nhrc-net/NHRC_Repeater_Controllers/MASTR II/base station card/images/card-accessories.jpg

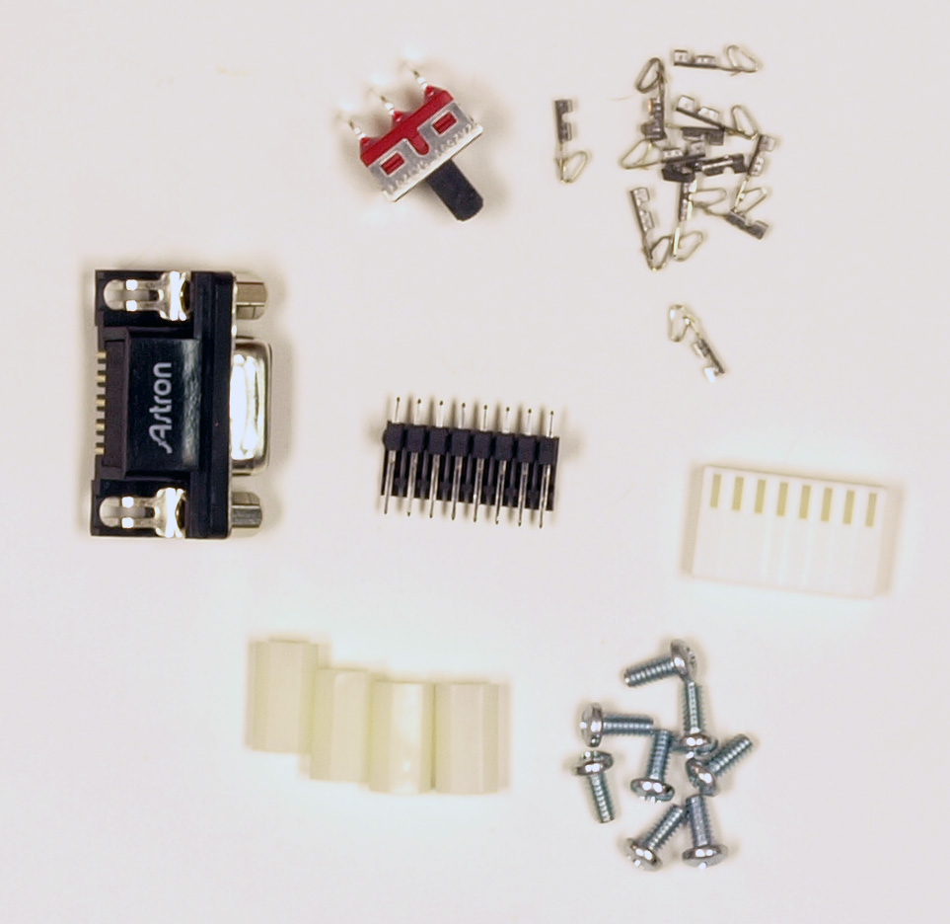
MASTR II/base station card/images/card-accessories.jpg
