nhrc-net/NHRC_Repeater_Controllers/nhrc-remote-plus/docs/pix/P7181789.JPG

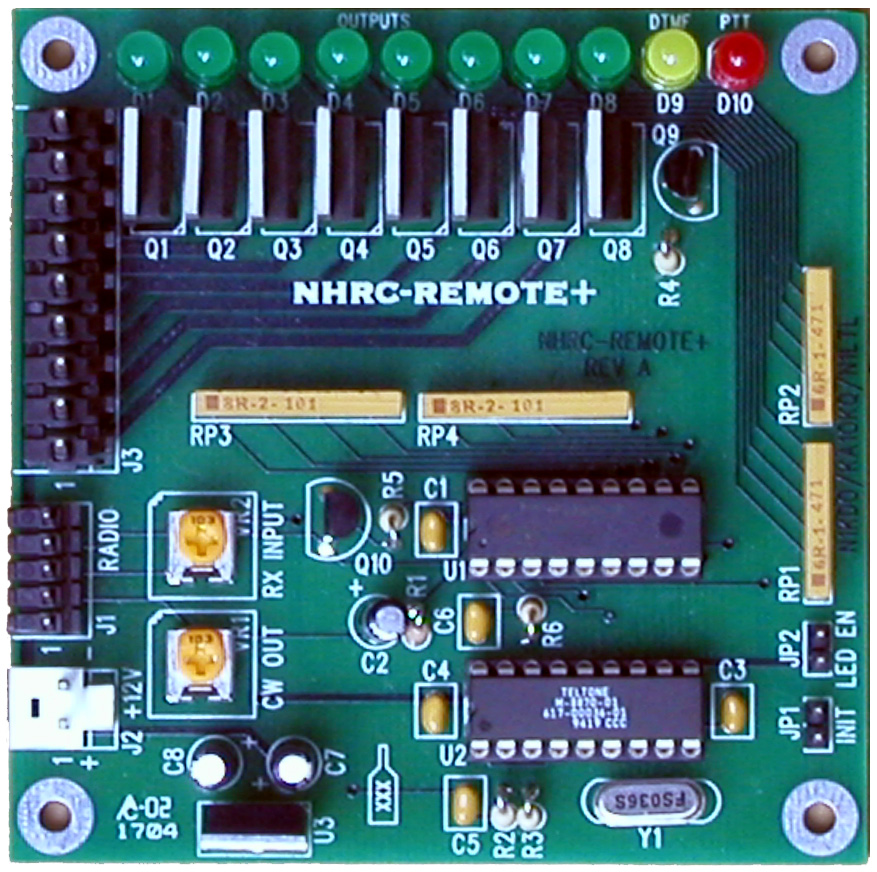
nhrc-remote-plus/docs/pix/P7181789.JPG
