nhrc-net/NHRC_Repeater_Controllers/0_copyright.md

# Copyright

Everything here is Copyright 2022 by NHRC LLC, Jeffrey Otterson, and 
Peter Gailunas.

All rights are reserved.  This material may not be used for any 
commercial purpose.
