nhrc-net/NHRC_Repeater_Controllers/MASTR II/base station card/images/card-bare.jpg

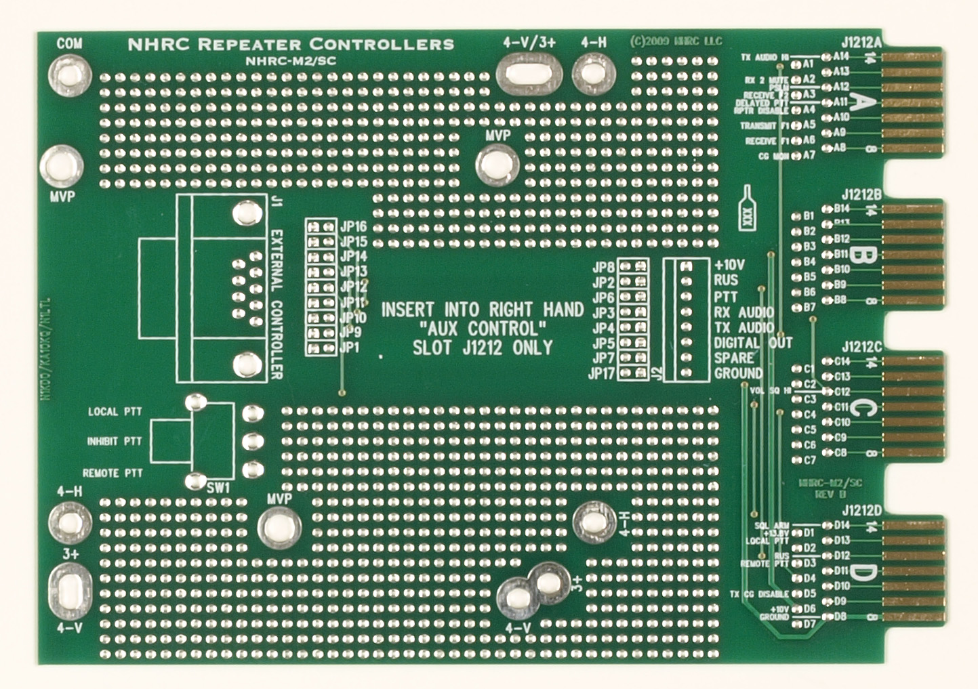
MASTR II/base station card/images/card-bare.jpg
