nhrc-net/NHRC_Repeater_Controllers/MASTR II/base station card/images/card-external-jack.jpg

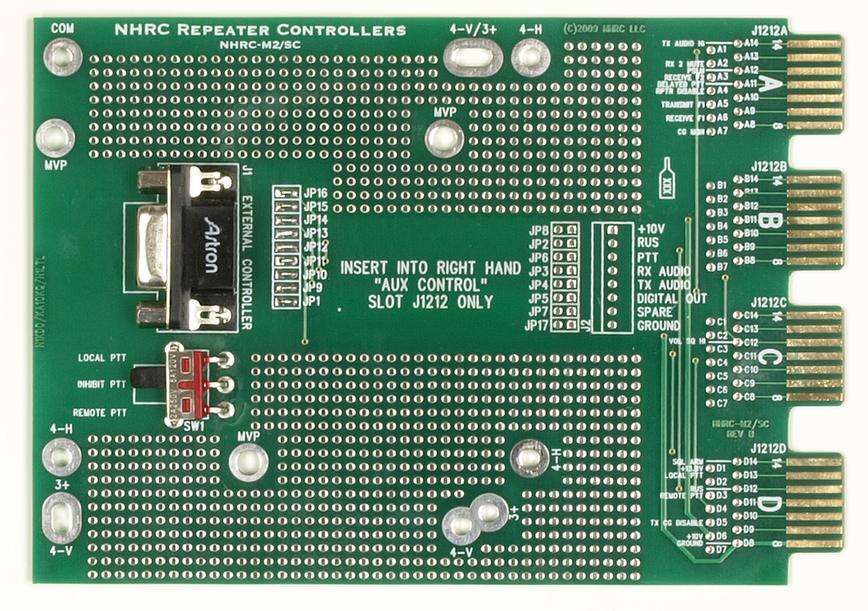
MASTR II/base station card/images/card-external-jack.jpg
