nhrc-net/NHRC_Repeater_Controllers/MASTR II/base station card/images/card-with-4mvp.jpg

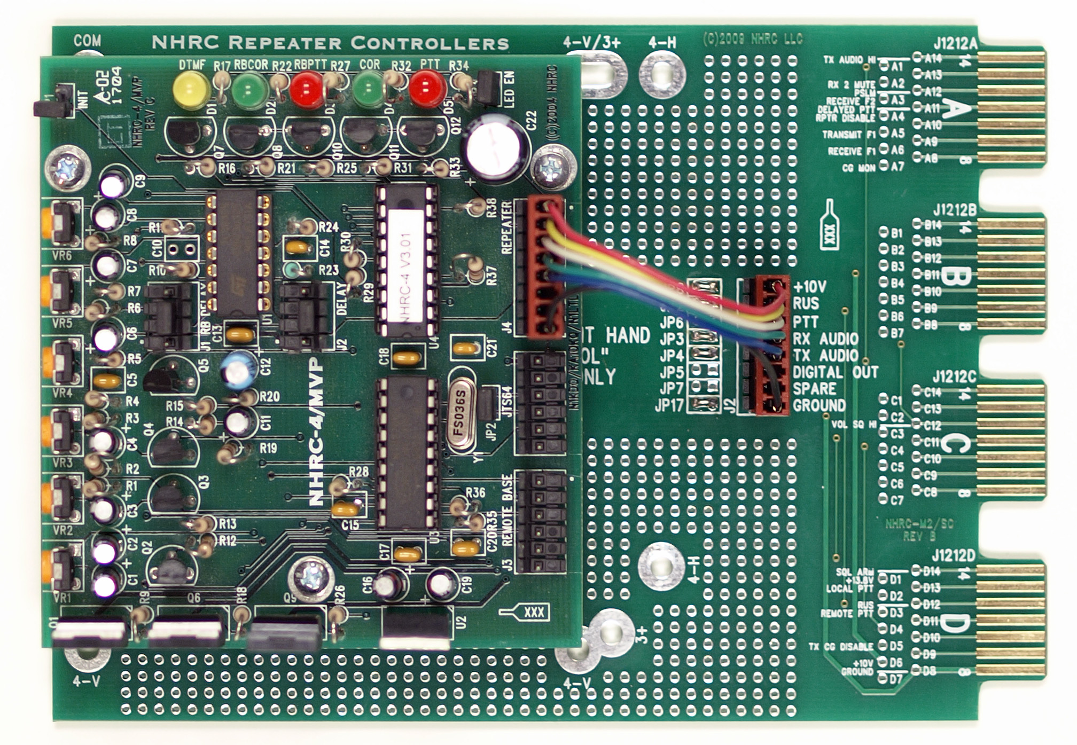
MASTR II/base station card/images/card-with-4mvp.jpg
