nhrc-net/NHRC_Repeater_Controllers/nhrc-3.1/docs/NHRC3.1.gif

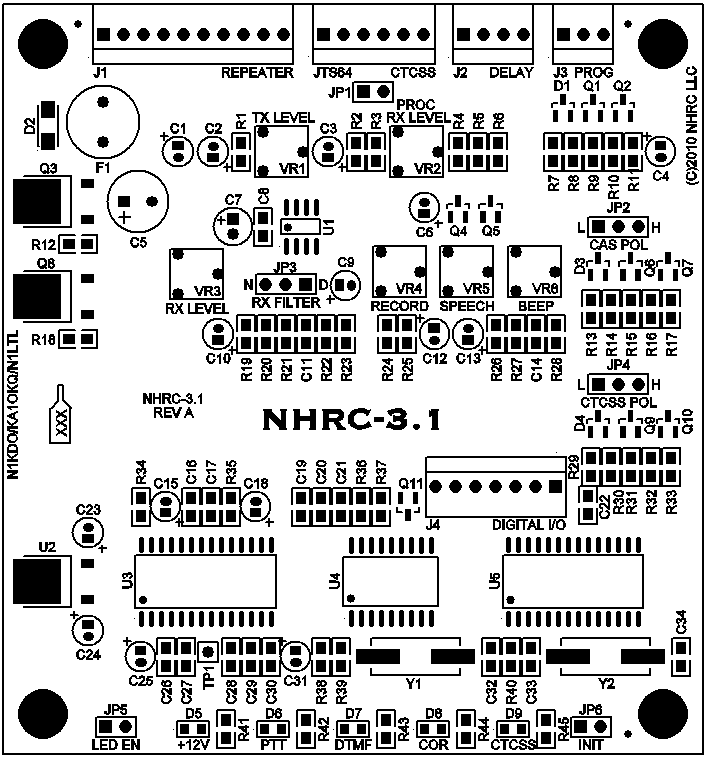
nhrc-3.1/docs/NHRC3.1.gif
