nhrc-net/NHRC_Repeater_Controllers/nhrc-3/doc/M3scrn.gif

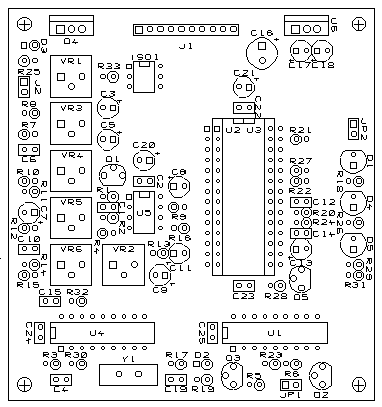
nhrc-3/doc/M3scrn.gif
