nhrc-net/NHRC_Repeater_Controllers/nhrc-4/docs/m4scrn.gif

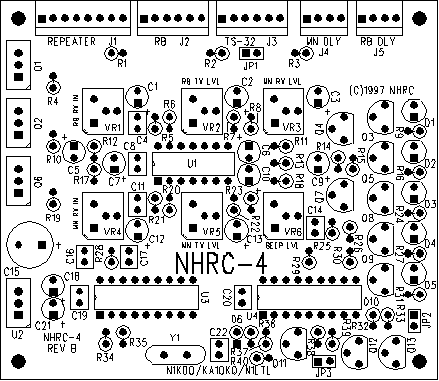
nhrc-4/docs/m4scrn.gif
