nhrc-net/NHRC_Repeater_Controllers/nhrc-4/docs/nhrc4.gif

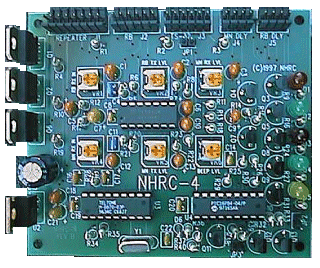
nhrc-4/docs/nhrc4.gif
