nhrc-net/NHRC_Repeater_Controllers/nhrc-remote/docs/remote-75.JPG

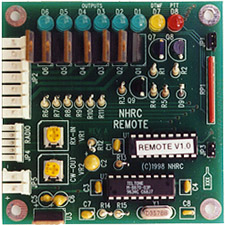
nhrc-remote/docs/remote-75.JPG
