nhrc-net/NHRC_Repeater_Controllers/web/i14y-diagram.gif

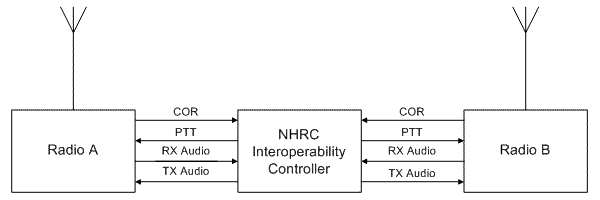
web/i14y-diagram.gif
