nhrc-net/NHRC_Repeater_Controllers/web/mastr2/m2-rx-uhf.gif

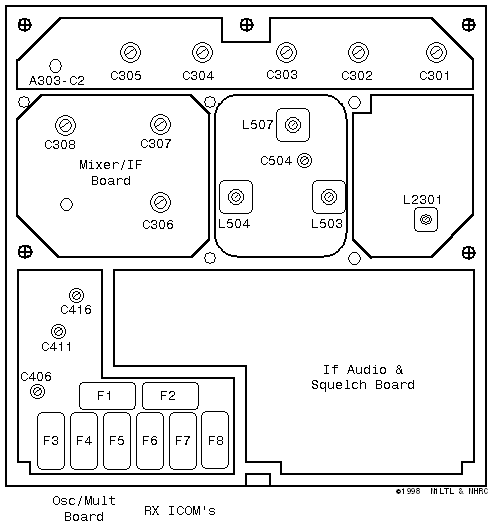
web/mastr2/m2-rx-uhf.gif
