nhrc-net/NHRC_Repeater_Controllers/web/mastr2/m2-tx-lo.gif

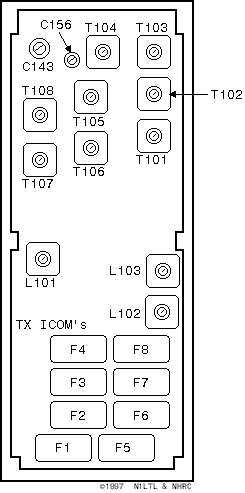
web/mastr2/m2-tx-lo.gif
