nhrc-net/NHRC_Repeater_Controllers/web/mastr2/m2-tx-vhf.gif

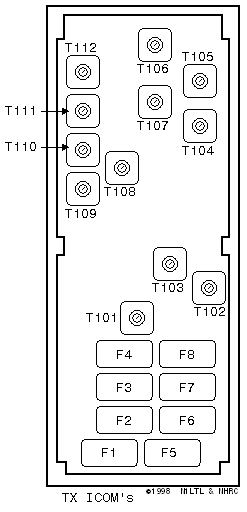
web/mastr2/m2-tx-vhf.gif
