nhrc-net/NHRC_Repeater_Controllers/web/mastr2/mastr2-painted.jpg

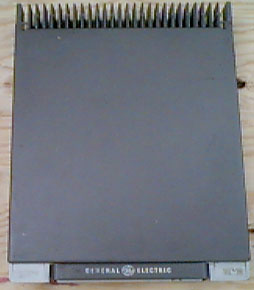
web/mastr2/mastr2-painted.jpg
