nhrc-net/NHRC_Repeater_Controllers/web/mastr2/mastr-front.gif

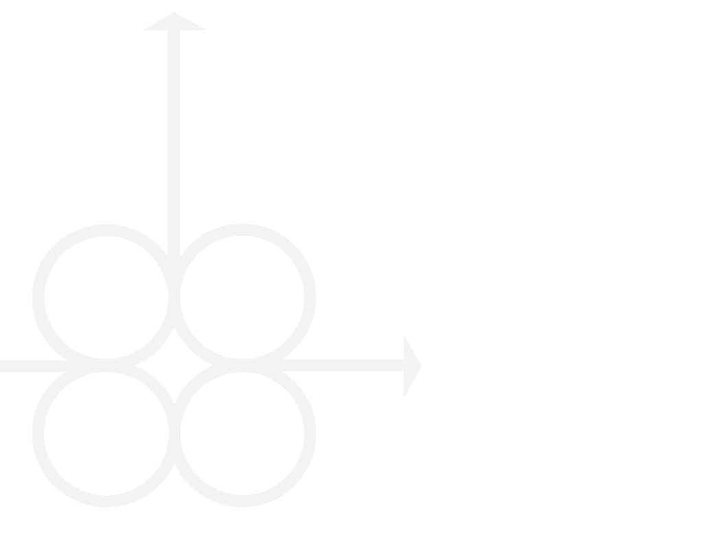
web/mastr2/mastr-front.gif
