nhrc-net/NHRC_Repeater_Controllers/web/nhrc-2.1/nhrc-2.1-small.jpg

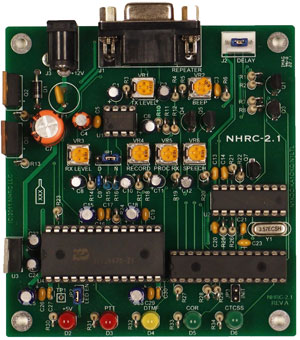
web/nhrc-2.1/nhrc-2.1-small.jpg
