nhrc-net/NHRC_Repeater_Controllers/web/nhrc-2.1/photo.jpg

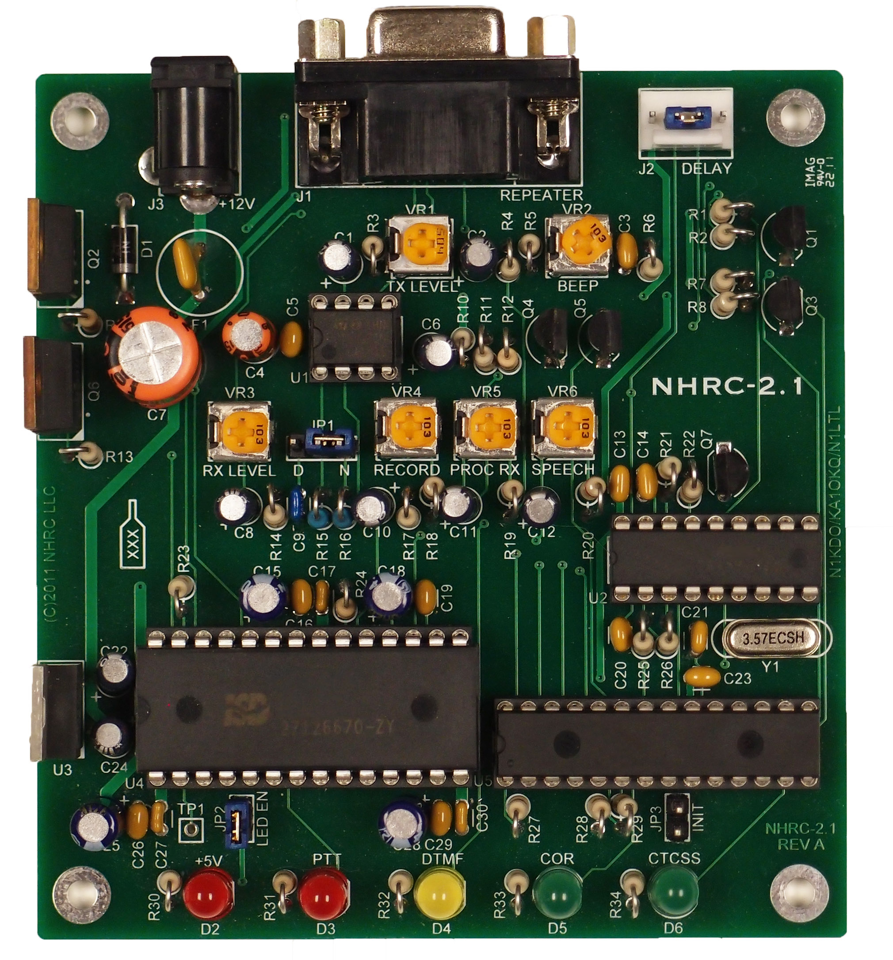
web/nhrc-2.1/photo.jpg
