nhrc-net/NHRC_Repeater_Controllers/web/nhrc-2/nhrc-2d-small.jpg

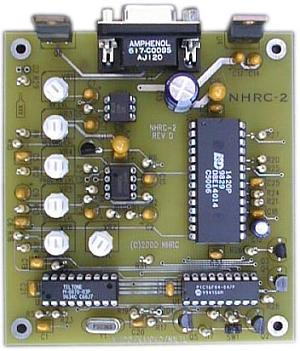
web/nhrc-2/nhrc-2d-small.jpg
