nhrc-net/NHRC_Repeater_Controllers/web/nhrc-2/nhrc-2d_320.jpg

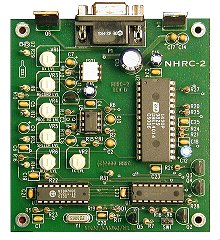
web/nhrc-2/nhrc-2d_320.jpg
