nhrc-net/NHRC_Repeater_Controllers/web/nhrc-3.1/nhrc-3.1-small.jpg

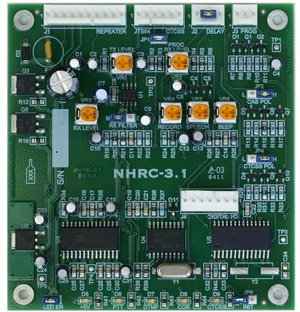
web/nhrc-3.1/nhrc-3.1-small.jpg
