nhrc-net/NHRC_Repeater_Controllers/web/nhrc-3/M3scrn.gif

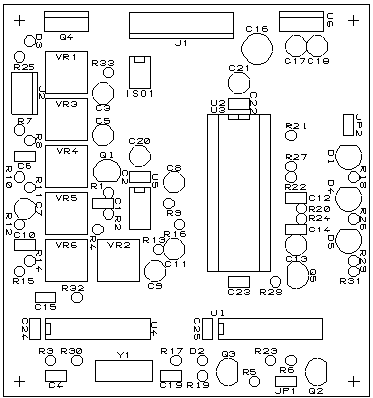
web/nhrc-3/M3scrn.gif
