nhrc-net/NHRC_Repeater_Controllers/web/nhrc-3/nhrc-3-small.jpg

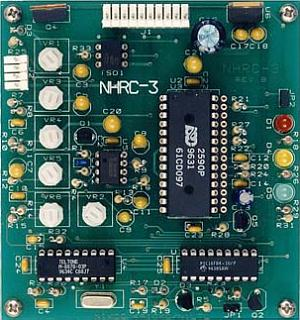
web/nhrc-3/nhrc-3-small.jpg
