nhrc-net/NHRC_Repeater_Controllers/web/nhrc-3m2/3m2-scrn.gif

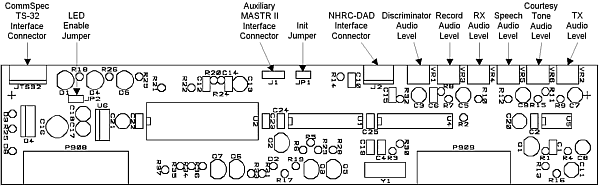
web/nhrc-3m2/3m2-scrn.gif
