nhrc-net/NHRC_Repeater_Controllers/web/nhrc-3m2/mastr-3m2.jpg

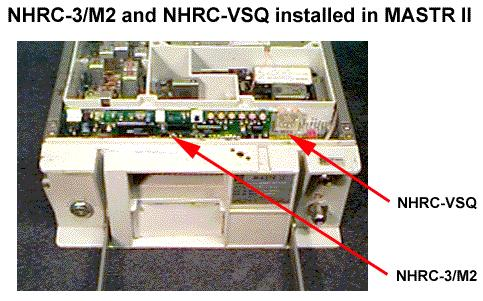
web/nhrc-3m2/mastr-3m2.jpg
