nhrc-net/NHRC_Repeater_Controllers/web/nhrc-3m2plus/nhrc-3m2-plus.jpg

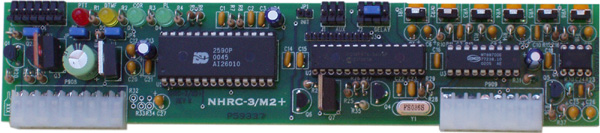
web/nhrc-3m2plus/nhrc-3m2-plus.jpg
