nhrc-net/NHRC_Repeater_Controllers/web/nhrc-3plus/nhrc-3plus-small.jpg

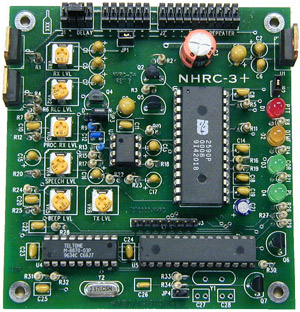
web/nhrc-3plus/nhrc-3plus-small.jpg
