nhrc-net/NHRC_Repeater_Controllers/web/nhrc-4/nhrc-4-small.jpg

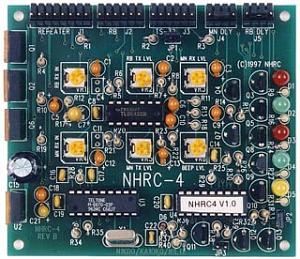
web/nhrc-4/nhrc-4-small.jpg
