nhrc-net/NHRC_Repeater_Controllers/web/nhrc-4m2/4m2-scrn_revb.gif

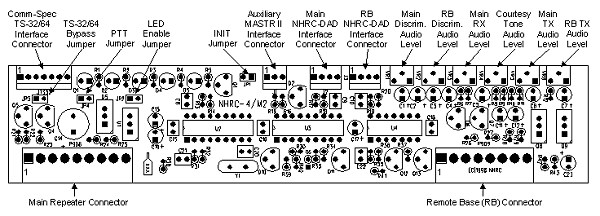
web/nhrc-4m2/4m2-scrn_revb.gif
