nhrc-net/NHRC_Repeater_Controllers/web/nhrc-4m2/nhrc-4m2.jpg

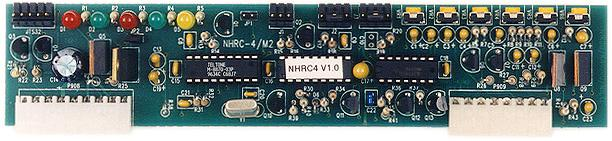
web/nhrc-4m2/nhrc-4m2.jpg
