nhrc-net/NHRC_Repeater_Controllers/web/nhrc-4mvp/nhrc-4mvp-in-radio.jpg

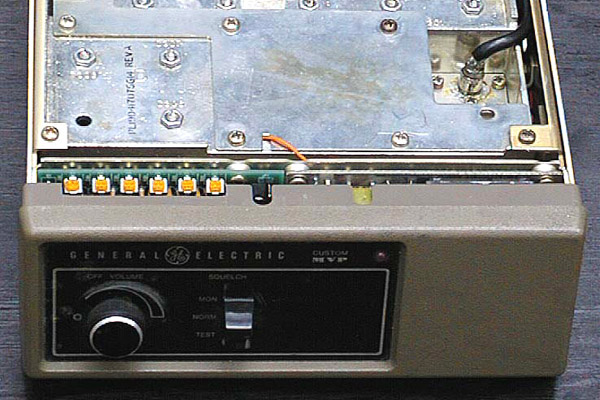
web/nhrc-4mvp/nhrc-4mvp-in-radio.jpg
