nhrc-net/NHRC_Repeater_Controllers/web/nhrc-4mvp/nhrc-4mvp-small.jpg

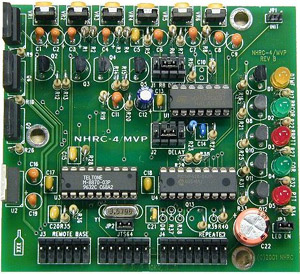
web/nhrc-4mvp/nhrc-4mvp-small.jpg
