nhrc-net/NHRC_Repeater_Controllers/web/nhrc-5/nhrc-5-small.jpg

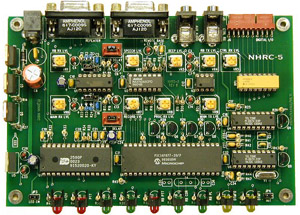
web/nhrc-5/nhrc-5-small.jpg
