nhrc-net/NHRC_Repeater_Controllers/web/nhrc-6/nhrc-6-small.jpg

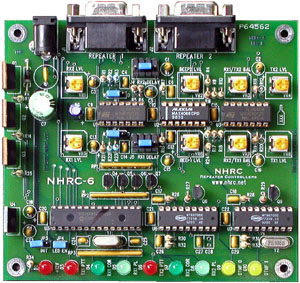
web/nhrc-6/nhrc-6-small.jpg
