nhrc-net/NHRC_Repeater_Controllers/web/nhrc-7/nhrc-7-small.jpg

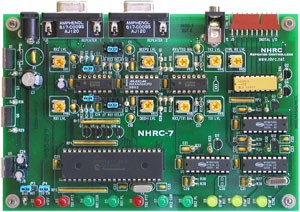
web/nhrc-7/nhrc-7-small.jpg
