nhrc-net/NHRC_Repeater_Controllers/web/nhrc-10/nhrc-10-cab-r.jpg

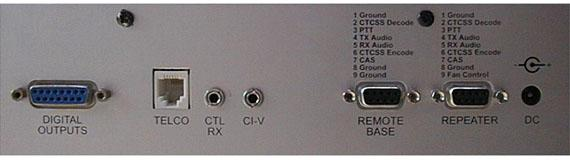
web/nhrc-10/nhrc-10-cab-r.jpg
