nhrc-net/NHRC_Repeater_Controllers/web/nhrc-10/nhrc-10-revc-small.jpg

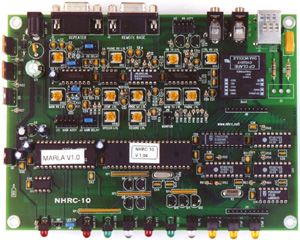
web/nhrc-10/nhrc-10-revc-small.jpg
