nhrc-net/NHRC_Repeater_Controllers/web/nhrc-10/programmer/controlop.jpg

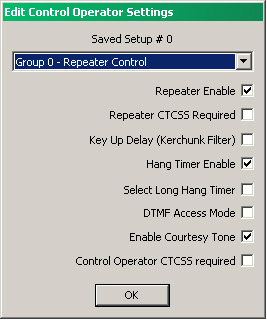
web/nhrc-10/programmer/controlop.jpg
