nhrc-net/NHRC_Repeater_Controllers/web/nhrc-10/programmer/patch-exchanges.jpg

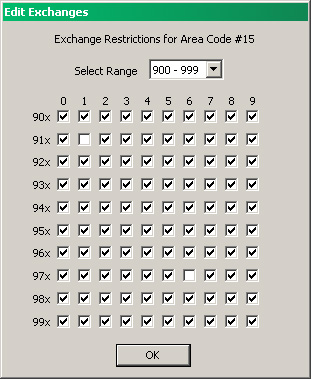
web/nhrc-10/programmer/patch-exchanges.jpg
