nhrc-net/NHRC_Repeater_Controllers/web/nhrc-dad-2/nhrc-dad-2_320.jpg

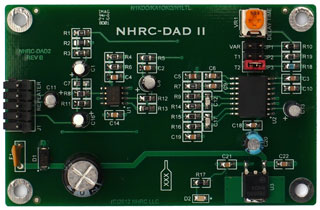
web/nhrc-dad-2/nhrc-dad-2_320.jpg
