nhrc-net/NHRC_Repeater_Controllers/web/nhrc-dad/nhrc-dad.jpg

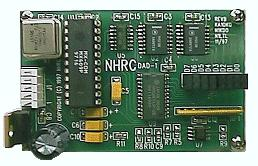
web/nhrc-dad/nhrc-dad.jpg
