nhrc-net/NHRC_Repeater_Controllers/web/nhrc-dad/nhrc-dad_320.jpg

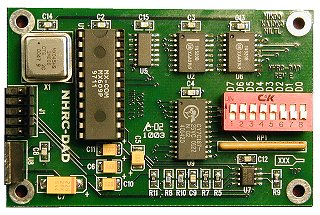
web/nhrc-dad/nhrc-dad_320.jpg
