nhrc-net/NHRC_Repeater_Controllers/web/nhrc-m2sc/card-accessories-small.jpg

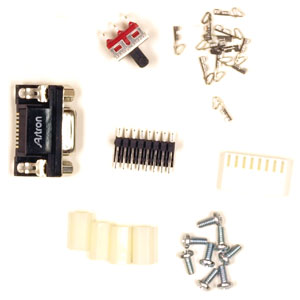
web/nhrc-m2sc/card-accessories-small.jpg
