nhrc-net/NHRC_Repeater_Controllers/web/nhrc-m2sc/card-bare-small.jpg

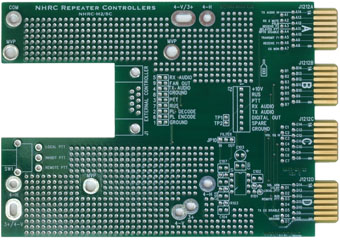
web/nhrc-m2sc/card-bare-small.jpg
