nhrc-net/NHRC_Repeater_Controllers/web/nhrc-m2sc/card-bare.jpg

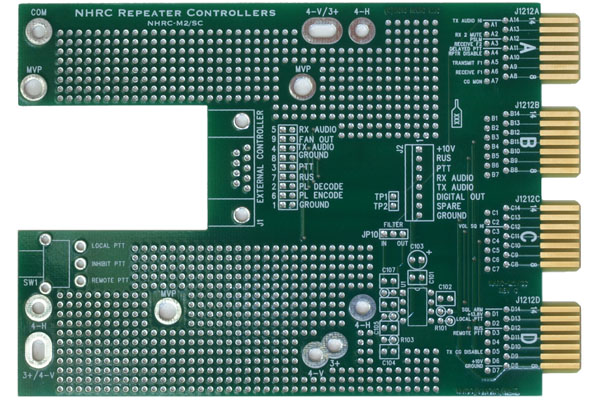
web/nhrc-m2sc/card-bare.jpg
