nhrc-net/NHRC_Repeater_Controllers/web/nhrc-m2sc/card-external-jack-small.jpg

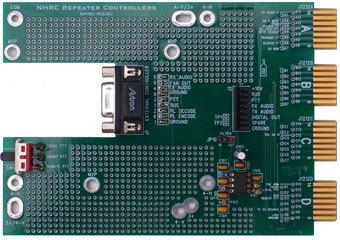
web/nhrc-m2sc/card-external-jack-small.jpg
