nhrc-net/NHRC_Repeater_Controllers/web/nhrc-m2sc/card-with-4mvp-small.jpg

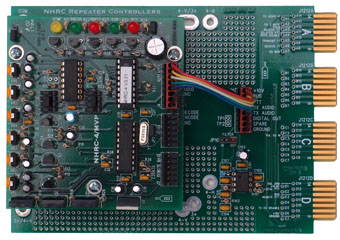
web/nhrc-m2sc/card-with-4mvp-small.jpg
