nhrc-net/NHRC_Repeater_Controllers/web/nhrc-micro/edit-control-operator.gif

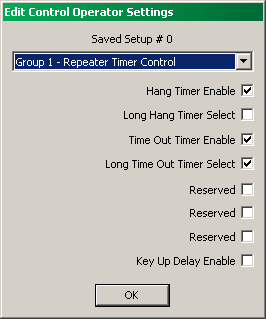
web/nhrc-micro/edit-control-operator.gif
