nhrc-net/NHRC_Repeater_Controllers/web/nhrc-micro/edit-prefixes.gif

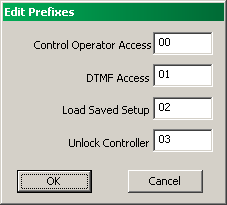
web/nhrc-micro/edit-prefixes.gif
