nhrc-net/NHRC_Repeater_Controllers/web/nhrc-micro/edit-timers.gif

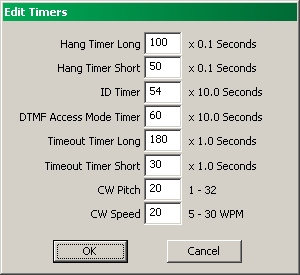
web/nhrc-micro/edit-timers.gif
