nhrc-net/NHRC_Repeater_Controllers/web/nhrc-micro/nhrc-micro-small.jpg

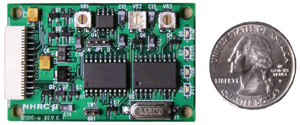
web/nhrc-micro/nhrc-micro-small.jpg
