nhrc-net/NHRC_Repeater_Controllers/web/nhrc-pxp/nhrc-pxp-small.jpg

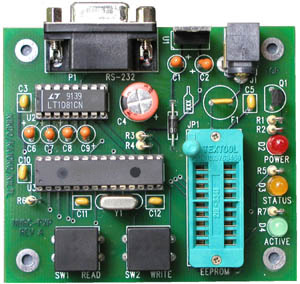
web/nhrc-pxp/nhrc-pxp-small.jpg
