nhrc-net/NHRC_Repeater_Controllers/web/nhrc-pxp/PhoenixScan.gif

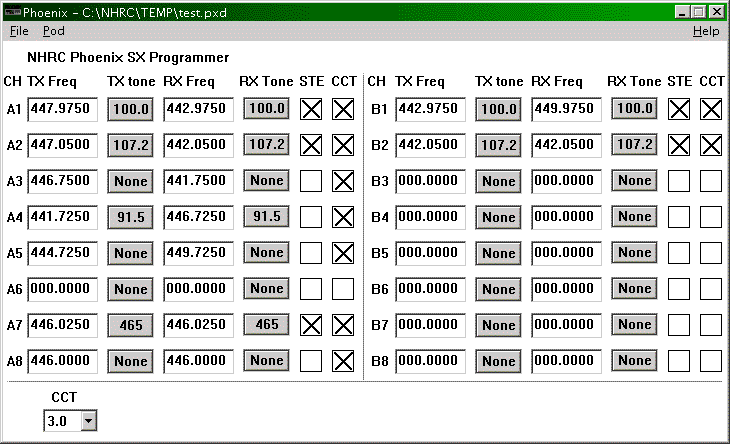
web/nhrc-pxp/PhoenixScan.gif
