nhrc-net/NHRC_Repeater_Controllers/web/nhrc-squelch/nhrc-squelch.jpg

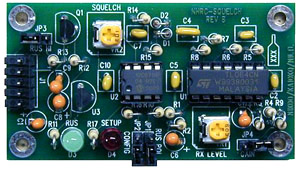
web/nhrc-squelch/nhrc-squelch.jpg
