nhrc-net/NHRC_Repeater_Controllers/web/nhrc-vox/nhrc-vox-small.jpg

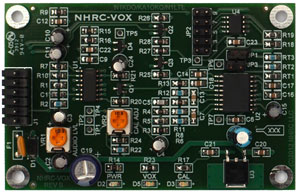
web/nhrc-vox/nhrc-vox-small.jpg
