nhrc-net/NHRC_Repeater_Controllers/web/resources/flag.gif

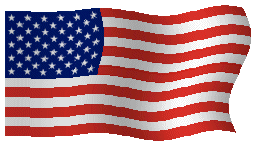
web/resources/flag.gif
