nhrc-net/NHRC_Repeater_Controllers/web/resources/hosstraders-may98-2.jpg

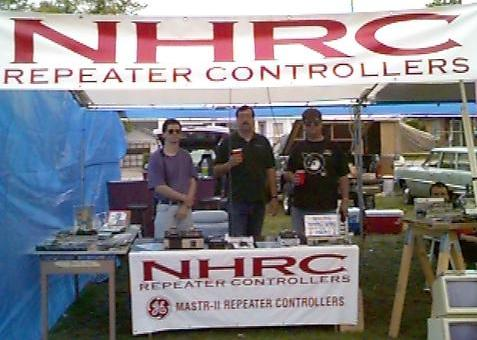
web/resources/hosstraders-may98-2.jpg
