nhrc-net/NHRC_Repeater_Controllers/web/resources/movingflags.gif

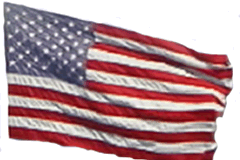
web/resources/movingflags.gif
