nhrc-net/NHRC_Repeater_Controllers/nhrc-7/docs/nhrc7-bom-reva 20030312.xls

NHRC-7 Repeater Controller |  |  |  |  |  |  |  | NHRC Repeater Controllers
Bill Of Materials |  |  |  |  |  |  |  | 415 Fourth Range Road
Revised: Wednesday, March 12, 2003 |  |  |  |  |  |  |  | Pembroke, NH 03275
Revision: A |  |  |  |  |  |  |  | 603-485-2248
Item | Qty | Ref | Schematic Value | Description | Mfg. | Mfg. P/N | Digi-Key P/N | Notes
1 | 9 | C1,C2,C3,C5,C13,C16,C17, | 1uF | 1uF 16V Tantalum Cap | Panasonic | ECS-F1CE105K | P2105-ND
 |  | C24,C28
2 | 2 | C14,C4 | 0.0068uF | 0.0068uF 50V X7R Ceramic Radial Cap | Panasonic | ECU-S1H682KBA | P4951-ND
3 | 15 | C6,C9,C10,C11,C12,C15, | 0.1uF | 0.1uF 50V Z5U Ceramic Radial Cap | Panasonic | ECU-S1H104MEA | P4924-ND
 |  | C18,C19,C21,C22,C25,C26,
 |  | C27,C29,C31
4 | 1 | C7 | 220uF | 220uF 25V Aluminum Radial Electrolytic Cap | Panasonic | ECA-1EM221 | P5153-ND
5 | 1 | C8 | 22uF | 22uF 25V Aluminum Radial Electrolytic Cap | Panasonic | ECA-1EM220 | P5149-ND
6 | 3 | C23,C20,C30 | 33pF | 33pF 100V C0G Ceramic Radial Cap | Panasonic | ECU-S2A330JCA | P4843-ND | C30 DNP
7 | 2 | C32,C33 | 22pF | 22pF 100V C0G Ceramic Radial Cap | Panasonic | ECU-S2A220JCA | P4841-ND
8 | 1 | D1 | 1N4002 | 1A 100V Silicon Rectifier | Diodes Inc | 1N4002 | 1N4002DICT-ND
9 | 3 | D2,D3,D6 | LED RED | Red T1¾ LED | Lite-On | LTL-4203 | 160-1124-ND
10 | 4 | D4,D5,D7,D8 | LED GRN | Green T1¾ LED | Lite-On | LTL-4233 | 160-1130-ND
11 | 3 | D9,D10,D11 | LED YEL | Yellow T1¾ LED | Lite-On | LTL-4253 | 160-1133-ND
12 | 1 | F1 | 1/2 A | 1.1A Polyswitch | Raychem | RUE110 | RUE110-ND
13 | 2 | JP1,JP2 | 2 WAY JUMPER | 3 Circuit Header, .100" Straight | Molex | 22-03-2031 | WM4001-ND
14 | 2 | JP4,JP3 | JUMPER | 2 Circuit Header, .100" Straight | Molex | 22-03-2021 | WM4000-ND
15 | 2 | J2,J1 | CONNECTOR DB9F | DB9F Right Angle Connector 0.318" PCB mount | NorComp | 182-009-212-531 | 182-09F-ND
16 | 1 | J3 | POWER JACK | Coaxial Power Jack, Right Angle PCB mount | Switchcraft | RAPC712 | SC1152-ND
17 | 1 | J4 | 3.5mm JACK | 3.5mm 2 Circuit Right Angle Jack, PCB mt. | Cui-Stack | MJ-3536 | CP-3536-ND
18 | 1 | J5 | HEADER 10 | 10 Circuit Header, .100" Right Angle w/ lock | Molex | 22-05-3101 | WM4308-ND
19 | 2 | J6,J7 | HEADER 4 | 4 Circuit Header, .100" Straight w/ lock | Molex | 22-23-2041 | WM4202-ND
20 | 3 | Q1,Q3,Q6 | IRF510 | N Channel HEXFET | IRF | IRF510 | IRF510-ND
21 | 6 | Q2,Q4,Q7,Q8,Q9,Q10 | 2N3904 | NPN Transistor | Fairchild | 2N3904 | 2N3904-ND
22 | 3 | Q5,Q11,Q12 | 2N7000 | N Channel MOSFET | Fairchild | 2N7000 | 2N7000FS-ND
23 | 1 | RP1 | 4.7K | 4.7K x 8 Isolated Resistor Pack | Bourns | 4116R-001-472 | 4116R-1-472-ND
24 | 1 | RP2 | 47K | 47K x 4 Bussed Resistor Pack | Bourns | 4605X-101-473 | N/A
25 | 1 | RP3 | 10K | 10K x 4 Isolated Resistor Pack | Bourns | 4608X-102-103 | 4608X-2-103-ND
26 | 1 | RP4 | 10K | 10K x 8 Bussed Resistor Pack | Bourns | 4609X-101-103 | N/A
27 | 1 | RP5 | 470 | 470 x 9 Bussed Resistor Pack | Bourns | 4610X-101-471 | 4610X-1-471-ND
28 | 6 | R1,R9,R10,R18,R20,R28 | 22K | 22K ¼W 5% Carbon Film Resistor | Yageo | CFR-25JB 22K | 22KQBK-ND
29 | 11 | R2,R5,R6,R8,R14,R15,R19, | 10K | 10K ¼W 5% Carbon Film Resistor | Yageo | CFR-25JB 10K | 10KQBK-ND
 |  | R23,R27,R33,R35
30 | 2 | R24,R3 | 11.3K | 11.3K ¼W 1% Metal Film Resistor | Yageo | MFR-25FBF 11K3 | 11.3KXBK-ND
31 | 2 | R4,R25 | 93.1K | 93.1K ¼W 1% Metal Film Resistor | Yageo | MFR-25FBF 93K1 | 93.1KXBK-ND
32 | 7 | R7,R17,R30,R36,R37,R38, | 100K | 100K ¼W 5% Carbon Film Resistor | Yageo | CFR-25JB 100K | 100KQBK-ND
 |  | R39
33 | 3 | R11,R21,R31 | 33K | 33K ¼W 5% Carbon Film Resistor | Yageo | CFR-25JB 33K | 33KQBK-ND
34 | 2 | R12,R22 | 0 | Zero Ohm ¼W Jumper | Yageo | ZOR-25-B | 10KQBK-ND
35 | 3 | R13,R16,R29 | 100 | 100 ¼W 5% Carbon Film Resistor | Yageo | CFR-25JB 100R | 100QBK-ND
36 | 3 | R26,R32,R34 | 470K | 470K ¼W 5% Carbon Film Resistor | Yageo | CFR-25JB 470K | 470KQBK-ND
37 | 1 | R40 | 1.2K | 1.2K ¼W 5% Carbon Film Resistor | Yageo | CFR-25JB 1K2 | 1.2KQBK-ND
38 | 2 | U1,U3 | TL064 | Quad JFET Input Op-Amp | TI | TL064CN | 296-1773-5-ND
39 | 1 | U2 | MAX4066 | Quad SPST Analog Switch | Maxim | MAX4066CPD | MAX4066CPD-ND
40 | 3 | U4,U6,U7 | M-8870-01 | DTMF Decoder | Zarlink | MT8870DE | N/A
41 | 1 | U5 | LM7805CT | 5V 1.0A Voltage Regulator | Nat'l Semi | LM340T-5.0 | LM340T-5.0-ND
42 | 1 | U8 | PIC16F877-20/P | Microcontroller w/ 8K Flash Memory | Microchip | PIC16F877-20/P | PIC16F877-20/P-ND
43 | 5 | VR1,VR2,VR5,VR6,VR7 | 10K POT | 10K 6mm Carbon Trimpot | Panasonic | EVN-D8AA03B14 | D4AA14-ND
44 | 2 | VR8,VR3 | 20K POT | 20K 6mm Carbon Trimpot | Panasonic | EVN-D8AA03B24 | D4AA24-ND
45 | 2 | VR9,VR4 | 200K POT | 200K 6mm Carbon Trimpot | Panasonic | EVN-D8AA03B25 | D4AA25-ND
46 | 1 | Y1 | 3.579MHz | 3.579545MHz Crystal | ECS | ECS-35-17-4 | X079-ND
47 | 1 | Y2 | 16MHz | 16MHz Crystal | ECS | ECS-160-20-4 | X176-ND
Additional Items
48 | 1 |  |  | NHRC-7 PCB | NHRC | NHRC-7 PCB rev A | N/A
49 | 1 |  |  | 40 Pin DIP Socket | Mill-Max | 110-99-640-41-001 | ED3740-ND
50 | 3 |  |  | 18 Pin DIP Socket | Mill-Max | 110-99-318-41-001 | ED3118-ND
51 | 3 |  |  | 14 Pin DIP Socket | Mill-Max | 110-99-314-41-001 | ED3114-ND
52 | 2 |  |  | 4 Circuit Housing, .100" w/ lock and polarizer | Molex | 22-01-3047 | WM2002-ND
53 | 1 |  |  | 10 Circuit Housing, .100" w/ lock and polarizer | Molex | 22-01-3107 | WM2008-ND
54 | 18 |  |  | Crimp Terminal for Molex Housing | Molex | 08-50-0114 | WM2200-ND
55 | 6 |  |  | Shorting Jumpers | 3M | 929950-00-I | 929950-00-ND
