nhrc-net/NHRC_Repeater_Controllers/MASTR II/base station card/docs/nhrc-MASTR-II BASE CARD BOM.xlsx

qty | description | cost ea | digikey | mouser | mfg | extended
1 | printed circuit board | 5.00 |  |  | nhrc | 5.00
4 | .375 hex 440 standoff | 0.64 | 8440BK-ND |  | keystone | 3.20
8 | 4-40 pan head screws | 0.03 | H142-ND |  |  | 0.24
1 | Slide Switches ON-OFF-ON SPDT | 3.04 |  | 103-5011-EV (https://www.mouser.com/Search/ProductDetail.aspx) | mountain switch | 3.04
1 | 318 setback female d sub | 1.00 |  |  | nhrc-stock | 1.00
1 | 10 pin header | 0.25 |  | 22-28-0310 | molex | 0.25
1 | 10 pin shell molex kk | 0.39 |  | 22-01-2107 | molex | 0.39
12 | molex kk pin insert | 0.05 |  | 08-50-0114 | molex | 0.60
1 | printed documents | 0.25 |  |  | nhrc | 0.25
 |  |  |  |  |  | 13.97
