nhrc-net/NHRC_Repeater_Controllers/nhrc-7/docs/manual/NHRC7-BOM-REVC 20060406.xls

Item | Qty | Reference | Part | Description | Populate | Manufacturer | Manufacturer P/N | Digi-Key P/N
1 | 9 | C1,C2,C3,C5,C13,C16,C17, | 1uF | 1uF 50V Aluminum Electrolytic Capacitor | YES | Panasonic | ECE-A1HKG010 | P931-ND
 |  | C24,C28
2 | 2 | C14,C4 | 6800pF | 6800pF 100V X7R Ceramic Radial Cap | YES | Kemet | C320C682K1R5CA | 399-2041-ND
3 | 15 | C6,C9,C10,C11,C12,C15, | 0.1uF | 0.1uF 50V Z5U Ceramic Radial Cap | YES | Kemet | C320C104M5U5CA | 399-2155-ND
 |  | C18,C19,C21,C22,C25,C26,
 |  | C27,C29,C31
4 | 1 | C7 | 220uF | 220uF 25V Aluminum Electrolytic Capacitor | YES | Panasonic | ECA-1EM221 | P5153-ND
5 | 1 | C8 | 22uF | 22uF 25V Aluminum Electrolytic Capacitor | YES | Panasonic | ECA-1EM220 | P5149-ND
6 | 3 | C20,C23,C30 | 33pF | 33pF 200V C0G Ceramic Radial Capacitor | YES | Kemet | C315C330J2G5CA | 399-1892-ND
7 | 2 | C32,C33 | 22pF | 22pF 200V C0G Ceramic Radial Capacitor | YES | Kemet | C315C220J2G5CA | 399-1890-ND
8 | 1 | D1 | 1N4002 | 100V 1A GP Diode | YES | Diodes Inc. | 1N4002 | 1N4002DICT-ND
9 | 3 | D2,D3,D6 | LED RED | Red T1¾ LED | YES | Lite-On | LTL-4223 | 160-1127-ND
10 | 4 | D4,D5,D7,D8 | LED GRN | Green T1¾ LED | YES | Lite-On | LTL-4233 | 160-1130-ND
11 | 3 | D9,D10,D11 | LED YEL | Yellow T1¾ LED | YES | Lite-On | LTL-4253 | 160-1133-ND
12 | 2 | D12,D13 | 1N4148 | 75V 150mA Switching Diode | YES | Diodes Inc. | 1N4148 | 1N4148DICT-ND
13 | 1 | F1 | 1A | 0.90A PolySwitch | YES | Raychem | RUE090 | RUE090-ND
14 | 4 | JP1,JP2,JP5,JP6 | 2 WAY JUMPER | 0.1" 3 Position Vertical Pin Header | YES | Molex | 22-28-4030 | WM6403-ND
15 | 2 | JP4,JP3 | JUMPER | 0.1" 2 Position Vertical Pin Header | YES | Molex | 22-28-4020 | WM6402-ND
16 | 2 | J2,J1 | CONNECTOR DB9F | DB9 Female Right Angle PCB Mount Connector | YES | NorComp | 182-009-212-531 | 182-09F-ND
17 | 1 | J3 | POWER JACK | 2.5mm ID Coaxial Power Jack | YES | CUI | PJ-002B | CP-002B-ND
18 | 1 | J4 | 3.5mm JACK | 3.5mm Mono Audio Jack | YES | CUI | MJ-3536 | CP-3536-ND
19 | 1 | J5 | HEADER 10 | 0.1" 10 Position Right Angle Header | YES | Molex | 22-05-3101 | WM4308-ND
20 | 2 | J6,J7 | HEADER 4 | 0.1" 4 Position Vertical Header | YES | Molex | 22-23-2041 | WM4202-ND
21 | 3 | Q1,Q3,Q6 | IRF510 | 100V 5.6A N-channel MOSFET | YES | International Rectifier | IRF510 | IRF510-ND
22 | 6 | Q2,Q4,Q7,Q8,Q9,Q10 | 2N3904 | 60V 200mA GP NPN Transistor | YES | Fairchild Semiconductor | 2N3904BU | 2N3904FS-ND
23 | 3 | Q5,Q11,Q12 | 2N7000 | 60V 200mA N-Channel MOSFET | YES | Fairchild Semiconductor | 2N7000 | 2N7000FS-ND
24 | 2 | Q13,Q14 | 2N3906 | -40V -200mA GP PNP Transistor | YES | Fairchild Semiconductor | 2N3906BU | 2N3906FS-ND
25 | 1 | RP1 | 4.7K | 4.7K ohm X 8 Isolated DIP Resistor Pack | YES | Bourns | 4116R-1-472 | 4116R-1-472-ND
26 | 1 | RP2 | 47K | 47K ohm X 5 Bussed SIP Resistor Pack | YES | Bourns | 4606X-101-473 | 4606X-1-473-ND
27 | 1 | RP3 | 10K | 10K ohm X 4 Isolated SIP Resistor Pack | YES | Bourns | 4608X-102-103 | 4608X-2-103-ND
28 | 1 | RP4 | 10K | 10K ohm X 7 Bussed SIP Resistor Pack | YES | Bourns | 4608X-101-103 | 4608X-1-103-ND
29 | 1 | RP5 | 470 | 470 ohm X 9 Bussed SIP Resistor Pack | YES | Bourns | 4610X-101-471 | 4610X-1-471-ND
30 | 6 | R1,R9,R10,R18,R20,R28 | 22K | 22K ohm 1/4W 5% Carbon Film Resistor | YES | Yageo | CFR-25JB-22K | 22KQBK-ND
31 | 13 | R2,R5,R6,R8,R14,R15,R19, | 10K | 10K ohm 1/4W 5% Carbon Film Resistor | YES | Yageo | CFR-25JB-10K | 10KQBK-ND
 |  | R23,R27,R33,R35,R45,R46
32 | 2 | R3,R24 | 11.3K | 11.3K ohm 1/4W 1% Metal Film Resistor | YES | Yageo | MFR-25FBF-11K3 | 11.3KXBK-ND
33 | 2 | R4,R25 | 93.1K | 93.1K ohm 1/4W 1% Metal Film Resistor | YES | Yageo | MFR-25FBF-93K1 | 93.1KXBK-ND
34 | 7 | R7,R17,R30,R36,R37,R38, | 100K | 100K ohm 1/4W 5% Carbon Film Resistor | YES | Yageo | CFR-25JB-100K | 100KQBK-ND
 |  | R39
35 | 3 | R11,R21,R31 | 33K | 33K ohm 1/4W 5% Carbon Film Resistor | YES | Yageo | CFR-25JB-33K | 33KQBK-ND
36 | 2 | R12,R22 | 0 | Zero ohm 1/4W Jumper | YES | Yageo | ZOR-25-B-52 | 0.0QBK-ND
37 | 3 | R13,R16,R29 | 100 | 100 ohm 1/4W 5% Carbon Film Resistor | YES | Yageo | CFR-25JB-100R | 100QBK-ND
38 | 3 | R26,R32,R34 | 470K | 470K ohm 1/4W 5% Carbon Film Resistor | YES | Yageo | CFR-25JB-470K | 470KQBK-ND
39 | 1 | R40 | 1.2K | 1.2K ohm 1/4W 5% Carbon Film Resistor | YES | Yageo | CFR-25JB-1K2 | 1.2KQBK-ND
40 | 2 | R41,R43 | 1K | 1K ohm 1/4W 5% Carbon Film Resistor | YES | Yageo | CFR-25JB-1K0 | 1.0KQBK-ND
41 | 2 | R42,R44 | 3.3K | 3.3K ohm 1/4W 5% Carbon Film Resistor | YES | Yageo | CFR-25JB-3K3 | 3.3KQBK-ND
42 | 2 | U1,U3 | TL064 | Quad JFET Op-Amp | YES | Texas Instruments | TL064CN | 296-1773-5-ND
43 | 1 | U2 | MAX4066 | Quad SPST CMOS Analog Switch | YES | Maxim | MAX4066CPD | MAX4066CPD-ND
44 | 3 | U4,U6,U7 | MT8870DE | DTMF Decoder | YES | Zarlink | MT8870DE
45 | 1 | U5 | LM7805CT | 5V 1A Linear Voltage Regulator | YES | Fairchild Semiconductor | LM7805CT | LM7805CT-ND
46 | 1 | U8 | PIC16F877-20/P | 8K X 14 FLASH Microcontroller | YES | Microchip Technology | PIC16F877-20/P | PIC16F877-20/P-ND
47 | 5 | VR1,VR2,VR5,VR6,VR7 | 10K | 10K 6mm Carbon Trimmer Potentiometer | YES | Panasonic | EVN-D8AA03B14 | D4AA14-ND
48 | 2 | VR8,VR3 | 20K | 20K 6mm Carbon Trimmer Potentiometer | YES | Panasonic | EVN-D8AA03B24 | D4AA24-ND
49 | 2 | VR9,VR4 | 200K | 200K 6mm Carbon Trimmer Potentiometer | YES | Panasonic | EVN-D8AA03B25 | D4AA25-ND
50 | 1 | Y1 | 3.579MHz | 3.579545MHz 17pF HC49/U Crystal | YES | ECS | ECS-35-17-4 | X079-ND
51 | 1 | Y2 | 16MHz | 16.000MHz 20pF HC-49/U Crystal | YES | ECS | ECS-160-20-4 | X176-ND
