nhrc-net/NHRC_Repeater_Controllers/web/nhrc-3.1/nhrc-3.1-manual.pdf

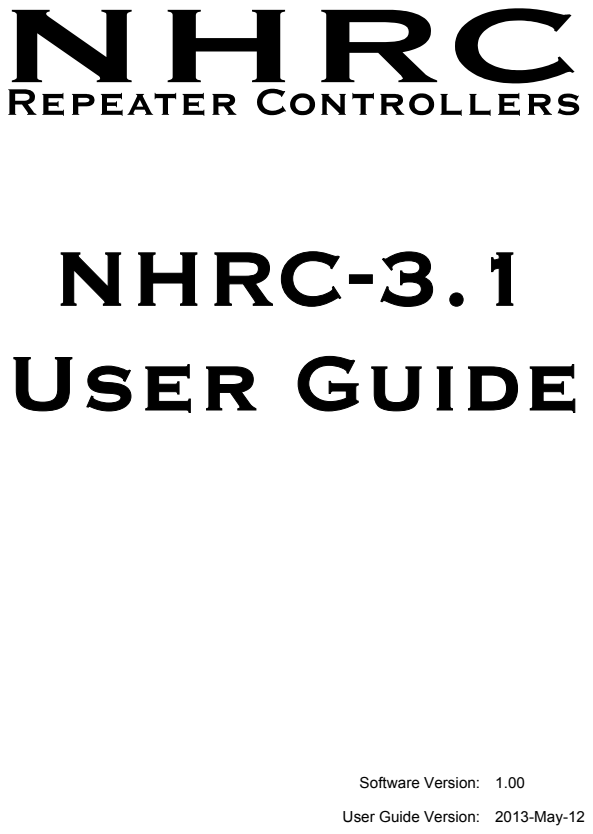
[picture p113: page 1]
NHRC-3.1 User Guide; Software Version: 1.00

User Guide Version: 2013-May-12

# Copyright Notice

Copyright 2011, 2012, 2013 by NHRC LLC

This document contains proprietary information that is the confidential property of NHRC LLC.

No part of this document may be used or reproduced, by any means, for any purpose, without the expressed written consent of NHRC LLC.

No part of this document should be considered to be specifications for the proper or correct operation of the NHRC-3.1 Repeater Controller. In no way will NHRC LLC be liable for direct or indirect damages to the controller or attached equipment.

Printed in the U.S.A.

# Thank You!

Thank you for purchasing the NHRC-3.1 Repeater Controller. This controller has been designed using the very latest state-of-the-art technology. Please review this manual carefully before putting your controller into operation.

This manual represents a very large documentation effort. Your comments are important to us. If you find an error or find any passages that are not clearly understandable, we would like to hear about it. Please send your comments to software@nhrc.net.

Support for the controller is available by email or telephone. Please direct software-related questions via email to software-support@nhrc.net. Please direct hardware-related questions via email to hardware-support@nhrc.net . Your question(s) will be answered promptly.

Questions of a more urgent nature can be answered by telephone support. Telephone support is available Monday through Thursday, from 6 PM until 9:30 PM, Eastern time.

### Table of Contents

Copyright 2011-2013, NHRC LLC. All Rights Reserved. | Page i

Page ii | Copyright 2011-2013, NHRC LLC. All Rights Reserved.

## NHRC-3.1 User Guide

### 1. Introduction

The NHRC-3.1 Repeater Controller represents the current state-of-the-art in repeater controller designs. It utilizes the latest available technology to provide maximum functionality with the lowest number of parts. This results in very reliable operation.
The key features of the NHRC-3.1 are:
- Recording of three real speech ID messages, one real speech time-out message, two real speech tail messages, and an “alarm” message.
- Audio Test mode allows repeater users to hear how they sound through the repeater.
- Local language support using a custom recording capability.
- Simplex repeater mode.
- Unique courtesy tones to indicate status of digital input ports.
- Alarm input can advise of site conditions with dedicated voice message
- 2 digital outputs.
- Transmitter fan control output automatically runs fan while transmitting and for a programmable delay after.
- DTMF, "Carrier,” “Carrier and CTCSS,” and “Carrier or CTCSS” access modes.
- Granular security features that allow tailored control operator access.
Copyright 2011-2013, NHRC LLC. All Rights Reserved. | Page 1

### 1.1 Sending commands

All of the controller’s commands are sent by DTMF (Touch-Tone) sequences that are received on the main repeater. DTMF tones received will be evaluated, and if correct, executed, when either the DTMF inter-digit timer expires (2.0 seconds) or the CAS (receiver unsquelched) signal drops; whichever comes first. This allows the controller to be commanded even when a weak on-channel signal is holding the receiver’s squelch open.
To send a command over the main repeater:
1. Key your transmitter.
2. Enter the DTMF command digits.
3. Unkey the transmitter.
This will cause the command to be evaluated immediately.
If you pause for more than 2.0 seconds while sending a command, the command you entered prior to the pause will be evaluated, the command buffer will be emptied, and you can immediately enter another command.
When a command is successfully evaluated, the controller will send a response. Each command’s possible responses are detailed with the command description.
In general, if you do not receive a command response, then the controller did not accept your command.

### 1.2 ID Messages

The controller supports three voice ID messages and one Morse code ID.
The voice messages are comprised of:
- an “initial” ID message, that plays when the controller has been idle for a period longer than the ID timer, and
- two “normal” ID messages, that plays during repeater use.
Each of the ID messages can be individually enabled or disabled. The Morse code ID will play when a voice ID message is required but disabled. The Morse Code ID will also play if the ID timer expires during a user’s transmission. The controller tries to be “polite”
when identifying; if it is almost time to ID when a user unkeys, the ID is sent immediately. Be sure to either record the voice ID messages or disable them. If the ID messages are not recorded, but left enabled, an empty message will play instead of an ID.
Page 2 | Copyright 2011-2013, NHRC LLC. All Rights Reserved.

1.3 “Unlocked Mode”

All of the controller’s important programming information is protected by a special password, the “unlock code.”
Programming the unlock code requires physical access to the controller to place a jumper on the circuit board.
The unlock code cannot be programmed without physical access to the controller.
When the unlock code is successfully entered into the controller, the controller will transmit “OK” in Morse code, and a special courtesy tone will be used to indicate the controller is unlocked.
The controller can be locked by:
- Sending the “#” command, or
- The controller will lock itself after two minutes of inactivity.
When the controller leaves the unlocked mode:
- The courtesy tone will revert to the normal tone for the controller’s current state.

### 1.4 Simplex Repeater Controller Mode

The NHRC-3.1 supports a “Simplex Repeater Controller” mode for simplex repeaters. In this mode, the controller will record up to 90 seconds of audio from the receiver, and then repeat that audio to the transmitter. The controller normally waits in “listen” mode, and when the receiver becomes active, it records up to 90 seconds of the received audio into the ISD voice storage chip. When the receiver becomes inactive, the controller will then key the transmitter and play the recorded message. (See section 4.2 for information on setting Simplex Repeater Mode.)
The NHRC-3.1 supports a “voice ID” mode when operating as a simplex repeater. When this mode is selected, the controller will play message 0 “ initial ID” (See section 4.2 for information on setting Simplex Repeater Mode.) If the voice ID mode is not selected, the NHRC-3.1 will ID the simplex repeater in Morse code.
⇒ Note: The Tail, Alarm and Test message tracks will be erased upon entering simplex repeat mode. All of the messages will be un affected.
For US Amateur Radio operation, you should read and understand the FCC Part 97 regulations prior to operating a simplex repeater.
Copyright 2011-2013, NHRC LLC. All Rights Reserved. | Page 3

### 2. Electrical Connections

This section of the User Guide describes the electrical interfaces used to connect the controller to:
- Power
- Repeater
- Communications Specialists TS-64 CTCSS Encoder/Decoder
- NHRC-DAD digital audio delay board.
It is intended for the repeater operator to use in the planning and installation of the NHRC-3.1 Repeater Controller into a repeater system.
2.1 Input and Output Signal Levels.

Control signals into the controller are active-high OR active-low signals, depending on the state of jumpers JP2 and JP4. The repeater activity inputs (CAS and CTCSS Decode) are buffered to allow the connection of popular radios to the controller. For active high signals, the levels should be 0.0 to 0.5 volts for off, and 2.0 to 16.0 volts for on. For active low signals, the signal must be 5-16 volts for off, and pulled low 0.0 to 0.5 volts for on. The active low inputs are compatible with open-collector outputs.
Jumper JP2 sets the CAS input to be active high or active low. Install the jumper between the center pin and the pin labeled “H” for active high signaling, or between the center pin and the pin labeled “L” for active low signaling.
Jumper JP4 sets the CTCSS input to be active high or active low. Install the jumper between the center pin and the pin labeled “H” for active high signaling, or between the center pin and the pin labeled “L” for active low signaling.
Expansion port signal levels are TTL compatible and should be buffered by the user’s circuitry. See section 2.5 for more information about using the expansion port signals. The controller’s PTT and FAN CONTROL outputs are “open-drain” connections to power MOSFETs. These outputs are active-low, and when activated, will pull the control signals to within a few ohms of ground. These outputs can sink 100 mA or so. NHRC recommends that diodes be used to protect the MOSFETs from back-EMF if these signals are used to drive relays.
Audio signals into the controller should be in the range of 0.2 to 2.0 volts peak-to-peak. The controller’s transmit audio outputs are adjustable from about 0.1 volt to about 5 volts peak-to-peak. For best results an input level of 1V p-p or greater will yield the best overall audio performance.
Page 4 | Copyright 2011-2013, NHRC LLC. All Rights Reserved.

### 2.2 J2: Controller/Repeater Interface

The controller uses a 10 pin .100 header for all signals. It requires receiver audio and a signal present indication (CAS) from the receiver, supplies transmit audio and PTT to the transmitter, and requires 13.8 volts DC for power. Be very careful when wiring DC power to the controller, reverse polarity will destroy the ICs. The connector pinouts are shown in the table below.
J1 REPEATER Electrical Connections
Pin | Use
1 | +13.8 Volts
2 | +13.8 Volts
3 | CAS+
4 | Fan Control/Digital Output
5 | PTT (active low)
6 | Ground
7 | TX Audio (to transmitter)
8 | Ground/TX Audio Return
9 | RX Audio (from receiver)
10 | Ground/RX Audio Return

### 2.3 J2: NHRC-DAD Interface

J2 is provided for the connection of an optional NHRC-DAD digital audio delay. The NHRC-DAD, in conjunction with the NHRC-3.1, can completely mute DTMF and eliminate squelch crashes from the repeater audio.
J2 DELAY Electrical Connections
Pin | Use
1 | +13.8 Volts to delay board
2 | Audio to delay board
3 | Audio from delay board
4 | Ground/Audio Return

⇒ Note: If a NHRC-DAD is not connected, then a jumper should be installed between pin 2 and pin 3. If there is not a NHRC-DAD or a jumper installed, then the controller will not pass audio.

Copyright 2011-2013, NHRC LLC. All Rights Reserved. | Page 5

### 2.4 JTS64: TS-64 Interface

Connector JTS64-pin header that allows the easy installation of an optional Communications Specialists TS-64 for CTCSS decode and encode. Consult Table JTS64 for hookup information.
JTS64 TS-64 Connector
Pin | Use | to TS-64 Signal
1 | +13.8 Volts | +13.8V In
2 | Receiver Audio | Decoder In
3 | Receiver Audio | N/C
4 | Filtered Audio | High Pass Filter Out
5 | CTCSS Detect | Decoder Out
6 | Ground / Audio Return | PTT Input, Hangup

If the TS-64 is installed, then jumper JP1 should be removed to utilize the TS-64’s high-pass filter, which will remove the CTCSS tone from the repeater audio. If you do not want to use the high-pass filter, do not connect the TS-64 High-Pass Filter Out wire to pin 4 and leave JP1 installed.

Page 6 | Copyright 2011-2013, NHRC LLC. All Rights Reserved.

### 2.5 J3 Serial Programming Connector

Connector J3 allows the NHRC-3.1 to be programmed by NHRC’s NHRC-3.1 programming software. This connector allows the connection of a serial cable to the controller.
J3 Serial Programming Connector
Pin | Use | PC Cable DE-9S
1 | Data to controller | 3, transmit data
2 | Data from controller | 2, receive data
3 | Ground | 5, ground

Note that the NHRC-3.1 programming software currently should work with any attached RS-232 interface, including most USB to serial adapters. It is only supported with “real” RS-232 (+/- 12 volt) signaling levels.
⇒ Note: An optional serial port programming cable is available for purchase. See www.nhrc.net for details.

### 2.6 J4: Expansion Connector

Warning: Failure to read and follow the instructions below could result in severe damage to your controller. Damage to the controller caused by improper use of the expansion port is not covered under warranty by NHRC.

The NHRC-3.1 has an expansion connector to allow users to interface custom hardware to the controller. The expansion connector has unbuffered microcontroller port signals which must be conditioned to safely interface the controller to external devices. Signals at improper levels will cause the destruction of the port pins, microcontroller, or destroy the repeater controller itself. Your use of this interface is completely at your own risk, and is not supported by NHRC. Seek assistance from a qualified electronic technician if you have any doubt about making connections to J3.
J3 Expansion Connector
Pin | Signal | Description
1 | +5 Volts | Regulated +5 Volts
2 | Reserved | Reserved for NHRC – Do not use!
3 | CTSEL1 | Courtesy Tone Select Input 1
4 | CTSEL2 | Courtesy Tone Select Input 2/Alarm Input
5 | OUT1 | Digital Control Output 1
6 | OUT2 | Digital Control Output 2
7 | Ground | Ground
Copyright 2011-2013, NHRC LLC. All Rights Reserved. | Page 7

### 2.6.1 Courtesy Tone Selection

Pins 3 and 4 of the expansion connector can be used to select alternate courtesy tones to indicate alarm status, voted receiver status, etc. These pins are configured as inputs to the microcontroller, and have an internal weak pullup resistor to set the state of the pins high when they are not connected. NHRC recommends that an external pullup resistor of 10K ohms be used to pull these inputs to +5 volts. When the inputs are pulled to ground, different courtesy tones are selected as shown below.
Courtesy Tone Selection
CTSEL1 | CTSEL2 | Courtesy Tone Selected
Low | Low | Courtesy Tone 0
High | Low | Courtesy Tone 1
Low | High | Courtesy Tone 2
High | High | Courtesy Tone 3

Note that with nothing connected to the CTSEL pins, Courtesy Tone 3 will be selected due to the internal weak pullups.

2.6.2 Alarm Input.
Pin 4 (CTSEL2) can be used as an alarm input. This input should have a external 10K ohm pull up resistor on it. When pulled low, the alarm functionality of the controller will be activated, if enabled. The stored voice alarm message will be played at the “alarm announce timer” interval, until the alarm condition is cleared. The alarm can be set to “latch” on, in which case the “reset alarm” control code must be sent to the controller to clear the alarm, after the signal is allowed to float high again.

### 2.6.3 Digital Output Ports

Pin 5 and 6 (OUT1 and OUT2) are active high outputs, that are used as digital outputs 1 through 4. These pins can sink or source an absolute maximum current of 20 mA, however NHRC recommends a maximum of 5 mA in or out of these pins. The state of these digital outputs can be stored in a saved setup.

### 2.6.4 Power and Ground connectors

Pin 1 provides regulated 5 volts for your interface circuitry, i.e. to provide +5 VDC to the pullup resistors used for the courtesy tone selection inputs. This power source should not be used to power external loads under any circumstances.
Pin 7 provides a ground return for your external expansion logic circuits. This ground source should not be used as the return for any external loads controlled by the controller.
Page 8 | Copyright 2011-2013, NHRC LLC. All Rights Reserved.

### 2.7 Audio Level Adjustment

Description of Audio Processing:

The NHRC-3.1 uses analog switching and audio mixing to route audio from audio sources to the transmitter port and voice recorder.

The controller’s audio path is described in detail below.

The main receiver’s audio is passed into the controller through potentiometer VR3 “RX LEVEL”, and then buffered through audio amplifier U1A for impedance isolation and equalization. This amplifier can be set up to provide flat audio response or 6 dB/octave de-emphasis with a roll-off of approximately 250 Hz, allowing the use of discriminator audio. The buffered audio is then passed to touch-tone decoder U4, and through connector J2 “DELAY” to the optional digital audio delay board for squelch tail elimination. If the digital audio delay is not present, J2 pins 2 and 3 must be jumpered to allow audio to continue to pass through the controller. After the digital audio delay connector, the main receiver audio is gated through analog switch Q4. The gated audio is supplied to the transmitter mix bus via, potentiometer VR2 “PROC RX LEVEL”, and into the digital voice recorder (DVR) chip via potentiometer VR4 “RECORD”.

Flat or de-emphasized audio on the repeater port is simply selected by moving the shorting jumper JP3 “RX FILTER” from (N) normal position to (D) de-emphasized position. Note: if the jumper is completely removed, the audio processing circuit will provide approximately a 10X audio gain with flat response.

Courtesy tones are generated directly by the microprocessor U5, filtered, and provided to the transmitter mix bus through potentiometer VR6 “BEEP”.

DVR output is provided to the tranmitter mix bus through potentiometer VR5 “SPEECH”.

The transmitter mix bus is provided to the main transmitter through buffer amplifier U1B, with it’s level adjusted with potentiometer VR1 “TX LEVEL”.

Description of Controls:

VR1 “TX LEVEL” sets the transmit audio master level.

VR2 “PROC RX LEVEL” sets the receiver audio level into the transmitter mix bus.

VR3 “RX LEVEL” sets the receiver audio input level into the controller, and, more critically, into the DTMF decoder.

VR4 “RECORD”sets the receiver audio level into the ISD voice recorder IC.

VR5 “SPEECH” sets the recorded speech level into the transmitter mix bus.

VR6 “BEEP” sets the beep level into the transmitter mix bus.

Audio Level Setup:

Copyright 2011-2013, NHRC LLC. All Rights Reserved. | Page 9

Recommended equipment:

- Signal generator or another method of generating a RF signal for the main receiver, modulated with a 1 KHz tone at 3 KHz deviation.
- Deviation meter.
- A Service Monitor is recommended for overall ease of alignment.

### Procedure:

The reference level will be a 1 KHz tone at 3 KHz deviation.

1. Prepare the controller for audio alignment by setting all potentiometers to the midrange position, and properly configuring the input equalization (normal or deemphasized) by setting jumper JP3 “RX FILTER” to the appropriate pins for the equalization you want.
2. Transmit the reference tone through the repeater, and adjust VR3 “RX LEVEL” for reasonable transmitted deviation, about 3 KHz. The final adjustment of VR3 will occur later. Turn off the reference signal.
3. Transmit some DTMF tones into the repeater, and adjust VR3 for reliable DTMF decoding, as indicated by LED D2. Test every DTMF key, including *, #, A, B,C, and D. If the level of VR3 is set too high, voice clipping, squelch noise bleed-through, and/or false DTMF decoding may occur.
4. Use VR2 “PROC RX LEVEL” to set the received audio repeat level.
5. Use VR6 “BEEP” to set the courtesy tone to a reasonable level.
6. Unlock the controller and force it to transmit the recorded voice ID with the *800 command. Set the DVR playback level with VR5 “SPEECH”. Lock the controller.
7. Set the DVR input level with VR4 “RECORD”. This is best set by setting the controller into simplex mode, recording a test message and allowing it to play back. Adjust the input level so that the test message is played back at the same level as it originally passed thorough the repeater. Overdriving the DVR will result in compression of recorded audio, complete with “noise pumping” effects, so it is important that the level is not set too high. Conversely, setting the DVR record level too low will result in noisy playback performance.

Hint: With the controller in duplex mode (not simplex), set up your signal generator with the test tone. Note the deviation of the repeater’s transmitted signal. Shut off the generator. Now set the controller into simplex mode and send the test tone for 15 or 20 seconds, then turn off the test tone. The DVR will now play back the recorded test tone. Note the deviation. Repeat this test and adjust the DVR input until the record and playback deviation is the same. Be careful to remember to subtract out your CTCSS deviation to get a true DVR deviation measurement.

Page 10 | Copyright 2011-2013, NHRC LLC. All Rights Reserved.

8. If necessary, the output level of the controller can be adjusted with VR1 “TX LEVEL”.

### 2.8 The LED Indicators

The NHRC-3.1 has five LED indicators. These LEDs indicate the state of various inputs and outputs of the controller. The LEDs are particularly useful during setup. The LEDs display the following information:

NHRC-3.1 LED Indicator Functions
LABEL | COLOR | USE
+12 | Red | Power Indicator
PTT | Red | Transmit Indicator
DTMF | Yellow | DTMF Detect Indicator
COR | Green | Unsquelched Indicator
CTCSS | Green | CTCSS Detect Indicator

All LEDs, except the power LED, can be disabled to reduce power consumption by removing jumper JP5 “LED EN”.

Copyright 2011-2013, NHRC LLC. All Rights Reserved. | Page 11

### 3. Programming the Controller

This section of the User Guide describes how the repeater operator programs the repeater. It is intended for repeater operators and users who have an interest in how the controller is customized for specific configurations.
⇒ Note: *n commands are only available when the controller has been unlocked by sending the unlock command.

### 3.1 Quick Setup

This section of the User Guide is intended to get a first-time user “up and running” quickly using a minimum of the customizable features.
NHRC-3.1 controllers are shipped from the factory enabled, with test audio tracks recorded for all messages, and all command prefixes programmed to the default values. Once your controller is installed and functioning, you should follow the procedure described in this section to begin to customize its operation to suit your needs.

## WARNING

The initialization process described below will completely reset the controller to the factory defaults. All the test voice messages will be deleted, and the repeater will be set as disabled. This allows users with a simplex repeater to program their controller. Once initialized, the controller will appear to be dead except when valid commands are entered, until the “repeater enable” control operator command is sent.

### The controller ships from the factory in a workable “full duplex” configuration. Until you gain familiarity with the controller, it is

strongly suggested that you do not initialize the controller.

You are not required to use this procedure. It is completely possible to program the NHRC-3.1 as shipped from the factory without initialization, unless you plan to use it on a simplex repeater. In the case of simplex repeater use, initialization will help since it will cause the controller to power up with the repeater disabled.

### Procedure:

- Make all the necessary electrical connections. See Section 2.
- Install the initialize jumper (JP6 “INIT”, located in the lower right hand corner of the board.)
- Apply power to the NHRC-3.1. After a short pause, the controller will transmit “NHRC 3.1 V x.xx” in Morse code. (The “x.xx” will be replaces with the firmware version number.) At this time, NHRC recommends that you immediately program the unlock code.
Page 12 | Copyright 2011-2013, NHRC LLC. All Rights Reserved.

- Leave the initialize jumper installed for this operation.
- Send the default unlock code (07) to the controller. The controller should respond with “OK” in Morse code.
- Use the *2 command to program command prefix 07: the unlock prefix. To program the unlock code to 314159, send the following command: *207314159. Note that this example uses the value of Pi (π) times 100,000 as the example unlock code. You probably don’t want to use this as your unlock code, since it is printed in this manual!
- Send the “#” command to lock the controller. The controller should respond with “OK” in Morse code.
- Remove the initialize jumper (JP6 “INIT”, located in the lower right hand corner of the board.)
You should record the voice ID messages (#0, 1, and 2), the time-out message (#3), the tail messages (#4 and 6) and program the Morse code ID at this time. (See Sections 3.10.1 and 3.11.2 for information on programming the Morse code ID and recording voice messages.)

This is a good time to program all the command prefixes. (See Section 3.5 for information on programming command prefixes.)

⇒ Note: After initialization, the controller will respond to commands, but will not function as a repeater until repeater operation is enabled. This allows the controller to be configured in simplex repeaters. See section 4.1 for information on enabling the repeater.
⇒ Note: NHRC strongly recommends that you do not leave the initial default command prefixes in the controller.
Copyright 2011-2013, NHRC LLC. All Rights Reserved. | Page 13

### 3.2 Initializing the Controller

Initializing the controller will re-program the controller’s non-volatile EEPROM memory with the factory defaults. All customized settings are lost, including command prefixes, timer presets, the Morse code ID, and the voice messages.
⇒ Note: The controller should never require initialization except for new installations.

⇒ Note: After initialization, the controller will respond to commands, but will not function as a repeater until repeater operation is enabled. This allows the controller to be configured in simplex repeaters. See section 4.1 for information on enabling the repeater.

### Procedure:

- Install the initialize jumper (JP6 “INIT”, located in the lower right hand corner of the board.)
- Apply power to the controller. After a short delay of about 10 seconds, the controller will send the Morse code message “NHRC 3.1 V x.xx” (where “x.xx” will be replaced with the firmware version number.
- Remove the initialize jumper (otherwise the controller will initialize again the next time it is powered up).
⇒ Note: DO NOT LEAVE THE INITIALIZE JUMPER INSTALLED.

See the Appendix for the factory defaults for the controller.

Page 14 | Copyright 2011-2013, NHRC LLC. All Rights Reserved.

3.3 *0: Unlocked Mode Control Operator Access

### 3.3.1 Set Control Operator Switches

The *0 command allows access to all control operator switch groups, including groups 6 and 7 which are not accessible using the control operator prefix. Groups 6 and 7 help to implement controller security by controlling write access to controller data and control operator access to the other eight groups.

The format of this command is
*0<g><i><s> where:

<g> specifies the group number. Valid range is 0 to 9.

<i> specifies the switch number. Valid range is 0 to 7.

<s> is optional. If present, it is the new state of the switch. Valid values are 0 and 1.

Upon receipt of a valid *0 command without the state, the controller will transmit the current state of the selected control operator switch.

Example: Sending the command *000 will inquire of the state of control operator group 0 item 0, and the controller will read back the current state: either “ON” or “OFF” in Morse code.

See Section 4 for more information about control operator switches.

Copyright 2011-2013, NHRC LLC. All Rights Reserved. | Page 15

3.4 *1: Save Setup

The NHRC-3.1 Repeater Controller has five “saved configuration setups” that allow the repeater operator to save two presets of all 64 of the control operator switches.
The default setup is #0, which is loaded when the controller is powered up.

### 3.4.1 Save configuration setup

*1<n> where:

<n> specifies the setup number to save. Valid range is 0 through 4.

After a valid command is received, the controller will respond with “OK” in Morse code. A saved setup can be loaded by using the load saved setup command:
(See Section 5.3 for information about the Load Saved Setup command.)

Example: To save the current controller state (all 8 control operator switch groups) as state #1, send the following command with the controller unlocked: “*11”. The controller will transmit "OK" in Morse code if the command is accepted.

⇒ Note: Saved setup 0 is automatically loaded into the controller at power up. Be sure to save the state you wish to have the controller in after a power interruption into saved setup 0.

Page 16 | Copyright 2011-2013, NHRC LLC. All Rights Reserved.

3.5 *2: Program Command Prefixes

Every command accepted by the NHRC-3.1 controller when it is locked consists of a command prefix and optional command arguments.
Each prefix can be programmed to restrict access to certain functions to only those users who know the prefix. This gives the repeater operator the ability to only allow specific users to access certain features.
Command Prefix Rules:
- A command prefix is one to seven digits long.
- A command prefix cannot be left blank.
- No two command prefixes should be programmed the same, or be programmed the same as the beginning of a different prefix. For example, do not program the control operator prefix to 1234 and the digital output control prefix to 12345, because the controller would not understand whether 123456 was intended to set control operator switches or change the state of the digital outputs.
Section 6.1.1 describes the Factory Default Command Prefixes.
Copyright 2011-2013, NHRC LLC. All Rights Reserved. | Page 17

### 3.5.1 Set command prefix

*2<pp><prefix> where:

<pp> specifies the prefix number to set. Valid values are in the range 00 to
07. Two digits must be used. See the Command “Prefixes by Number Table” to determine the prefix number you want to set.

<prefix> specifies the new prefix to assign. Must be 1 to 7 digits in length. The valid digits are 0-9, A-D, * and #.

After a valid command is received, the controller will respond “OK.”

Command Prefixes by Number

Prefix
Number Description
00 | Control Operator
01 | DTMF Access
02 | Digital Output Control
03 | Load Saved Setup
04 | Audio Test
05 | Reset Alarm
06 | (reserved for NHRC)
07 | Unlock Controller

⇒ Note: For security reasons, command prefixes will never be sent over the air by the controller.

Example: To set the DTMF access prefix to 4321, send the following command with the controller unlocked: "*2014321”. The controller will respond with "OK" in Morse code if the command is accepted.

⇒ Note: For security reasons, command prefix 07 (the unlock code) cannot be changed unless the initialize jumper (JP6 “INIT”) is installed. This means that the unlock code cannot be changed without physical access to the controller. To change the code, install the jumper, enter the command, and remove the jumper. Do not leave the initialize jumper installed, and do not power up the controller with the initialize jumper installed, unless you want to reset the controller to factory defaults.
⇒ Caution: Do not set any prefix to use the same initial digits as any other prefix, because the controller will not be able to tell the difference between them. For example, if the DTMF access code is set to “123”, and the load saved setup code is set to “1234”, then when a user sends “1234123456” the controller will try to load saved setup 56 rather than enabling the controller in DTMF access mode.
Page 18 | Copyright 2011-2013, NHRC LLC. All Rights Reserved.

3.6 *3: Set timers, Morse code speed and Pitch.

The NHRC-3.1 has ten programmable “timer,” settings, some of which are not really timers, but are event counters.
Each timer has its own resolution that is the amount of time each timer count represents. For example, the hang timer’s resolution is .1 second. To program a hang time of 5.0 seconds, the hang timer would actually be programmed to 50 because there are (50) .1 second intervals in 5.0 seconds.
The tail message counter is used to play the tail messages every nth time the tail timer expires.

### 3.6.1 Description of Timers

Timer 00 (hang timer long) and 01 (hang timer short) are “hang” timers. One of these timers can be selected. The hang timer specifies the amount of time the transmitter stays on after the receiver input signal goes away. This is sometimes called the “tail” timer. You can select either the long hang timer or the short hang timer. The resolution of the hang timers is .1 seconds.

Timer 02 is the ID timer. This timer controls how long the period is before a Morse code ID message is sent. This timer is set in tens of seconds. For example, to set a 9 minute ID timer interval: 9 minutes is 540 seconds, so the timer would be set for 54.

Timer 03 is the DTMF access mode timer. In DTMF access mode, sending a DTMF command activates the repeater. The repeater can be de-activated with another DTMF command, or if a period of inactivity occurs. The DTMF access mode timer sets the amount of inactivity before the repeater automatically deactivates. This timer has a 10 second resolution.

Timers 04 (timeout timer long) and 05 (timeout timer short) control the timeout period. Timeout is the maximum amount of time the receiver can be active before the repeater assumes a stuck mike and stops repeating. These timers are set with a 1 second resolution.

Timer 06 (fan timer) controls how long the fan control output will remain active after the controller’s PTT signal is released. This timer uses 10-second resolution.

Timer 07 is the “tail message counter.” This timer is actually a counter. It sets the number of times the repeater “tail” (hang time) must end before the tail message plays.

Timer 08 (alarm announce timer) sets how often the alarm message is played when the controller’s alarm state has been set. (See sections 4.5 and 5.5for information about the alarm settings) This timer uses 10-second resolution.

Timer 09 (Morse code pitch) and Timer 10 (Morse code speed) allow the repeater owner to tailor the tone of the transmitted Morse code characters. They are technically not timers, but parameter settings. The Morse code pitch can be set to

Copyright 2011-2013, NHRC LLC. All Rights Reserved. | Page 19

any of the 32 tones shown in section 6.1.3, and the Morse code speed set from 5 to 30 WPM.

Page 20 | Copyright 2011-2013, NHRC LLC. All Rights Reserved.

3.6.2 Program a timer or Morse code speed and Pitch. The NHRC-3.1 timers are programmed as follows: *3<nn><time> where:

<nn> specifies the timer to set. Valid range is 00 to 12. Both digits must be present. Consult the NHRC-3.1 Timers by Number Table for the timer number.

<time> The value to program the timer to. The valid range for <time> is 0 to 255.

After a valid set timer command is received, the controller will respond with the word “OK” in Morse code.
NHRC-3.1 Timers, by Number

Timer

No. | Description | Timer
| | Resolution
00 | Hang timer long | 0.1
01 | Hang timer short | 0.1
02 | ID timer | 10
03 | DTMF access timer | 10
04 | Time-out timer long | 1
05 | Time-out timer short | 1
06 | Fan timer | 10
07 | Tail Message Counter | 1
08 | Alarm Announce Timer | 10
09 | Morse code Pitch | N/A
10 | Morse code Speed | N/A

### Examples:

To program the ID timer to six minutes (360 seconds), send the following command with the controller unlocked: "*30236”. If the command is accepted, the controller will respond with “OK” in Morse code.

To set the long hang timer for 20 seconds, send the following command with the controller unlocked: "*300200”. If the command is accepted, the controller will respond with “OK” in Morse code.

Copyright 2011-2013, NHRC LLC. All Rights Reserved. | Page 21

3.7 *4: (Reserved for NHRC)

This command is reserved by NHRC for future expansion. 3.8 *5: (Reserved for NHRC)

This command is reserved by NHRC for future expansion. 3.9 *6: (Reserved for NHRC)

This command is reserved by NHRC for future expansion.

Page 22 | Copyright 2011-2013, NHRC LLC. All Rights Reserved.

3.10 *7: Program Morse code and Beep Messages

The *7 command is used to program or play the Morse code ID and courtesy tones.

### 3.10.1 Program a Morse code ID

The Morse code ID can be programmed or played with the *70 command, as follows: *70<dd..dd..dd..> where:

<dd…dd…dd…> is the Morse code ID message. If left blank, the current Morse code ID message will play. When present, the part of the command represented by <dd..dd..dd..> consists of 1 to 12 digit pairs. Each pair of digits represents one Morse code character.

(See Section 6.1.4, the Morse code Character Table, to look up the code for each Morse code character.)

Example: To program “DE N1KDO/R” as the Morse code ID, with the controller unlocked the following command would be entered: *70 31 32 11 62 01 52 63 12 72. Please do not use this example and program N1KDO’s ID on your repeater. He has no sense of humor about this.

Copyright 2011-2013, NHRC LLC. All Rights Reserved. | Page 23

### 3.10.2 Program or play courtesy tones

The NHRC-3.1 supports eight different courtesy tones. Courtesy tones are composed of up to four segments of tones. Each segment has a tone frequency and duration.
The courtesy tone is selected based on the logic levels present at expansion connectors CTSEL1 and CTSEL2. If no signals are connected to these pins, then courtesy tone 3 is used. (Consult section 0 for information on the electrical interfacing to the expansion connectors.)

The courtesy tones are played and programmed with command *71 as follows: *71<n><ddtt ddtt ddtt ddtt> where:

<n> is the courtesy tone number to play or program. The valid range of values is 0 to 7.

<ddtt ddtt ddtt ddtt> is up to four sets of duration and tone.
Duration is in 10 ms increments; valid range is 01-99. Both digits must be specified. Tone is the number of the tone from Section 6.1.3, the Courtesy Tone Components Table.

Example: The default courtesy tone #0, (four 50MS bursts of notes F5, G5, B5, D6) would be programmed like: *7100513051505190522. (with controller unlocked)

Courtesy Tone Uses

Tone | Use
0 | Normal courtesy tone, CTSEL1=0, CTSEL2=0 (to program this to factory default: *71 0 0513 0515 0519 0522)
1 | Normal courtesy tone, CTSEL1=1, CTSEL2=0 (to program this to factory default: *71 0 1013 1015)
2 | Normal courtesy tone, CTSEL1=0, CTSEL2=1 (to program this t0 factory default: *71 0 1013 1015 1021)
3 | Normal courtesy tone, CTSEL1=1, CTSEL2=1 (to program this to factory default: *71 0 0522 051190515 0513)
4 | Reserved, not used
5 | Reserved, not used
6 | Reserved, not used
7 | Controller unlocked courtesy tone (to program this to factory default: *71 0 1031 1019 1031 1019)
Page 24 | Copyright 2011-2013, NHRC LLC. All Rights Reserved.

3.11 *8: Play/Record Voice Tracks

The NHRC-3.1 supports stored voice messages. The repeater operator will want to record all of these messages. The *8 command allows the repeater operator to record their preferred voice messages.
The repeater operator should record all of the controller’s speech IDs, tail messages, time-out message, etc.

### 3.11.1 Play a message

Command *80 is used to play messages:
*80<n> where:

<n> is the message to be played. Valid range for <n> is 0 – 3.

Example: To play back the initial ID message (message #0), send the following command with the controller unlocked: "*800”. The controller will play back the initial ID message.

NHRC-3.1 Stored Speech Messages
Message Number | Usage
0 | Initial ID message
1 | Normal ID message 1
2 | Normal ID message 2
3 | Time-out message
4 | Tail Message 1
5 | Tail Message 2
6 | Alarm Message
7 | Test Message Track
Copyright 2011-2013, NHRC LLC. All Rights Reserved. | Page 25

### 3.11.2 Record a message

Command *81 is used to record messages. *81<n> where:

<n> is the message to be recorded. Valid range for <n> is 0 – 7. To record a message, enter *81, followed by the message number you want to record. The controller will prompt you sending “OK” in Morse code. After the prompt, key your radio and speak clearly to record the message. The recording is terminated when either you stop transmitting or the message slot is full (that is, the slot’s message time is all used). The controller will transmit “OK” again after the message is recorded.
Example: To record the timeout message (message # 3), send the following command with the controller unlocked: "*813”. The controller will respond with a Morse code “OK”. Key your radio, and transmit your voice message you want to record. Recording ends either when you unkey, or the maximum message length for the message is reached, whichever comes first. The controller will acknowledge recording your message with a Morse code “OK.”

3.12 *9: (Reserved for NHRC)

This command is reserved by NHRC for future expansion.
3.13 **: Reset Controller

Command ** is used to reset the controller to the power-up state for any reason. The controller will send “NHRC 3.1 V x.xx” (where the “x.xx” is replaced with the firmware version number) in Morse code, and then play the initial ID.

Page 26 | Copyright 2011-2013, NHRC LLC. All Rights Reserved.

### 4. Control Operator Commands

The control operator settings control the controller’s features, functions, and settings. They can be accessed two different ways: through the “unlocked mode control operator access” commands (see section 3.3) or with the “normal” control operator commands.
The control operator commands are provided to allow the repeater owner to delegate control authority to a trusted group. The repeater owner should program the control operator prefix (see section 3.5) and share the prefix with the trusted group of control operators.
The NHRC-3.1 supports 64 different control operator settings arranged into eight different groups of eight “software switches.” Each software switch represents a setting in the controller that can be set to either on or off. Every switch is addressed by naming the group, then the item number and the desired state. There are eight groups of eight items each.

The format for all control operator commands is:
<ctl-op-prefix><group><item><state>

<ctl-op-prefix> The control operator prefix assigned by the repeater operator. (See Section 3.5 for information on Programming Command Prefixes.)

<group> The group code for the switch to set or inquire. The valid range for <group> is 0 to 7. Groups 8 and 9 can only be accessed with the programming *0 command. (See Section 3.3 for information about *0: Unlocked Mode Control Operator Access.)

<item> The item number to set or inquire. The valid range for <item> is 0 to 7.

<state> is optional. If present, it is the state (1=on, 0=off) to which the control operator switch is to be set.

When <state> is not present, or after a successful control operator command that sets the switch state, the controller will respond by transmitting either the word “ON” or the word “OFF”, depending on the state of the particular switch.
For example, to set group 0 item 0 to enabled, the following command would be sent: <ctl-op-prefix>001.
The controller will respond by transmitting the word “ON” in Morse code.
⇒ Note: All 64 of the control operator switches are saved when the controller’s state is saved. Saved state 0 is automatically loaded on power up, so if you want to make your changes to the control operator switches be restored after a power failure, it is important to save the controller’s state. See section 3.4 for information on the Save State Command.
Copyright 2011-2013, NHRC LLC. All Rights Reserved. | Page 27

### 4.1 Group 0 Switches: Repeater Control

Group 0 contains switches that control the main repeater and access to the main repeater.

Group 0 Switches:

Switch | Name | Description
0 | Repeater Enable | This is the repeater’s master enable/disable control. Set this to 0 to disable the repeater.

### 1 Repeater CTCSS

| Required | Allows the repeater to be set into a CTCSS required mode when enabled. When disabled, the repeater is carrier access. Note: If CTCSS Required and “dual squelch” mode are both selected, then the controller will require valid CTCSS for access, unless the hang timer is running. This mode allows the repeater to be activated by a user with the valid CTCSS tone, but then accessed by users without CTCSS, or to be activated with a 1750 Hz. tone for countries that require tone-burst access.

### 2 Key Up Delay

| (“Kerchunker Filter”) | Allows the “kerchunker filter” to be enabled. The “kerchunker filter” requires a signal for more than ½ second before the repeater will begin to repeat, but only when the transmitter is not on.
3 | Hang Timer Enabled | Normally enabled, but can be disabled when the repeater runs on battery power, or to discourage “kerchunkers.”
4 | Hang Timer Select | Allows the control operator to select which hang timer value is used. Allows the long (1) or short
(0) timer to be selected.

### 5 DTMF Access Mode

| Select | Allows the control operator to place the repeater into DTMF access mode. In DTMF access mode, the repeater, when idle, can only be activated by sending the DTMF access prefix, followed by a 1 to enable the repeater. The repeater will remain active until either disabled with the DTMF access prefix followed by a 0, or the repeater remains idle for longer than the time specified in the DTMF access timer.
6 | Courtesy Tone Enabled | Allows the courtesy tone to be enabled or disabled.
Page 28 | Copyright 2011-2013, NHRC LLC. All Rights Reserved.

Group 0 Switches:

Switch | Name | Description

### 7 Control Operator

| CTCSS required | When this switch is enabled, control operator commands will only be accepted when the command is received with a valid CTCSS tone.
Copyright 2011-2013, NHRC LLC. All Rights Reserved. | Page 29

### 4.2 Group 1 Switches: More Repeater Control

Group 1 contains switches that control the main repeater and access to the main repeater.

Group 1 Switches:

Switch | Name | Description

### 0 Repeater Time-out

| Timer Enable | Allows the time-out timer on the main repeater to be enabled or disabled. Normally the time- out timer will be enabled. However, certain applications may require that the time-out timer be disabled (nets, shuttle rebroadcast, etc.). Set this switch to 1 to enable the repeater time-out timer.

### 1 Time-out Timer Long

| Select | Allows the long (1) or short (0) timer to be selected.
2 | “Dual Squelch” Enable | Setting this switch to 1 enables dual squelch mode. In “Dual-Squelch” mode, either the CAS or the CTCSS signal will cause the repeater to be accessed. This is sometimes called “OR- Squelch” mode.
| | Note that when this switch is set (1) and the “Repeater CTCSS Required” switch is set (1), (see Group 0 Switches, section 4.1), then the controller will require valid CTCSS for access, unless the hang timer is running. This mode allows the repeater to be activated by a user with the valid CTCSS tone, but then accessed by users without CTCSS, or to be activated with a 1750 Hz. tone for countries that require tone- burst access
3 | DTMF Muting Enable | When enabled (1), the controller will mute the receiver audio to prevent received DTMF command tones from being broadcast over the repeater.
4 | Tail Message 1 Enable | Enables Tail Message 1 (message #4) for playback when the tail message counter counts down to zero. If both tail message 1 and tail message 2 are enabled, they are alternated.
5 | Tail Message 2 Enable | Enables Tail Message 2 (message #5) for playback when the tail message counter counts down to zero. If both tail message 1 and tail message 2 are enabled, they are alternated.
Page 30 | Copyright 2011-2013, NHRC LLC. All Rights Reserved.

Group 1 Switches:

Switch | Name | Description

### 6 Simplex Repeater

| Mode | When enabled (1), the controller will function as a “simplex repeater”, recording up to 90 seconds of audio from the input, and playing it out the output when the input CAS drops.

### 7 Simplex Repeater

| Voice ID Mode | When enabled (1), the controller will reserve message #0 (the initial ID track) from the space used for simplex mode, and it will play this track for the ID, rather than the Morse code ID.
Copyright 2011-2013, NHRC LLC. All Rights Reserved. | Page 31

### 4.3 Group 2 Switches: Voice ID and Misc. Control

Group 2 controls the voice ID and tail messages.

Group 2 Switches:

Switch | Name | Description
0 | Enable Voice Initial ID | When enabled (1), the initial voice ID message is present. If disabled (0), the Morse code ID will play instead of the voice initial ID.

### 1 Enable Voice Normal ID

| #1 | When enabled (1), the controller will play the normal ID message voice track (#1) for the “normal” ID. If both Voice Normal ID 1 and Voice Normal ID 2 are enabled, they will be alternated. If neither normal voice ID is enabled, the controller will play the Morse code ID for the normal ID.

### 2 Enable Voice Normal ID

| #2 | When enabled (1), the controller will play the normal ID message voice track (#2) for the “normal” ID. If both Voice Normal ID 1 and Voice Normal ID 2 are enabled, they will be alternated. If neither normal voice ID is enabled, the controller will play the Morse code ID for the normal ID.

### 3 Allow ID Stomp by

| Keyup | When enabled (1), will allow the controller to cancel a voice ID and play the Morse code ID if a user begins to transmit while the voice ID is playing.

### 4 Enable Voice Time-out

| Message | When set (1), enables the voice time-out message, instead of the Morse code time-out message “TO.”

### 5 Digital Output Fan

| Control | When enabled (1), configures the digital output on the main repeater connector to be a fan control output. A fan connected to this output will run while the transmitter is keyed, and a programmable amount of time after the transmitter is unkeyed. When disabled, this input is controlled by the state of the Group 2 Item 6 (the next) switch.
6 | Digital Output Control | When the digital output fan control mode is disabled, this switch allows the control operator to set the state of the digital output on the main repeater connector.
Page 32 | Copyright 2011-2013, NHRC LLC. All Rights Reserved.

Group 2 Switches:

Switch | Name | Description

### 7 Digital Audio Delay

| Present | When enabled (1), changes the timing of the CAS logic in the controller to support the use of a NHRC-DAD on the repeater port.
Copyright 2011-2013, NHRC LLC. All Rights Reserved. | Page 33

### 4.4 Group 3 Switches: European ID Mode Control

Group 3 contains switches that are used for European-style ID control.

Group 3 Switches:

Switch | Name | Description
0 | European ID Mode | When enabled (1), the repeater will ID in a mode that is compatible with European rules.
1. When the repeater is idle, activating the repeater
| | will cause the recorded Initial ID to play, and the ID timer reset to the programmed value. The Morse code ID can be played instead of the Initial ID by setting group 2 switch 0 to 0.
2. When the repeater becomes idle, either the
| | recorded Normal ID or the Morse code ID message will be played, and the ID timer reset to the programmed value. The recorded voice Normal ID can be selected instead of the Morse code ID by setting group 3 switch 1 to 1.
3. When the ID timer times out (counts down to
| | zero), the recorded Normal ID message will be played, and the ID timer reset to the programmed value. The Morse code ID can be selected instead of the Normal ID be setting group 2 switch 1 to 0.
4. The ID will continue to play every time the ID
| | timer times out.
5. The ID timer is set to 10 seconds at power up.

### 1 European ID Mode

End ID Selector

This switch selects which ID plays when the hang timer times out, and the repeater becomes idle.
Set this switch to 0 to play the Morse code ID, or set this switch to 1 to play the recorded voice Normal ID.
2 | Reserved | Reserved for NHRC.
3 | Reserved | Reserved for NHRC.
4 | Reserved | Reserved for NHRC.
Page 34 | Copyright 2011-2013, NHRC LLC. All Rights Reserved.

Group 3 Switches:

Switch | Name | Description
5 | ID Beacon Mode | When enabled (1) this switch causes the controller to continuously ID every ID timer interval, regardless of input activity.

### 6 NO Morse code ID

| mode | When set (1), the Morse code ID will NEVER play, only voice IDs will play
7 | NO ID mode | When set (1), NO ID messages will play, ever.
Copyright 2011-2013, NHRC LLC. All Rights Reserved. | Page 35

### 4.5 Group 4 Switches: Expansion Outputs Mode Control

Group 4 contains switches that configure the expansion outputs.

Group 4 Switches:

Switch | Name | Description
0 | OUT1 Pulsed Mode. | When enabled (1), setting OUT1 to on will cause it to remain on for ½ second.
1 | OUT2 Pulsed Mode. | When enabled (1), setting OUT2 to on will cause it to remain on for ½ second.
2 | Reserved | Reserved for NHRC.
3 | Reserved | Reserved for NHRC.
4 | Reserved | Reserved for NHRC.
5 | Reserved | Reserved for NHRC.
6 | Alarm Input Enable | When set (1), the CTSEL2/ALARM input pin on the expansion connector becomes the alarm input. When this pin is pulled low, the alarm condition is set, and the Alarm Message (message #6) will play as set by the alarm announce timer. The if the Alarm Latch Mode (Group 3, Switch 7, next) is set (1), then the alarm must be cleared by the pin being allowed high again, and the Reset Alarm control code must be sent. If the latch mode is not selected, the pin going high is sufficient to clear the alarmed state.

### 7 Alarm Input Latch

| Mode | When set (1) the alarm condition set by a low signal on the CTSEL2/ALARM input pin will not be cleared by the pin returning to the high state. The Reset Alarm control operator code must be sent to clear the alarm latched condition.
Page 36 | Copyright 2011-2013, NHRC LLC. All Rights Reserved.

### 4.6 Group 5 Switches: Expansion Outputs Control

Group 5 contains switches which control the four expansion output ports. These ports can also be controlled with the Expansion Output Control prefix, and their state is saved with the state of the controller.

Group 5 Switches:

Switch | Action | Description
0 | OUT1 Output Control | When set (1), OUT1 will be in a logic 1 state. When clear (0), OUT1 will be in a logic 0 state.
1 | OUT2 Output Control | When set (1), OUT2 will be in a logic 1 state. When clear (0), OUT2 will be in a logic 0 state.
2 | Reserved | Reserved for NHRC.
3 | Reserved | Reserved for NHRC.
4 | Reserved | Reserved for NHRC.
4 | Reserved | Reserved for NHRC.
5 | Reserved | Reserved for NHRC.
6 | Reserved | Reserved for NHRC.
7 | Reserved | Reserved for NHRC.
Copyright 2011-2013, NHRC LLC. All Rights Reserved. | Page 37

### 4.7 Group 6 Switches: Programming Write Protect

Group 6 contains switches that enable or disable modification to controller data. These switches serve as a “write protect” to help prevent accidental reprogramming of repeater features. Each switch, when enabled (1), write protects its associated setup information. This entire group cannot be accessed by the control operator, it can only be accessed when the repeater is unlocked, by using the *0 command. (See Section 3.3 for information on the unlocked mode control operator access.)

Group 6 Switches:

Switch | Name | Description

### 0 Write Protect Control

| Group Setups | When enabled (1), causes the *1 command (Save Setup) to fail, effectively disallowing control groups to be saved.

### 1 Write Protect

| Command Prefixes | When enabled (1), causes the *2 Program Command Prefix command to fail, effectively disallowing modification of the command prefixes.
2 | Write Protect Timers | When enabled (1), causes the *3 Set Timers command to fail, effectively disallowing modification of the timer values.
3 | Reserved | Reserved for NHRC.
4 | Reserved | Reserved for NHRC.
5 | Reserved | Reserved for NHRC.

### 6 Write Protect Morse

| code Messages and Courtesy Tones | When enabled (1), causes the *70 and *71 commands to fail when new messages are specified, effectively disallowing modification of the Morse code ID and courtesy tones.

### 7 Write Protect Voice

| Messages | When enabled (1), causes the *81 “record voice message” command to fail, effectively disallowing modification of the voice message tracks.
Page 38 | Copyright 2011-2013, NHRC LLC. All Rights Reserved.

### 4.8 Group 7 Switches: Control Operator Group Access

Group 7 contains switches which enable or disable control operator access to the control operator groups. This entire group cannot be accessed by the control operator, it can only be accessed when the repeater is unlocked, by using the *0 command. These switches allow the repeater operator to selectively disable control operator functions on a group-by-group basis, allowing more granularity of controller security. (See Section 3.3 for information on the unlocked mode control operator access.)

Group 7 Switches:

Switch | Name | Description

### 0 Enable Control

| Operator Access to Group 0 | When enabled (1), allow the control operator to change the settings in Group 0.

### 1 Enable Control

| Operator Access to Group 1 | When enabled (1), allow the control operator to change the settings in Group 1.

### 2 Enable Control

| Operator Access to Group 2 | When enabled (1), allow the control operator to change the settings in Group 2.

### 3 Enable Control

| Operator Access to Group 3 | When enabled (1), allow the control operator to change the settings in Group 3.

### 4 Enable Control

| Operator Access to Group 4 | When enabled (1), allow the control operator to change the settings in Group 4.

### 5 Enable Control

| Operator Access to Group 5 | When enabled (1), allow the control operator to change the settings in Group 5.
6 | Reserved | Reserved for NHRC.
7 | Reserved | Reserved for NHRC.
Copyright 2011-2013, NHRC LLC. All Rights Reserved. | Page 39

### 5. User Commands

This section of the manual describes commands that are available to the repeater users. Every command has a command prefix that is set by the repeater operator. The prefixes can be kept secret, so only certain users have access to certain functions. (See Section 3.5 for more information on programming command prefixes.)
Throughout this section of the manual, the command prefix will be shown as <prefix>, which must be replaced with the actual command prefix as programmed by the repeater operator.

### 5.1 DTMF Access

The NHRC-3.1 Repeater Controller supports a DTMF access mode which allows the repeater to be left in a secured disabled state, but users who know the DTMF access code can enable the repeater. The repeater reverts to the secured disabled state when either the repeater is idle for longer than the DTMF Access Mode Timer, or a user sends the DTMF access code followed by a zero.
The repeater is put into DTMF Access Mode by setting control operator group 0, item 5 to enabled (1). (See Section 4.1 for information about this control operator switch, and section 3.5 for information on programming the DTMF Access Prefix and section 3.6 for information on setting the DTMF access timer.)

When the repeater is in the DTMF access mode, the DTMF access command is used as follows:
<prefix><state> where:

<prefix> is the DTMF access mode prefix.

<state> is 1 to enable the repeater. <state> is 0 to return the repeater to the secure disabled mode.

Example: If the repeater is in DTMF Access Mode, and the DTMF Access Prefix is “567”, the repeater can be activated by sending “5671”. At that time the repeater will remain on until either no activity occurs on the repeater for a period longer than the DTMF Access Mode timer or the repeater is manually deactivated by sending “5670”.

Page 40 | Copyright 2011-2013, NHRC LLC. All Rights Reserved.

### 5.2 Digital Output Control

The NHRC-3.1 expansion digital outputs can be directly set by a user command. Each output can be turned on, turned off, or have its state reported. If the output is configured for pulsed operation, turning it on will result on a 0.5 second on pulse. When an output is turned on, the controller will respond with the word “on” sent in Morse code. When an output is turned off, the controller will respond with the word “off” sent in Morse code. When an outputs state is checked, the controller will respond with either “on” or “off” sent in Morse code, depending on the output’s state.

To use the Digital Output Control feature, enter the following command: <prefix><port #><state> where:

<prefix> is the Digital Output Control prefix as programmed by the repeater operator

<port> is the expansion output number, 0 for port 1, 1 for port 2.

<state> is 1 to turn the port on, 0 to turn the port off. The port’s current state will be reported if the state digit is not sent.

Example: Assuming the Digital Output Control prefix is 99, if you want to set output 2 off, you can send “9910” to the controller. The controller will respond with “off” sent in Morse code. To test the state of output 0, you can send “991” to the controller; the controller will respond with either “on” or “off”, depending on the state of output 0.

Copyright 2011-2013, NHRC LLC. All Rights Reserved. | Page 41

### 5.3 Load Saved Setup

The NHRC-3.1 supports five saved setups of all 64 control operator switches. (See Section 3.4 for information about saving the controller state.)
This command allows users or control operators to select one of the preset repeater states.

The format for the load saved state command is:
<prefix><state-number> where:

<prefix> is the load saved state prefix as programmed by the repeater operator.

<state-number> is the state to load. Valid state numbers are 0 thru 4.

Example: Assuming the Load Saved Setup prefix is set to 314159, and you want to select your “net mode”, saved as setup #1, send “3141591”. The controller will respond with “OK” in Morse code.

Page 42 | Copyright 2011-2013, NHRC LLC. All Rights Reserved.

### 5.4 Audio Test

The NHRC-3.1 Repeater Controller has a built-in “audio test” feature that allows repeater users to get a true “first-hand” account of exactly how their radio sounds through the repeater system.

To use the audio test feature, use the following command:
<prefix> where:

<prefix> is the audio test prefix as programmed by the repeater operator.

The controller will respond with “OK” in Morse code when the command is accepted. The user should then key up and transmit a test message, of up to 30 seconds, to the controller. After the user un-keys, the controller will play back the stored audio test message.

### 5.5 Reset Alarm

If the NHRC-3.1’s alarm has been tripped, it can be reset with this command.

To reset the alarm, enter the following command:
<prefix> where:

<prefix> is the Reset Alarm prefix as programmed by the repeater operator

Example: Assuming the Reset Alarm prefix is 1234, send “1234” to the controller. The controller will respond with “OK’ in Morse code to indicate the command was accepted. The alarm message will stop being transmitted periodically.

Copyright 2011-2013, NHRC LLC. All Rights Reserved. | Page 43

### 6. Appendices

### 6.1 Factory Defaults

### 6.1.1 Default Command Prefixes Table

Index | Description | Default Prefix
00 | Control Operator | 00
01 | DTMF Access | 01
02 | Digital Output Control | 02
03 | Load Saved Setup | 03
04 | Audio Test | 04
05 | Reset Alarm | 05
07 | Unlock Controller | 07
Page 44 | Copyright 2011-2013, NHRC LLC. All Rights Reserved.

### 6.1.2 Timer Defaults Table

Timer Number | Description | Multiplier | Timer Value | Effective Value
00 | Hang Timer Long | .1 | 100 | 10.0
01 | Hang Timer Short | .1 | 50 | 5.0
02 | ID Timer | 10 | 54 | 540
03 | DTMF Access Timer | 10 | 60 | 600
04 | Time-Out Timer Long | 1 | 180 | 180
05 | Time-Out Timer Short | 1 | 30 | 30
06 | Fan Timer | 10 | 12 | 120
07 | Tail Message Counter | 1 | 0 | 0
08 | Alarm Interval Timer | 10 | 12 | 120
09 | Morse code Pitch | N/A | 20 | C5
10 | Morse code Speed | N/A | 20 | 20 WPM
Copyright 2011-2013, NHRC LLC. All Rights Reserved. | Page 45

### 6.1.3 Courtesy Tone Component Tones Table

Tone Code | Tone | Approximate Frequency *
00 | No tone | none
01 | F4 | 349.25
02 | F#4 | 370
03 | G4 | 392
04 | G#4 | 415.3
05 | A4 | 440
06 | A#4 | 466.15
07 | B4 | 493.9
08 | C5 | 523.25
09 | C#5 | 554.35
10 | D5 | 587.35
11 | D#5 | 622.2
12 | E5 | 659.3
13 | F5 | 698.5
14 | F#5 | 740
15 | G5 | 784
16 | G#5 | 830.6
17 | A5 | 880
18 | A#5 | 932.3
19 | B5 | 987.8
20 | C6 | 1046.5
21 | C#6 | 1108.7
22 | D6 | 1174.7
23 | D#6 | 1244.5
24 | E6 | 1318.5
25 | F6 | 1397
26 | F#6 | 1480
27 | G6 | 1568
28 | G#6 | 1661.2
29 | A6 | 1760
30 | A#6 | 1864.7
31 | B6 | 1975.5

* Note that the actual tone frequency may be +/- up to 0.5% different than the value shown here.

Page 46 | Copyright 2011-2013, NHRC LLC. All Rights Reserved.

### 6.1.4 Morse Code Character Table

Letter | Code
0 | 00
1 | 01
2 | 02
3 | 03
4 | 04
5 | 05
6 | 06
7 | 07
8 | 08
9 | 09
A | 21
B | 22
C | 23
D | 31
E | 32
F | 33
G | 41
H | 42
I | 43
J | 51
K | 52
L | 53
M | 61
N | 62
O | 63
P | 71
Q | 70
R | 72
S | 73
T | 81
U | 82
V | 83
W | 91
X | 92
Y | 93
Z | 90
Space | 11
/ | 12
Copyright 2011-2013, NHRC LLC. All Rights Reserved. | Page 47

### 6.2 Control Operator Controls

### 6.2.1 Control Operator Group 0 (Repeater Control) Operations Table

Group # | Item # | Function | Default | Comments
0 | 0 | Repeater Enable | 0 | Initialization will leave repeater disabled!
0 | 1 | Repeater CTCSS Required | 0
0 | 2 | Key Up Delay (Kerchunk Filter) | 0
0 | 3 | Hang Timer Enabled | 1
0 | 4 | Hang Timer Short/Long Select | 0 | 0=short, 1=long, see related timer values.
0 | 5 | DTMF Access Mode | 0 | see related DTMF access code and timer information
0 | 6 | Courtesy Tone Enabled | 1
0 | 7 | Control Op CTCSS Required | 0

### 6.2.2 Control Operator Group 1 (Repeater Control II) Operations Table

Group # | Item # | Function | Default | Comments
1 | 0 | Repeater Time-Out Timer Enable | 1 see related timer value
1 | 1 | Time-Out Long / Short | 1 | 0=short, 1=long, see related timer values short time-out
1 | 2 | Enable “Dual Squelch” | 0 | allows CTCSS or CAS to provide valid CAS
1 | 3 | Enable DTMF Muting | 1 | Repeater mutes touch tones
1 | 4 | Tail Message 1 Enable | 0
1 | 5 | Tail Message 2 Enable | 0
1 | 6 | Simplex Repeater Mode | 0 | Set to 1 for Simplex Repeater Mode
1 | 7 | Simplex Repeater Voice Id | 0
Page 48 | Copyright 2011-2013, NHRC LLC. All Rights Reserved.

### 6.2.3 Control Operator Group 2 (Voice and Tail ID Messages) Operations Table

Group # | Item # | Function | Default | Comments
2 | 0 | Enable Voice Initial Id | 1 | Plays Morse code ID if disabled. See Morse code ID programming
2 | 1 | Enable Voice Normal Id 1 | 1 | Alternates if 1 and 2 are both on. Plays Morse code ID if disabled.
2 | 2 | Enable Voice Normal Id 2 | 1 | Alternates if 1 and 2 are both on. Plays Morse code ID if disabled.
2 | 3 | Allow ID Stomp By Key Up | 1 | ID reverts to Morse code when keyed over.
2 | 4 | Enable Voice Time-Out Message | 1 | Plays Morse code “TO” when disabled
2 | 5 | Digital Output/Fan Control | 0 | 0=digital output, 1=fan control
2 | 6 | Digital Output Control | 0 | 1=on, 0=off
2 | 7 | Delay Present On Repeater Port | 0 | NHRC-DAD installed on repeater.

### 6.2.4 Control Operator Group 3 (Reserved for NHRC)

Group # | Item # | Function | Default | Comments
3 | 0 | European ID mode | 0 | Uses European rules to decide when to ID
3 | 1 | European ID end ID Voice Select | 0 Set to 1 to play Voice ID 1 on | repeater tail drop.
3 | 2 | Reserved | 0 | Reserved for NHRC
3 | 3 | Reserved | 0 | Reserved for NHRC
3 | 4 | Reserved | 0 | Reserved for NHRC
3 | 5 | ID Beacon Mode | 0 | Set to1 to ID regardless of activity
3 | 6 | NO Morse code ID Mode | 0 | Set to 1 to always play voice IDs, never Morse code IDs
3 | 7 | No ID mode | 0 | Set to 1 to never ID
Copyright 2011-2013, NHRC LLC. All Rights Reserved. | Page 49

### 6.2.5 Control Operator Group 4 (Digital Output Mode Control) Operations Table

Group # | Item # | Function | Default | Comments
4 | 0 | OUT1 Pulsed Mode. | 0
4 | 1 | OUT2 Pulsed Mode. | 0
4 | 2 | Reserved | 0 | Reserved for NHRC
4 | 3 | Reserved | 0 | Reserved for NHRC
4 | 4 | Reserved | 0 | Reserved for NHRC
4 | 5 | Reserved | 0 | Reserved for NHRC
4 | 6 | Alarm Input Enable | 0 | Set to 1 to use CTSEL2/ALARM input as alarm
4 | 7 | Alarm Latch Enable | 0 | Set to 1 to latch alarm condition until reset with Alarm Reset command.

### 6.2.6 Control Operator Group 5 (Digital Output Control) Operations Table

Group # | Item # | Function | Default | Comments
5 | 0 | OUT1 Output Control. | 0
5 | 1 | OUT2 Output Control. | 0
5 | 2 | Reserved | 0 | Reserved for NHRC
5 | 3 | Reserved | 0 | Reserved for NHRC
5 | 4 | Reserved | 0 | Reserved for NHRC
5 | 5 | Reserved | 0 | Reserved for NHRC
5 | 6 | Reserved | 0 | Reserved for NHRC
5 | 7 | Reserved | 0 | Reserved for NHRC
Page 50 | Copyright 2011-2013, NHRC LLC. All Rights Reserved.

### 6.2.7 Control Operator Group 6 (Programming Write Protect) Operations Table

Group # | Item # | Function | Default | Comments
6* | 0 | Write Protect Control Group Setups | 0
6* | 1 | Write Protect Prefixes | 0
6* | 2 | Write Protect Timers | 0
6* | 3 | Reserved | 0 | Reserved for NHRC
6* | 4 | Reserved | 0 | Reserved for NHRC
6* | 5 | Reserved | 0 | Reserved for NHRC
6* | 6 | Write Protect Morse code Messages & Courtesy Tones | 0
6* | 7 | Write Protects Pre-Recorded Vocabulary Tracks | 1 Protects tracks 0-6 against | accidental modification

### 6.2.8 Control Operator Group 7 (Control Operator Group Access) Operations Table

Group # | Item # | Function | Default | Comments
7* | 0 | Enable Access To Group 0 | 1
7* | 1 | Enable Access To Group 1 | 1
7* | 2 | Enable Access To Group 2 | 1
7* | 3 | Enable Access To Group 3 | 1
7* | 4 | Enable Access To Group 4 | 1
7* | 5 | Enable Access To Group 5 | 1
7* | 6 | Reserved | 0 | Reserved for NHRC
7* | 7 | Reserved | 0 | Reserved for NHRC

* controller must be unlocked to access groups 6 and 7

Copyright 2011-2013, NHRC LLC. All Rights Reserved. | Page 51

### 6.3 Terminology and Abbreviations

Term Description

CAS Carrier Activated Squelch, where receipt of a signal, with or without CTCSS tones will activate the controller.

CTCSS Continuous Tone Coded Squelch System. Also known as “Private Line” (Motorola TM) or “Channel Guard” (General Electric TM).

Digital Audio Delay (DAD) Digital Audio Delay (DAD) removes squelch crashes and allows DTMF tones to be fully muted.

DTMF Dual Tone Multi-Frequency, also known as “Touch Tone” codes.

Dual Squelch “Dual Squelch,” also known as CAS or CTCSS mode, allows the repeater to be configured with a tight squelch for users without CTCSS, but allows a valid CTCSS to access the repeater even when the signal is not quiet enough to open the carrier squelch.

ID Identification

PTT Push-to-Talk

Unlock Code A special password used to enable programming of the controller.

Page 52 | Copyright 2011-2013, NHRC LLC. All Rights Reserved.

### 7. Circuit Board

### 7.1 Interconnections

Connector | Name | Purpose
J1 | “Repeater” | Connects the repeater transmit and receive audio, PTT, CAS, fan control, and power signals to the controller.
J2 | “Delay” | Connects power and audio signals for operation of the Digital Audio Delay (NHRC-DAD) board.
JTS64 | “JTS64” | Interfaces a Communications Specialists TS-64 to the controller for CTCSS detection.

### 7.2 Jumpers

Jumper | Purpose
JP1 | TS-64 High-Pass Filter Jumper. Install jumper if no TS-64 is installed, or audio is not passing through attached TS-64.
JP2 | CAS input polarity. Set jumper from L to center pin for active low signaling, or between H and center pin for active high signaling.
JP3 | Audio Equalization jumper. Set between center pin and “D” for discriminator audio, center pin and “n” for normal (already deemphasized) audio.
JP4 | CTCSS input polarity. Set jumper from L to center pin for active low signaling, or between H and center pin for active high signaling.
JP5 | LED Enable jumper. Status LEDs are enabled if jumper is present. Remove for lower-current operation. (Each LED uses about 10 mA when lit.)
JP6 | Initialize/Change Unlock Code jumper. If this jumper is present at controller power-up, then the controller’s non-volatile settings are reset to the factory defaults. This jumper can be installed after the power is up to change the controller’s unlock code. Do not leave this jumper installed after initialization or changing the unlock code, or the controller will initialize on the next power-up.
Copyright 2011-2013, NHRC LLC. All Rights Reserved. | Page 53

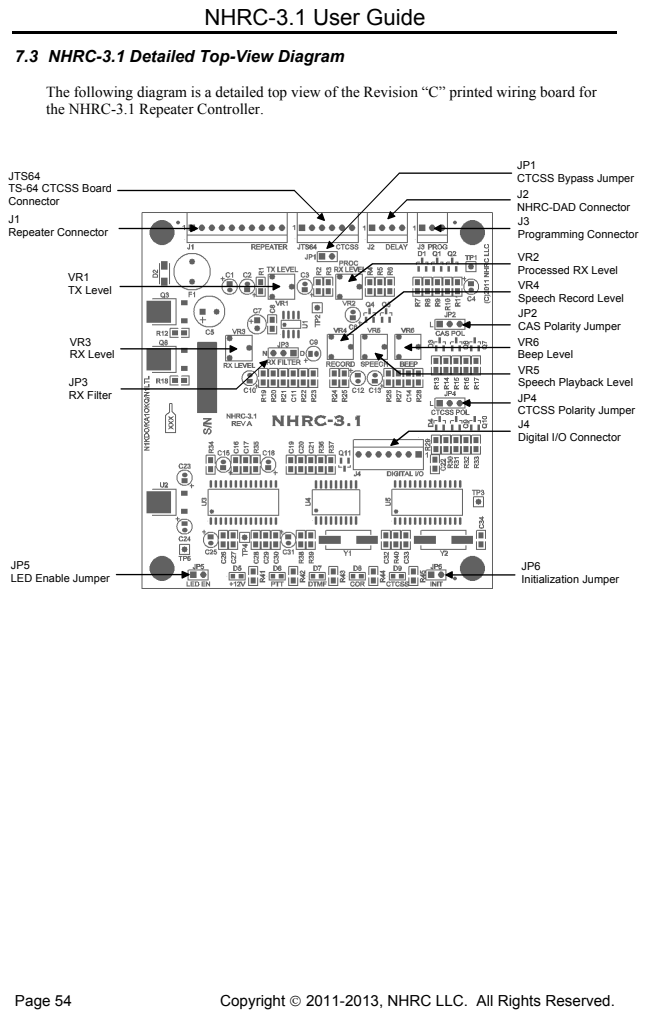
[picture p114: page 60]

7.3 NHRC-3.1 Detailed Top-View Diagram

The following diagram is a detailed top view of the Revision “C” printed wiring board for
the NHRC-3.1 Repeater Controller.

### 8. Schematics

The following two pages are the schematic diagrams for the NHRC-3.1 Repeater Controller.

Copyright 2011-2013, NHRC LLC. All Rights Reserved. | Page 55

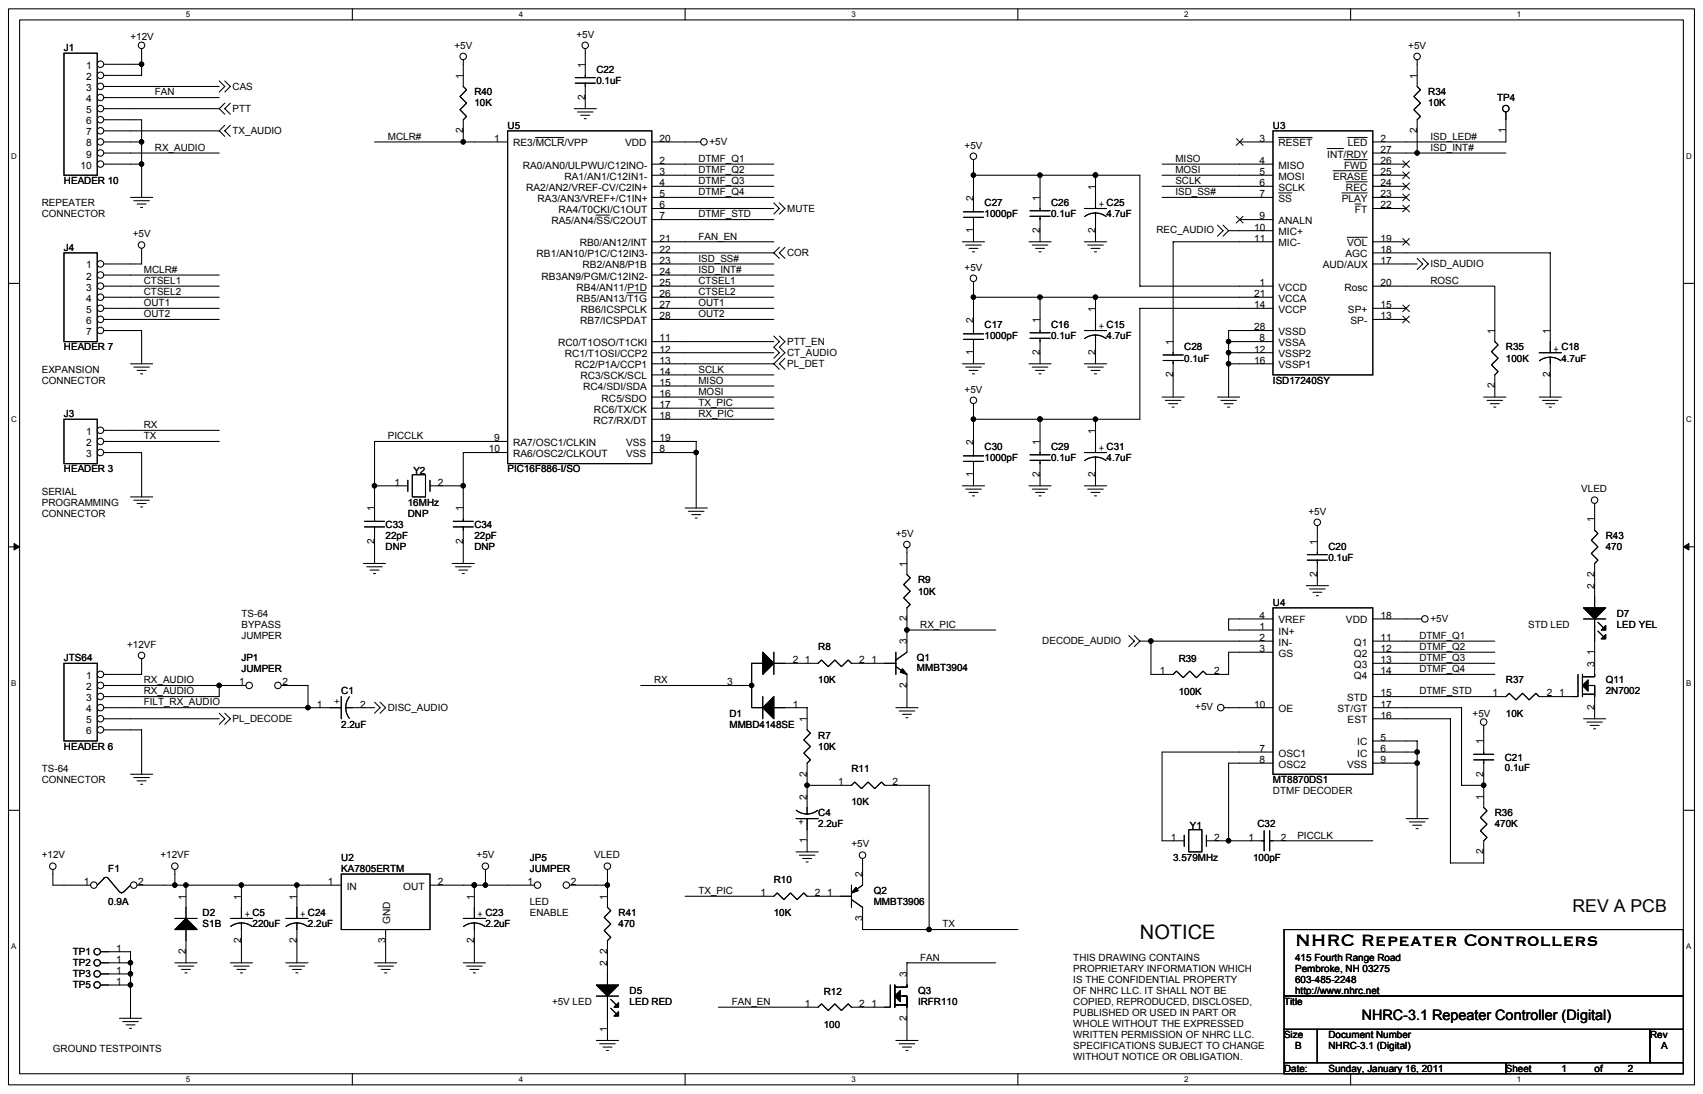
[picture p115: page 62]

+12V J1 3 CAS FAN 4 5 PTT REPEATER CONNECTOR +5V J4 MCLR# 2 CTSEL1 | +5V | +5V RA0/AN0/ULPWU/C12INO- 2 RA1/AN1/C12IN1- 3 RA2/AN2/VREF-CV/C2IN+ 4 RA3/AN3/VREF+/C1IN+ 5 RA4/T0CKI/C1OUT 6 RA5/AN4/SS/C2OUT 7 RB0/AN12/INT 21 RB1/AN10/P1C/C12IN3- 22 RB2/AN8/P1B 23 RB3AN9/PGM/C12IN2- 24 | +5V +5V DTMF_Q1 DTMF_STD COR ISD_SS# ISD_INT# CTSEL1 | U3 MISO MISO 4 | +5V LED 2 RESET 3 FT 22 PLAY 23 REC 24 ERASE 25 FWD 26 INT/RDY 27 | R34 TP4 10K

AUD/AUX 17 AGC 18 VOL 19

R7 10K 1 2 | 0.1uF U4 | VDD 18 D7 +5V STD LED LED YEL DTMF_Q1 REV A PCB

ST/GT 17 OE 10 | VSS 9 OSC2 8 OSC1 7

THIS DRAWING CONTAINS
PROPRIETARY INFORMATION WHICH
IS THE CONFIDENTIAL PROPERTY
OF NHRC LLC. IT SHALL NOT BE
COPIED, REPRODUCED, DISCLOSED,
PUBLISHED OR USED IN PART OR
WHOLE WITHOUT THE EXPRESSED
WRITTEN PERMISSION OF NHRC LLC.
SPECIFICATIONS SUBJECT TO CHANGE
WITHOUT NOTICE OR OBLIGATION.

415 Fourth Range Road
Pembroke, NH 03275
http://www.nhrc.net

Title Title Title | NHRC-3.1 Repeater Controller (Digital) NHRC-3.1 Repeater Controller (Digital) NHRC-3.1 Repeater Controller (Digital)

Size Size Size B B B | Document Number Document Number Document Number NHRC-3.1 (Digital) NHRC-3.1 (Digital) NHRC-3.1 (Digital) | | Rev Rev Rev A A A

Date: Date: Date: Sunday, January 16, 2011 Sunday, January 16, 2011 Sunday, January 16, 2011 | | Sheet Sheet Sheet 1 1 1 of of of 2 2 2

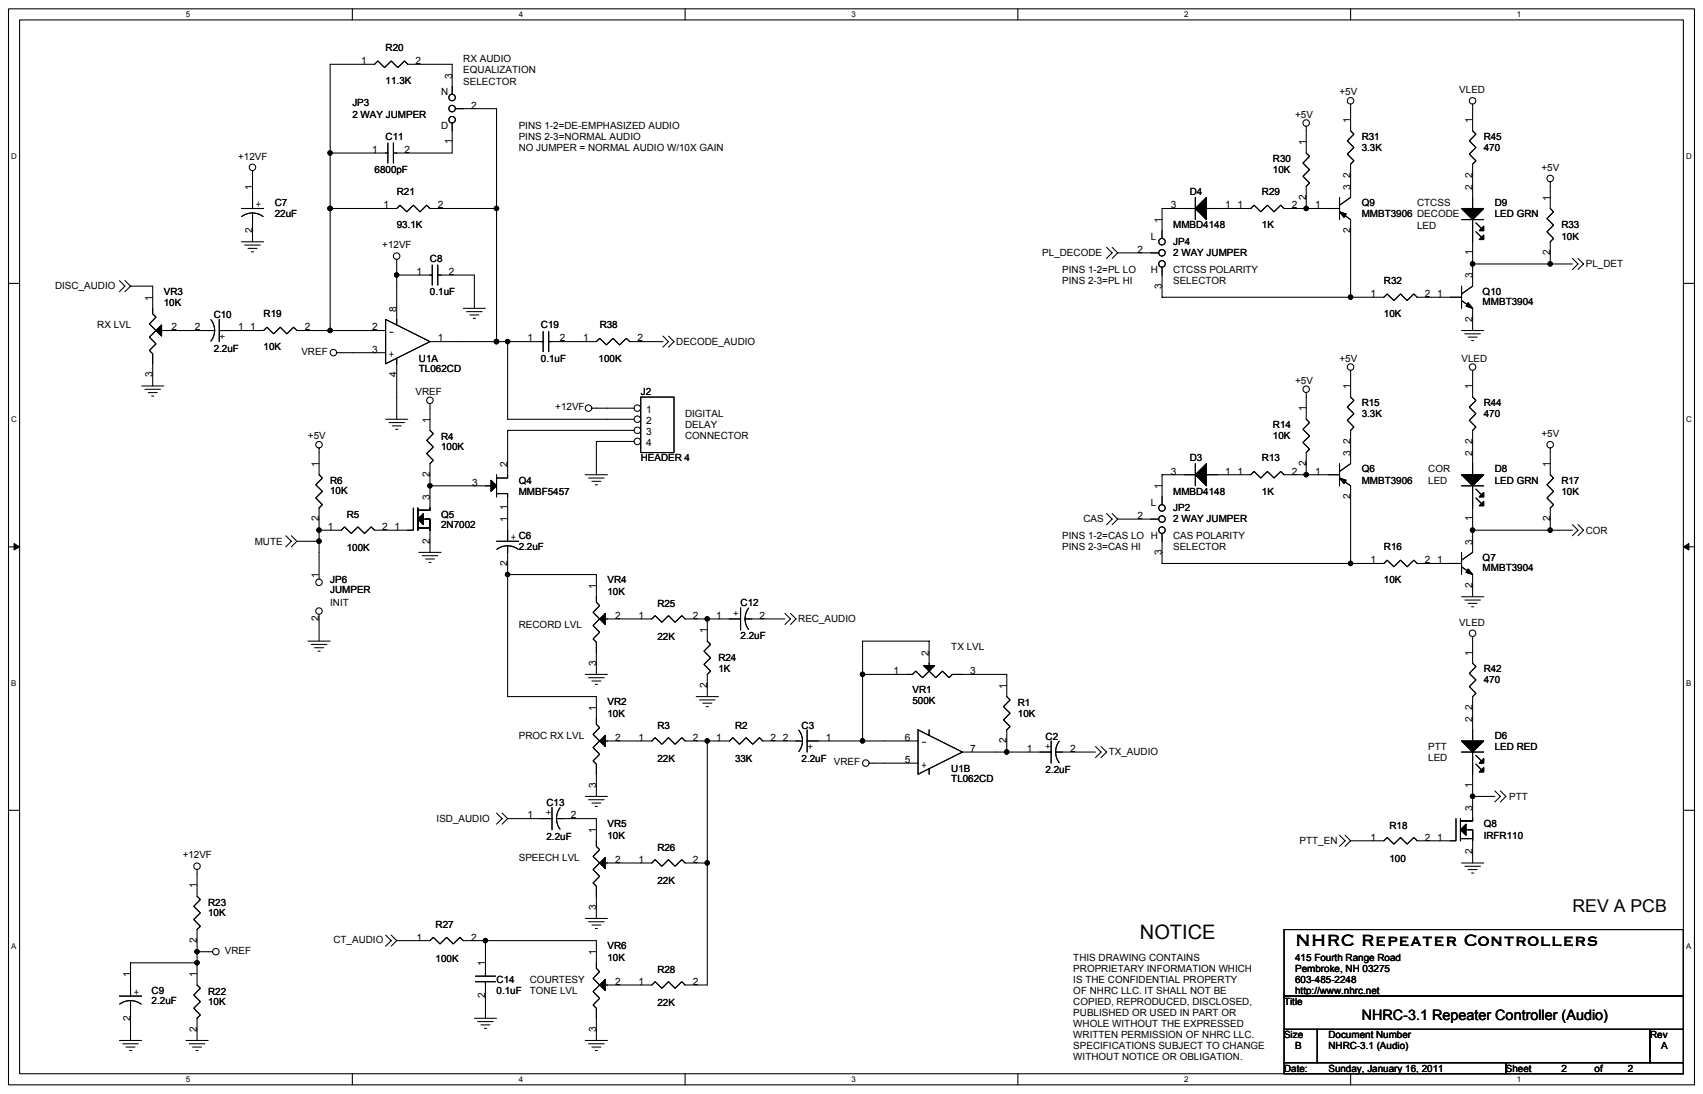
[picture p116: page 63]

R20 1 2 RX AUDIO JP3 2 | +5V +5V R30 10K L PL_DECODE 2 2 WAY JUMPER PINS 1-2=PL LO H CTCSS POLARITY | VLED R31 R45 3.3K 470 MMBT3906 DECODE LED GRN LED R33 10K

PINS 1-2=DE-EMPHASIZED AUDIO
PINS 2-3=NORMAL AUDIO
NO JUMPER = NORMAL AUDIO W/10X GAIN

NHRC Repeater Controllers NHRC Repeater Controllers NHRC Repeater Controllers 415 Fourth Range Road 415 Fourth Range Road 415 Fourth Range Road Pembroke, NH 03275 Pembroke, NH 03275 Pembroke, NH 03275 603-485-2248 603-485-2248 603-485-2248 http://www.nhrc.nethttp://www.nhrc.nethttp://www.nhrc.net

THIS DRAWING CONTAINS
PROPRIETARY INFORMATION WHICH
IS THE CONFIDENTIAL PROPERTY
OF NHRC LLC. IT SHALL NOT BE
COPIED, REPRODUCED, DISCLOSED,
PUBLISHED OR USED IN PART OR
WHOLE WITHOUT THE EXPRESSED
WRITTEN PERMISSION OF NHRC LLC.
SPECIFICATIONS SUBJECT TO CHANGE
WITHOUT NOTICE OR OBLIGATION.

Title Title Title | NHRC-3.1 Repeater Controller (Audio) NHRC-3.1 Repeater Controller (Audio) NHRC-3.1 Repeater Controller (Audio)

Size Size Size B B B | Document Number Document Number Document Number NHRC-3.1 (Audio) NHRC-3.1 (Audio) NHRC-3.1 (Audio) | | Rev Rev Rev A A A

Date: Date: Date: Sunday, January 16, 2011 Sunday, January 16, 2011 Sunday, January 16, 2011 | | Sheet Sheet Sheet 2 2 2 of of of 2 2 2

### 9. Parts List

NHRC-3.1 Repeater Controller Parts List
Revised: January 21, 2010-Revision: A
Reference | Part | Description | Manufacturer | Manufacturer P/N
C1,C2,C3,C4, | 2.2uF | 2.2uF 50V Aluminum | Panasonic | ECE-A1HKG2R2
C6,C9,C10, | | Electrolytic Capacitor
C12,C13,C23,
C24
C5 | 220uF | 220uF 25V Aluminum Electrolytic Capacitor
Panasonic | ECA-1EM221
C7 | 22uF | 22uF 25V Aluminum | Panasonic | ECA-1EM220
| | Electrolytic Capacitor
C8,C14,C19,
C21,C26,C29
0.1uF | 0.1uF 50V Z5U Ceramic Chip
Capacitor
Kemet | C0805C104M5UACTU
C11 | 6800pF | 6800pF 50V X7R Ceramic | Kemet | C0805C682K5RACTU
| | Radial Cap
C15,C18,C25,
C31
4.7uF | 4.7uF 50V Aluminum
Electrolytic Capacitor
Panasonic | ECE-A1HKG4R7
C16,C20,C22, | 0.1uF | 0.1uF 50V Z5U Ceramic Chip | Kemet | C0805C104M5UACTU
C28 | | Cap
C17,C27,C30 | 1000pF | 1000pF 100V X7R Ceramic Chip Capacitor
Kemet | C0805C102K5RACTU
C32 | 100pF | 100pF 50V C0G Ceramic | Kemet | C0805C101J5GACTU
| | Radial Capacitor
C33,C34 | 22pF | 22pF 200V C0G Ceramic Radial Capacitor
Kemet | C315C220J2G5TA
D1 | MMBD4148SE | Dual 100V 200mA SOT-23 GP | Fairchild | MMBD4148SE
| | Diode
D2 | S1B | 100V 1A GP SMT Diode | Fairchild | S1B
D3,D4 | MMBD4148 | 100V 200mA GP Diode | Fairchild | MMBD4148
D5,D6 | LED RED | Red Clear SMD LED | Lite-On | LTST-C170EKT
D7 | LED YEL | Yellow Clear SMD LED | Lite-On | LTST-C170YKT
D8,D9 | LED GRN | Green Clear SMD LED | Lite-On | LTST-C170GKT
F1 | 0.9A | 0.90A PolySwitch | Tyco/Raychem | RUEF090
JP1,JP5,JP6 | JUMPER | 0.1" 2 Position Vertical Pin Header | Molex | 22-28-4020
JP2,JP3,JP4 | 2 WAY JUMPER | 0.1" 3 Position Vertical | Molex | 22-28-4030
| | Pin Header
JTS64 | HEADER 6 | 0.1" 6 Position Vertical Header
Molex | 22-23-2061
J1 | HEADER 10 | 0.1" 10 Position Vertical | Molex | 22-23-2101
| | Header
J2 | HEADER 4 | 0.1" 4 Position Vertical Header
Molex | 22-23-2041
J3 | HEADER 3 | 0.1" 3 Position Vertical | Molex | 22-23-2031
| | Header
J4 | HEADER 7 | 0.1" 7 Position Vertical Header | Molex | 22-23-2071
Q1,Q7,Q10 | MMBT3904 | 60V 200mA GP NPN Transistor | Fairchild | MMBT3904
Q2,Q6,Q9 | MMBT3906 | 40V 200mA SOT-23 PNP Transistor | Fairchild | MMBT3906
Q3,Q8 | IRLR110 | 100V 4.3A N-Channel MOSFET | Vishay/IR | IRLR110TRPBF
Q4 | MMBF5457 | 25V 10mA SOT-23 N-channel JFET | Fairchild | MMBF5457
Q5,Q11 | 2N7002 | 60V 115mA N-Channel MOSFET | Fairchild | 2N7002

Copyright 2011-2013, NHRC LLC. All Rights Reserved.

R1,R6,R7,R8,
R9,R10,R11,
R14,R16,R17,
R19,R22,R23,
R30,R32,R33,
R34,R37,R40
10K | 10K ohm 1/8W 5% Thick Film
Chip Resistor
Panasonic | ERJ-6GEYJ103V
R2 | 33K | 33K ohm 1/8W 5% Thick Film | Panasonic | ERJ-6GEYJ333V
| | Chip Resistor
R3,R25,R26,R
28
22K | 22K ohm 1/8W 5% Thick Film
Chip Resistor
Panasonic | ERJ-6GEYJ223V
R4,R5,R27,R3 | 100K | 100K ohm 1/8W 5% Thick Film | Panasonic | ERJ-6GEYJ104V
5, | | Chip Resistor
R38,R39
R12,R18 | 100 | 100 ohm 1/8W 5% Thick Film Chip Resistor
Panasonic | ERJ-6GEYJ101V
R13,R29 | 1K | 1K ohm 1/8W 5% Thick Film | Panasonic | ERJ-6GEYJ102V
| | Chip Resistor
R15,R31 | 3.3K | 3.3K ohm 1/8W 5% Thick Film Chip Resistor
Panasonic | ERJ-6GEYJ332V
R20 | 11.3K | 11.3K ohm 1/8W 1% Thick | Panasonic | ERJ-6ENF1132V
| | Film Chip Resistor
R21 | 93.1K | 93.1K ohm 1/8W 1% Thick Film Chip Resistor
Panasonic | ERJ-6ENF9312V
R24 | 1K | 1K ohm 1/8W 5% Thick Film | Panasonic | ERJ-6GEYJ102V
| | Chip Resistor
R36 | 470K | 470K ohm 1/8W 5% Thick Film Chip Resistor
Panasonic | ERJ-6GEYJ474V
R41 | 1.2K | 1.2K ohm 1/8W 5% Thick Film | Panasonic | ERJ-6GEYJ122V
| | Chip Resistor
R42,R43,R44,
R45
| 470 | 470 ohm 1/8W 5% Thick Film Chip Resistor | Panasonic | ERJ-6GEYJ471V
TP1 | TESTPOINT | Testpoint
U1 | TL062CD | Dual Low Power JFET OpAmp | ST Microelectronics | TL062CD
U2 | KA7805ERTM | 5V 1A Linear Voltage | Fairchild | KA7805ERTM
| | Regulator
U3 | ISD17240SY | 240 Second Voice Record/Playback IC | Nuvoton | ISD17240SY
U4 | MT8870DS1 | DTMF Decoder | Zarlink | MT8870DS1
U5 | PIC16F886-I/SO | 8K X 14 FLASH PIC Microcontroller | Microchip Technology | PIC16F886-I/SO
VR1 | 500K | 500K 6mm Carbon Trimmer | Panasonic | EVN-D8AA03B55
| | Potentiometer
VR2,VR3,VR4,
VR5,VR6
10K | 10K 6mm Carbon Trimmer
Potentiometer
Panasonic | EVN-D8AA03B14
Y1 | 3.579MHz | 3.579545MHz 17pF HC-49USX | ECS | ECS-35-17-5PX-TR
| | Crystal
Y2 | 16MHz | 16.000MHz 20pF HC-49US Crystal
ECS | ECS-160-20-5PX-TR

Copyright 2011-2013, NHRC LLC. All Rights Reserved.

### 10. Electrical Specifications

Input voltage – minimum | 10 VDC
Input voltage – nomimal | 13.8 VDC
Input voltage – maximum | 16 VDC
Current draw – idle, LEDs disabled | < 20 mA
Current draw – recording, LEDs enabled (worst case) | < 60 mA
Audio Input impedance | aproximately 10 K ohms
Audio Input requirements | 1Vp-p nominal.
Audio Output Impedance | aproximately 70 ohms
Audio output | variable, up 3V p-p (for 1v input)
PTT / Fan control output: | Active low closure to ground, 1amp maximum
CAS / CTCSS input, jumpered active high | off: less than 0.2 volts on: greater than 3 volts, less than 16 volts
CAS / CTCSS input, jumpered active low | off: greater than 3 volts, less than 16 volts on: less than 0.2 volts
Receiver audio equalization, jumper “N” selected | flat
Receive audio equalization, jumper “D” selected | -6dB/octave

Copyright 2011-2013, NHRC LLC. All Rights Reserved.

### 11. NHRC LLC Limited Warranty

NHRC LLC warrants that its assembled and tested products will be free from defects in materials and workmanship for a period of NINETY (90) DAYS from the date of shipment. During this period, NHRC LLC will repair or replace, at our option, any of our products that fail as a result of defects in materials or workmanship. NHRC LLC’s liability will be limited to parts, labor, and return shipping for this period.

NHRC LLC warrants that its kit products will contain components that are free from defects in materials and workmanship for a period of THIRTY (30) DAYS from the date of shipment. During this period, NHRC will replace any of the components in a kit ONCE. Subsequent replacement of any component any subsequent times is completely at the discretion of NHRC LLC, and may require the complete return of the kit.

In no case will NHRC LLC be liable for products damaged by improper wiring (including, but not limited to, over-voltage or application of reverse polarity), physical damage resulting from misuse and/or abuse of the product, neglect, or acts of God (lightning, floods, etc.).

Unauthorized modification of a NHRC product will void the warranty on the modified product.

In no case will NHRC LLC be liable for any direct, consequential, or incidental loss or damage resulting from the use or inability to use any of its products.

Some states or countries do not allow the limitation of incidental or consequential damages, so the paragraph above may not apply to you.

This warranty applies only to the original purchaser of the product; proof of purchase must be presented to receive warranty service.

Page 62 | Copyright 2001-2013, NHRC LLC. All Rights Reserved.

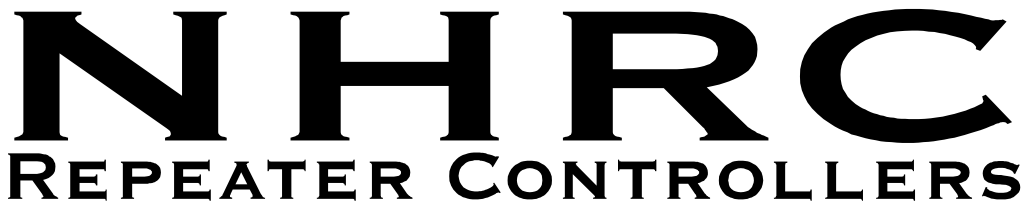
[picture p117: page 70]
