nhrc-net/NHRC_Repeater_Controllers/web/nhrc-m2sc/NHRC-M2SC_Manual_Rev_C.pdf

# CARD EDGE FINGERS

# INSTALL JUMPERS TO ENABLE DESIRED SIGNALS

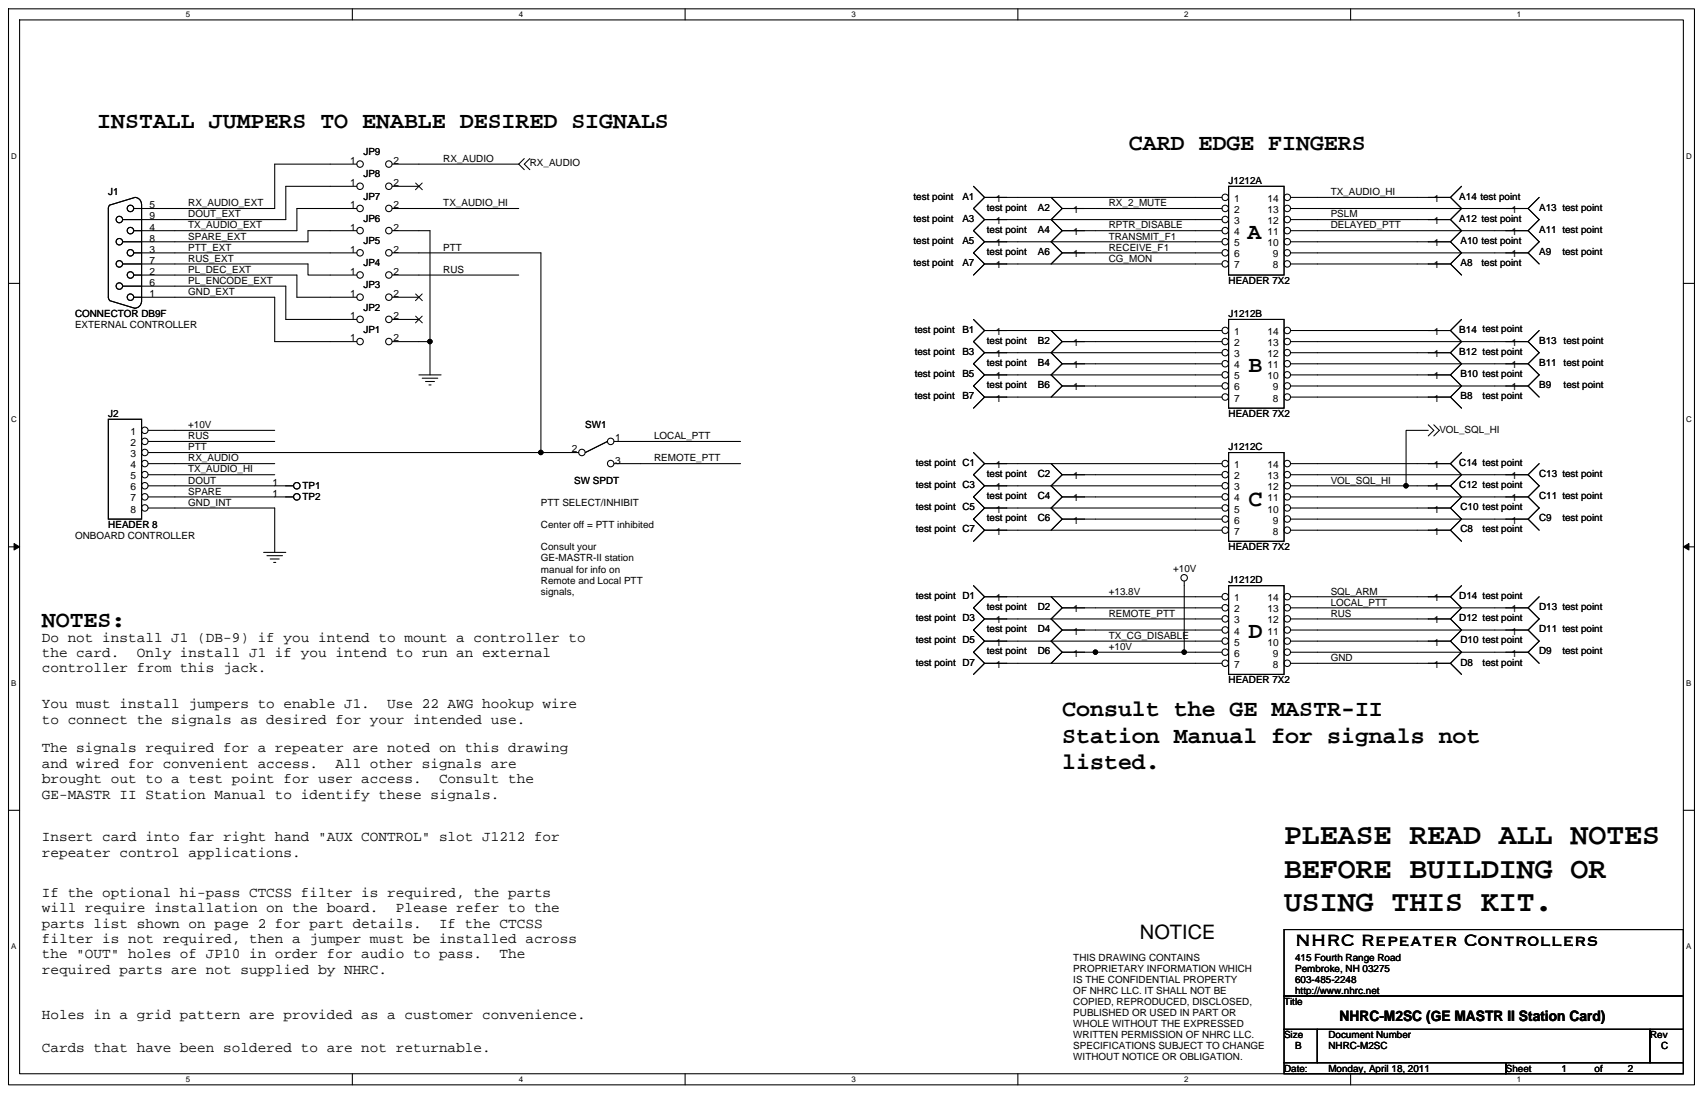
[picture p120: page 1]

Center off = PTT inhibited

Consult your
GE-MASTR-II station
manual for info on
Remote and Local PTT
signals,

NOTES:
Do not install J1 (DB-9) if you intend to mount a controller to
the card. Only install J1 if you intend to run an external
controller from this jack.

You must install jumpers to enable J1. Use 22 AWG hookup wire
to connect the signals as desired for your intended use.
The signals required for a repeater are noted on this drawing
and wired for convenient access. All other signals are
brought out to a test point for user access. Consult the
GE-MASTR II Station Manual to identify these signals.

Consult the GE MASTR-II
Station Manual for signals not
listed.

PLEASE READ ALL NOTES
BEFORE BUILDING OR

Insert card into far right hand "AUX CONTROL" slot J1212 for
repeater control applications.

USING THIS KIT. If the optional hi-pass CTCSS filter is required, the parts will require installation on the board. Please refer to the
parts list shown on page 2 for part details. If the CTCSS
filter is not required, then a jumper must be installed across
the "OUT" holes of JP10 in order for audio to pass. The
required parts are not supplied by NHRC.

THIS DRAWING CONTAINS
PROPRIETARY INFORMATION WHICH
IS THE CONFIDENTIAL PROPERTY
OF NHRC LLC. IT SHALL NOT BE
COPIED, REPRODUCED, DISCLOSED,
PUBLISHED OR USED IN PART OR
WHOLE WITHOUT THE EXPRESSED
WRITTEN PERMISSION OF NHRC LLC.
SPECIFICATIONS SUBJECT TO CHANGE
WITHOUT NOTICE OR OBLIGATION.

415 Fourth Range Road
Pembroke, NH 03275
http://www.nhrc.net
Title

NHRC-M2SC (GE MASTR II Station Card)

Holes in a grid pattern are provided as a customer convenience.

Size Size Size B B B | Document Number Document Number Document Number NHRC-M2SC NHRC-M2SC NHRC-M2SC | Rev Rev Rev C C C

Cards that have been soldered to are not returnable.

Date: Date: Date: Monday, April 18, 2011 Monday, April 18, 2011 Monday, April 18, 2011 | Sheet Sheet Sheet 1 1 1 of of of 2 2 2

# OPTIONAL HI-PASS CTCSS FILTER

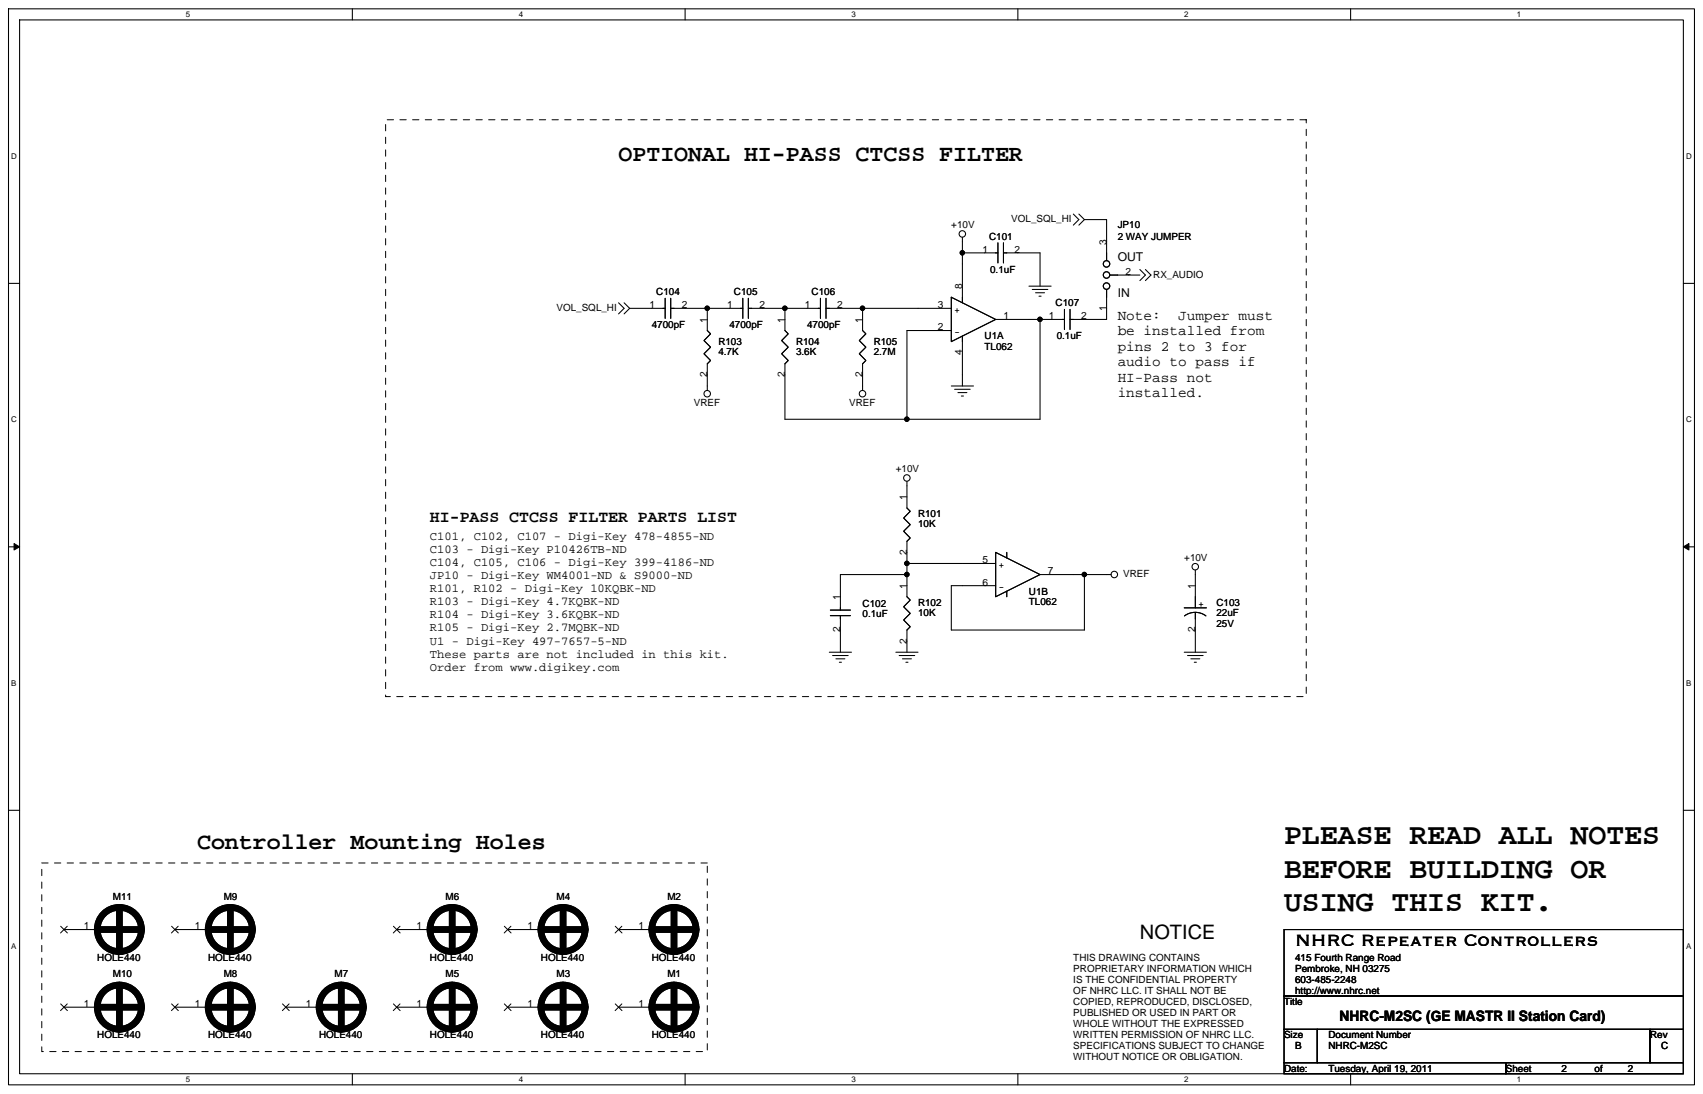
[picture p121: page 2]

HI-PASS CTCSS FILTER PARTS LIST
C101, C102, C107 - Digi-Key 478-4855-ND
C103 - Digi-Key P10426TB-ND
C104, C105, C106 - Digi-Key 399-4186-ND
JP10 - Digi-Key WM4001-ND & S9000-ND
R101, R102 - Digi-Key 10KQBK-ND
R103 - Digi-Key 4.7KQBK-ND
R104 - Digi-Key 3.6KQBK-ND
R105 - Digi-Key 2.7MQBK-ND
U1 - Digi-Key 497-7657-5-ND
These parts are not included in this kit.
Order from www.digikey.com

PLEASE READ ALL NOTES
BEFORE BUILDING OR
USING THIS KIT.

THIS DRAWING CONTAINS
PROPRIETARY INFORMATION WHICH
IS THE CONFIDENTIAL PROPERTY
OF NHRC LLC. IT SHALL NOT BE
COPIED, REPRODUCED, DISCLOSED,
PUBLISHED OR USED IN PART OR
WHOLE WITHOUT THE EXPRESSED
WRITTEN PERMISSION OF NHRC LLC.
SPECIFICATIONS SUBJECT TO CHANGE
WITHOUT NOTICE OR OBLIGATION.

415 Fourth Range Road
Pembroke, NH 03275
http://www.nhrc.net
Title

NHRC-M2SC (GE MASTR II Station Card)

Size Size Size B B B | Document Number Document Number Document Number NHRC-M2SC NHRC-M2SC NHRC-M2SC | Rev Rev Rev C C C

Date: Date: Date: Tuesday, April 19, 2011 Tuesday, April 19, 2011 Tuesday, April 19, 2011 | Sheet Sheet Sheet 2 2 2 of of of 2 2 2
