nhrc-net/NHRC_Repeater_Controllers/noisegen-for-tester/docs/pink-noise.PDF

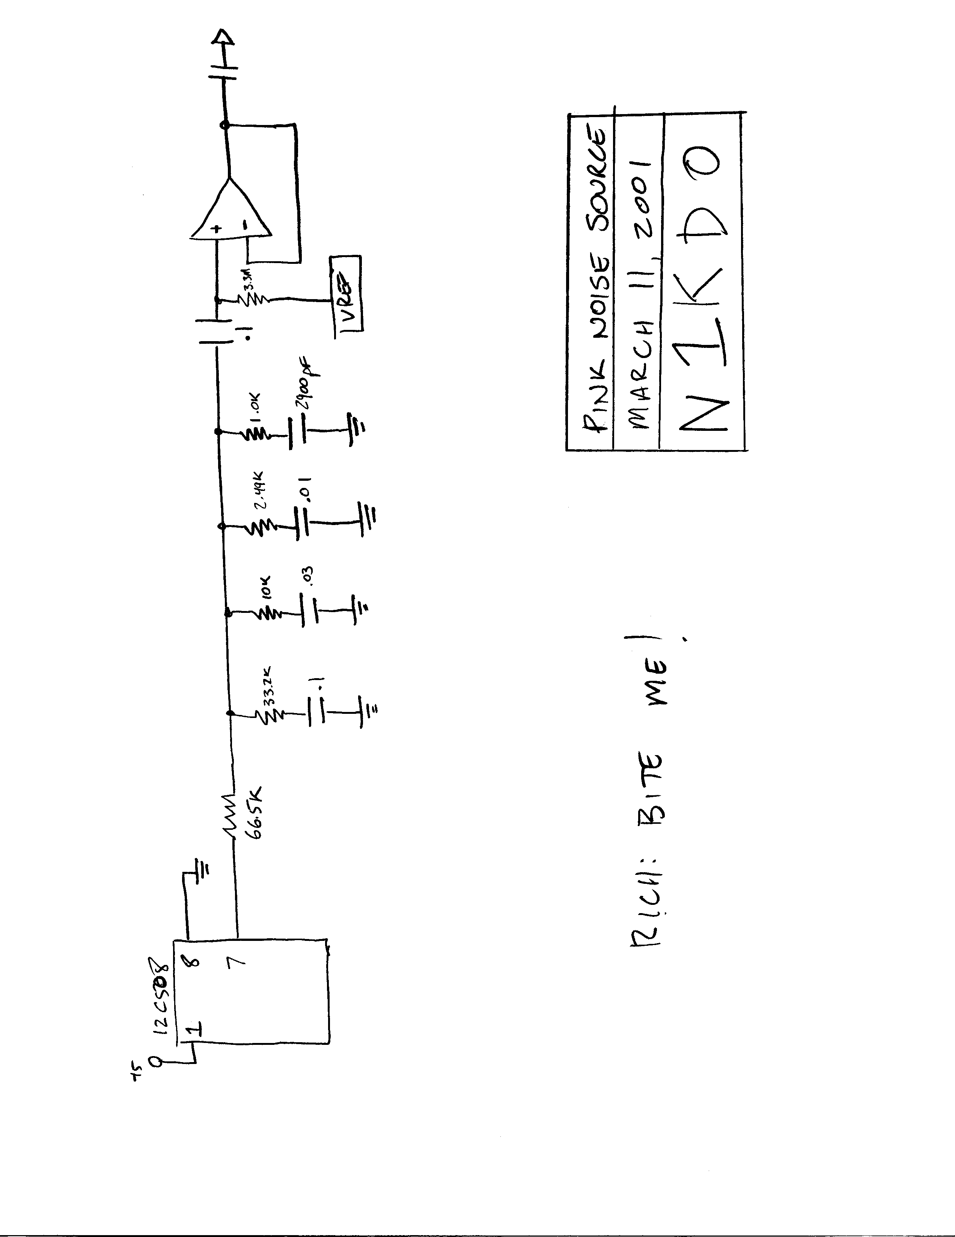
[picture p125: page 1]
