nhrc-net/NHRC_Repeater_Controllers/nhrc-10 programmer/Programmer/Release/BuildLog.htm

Build Log

| | ------- Build started: Project: Programmer, Configuration: Release|Win32 -------

Command Lines

Creating command line "rc.exe /d "NDEBUG" /l 0x409 /fo".\Release/Programmer.res" ".\Programmer.rc""
Creating temporary file "c:\Nhrc\nhrc-10 programmer\Programmer\Release\RSP000001.rsp" with contents
[
/OUT:".\Release/Programmer.exe" /INCREMENTAL:NO /NOLOGO /PDB:".\Release/Programmer.pdb" /SUBSYSTEM:WINDOWS /MACHINE:X86 kernel32.lib user32.lib gdi32.lib winspool.lib comdlg32.lib advapi32.lib shell32.lib ole32.lib oleaut32.lib uuid.lib odbc32.lib odbccp32.lib
".\Release\Programmer.obj"
".\Release\Programmer.res"
".\Release\StdAfx.obj"
]
Creating command line "link.exe @"c:\Nhrc\nhrc-10 programmer\Programmer\Release\RSP000001.rsp""

Output Window

| | Compiling resources... Linking...

Results

| | Build log was saved at "file://c:\Nhrc\nhrc-10 programmer\Programmer\Release\BuildLog.htm" Programmer - 0 error(s), 0 warning(s)
