nhrc-net/NHRC_Repeater_Controllers/dsub-7000/schematic/dsub-7000.pdf

# BROWN

# GREEN

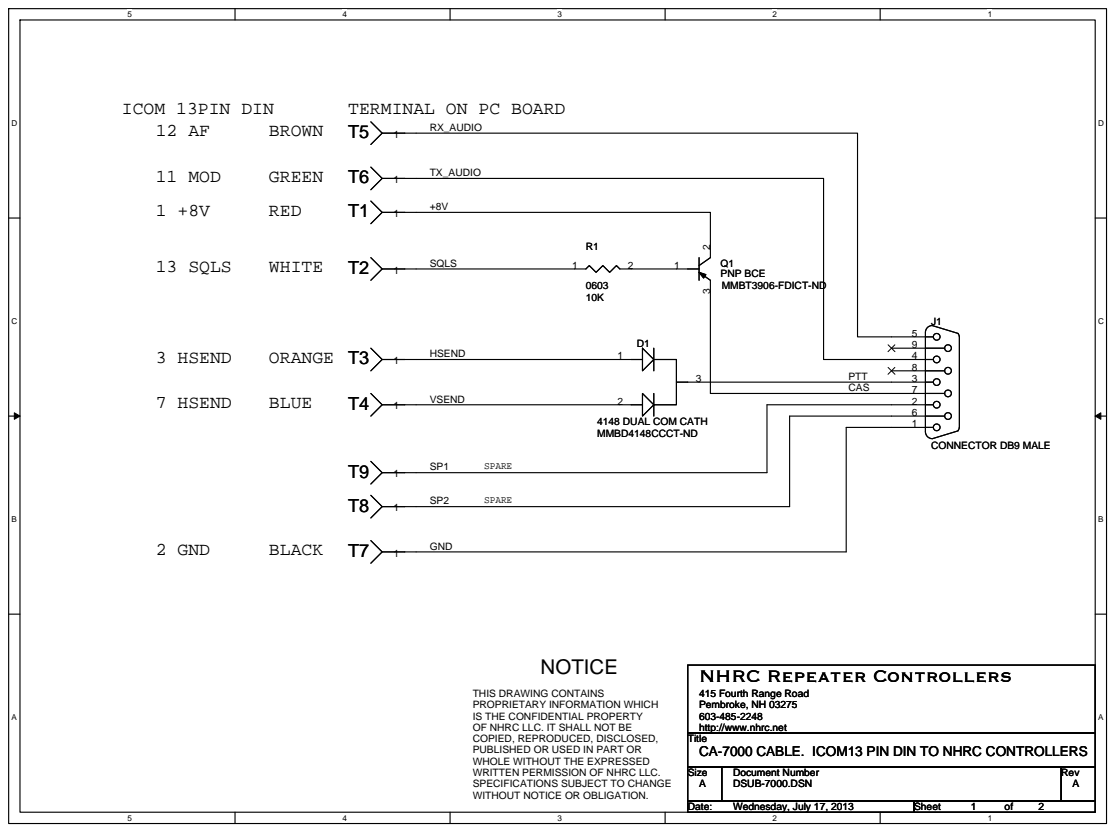
[picture p126: page 1]
SQLS; HSEND; VSEND; CAS; PTT; RX_AUDIO; TX_AUDIO; GND; SPARE; RED; WHITE; ORANGE; BLUE; BLACK; NOTICE; ICOM 13PIN DIN; TERMINAL ON PC BOARD; 11 MOD; 13 SQLS; 3 HSEND; 7 HSEND; 2 GND; Q1 PNP BCE MMBT3906-FDICT-ND; 4148 DUAL COM CATH MMBD4148CCCT-ND; CONNECTOR DB9 MALE

NHRC Repeater Controllers

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

415 Fourth Range Road
Pembroke, NH 03275
http://www.nhrc.net
Title
CA-7000 CABLE. ICOM13 PIN DIN TO NHRC CONTROLLERS

Size Size Size A A A | Document Number Document Number Document Number DSUB-7000.DSN DSUB-7000.DSN DSUB-7000.DSN | Rev Rev Rev A A A

Date: Date: Date: Wednesday, July 17, 2013 Wednesday, July 17, 2013 Wednesday, July 17, 2013 | Sheet Sheet Sheet 1 1 1 of of of 2 2 2
