nhrc-net/NHRC_Repeater_Controllers/nhrc-4/hw/schematic.pdf

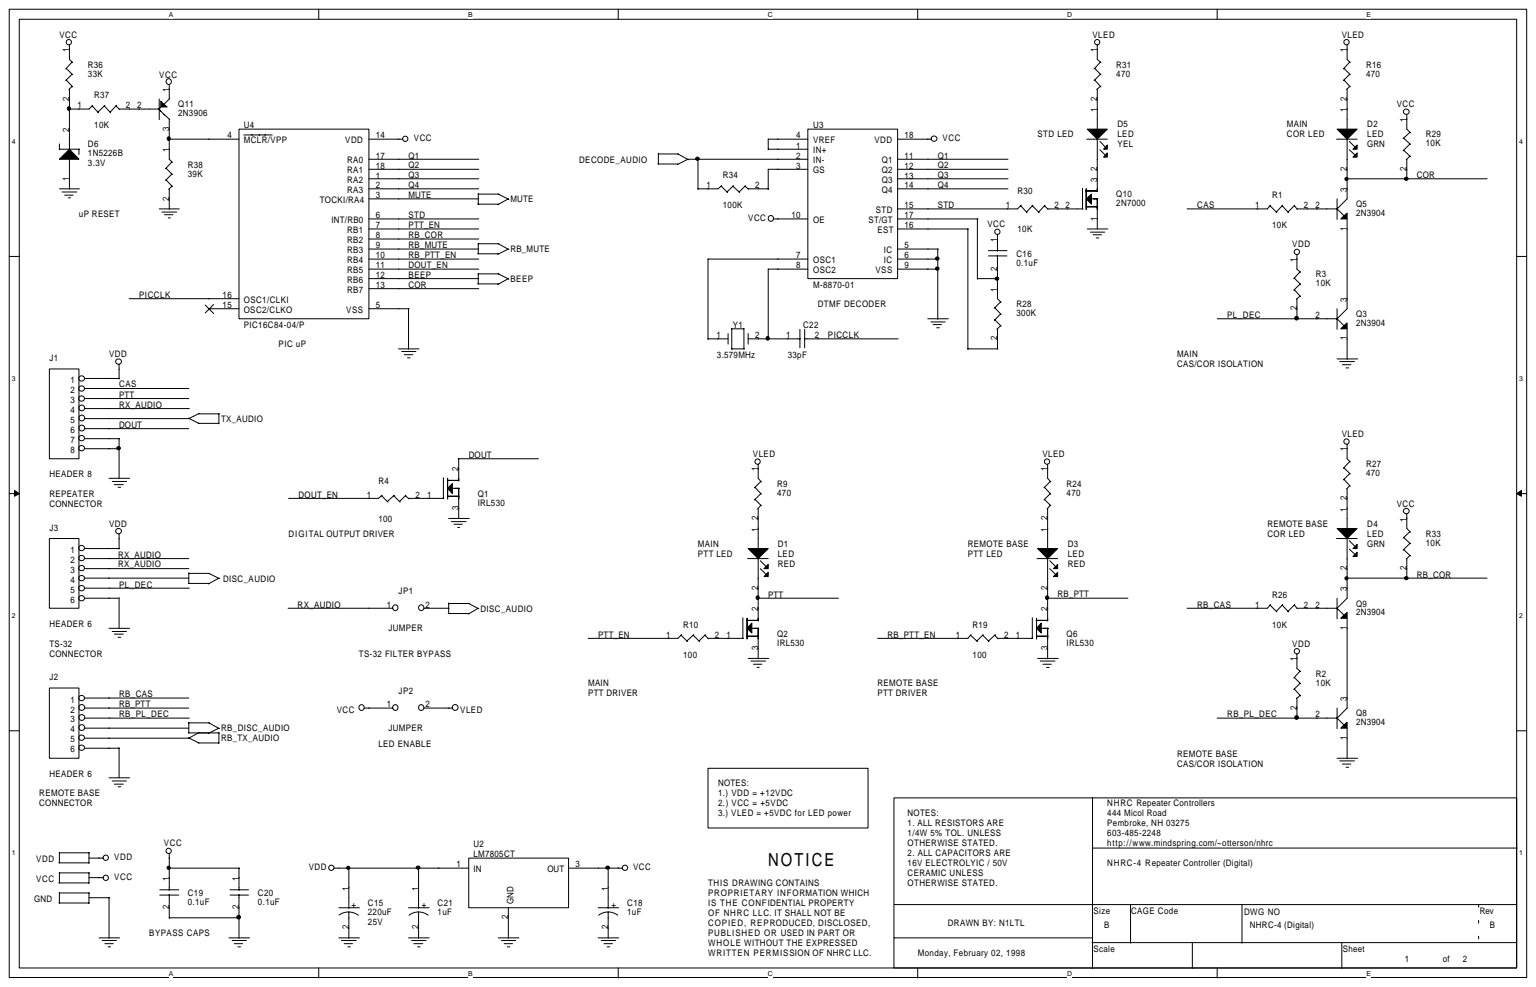
[picture p127: page 1]

VCC VCC uP RESET | VDD 14 VCC RA0 17 Q1 RA1 18 Q2 RA2 1 Q3 RA3 2 Q4 TOCKI/RA4 3 MUTE MUTE INT/RB0 6 STD RB1 7 PTT_EN RB2 8 RB_COR RB3 9 RB_MUTE RB_MUTE | U3 100K STD 15 ST/GT 17 OE 10 | VLED R31 470 D5 STD LED LED VCC YEL Q1 | VLED R16 470 COR LED LED GRN 1 2 2 Q5 2N3904

NOTES: 1. ALL RESISTORS ARE 1/4W 5% TOL. UNLESS OTHERWISE STATED. 2. ALL CAPACITORS ARE 16V ELECTROLYIC / 50V CERAMIC UNLESS OTHERWISE STATED. | | NHRC Repeater Controllers 444 Micol Road Pembroke, NH 03275 603-485-2248 http://www.mindspring.com/~otterson/nhrc

NHRC-4 Repeater Controller (Digital)

THIS DRAWING CONTAINS
PROPRIETARY INFORMATION WHICH
IS THE CONFIDENTIAL PROPERTY
OF NHRC LLC. IT SHALL NOT BE
COPIED, REPRODUCED, DISCLOSED,
PUBLISHED OR USED IN PART OR
WHOLE WITHOUT THE EXPRESSED
WRITTEN PERMISSION OF NHRC LLC.

DRAWN BY: N1LTL | Size B | CAGE Code | | DWG NO NHRC-4 (Digital) | Rev B

Monday, February 02, 1998 | Scale | | Sheet 1 2 of

## NOTE:

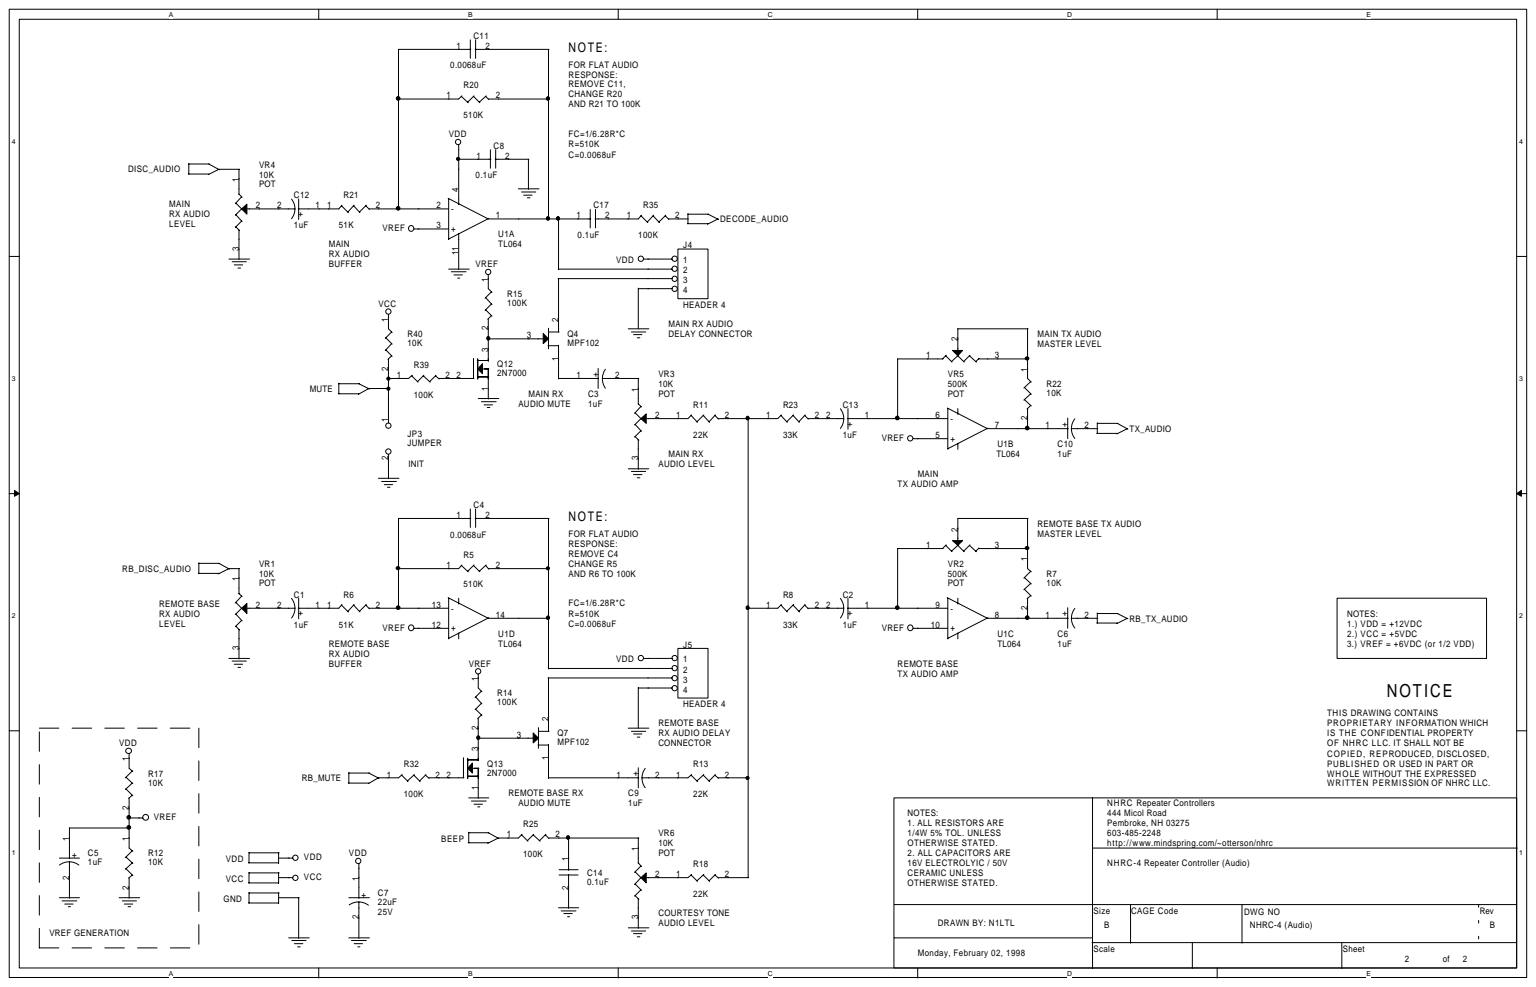
[picture p128: page 2]

VR4 C12 MAIN 2 RX AUDIO LEVEL 1uF | C11 | R35 1 2 DECODE_AUDIO 100K J4

REMOTE BASE TX AUDIO
MASTER LEVEL

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

NHRC Repeater Controllers
444 Micol Road
Pembroke, NH 03275
http://www.mindspring.com/~otterson/nhrc
NHRC-4 Repeater Controller (Audio)
