nhrc-net/NHRC_Repeater_Controllers/nhrc-micro/docs/cable schematic.pdf

WARNING: Reverse power application will destroy your controller and void your warranty.

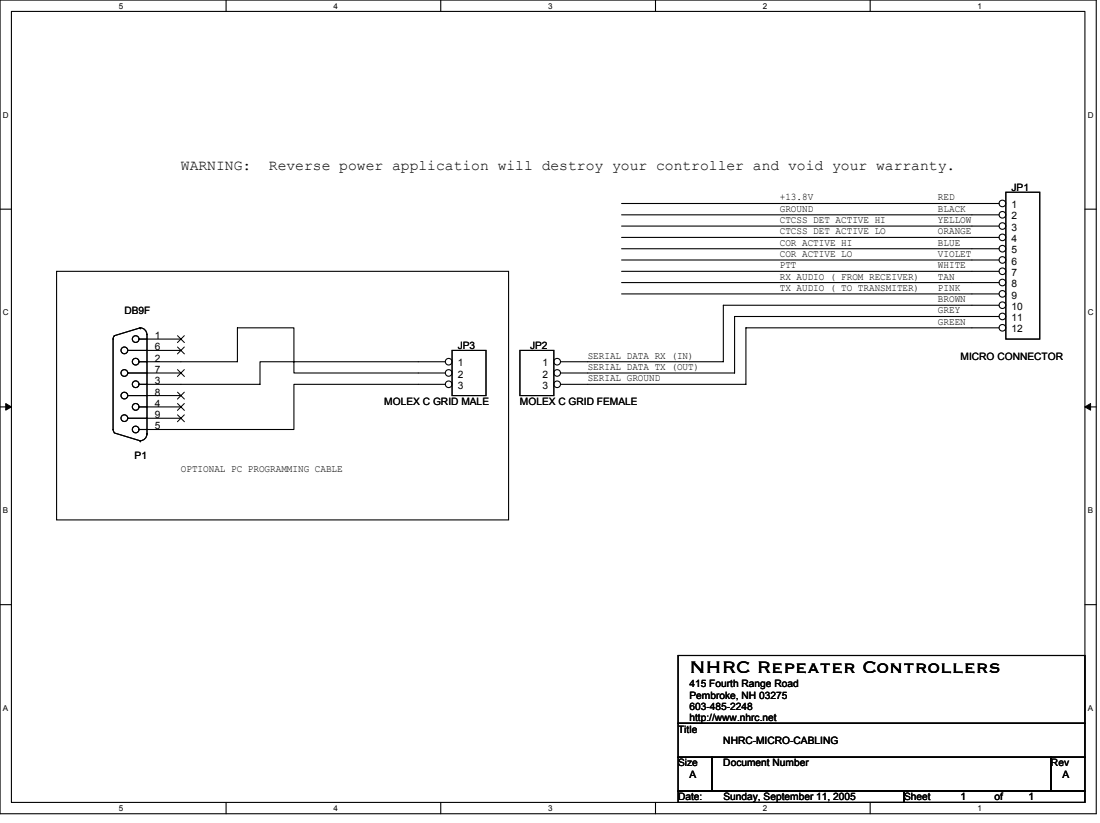
[picture p130: page 1]
RED BLACK YELLOW ORANGE BLUE VIOLET WHITE TAN PINK BROWN GREY GREEN; MICRO CONNECTOR 1; MOLEX C GRID FEMALE

GROUND
CTCSS DET ACTIVE HI
CTCSS DET ACTIVE LO
COR ACTIVE HI
COR ACTIVE LO
PTT
RX AUDIO ( FROM RECEIVER)
TX AUDIO ( TO TRANSMITER)

SERIAL DATA RX (IN)
SERIAL DATA TX (OUT)
SERIAL GROUND

MOLEX C GRID MALE

OPTIONAL PC PROGRAMMING CABLE

NHRC Repeater Controllers

415 Fourth Range Road
Pembroke, NH 03275
http://www.nhrc.net
Title

NHRC-MICRO-CABLING

Size Size Size A A A | Document Number Document Number Document Number | Rev Rev Rev A A A

Date: Date: Date: Sunday, September 11, 2005 Sunday, September 11, 2005 Sunday, September 11, 2005 | Sheet Sheet Sheet 1 1 1 of of of 1 1 1
