nhrc-net/NHRC_Repeater_Controllers/nhrc-tester/hw/tester-schem-101901.pdf

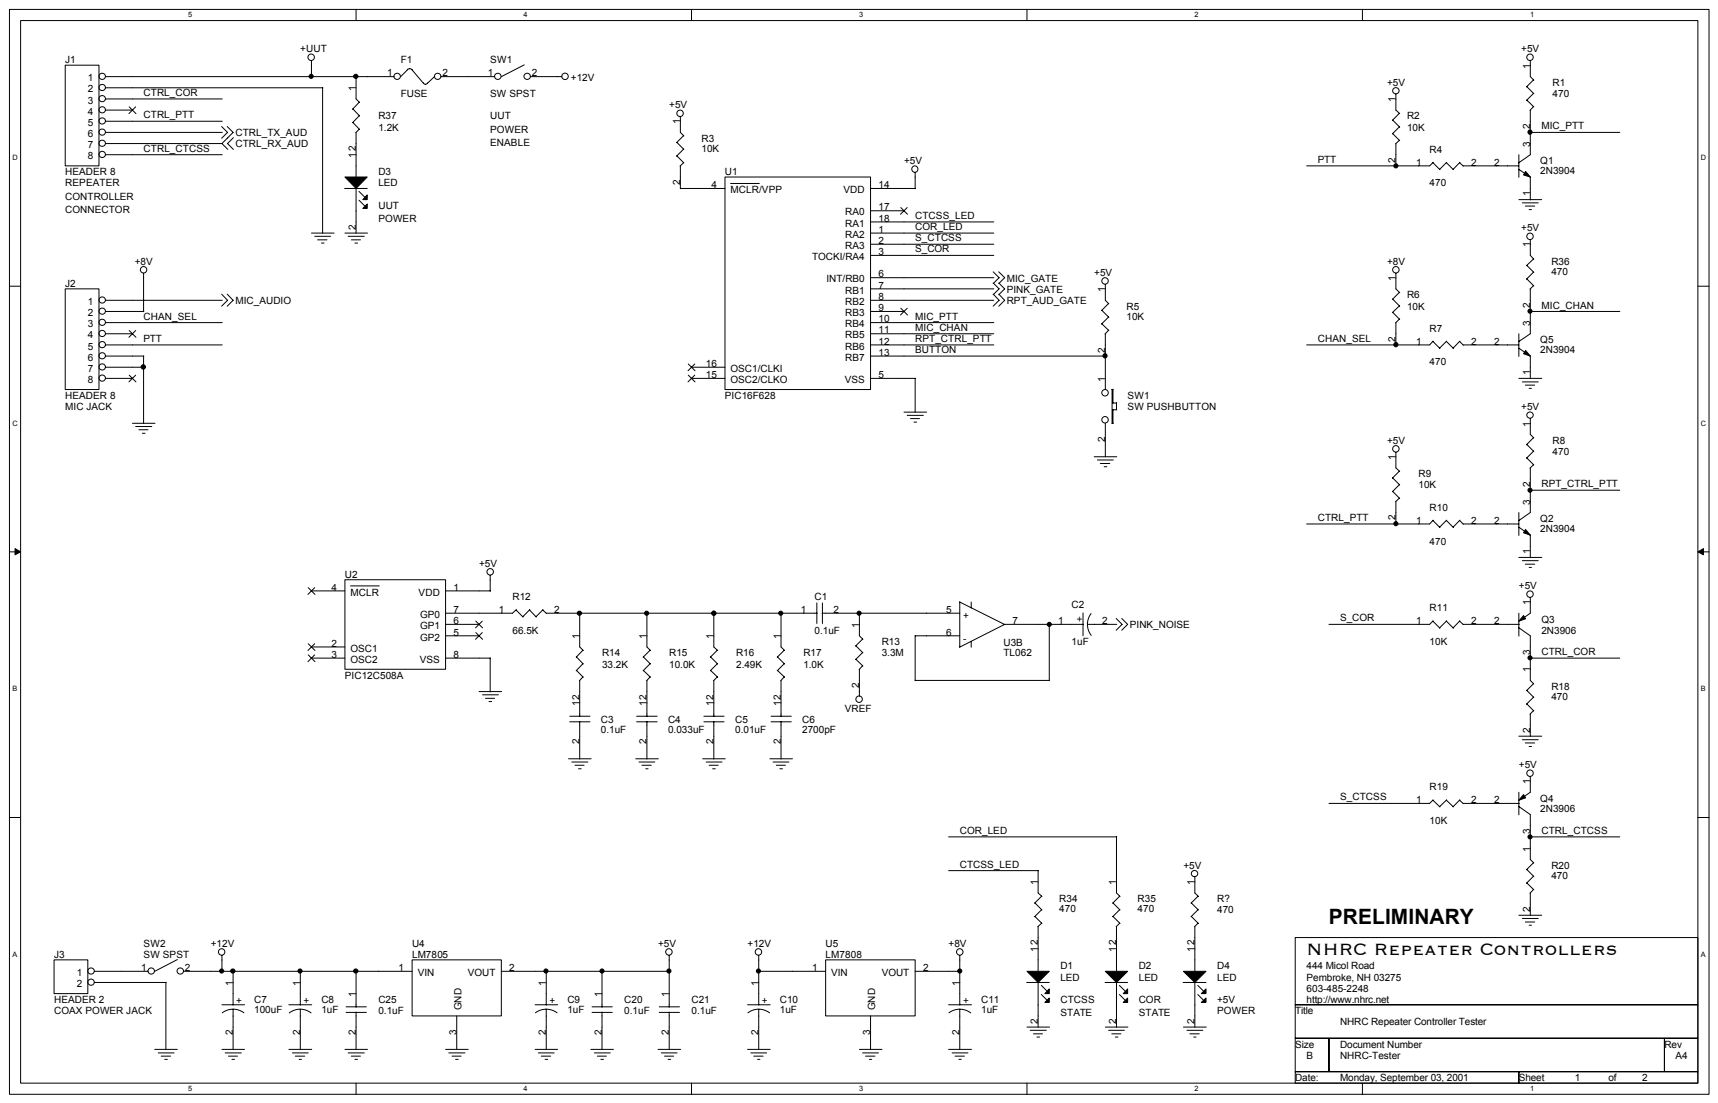
[picture p131: page 1]

+UUT J1 +8V | | F1 SW1 1 2 1 2 +12V FUSE SW SPST +5V R37 UUT ENABLE UUT POWER | R3 10K +5V U1 RA0 CTCSS_LED RA1 COR_LED RA2 S_CTCSS RA3 S_COR TOCKI/RA4 INT/RB0 MIC_GATE | PTT +5V | +5V +8V | +5V R1 470 2N3904 +5V R36 470

SW2 +12V J3 SW SPST | +5V LM7805 0.1uF 1uF 0.1uF | COR_LED CTCSS_LED +12V U5 +8V LM7808 C21 + C11 0.1uF 1uF | R34 470 | R35 R? 470 470 | R20 470

NHRC Repeater Controllers 444 Micol Road Pembroke, NH 03275 603-485-2248 http://www.nhrc.net

Title NHRC Repeater Controller Tester

Size B | Document Number NHRC-Tester | | Rev A4

Date: Monday, September 03, 2001 | | Sheet 1 of 2

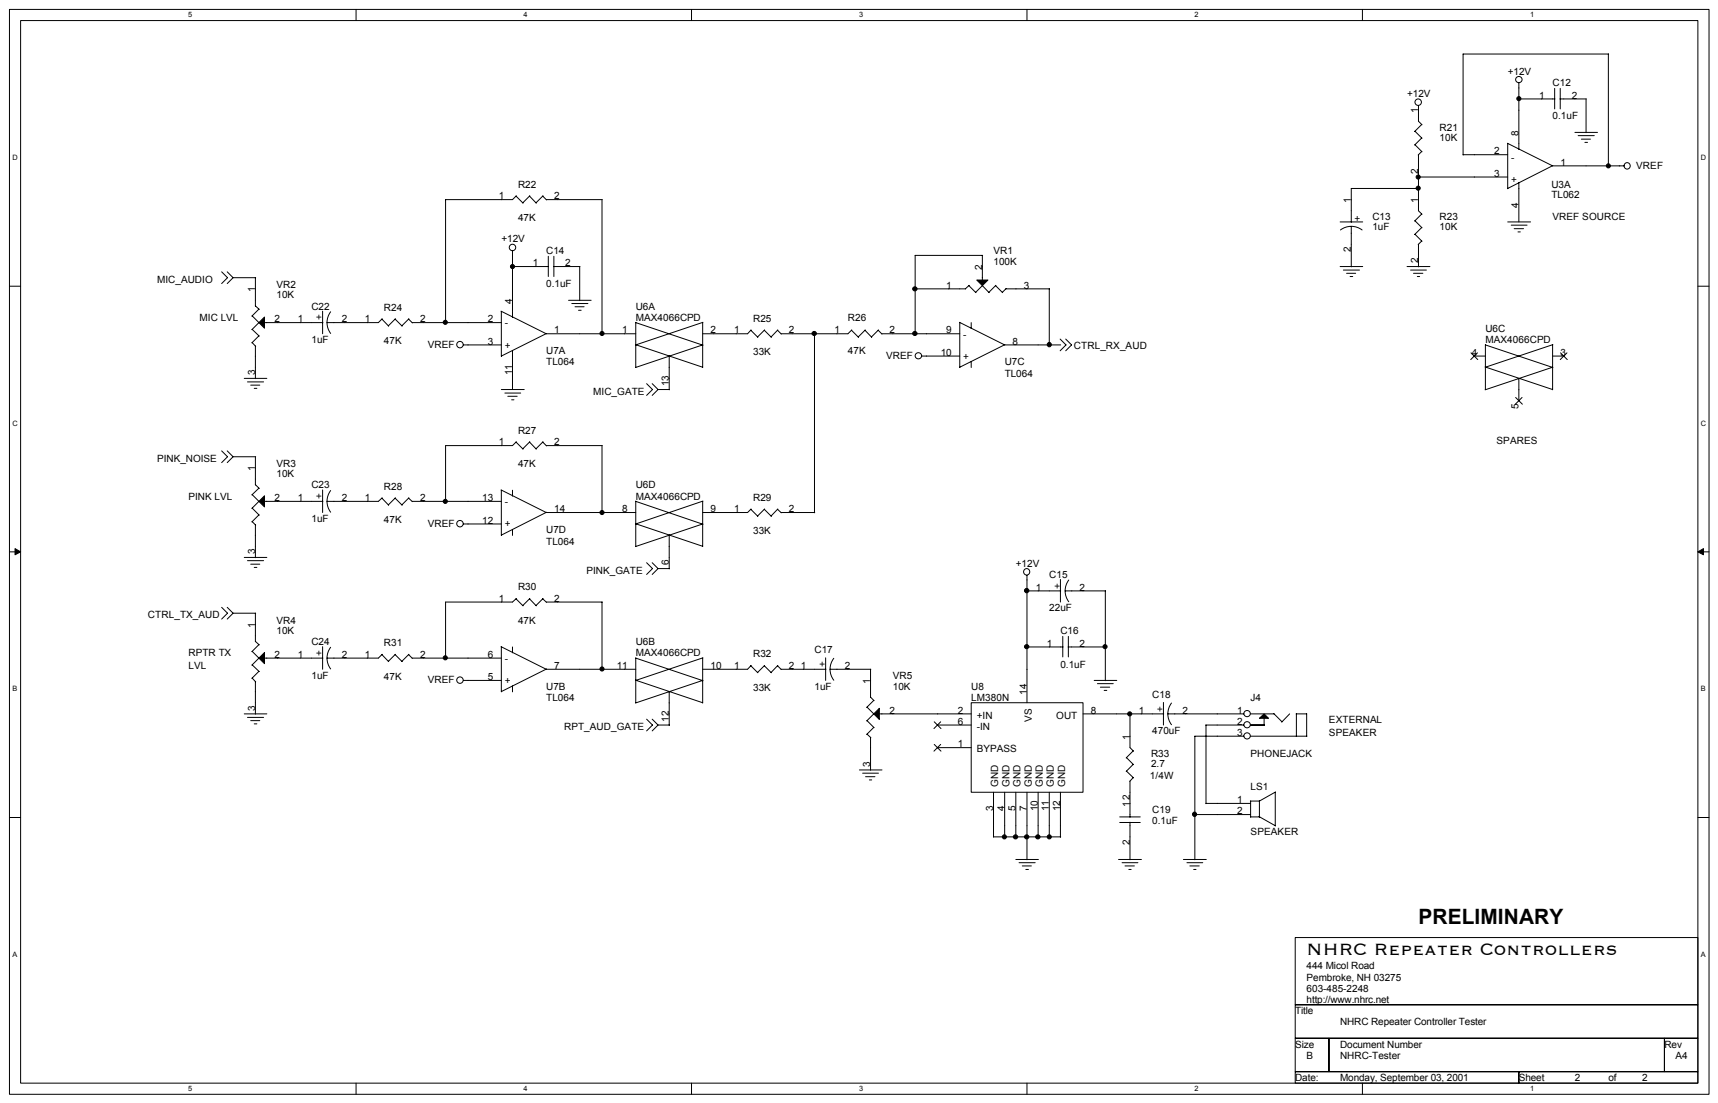
[picture p132: page 2]

PRELIMINARY

NHRC Repeater Controllers 444 Micol Road Pembroke, NH 03275 603-485-2248 http://www.nhrc.net

Title NHRC Repeater Controller Tester

Size B | Document Number NHRC-Tester | | Rev A4

Date: Monday, September 03, 2001 | | Sheet 2 of 2
