nhrc-net/NHRC_Repeater_Controllers/MASTR II/base station card/schematic/ge-card.pdf

# CARD EDGE FINGERS

# INSTALL JUMPERS TO ENABLE DESIRED SIGNALS

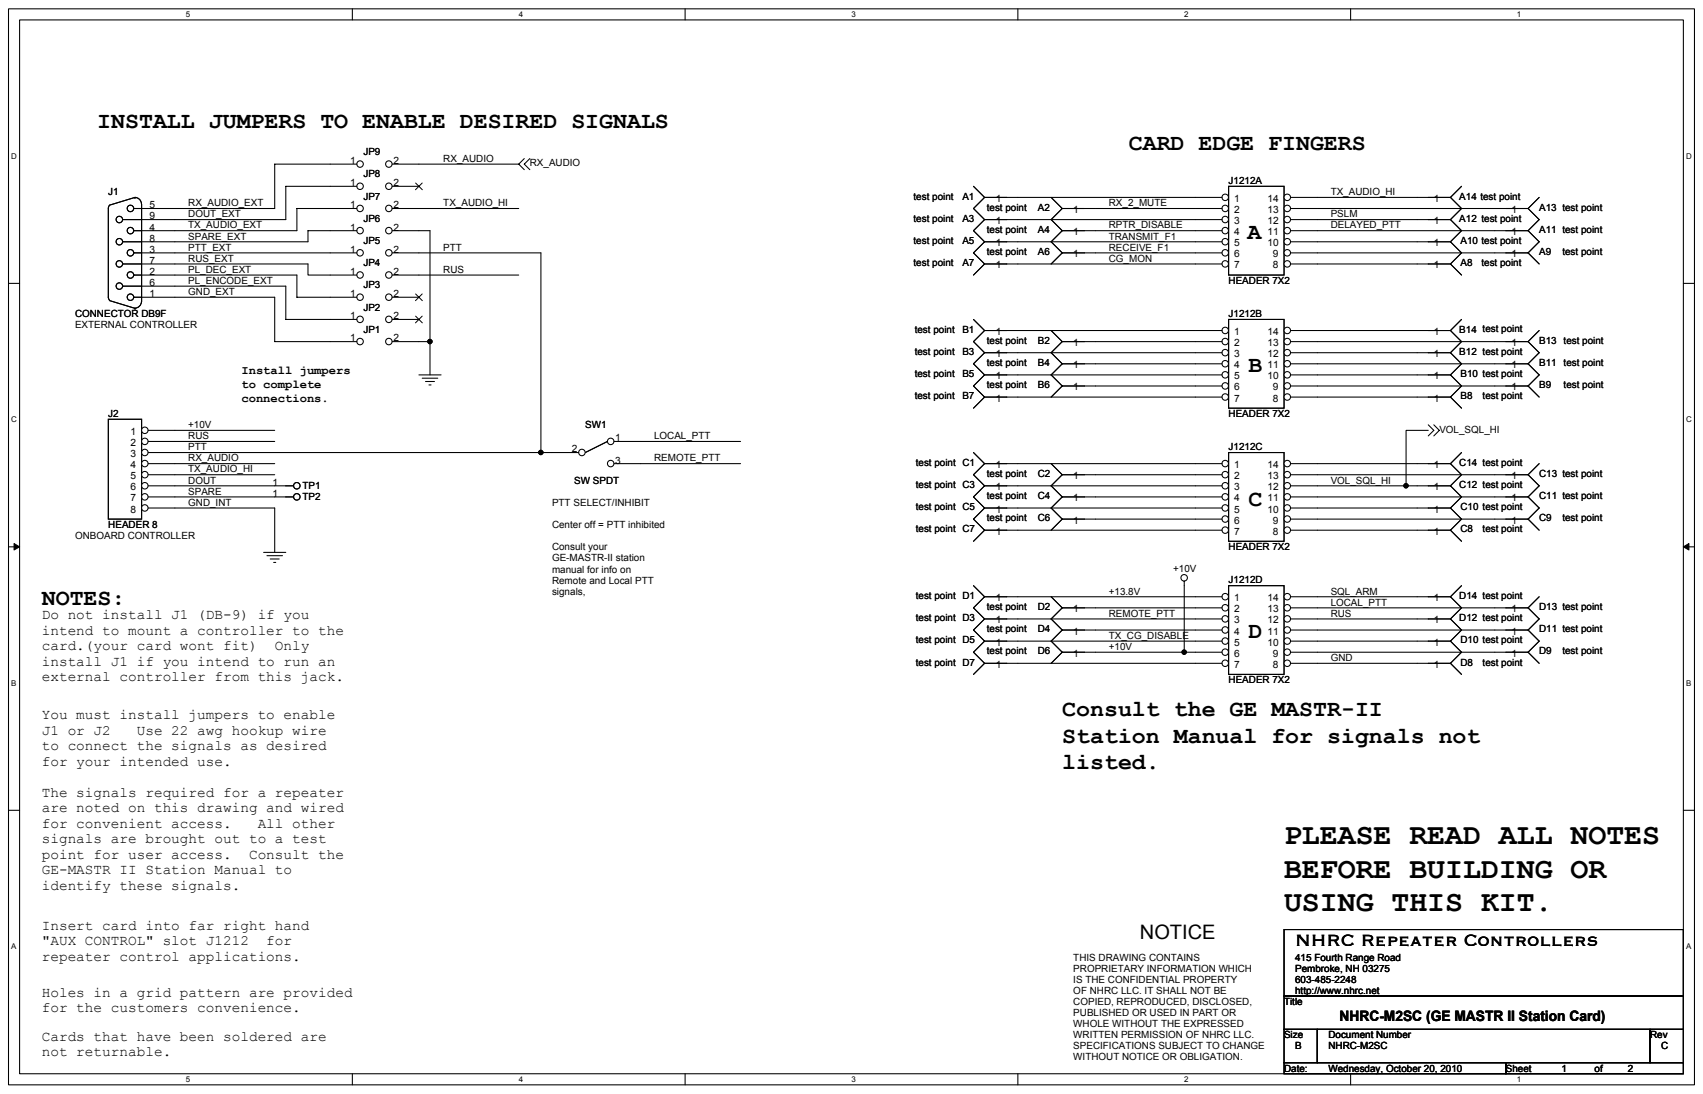
[picture p133: page 1]

C | J2 +10V 1 RUS 2 PTT 3 RX_AUDIO 4 TX_AUDIO_HI 5 DOUT 6 SPARE 7 GND_INT | | 3 REMOTE_PTT SW SPDT PTT SELECT/INHIBIT Center off = PTT inhibited | test point B2 test point B3 1 test point B4 test point B5 1 test point B6 test point B7 1 test point C1 1 test point C2 test point C3 1 test point C4 test point C5 1 test point C6 test point C7 1 | J1212B 1 14 1 2 13 3 B 12 1 4 11 5 10 1 6 9 7 8 HEADER 7X2 J1212C 1 14 1 2 13 VOL_SQL_HI 3 12 1 C 4 11 5 10 1 6 9 7 8 | B14 test point 1 1 B13 test point 1 B12 test point 1 B11 test point 1 B10 test point 1 B9 test point 1 B8 test point VOL_SQL_HI 1 C14 test point 1 C13 test point 1 C12 test point 1 C11 test point 1 C10 test point 1 C9 test point 1 C8 test point | C

Consult your
GE-MASTR-II station
manual for info on
Remote and Local PTT
signals,

NOTES:
Do not install J1 (DB-9) if you
intend to mount a controller to the
card.(your card wont fit) Only
install J1 if you intend to run an
external controller from this jack.

GND PLEASE READ ALL NOTES BEFORE BUILDING OR USING THIS KIT. | 1 D14 test point 1 D13 test point 1 D12 test point 1 D11 test point 1 D10 test point 1 D9 test point 1 D8 test point

You must install jumpers to enable
to connect the signals as desired
for your intended use.
The signals required for a repeater
are noted on this drawing and wired
signals are brought out to a test
point for user access. Consult the
GE-MASTR II Station Manual to
identify these signals.

Consult the GE MASTR-II
Station Manual for signals not
listed.

Insert card into far right hand
"AUX CONTROL" slot J1212 for
repeater control applications.

NHRC Repeater Controllers NHRC Repeater Controllers NHRC Repeater Controllers 415 Fourth Range Road 415 Fourth Range Road 415 Fourth Range Road Pembroke, NH 03275 Pembroke, NH 03275 Pembroke, NH 03275 603-485-2248 603-485-2248 603-485-2248 http://www.nhrc.nethttp://www.nhrc.nethttp://www.nhrc.net

THIS DRAWING CONTAINS
PROPRIETARY INFORMATION WHICH
IS THE CONFIDENTIAL PROPERTY
OF NHRC LLC. IT SHALL NOT BE
COPIED, REPRODUCED, DISCLOSED,
PUBLISHED OR USED IN PART OR
WHOLE WITHOUT THE EXPRESSED
WRITTEN PERMISSION OF NHRC LLC.
SPECIFICATIONS SUBJECT TO CHANGE
WITHOUT NOTICE OR OBLIGATION.

Holes in a grid pattern are provided
for the customers convenience.
Cards that have been soldered are
not returnable.

Title Title Title NHRC-M2SC (GE MASTR II Station Card) NHRC-M2SC (GE MASTR II Station Card) NHRC-M2SC (GE MASTR II Station Card)

Size Size Size B B B | Document Number Document Number Document Number NHRC-M2SC NHRC-M2SC NHRC-M2SC | | Rev Rev Rev C C C

Date: Date: Date: Wednesday, October 20, 2010 Wednesday, October 20, 2010 Wednesday, October 20, 2010 | | Sheet Sheet Sheet 1 1 1 of of of 2 2 2

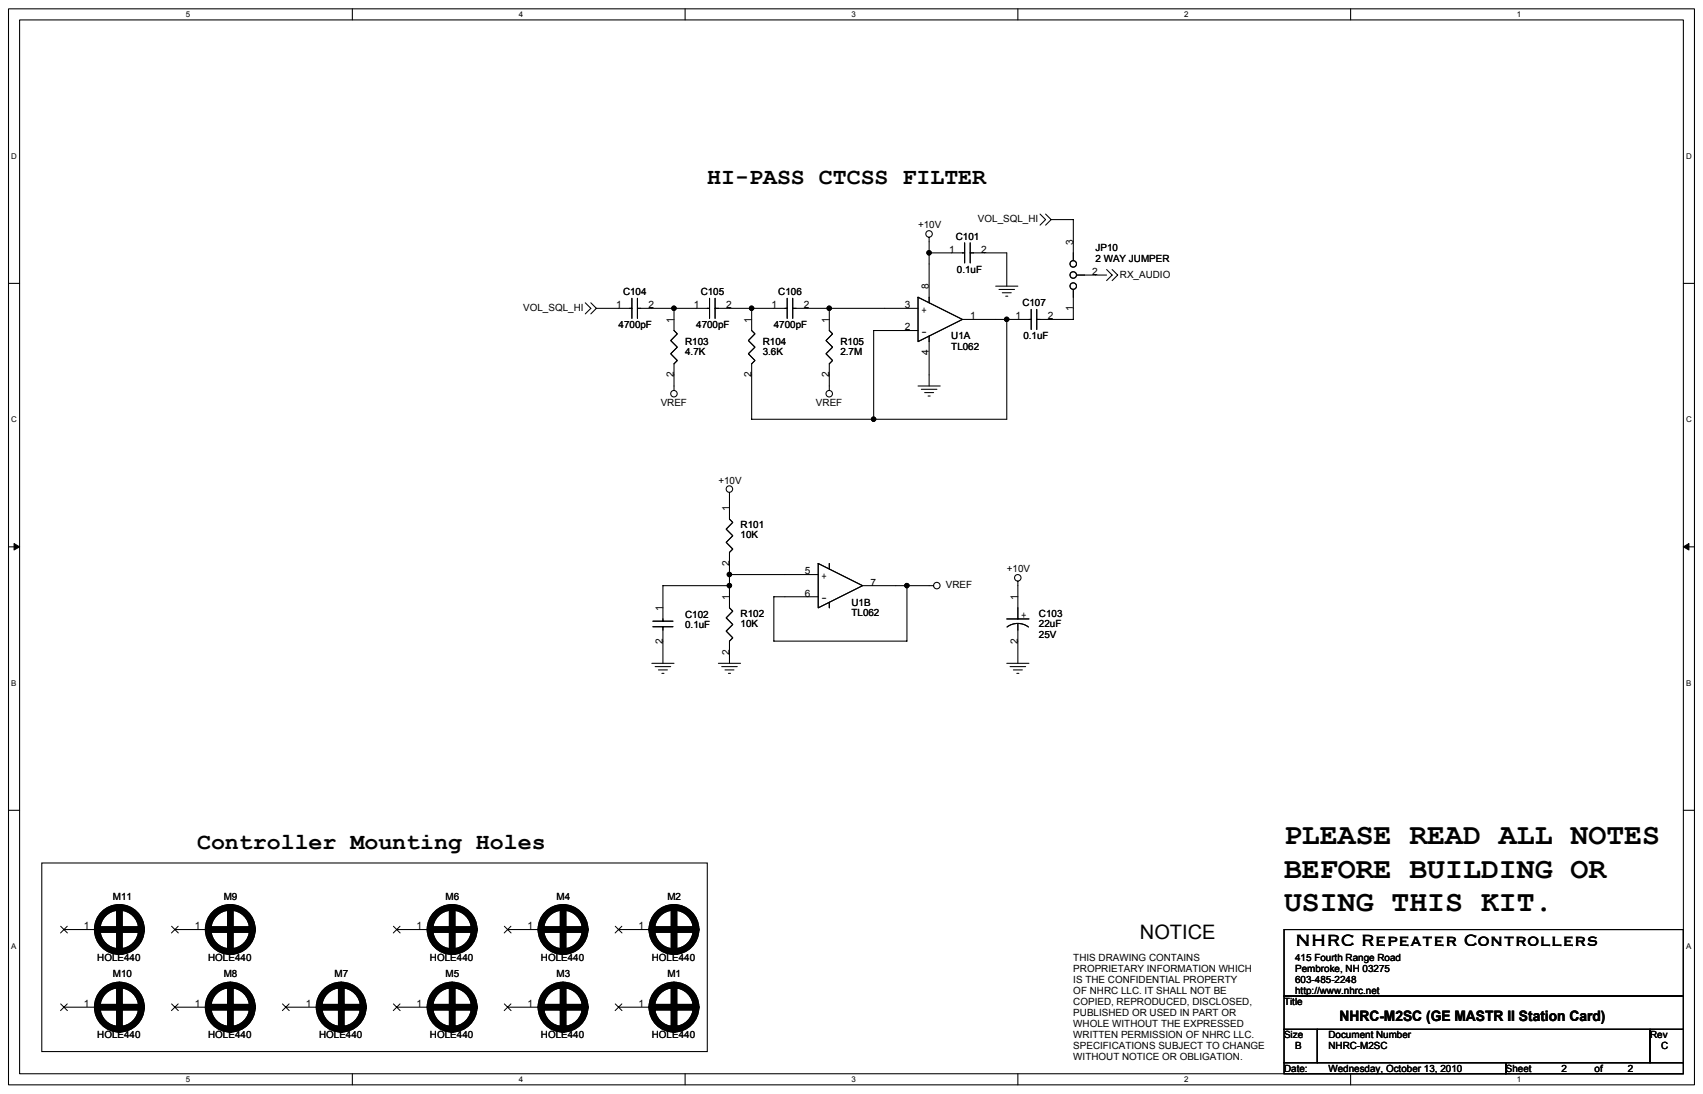
[picture p134: page 2]

HI-PASS CTCSS FILTER VOL_SQL_HI +10V C101 | 2 WAY JUMPER 2 RX_AUDIO

5 + 7 | PLEASE READ ALL NOTES BEFORE BUILDING OR USING THIS KIT.

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

Date: Date: Date: Wednesday, October 13, 2010 Wednesday, October 13, 2010 Wednesday, October 13, 2010 | | Sheet Sheet Sheet 2 2 2 of of of 2 2 2
