nhrc-net/NHRC_Repeater_Controllers/cables/GM-300 to NHRC-Micro Repeater Cable.pdf

# USE 2 MOTOROLA GM300'S WITH AN NHRC-µ CONTROLLER TO MAKE A REPEATER

## GM-300 TRANSMITTER

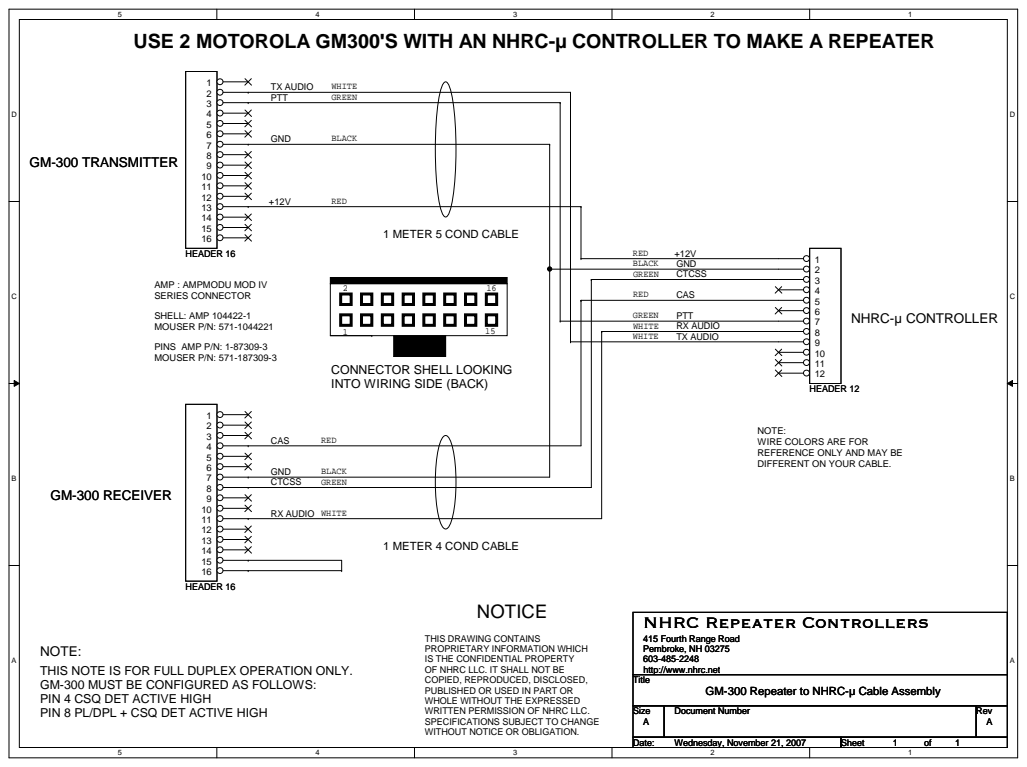
[picture p135: page 1]
TX AUDIO PTT; GND; TX AUDIO; PTT; CAS; CTCSS; RX AUDIO; GND CTCSS; Size; Document Number; Rev; Date:; Sheet; Wednesday, November 21, 2007; NOTICE; WHITE; GREEN; BLACK; RED; BLACK GREEN; NHRC-µ CONTROLLER; HEADER 12; HEADER 16; GM-300 RECEIVER

1 METER 5 COND CABLE

AMP : AMPMODU MOD IV
SERIES CONNECTOR
SHELL: AMP 104422-1
MOUSER P/N: 571-1044221
PINS AMP P/N: 1-87309-3
MOUSER P/N: 571-187309-3

CONNECTOR SHELL LOOKING
INTO WIRING SIDE (BACK)

NOTE:
WIRE COLORS ARE FOR
REFERENCE ONLY AND MAY BE
DIFFERENT ON YOUR CABLE.

1 METER 4 COND CABLE

NHRC Repeater Controllers
415 Fourth Range Road
Pembroke, NH 03275
http://www.nhrc.net
Title

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

THIS NOTE IS FOR FULL DUPLEX OPERATION ONLY.
GM-300 MUST BE CONFIGURED AS FOLLOWS:
PIN 4 CSQ DET ACTIVE HIGH
PIN 8 PL/DPL + CSQ DET ACTIVE HIGH

GM-300 Repeater to NHRC-µ Cable Assembly
