nhrc-net/NHRC_Repeater_Controllers/cables/GM-300-CABLE.pdf

# USE A MOTOROLA GM300 WITH AN NHRC CONTROLLER FOR HALF DUPLEX OPERATION

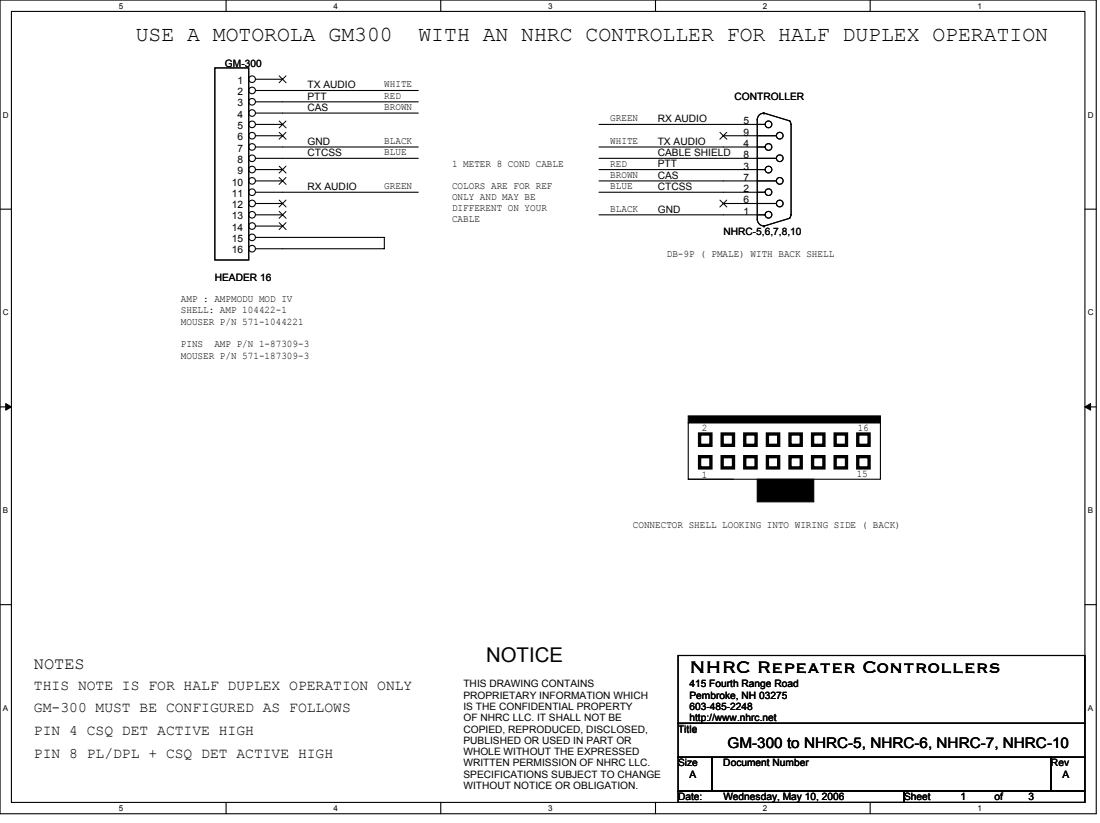
[picture p136: page 1]
TX AUDIO PTT CAS; GND CTCSS; RX AUDIO; TX AUDIO; PTT CAS; GND; CTCSS; CABLE SHIELD; NOTICE; PINS AMP P/N 1-87309-3 MOUSER P/N 571-187309-3; WHITE RED BROWN; BLACK BLUE; GREEN; WHITE; RED BROWN BLUE; BLACK; CONTROLLER; NHRC-5,6,7,8,10

1 METER 8 COND CABLE

COLORS ARE FOR REF
ONLY AND MAY BE
DIFFERENT ON YOUR
CABLE

DB-9P ( PMALE) WITH BACK SHELL

HEADER 16
AMP : AMPMODU MOD IV
SHELL: AMP 104422-1
MOUSER P/N 571-1044221

CONNECTOR SHELL LOOKING INTO WIRING SIDE ( BACK)

NOTES
THIS NOTE IS FOR HALF DUPLEX OPERATION ONLY
GM-300 MUST BE CONFIGURED AS FOLLOWS
PIN 4 CSQ DET ACTIVE HIGH
PIN 8 PL/DPL + CSQ DET ACTIVE HIGH

NHRC Repeater Controllers

THIS DRAWING CONTAINS
PROPRIETARY INFORMATION WHICH
IS THE CONFIDENTIAL PROPERTY
OF NHRC LLC. IT SHALL NOT BE
COPIED, REPRODUCED, DISCLOSED,
PUBLISHED OR USED IN PART OR
WHOLE WITHOUT THE EXPRESSED
WRITTEN PERMISSION OF NHRC LLC.
SPECIFICATIONS SUBJECT TO CHANGE
WITHOUT NOTICE OR OBLIGATION.

415 Fourth Range Road
Pembroke, NH 03275
http://www.nhrc.net
Title
GM-300 to NHRC-5, NHRC-6, NHRC-7, NHRC-10

Size Size Size A A A | Document Number Document Number Document Number | Rev Rev Rev A A A

Date: Date: Date: Wednesday, May 10, 2006 Wednesday, May 10, 2006 Wednesday, May 10, 2006 | Sheet Sheet Sheet 1 1 1 of of of 3 3 3

# USE 2 MOTOROLA GM300'S WITH AN NHRC CONTROLLER TO MAKE A REPEATER

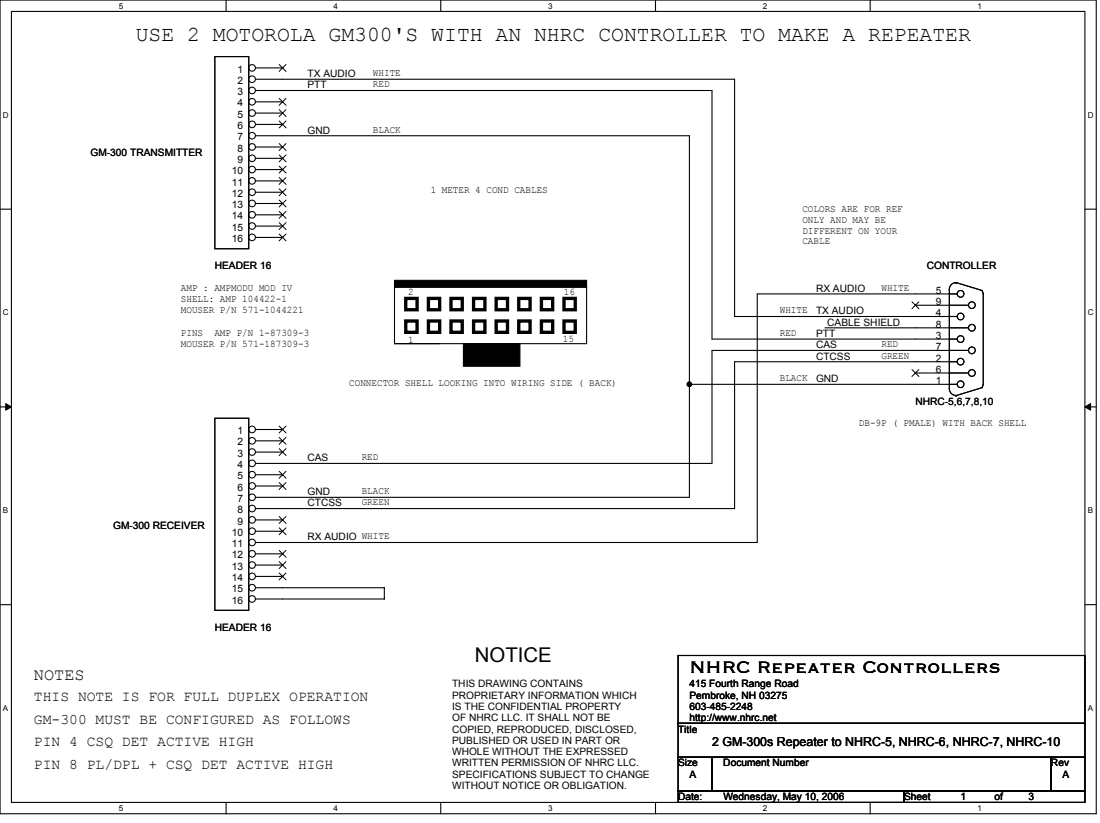
[picture p137: page 2]
TX AUDIO PTT; GND; TX AUDIO; PTT CAS CTCSS; RX AUDIO; CAS; GND CTCSS; CABLE SHIELD; PINS AMP P/N 1-87309-3 MOUSER P/N 571-187309-3; NOTICE; PIN 8 PL/DPL + CSQ DET ACTIVE HIGH; WRITTEN PERMISSION OF NHRC LLC.; WHITE; RED; BLACK; BLACK GREEN; GREEN; GM-300 TRANSMITTER; GM-300 RECEIVER; HEADER 16; CONTROLLER; NHRC-5,6,7,8,10

1 METER 4 COND CABLES

COLORS ARE FOR REF
ONLY AND MAY BE
DIFFERENT ON YOUR
CABLE

HEADER 16
AMP : AMPMODU MOD IV
SHELL: AMP 104422-1
MOUSER P/N 571-1044221

CONNECTOR SHELL LOOKING INTO WIRING SIDE ( BACK)

DB-9P ( PMALE) WITH BACK SHELL

NHRC Repeater Controllers

NOTES
THIS NOTE IS FOR FULL DUPLEX OPERATION
GM-300 MUST BE CONFIGURED AS FOLLOWS
PIN 4 CSQ DET ACTIVE HIGH

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

415 Fourth Range Road
Pembroke, NH 03275
http://www.nhrc.net
Title
2 GM-300s Repeater to NHRC-5, NHRC-6, NHRC-7, NHRC-10

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

SPECIFICATIONS SUBJECT TO CHANGE
WITHOUT NOTICE OR OBLIGATION.

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
