nhrc-net/NHRC_Repeater_Controllers/nhrc-10/hw/x-digout board-revb.pdf

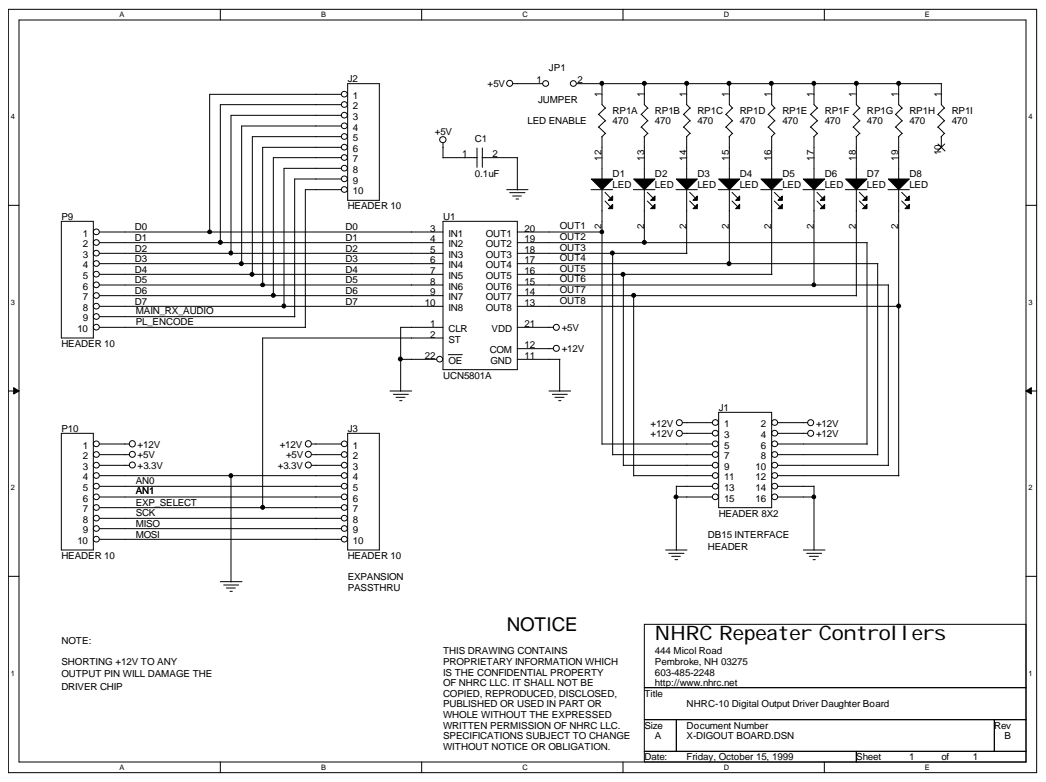
[picture p139: page 1]

18 OUT3
OUT4 17
OUT5 16
15 OUT6
OUT7 14
13 OUT8

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

SHORTING +12V TO ANY
OUTPUT PIN WILL DAMAGE THE
DRIVER CHIP

NHRC-10 Digital Output Driver Daughter Board

Size A | Document Number X-DIGOUT BOARD.DSN | Rev B

Date: Friday, October 15, 1999 | Sheet 1 of 1
