nhrc-net/NHRC_Repeater_Controllers/nhrc-17/hw/NHRC-17-SCHEM-REVB.pdf

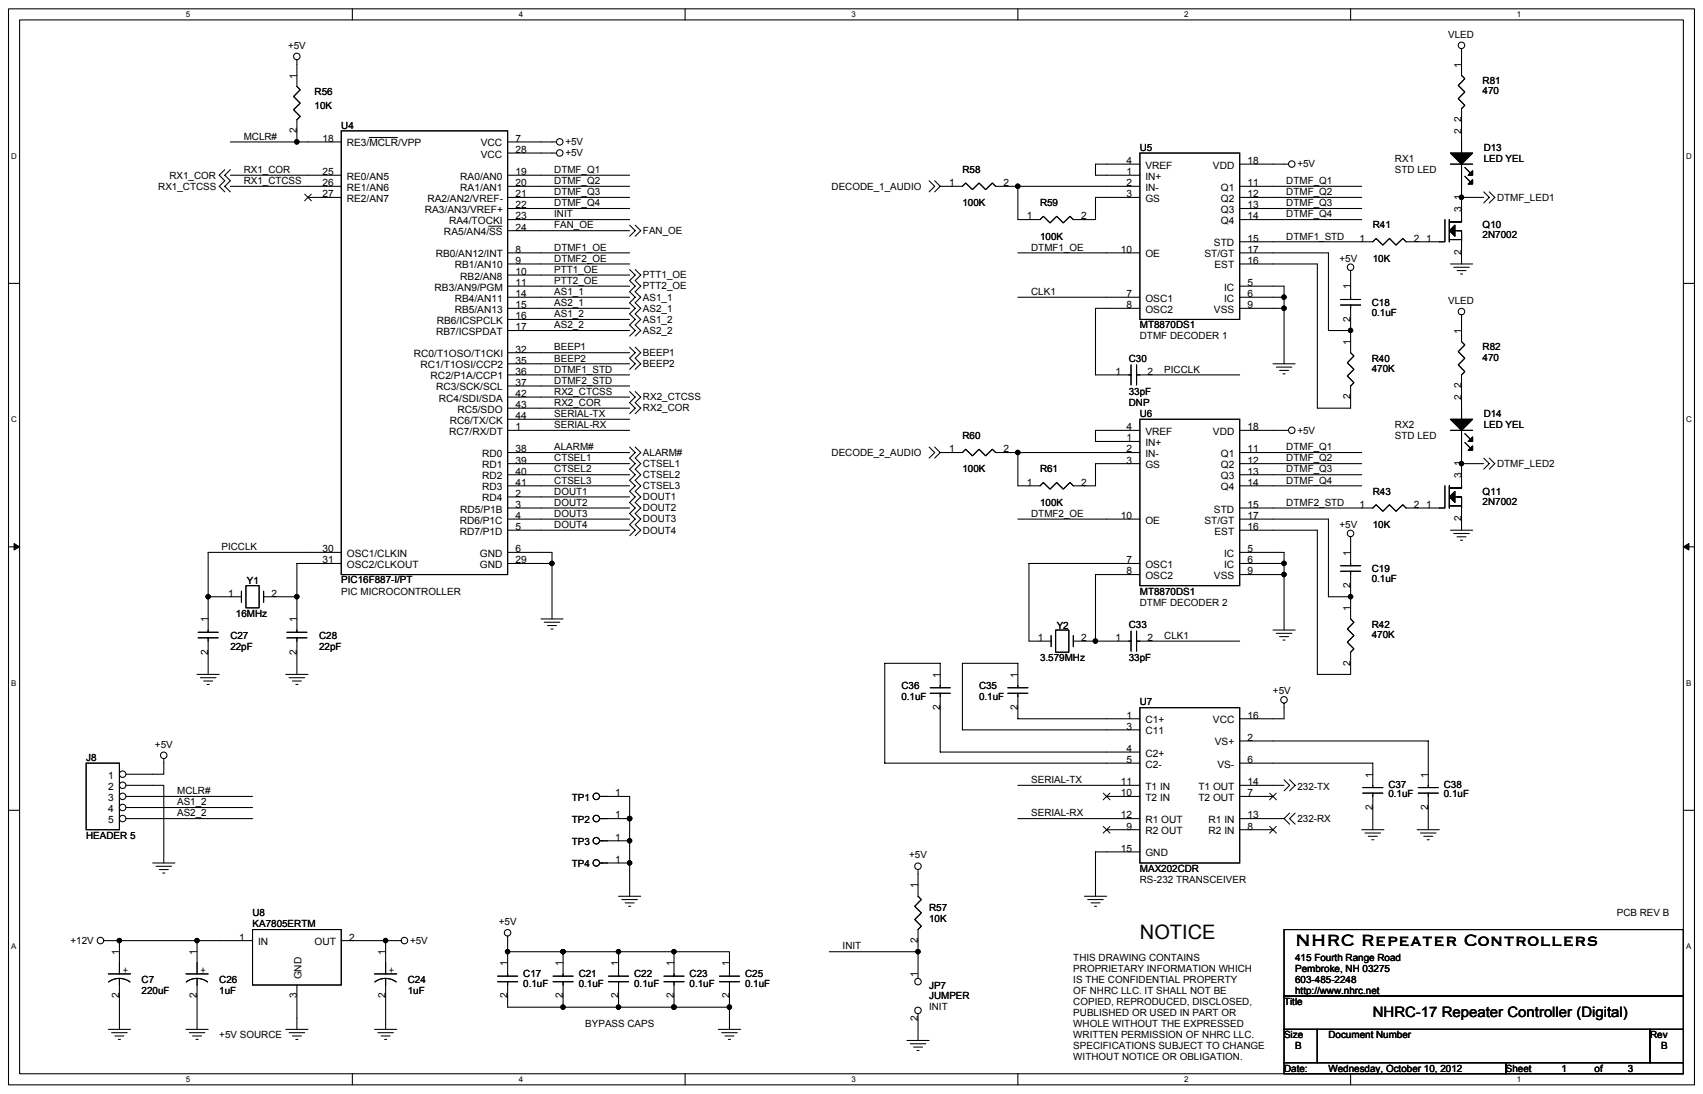
[picture p140: page 1]

NHRC Repeater Controllers NHRC Repeater Controllers NHRC Repeater Controllers 415 Fourth Range Road 415 Fourth Range Road 415 Fourth Range Road Pembroke, NH 03275 Pembroke, NH 03275 Pembroke, NH 03275 603-485-2248 603-485-2248 603-485-2248 http://www.nhrc.nethttp://www.nhrc.nethttp://www.nhrc.net

THIS DRAWING CONTAINS
PROPRIETARY INFORMATION WHICH
IS THE CONFIDENTIAL PROPERTY
OF NHRC LLC. IT SHALL NOT BE
COPIED, REPRODUCED, DISCLOSED,
PUBLISHED OR USED IN PART OR
WHOLE WITHOUT THE EXPRESSED
WRITTEN PERMISSION OF NHRC LLC.
SPECIFICATIONS SUBJECT TO CHANGE
WITHOUT NOTICE OR OBLIGATION.

Title Title Title | NHRC-17 Repeater Controller (Digital) NHRC-17 Repeater Controller (Digital) NHRC-17 Repeater Controller (Digital)

Size Size Size B B B | Document Number Document Number Document Number | | Rev Rev Rev B B B

Date: Date: Date: Wednesday, October 10, 2012 Wednesday, October 10, 2012 Wednesday, October 10, 2012 | | Sheet Sheet Sheet 1 1 1 of of of 3 3 3

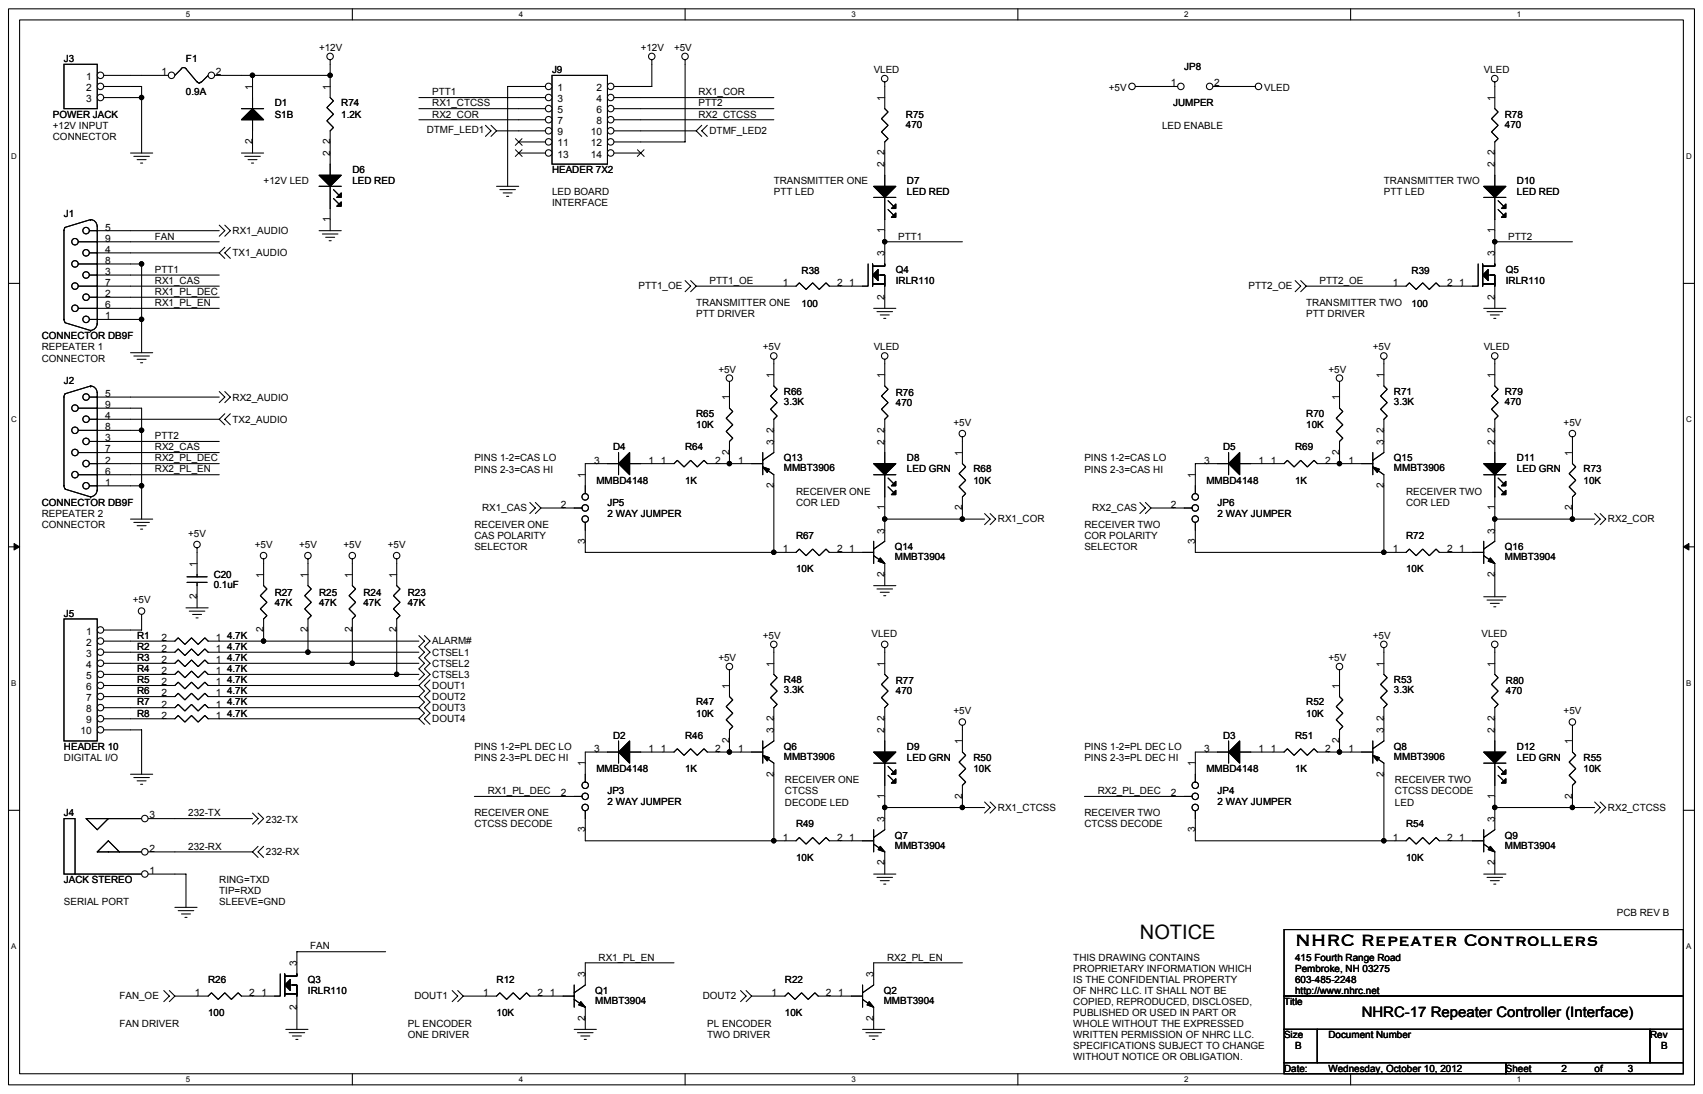
[picture p141: page 2]

+12V J3 F1 1 2 9 FAN 4 8 | +12V +5V LED BOARD INTERFACE | VLED R75 470 TRANSMITTER ONE D7 PTT LED LED RED | JP8 +5V 1 2 VLED JUMPER LED ENABLE | VLED R78 470 TRANSMITTER TWO D10 PTT LED LED RED

PINS 1-2=PL DEC LO
PINS 2-3=PL DEC HI

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

Title Title Title | NHRC-17 Repeater Controller (Interface) NHRC-17 Repeater Controller (Interface) NHRC-17 Repeater Controller (Interface)

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

Date: Date: Date: Wednesday, October 10, 2012 Wednesday, October 10, 2012 Wednesday, October 10, 2012 | | Sheet Sheet Sheet 2 2 2 of of of 3 3 3

## NOTE:

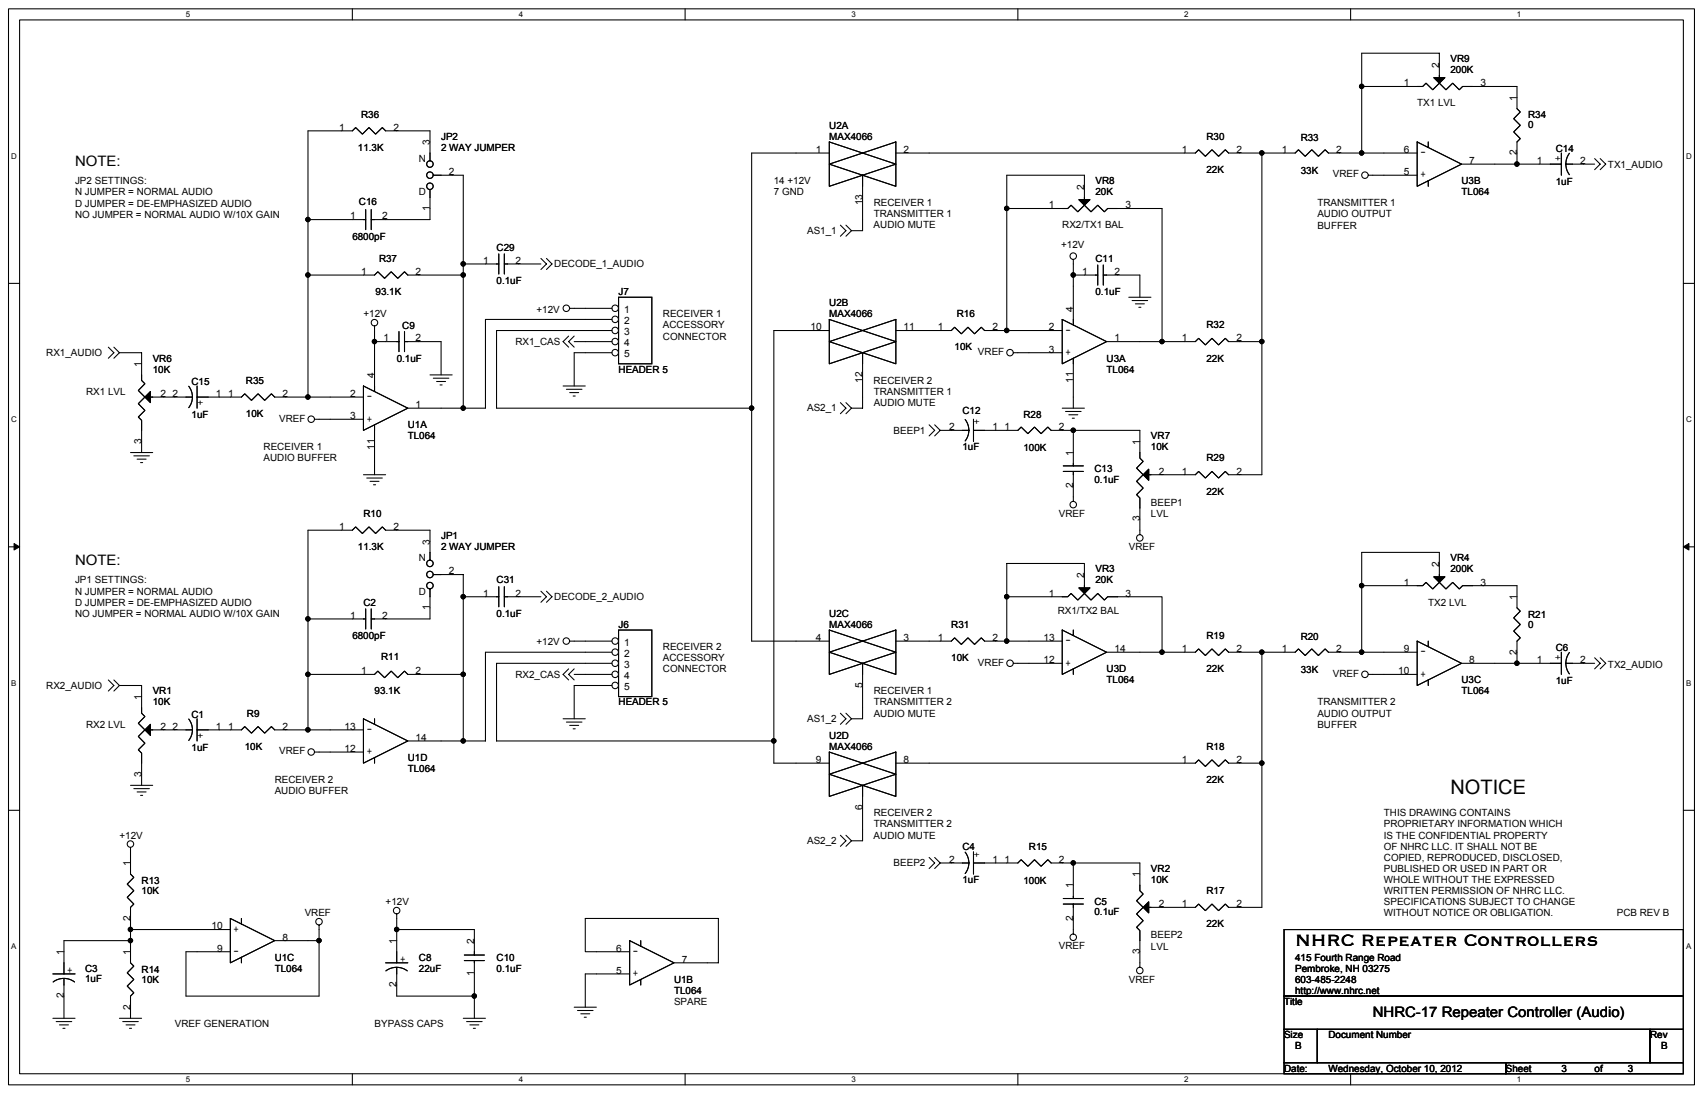
[picture p142: page 3]

JP2 SETTINGS:
N JUMPER = NORMAL AUDIO
D JUMPER = DE-EMPHASIZED AUDIO
NO JUMPER = NORMAL AUDIO W/10X GAIN

JP1 SETTINGS:

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

415 Fourth Range Road
Pembroke, NH 03275
http://www.nhrc.net
Title

NHRC-17 Repeater Controller (Audio)

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

Date: Date: Date: Wednesday, October 10, 2012 Wednesday, October 10, 2012 Wednesday, October 10, 2012 | | Sheet Sheet Sheet 3 3 3 of of of 3 3 3
