nhrc-net/NHRC_Repeater_Controllers/nhrc-2.1/hw/NHRC2_1-SCHEM-REVB.pdf

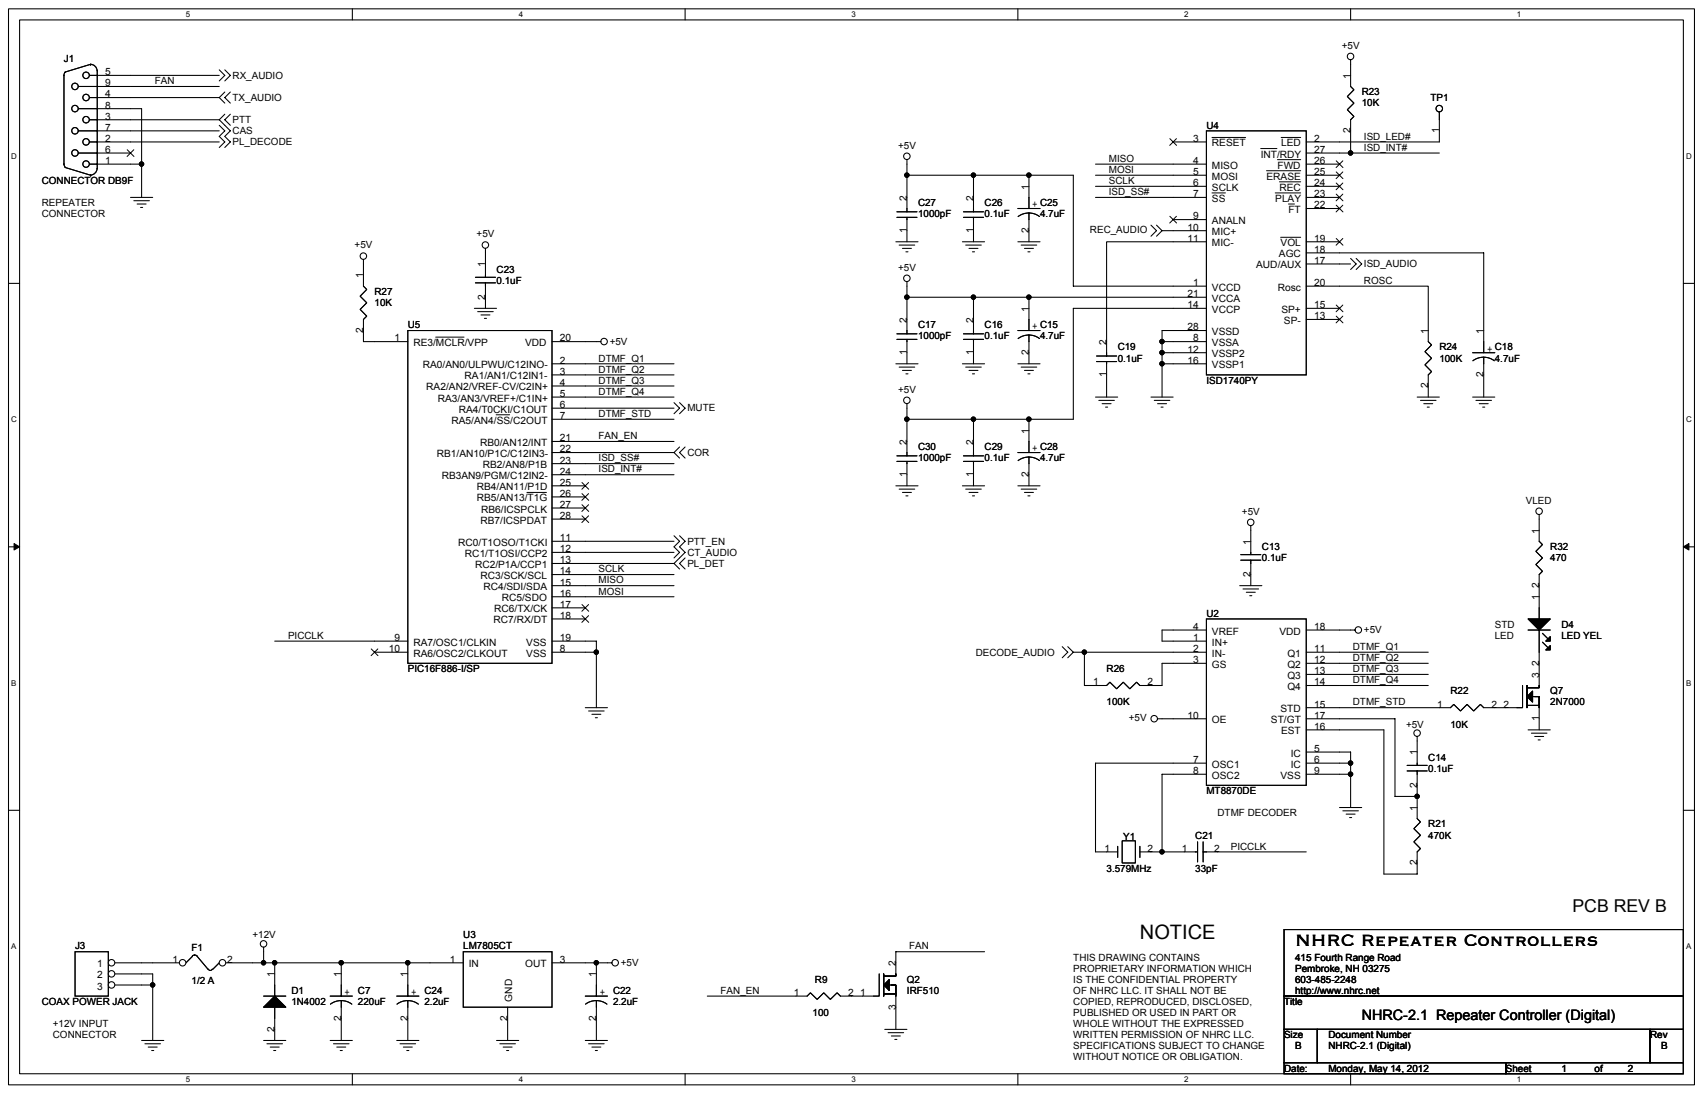
[picture p143: page 1]

J1 5 FAN RX_AUDIO 9 4 TX_AUDIO 8 REPEATER CONNECTOR | +5V | +5V | +5V U4 LED 2 RESET 3 MISO MISO 4 | R23 TP1 10K ISD_INT#

FT 22 PLAY 23 REC 24 ERASE 25 FWD 26 INT/RDY 27

AUD/AUX 17 AGC 18 VOL 19

PICCLK | | 100K STD 15 EST 16 IC 5 | STD +5V LED DTMF_Q1 R21 470K | 470 D4 LED YEL PCB REV B

NHRC Repeater Controllers NHRC Repeater Controllers NHRC Repeater Controllers 415 Fourth Range Road 415 Fourth Range Road 415 Fourth Range Road Pembroke, NH 03275 Pembroke, NH 03275 Pembroke, NH 03275 603-485-2248 603-485-2248 603-485-2248 http://www.nhrc.nethttp://www.nhrc.nethttp://www.nhrc.net

THIS DRAWING CONTAINS
PROPRIETARY INFORMATION WHICH
IS THE CONFIDENTIAL PROPERTY
OF NHRC LLC. IT SHALL NOT BE
COPIED, REPRODUCED, DISCLOSED,
PUBLISHED OR USED IN PART OR
WHOLE WITHOUT THE EXPRESSED
WRITTEN PERMISSION OF NHRC LLC.
SPECIFICATIONS SUBJECT TO CHANGE
WITHOUT NOTICE OR OBLIGATION.

Title Title Title | NHRC-2.1 Repeater Controller (Digital) NHRC-2.1 Repeater Controller (Digital) NHRC-2.1 Repeater Controller (Digital)

Size Size Size B B B | Document Number Document Number Document Number NHRC-2.1 (Digital) NHRC-2.1 (Digital) NHRC-2.1 (Digital) | | Rev Rev Rev B B B

Date: Date: Date: Monday, May 14, 2012 Monday, May 14, 2012 Monday, May 14, 2012 | | Sheet Sheet Sheet 1 1 1 of of of 2 2 2

D | NOTE:

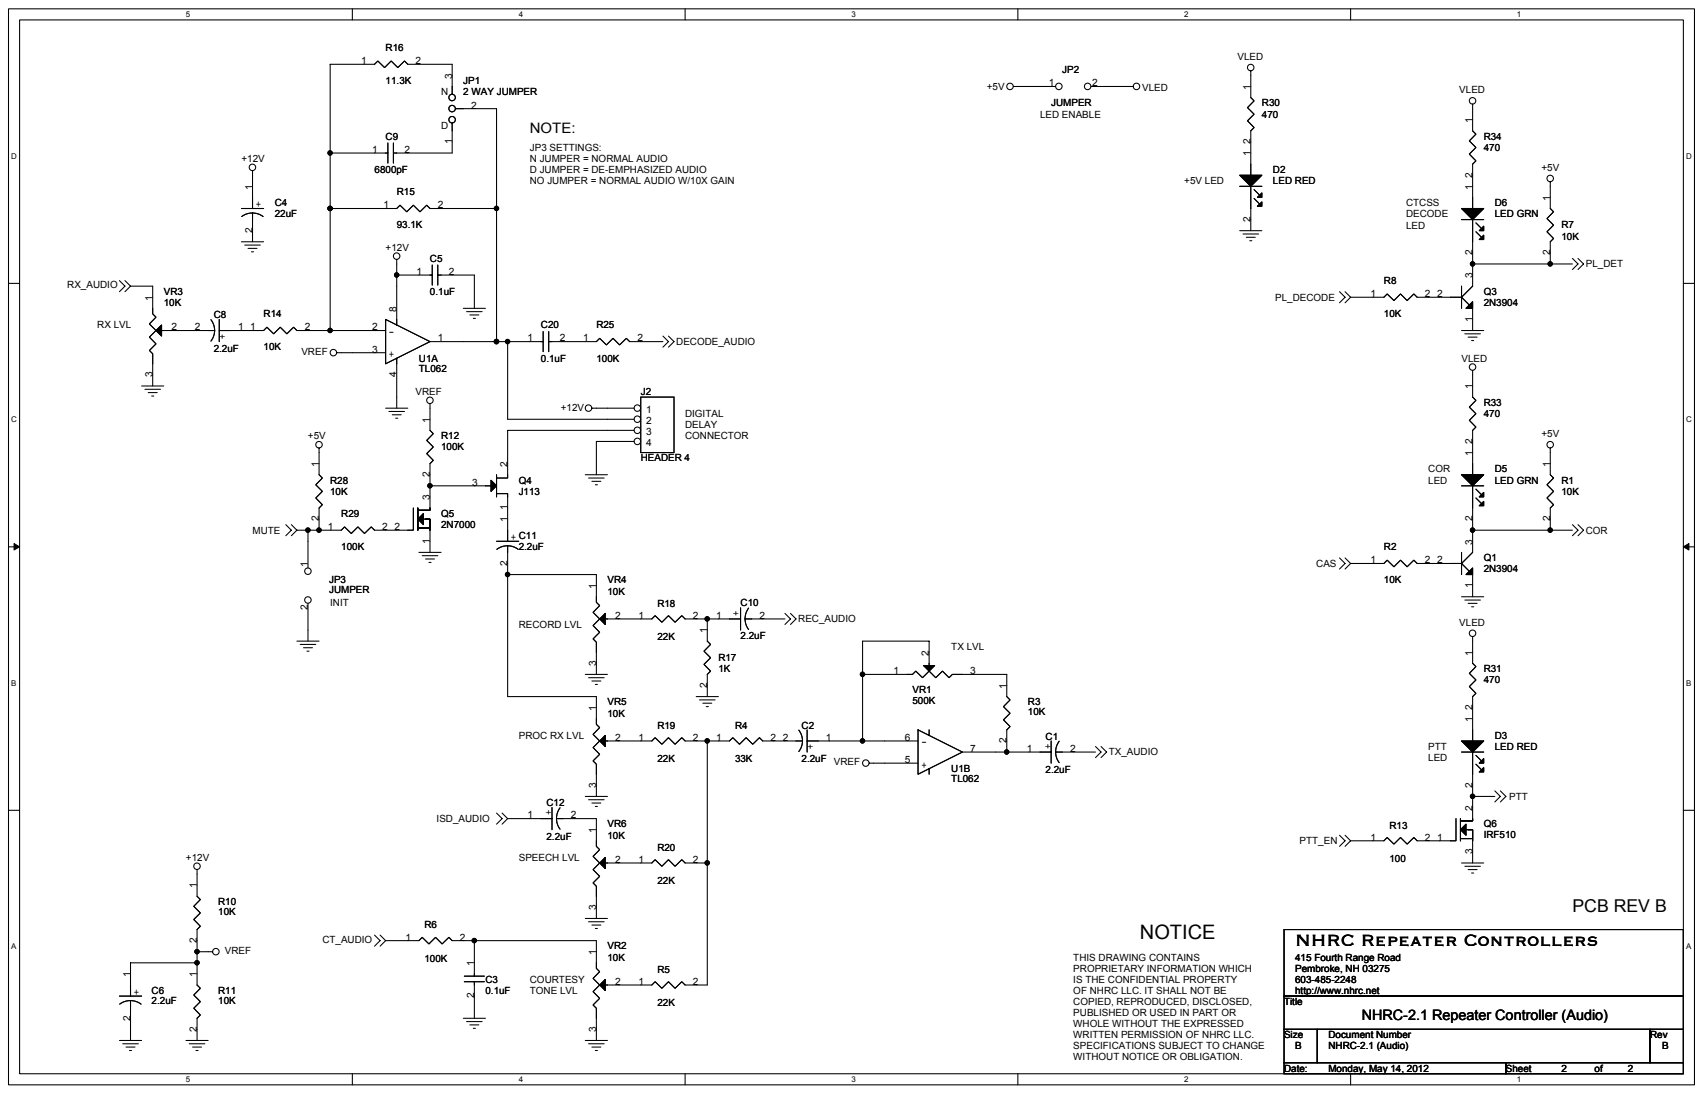
[picture p144: page 2]

R16 1 2 2 WAY JUMPER 2 | VLED JP2 1 2 JUMPER R30 LED ENABLE 470 D2 +5V LED LED RED | VLED R34 470 DECODE LED GRN LED R7 10K

JP3 SETTINGS:
N JUMPER = NORMAL AUDIO
D JUMPER = DE-EMPHASIZED AUDIO
NO JUMPER = NORMAL AUDIO W/10X GAIN

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

Title Title Title | NHRC-2.1 Repeater Controller (Audio) NHRC-2.1 Repeater Controller (Audio) NHRC-2.1 Repeater Controller (Audio)

Size Size Size B B B | Document Number Document Number Document Number NHRC-2.1 (Audio) NHRC-2.1 (Audio) NHRC-2.1 (Audio) | | Rev Rev Rev B B B

Date: Date: Date: Monday, May 14, 2012 Monday, May 14, 2012 Monday, May 14, 2012 | | Sheet Sheet Sheet 2 2 2 of of of 2 2 2
