nhrc-net/NHRC_Repeater_Controllers/nhrc-3-plus/hw/NHRC3PLUS-REVB2.PDF

## NOTE:

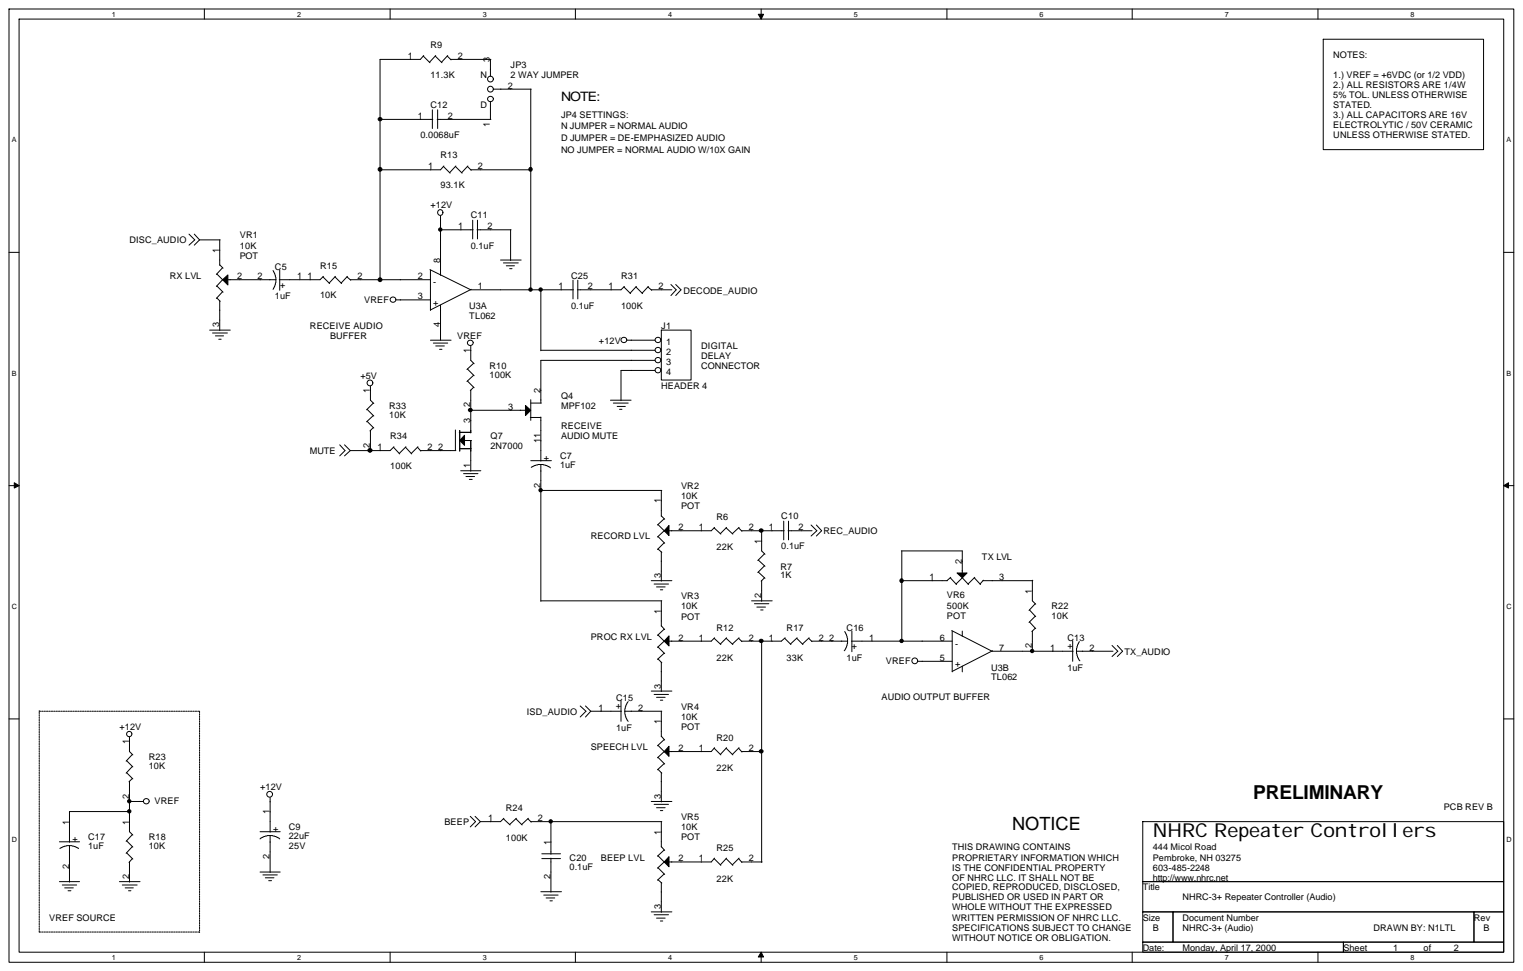
[picture p145: page 1]

JP4 SETTINGS:
N JUMPER = NORMAL AUDIO
D JUMPER = DE-EMPHASIZED AUDIO
NO JUMPER = NORMAL AUDIO W/10X GAIN

NHRC Repeater Controllers
444 Micol Road
Pembroke, NH 03275
http://www.nhrc.net
Title

THIS DRAWING CONTAINS
PROPRIETARY INFORMATION WHICH
IS THE CONFIDENTIAL PROPERTY
OF NHRC LLC. IT SHALL NOT BE
COPIED, REPRODUCED, DISCLOSED,
PUBLISHED OR USED IN PART OR
WHOLE WITHOUT THE EXPRESSED
WRITTEN PERMISSION OF NHRC LLC.
SPECIFICATIONS SUBJECT TO CHANGE
WITHOUT NOTICE OR OBLIGATION.

NHRC-3+ Repeater Controller (Audio)

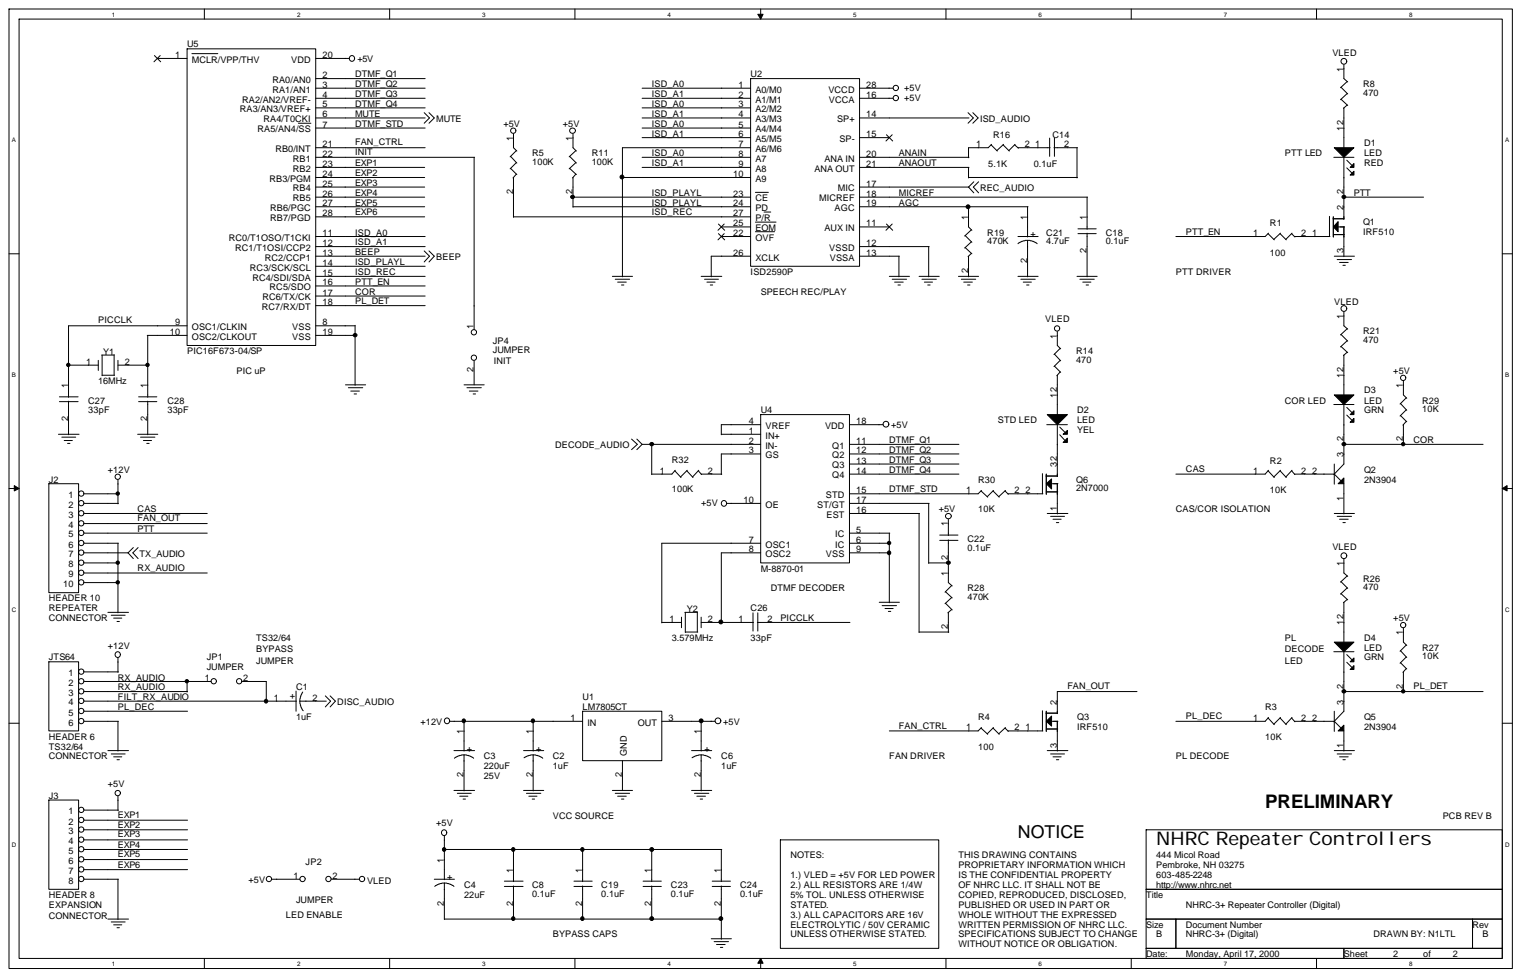
[picture p146: page 2]

NHRC Repeater Controllers
444 Micol Road
Pembroke, NH 03275
http://www.nhrc.net
Title

NOTES:
1.) VLED = +5V FOR LED POWER
2.) ALL RESISTORS ARE 1/4W
5% TOL. UNLESS OTHERWISE
STATED.
3.) ALL CAPACITORS ARE 16V
ELECTROLYTIC / 50V CERAMIC
UNLESS OTHERWISE STATED.

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

NHRC-3+ Repeater Controller (Digital)
