nhrc-net/NHRC_Repeater_Controllers/nhrc-tester/hw/tester-schem-20020403.pdf

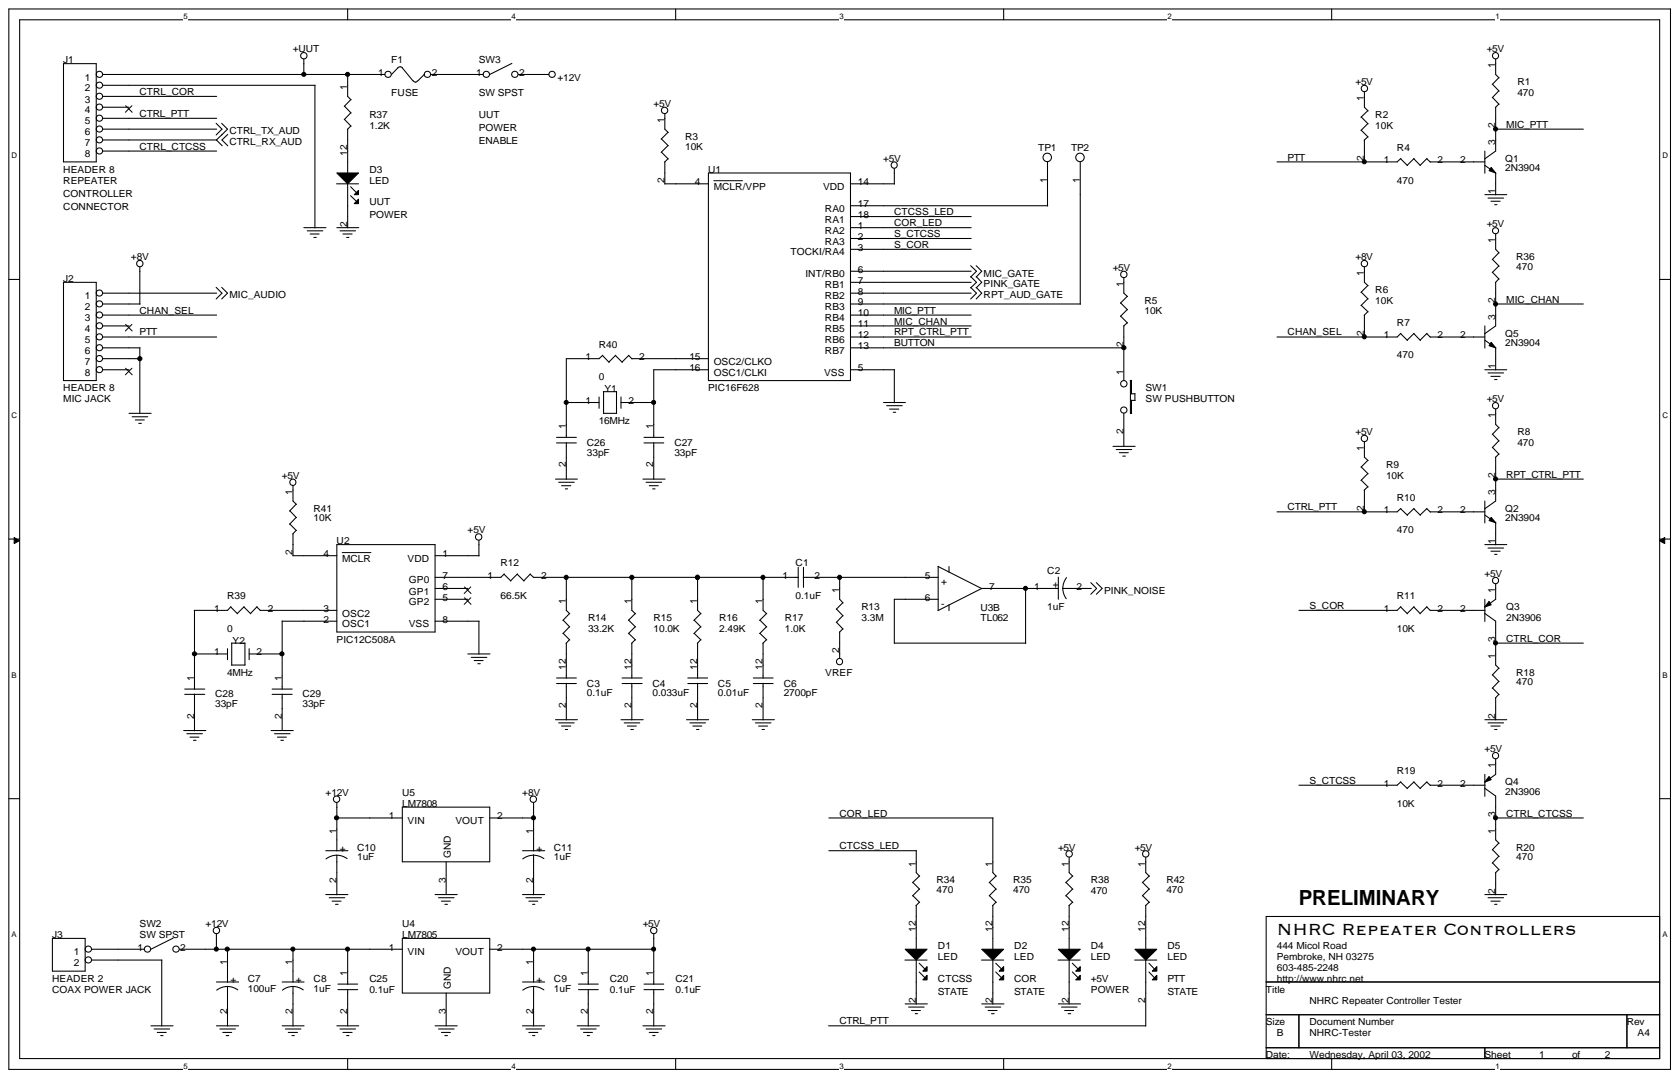
[picture p147: page 1]

NHRC Repeater Controller Tester

Size B | Document Number NHRC-Tester | Rev A4

Date: Wednesday, April 03, 2002 | Sheet 1 of 2

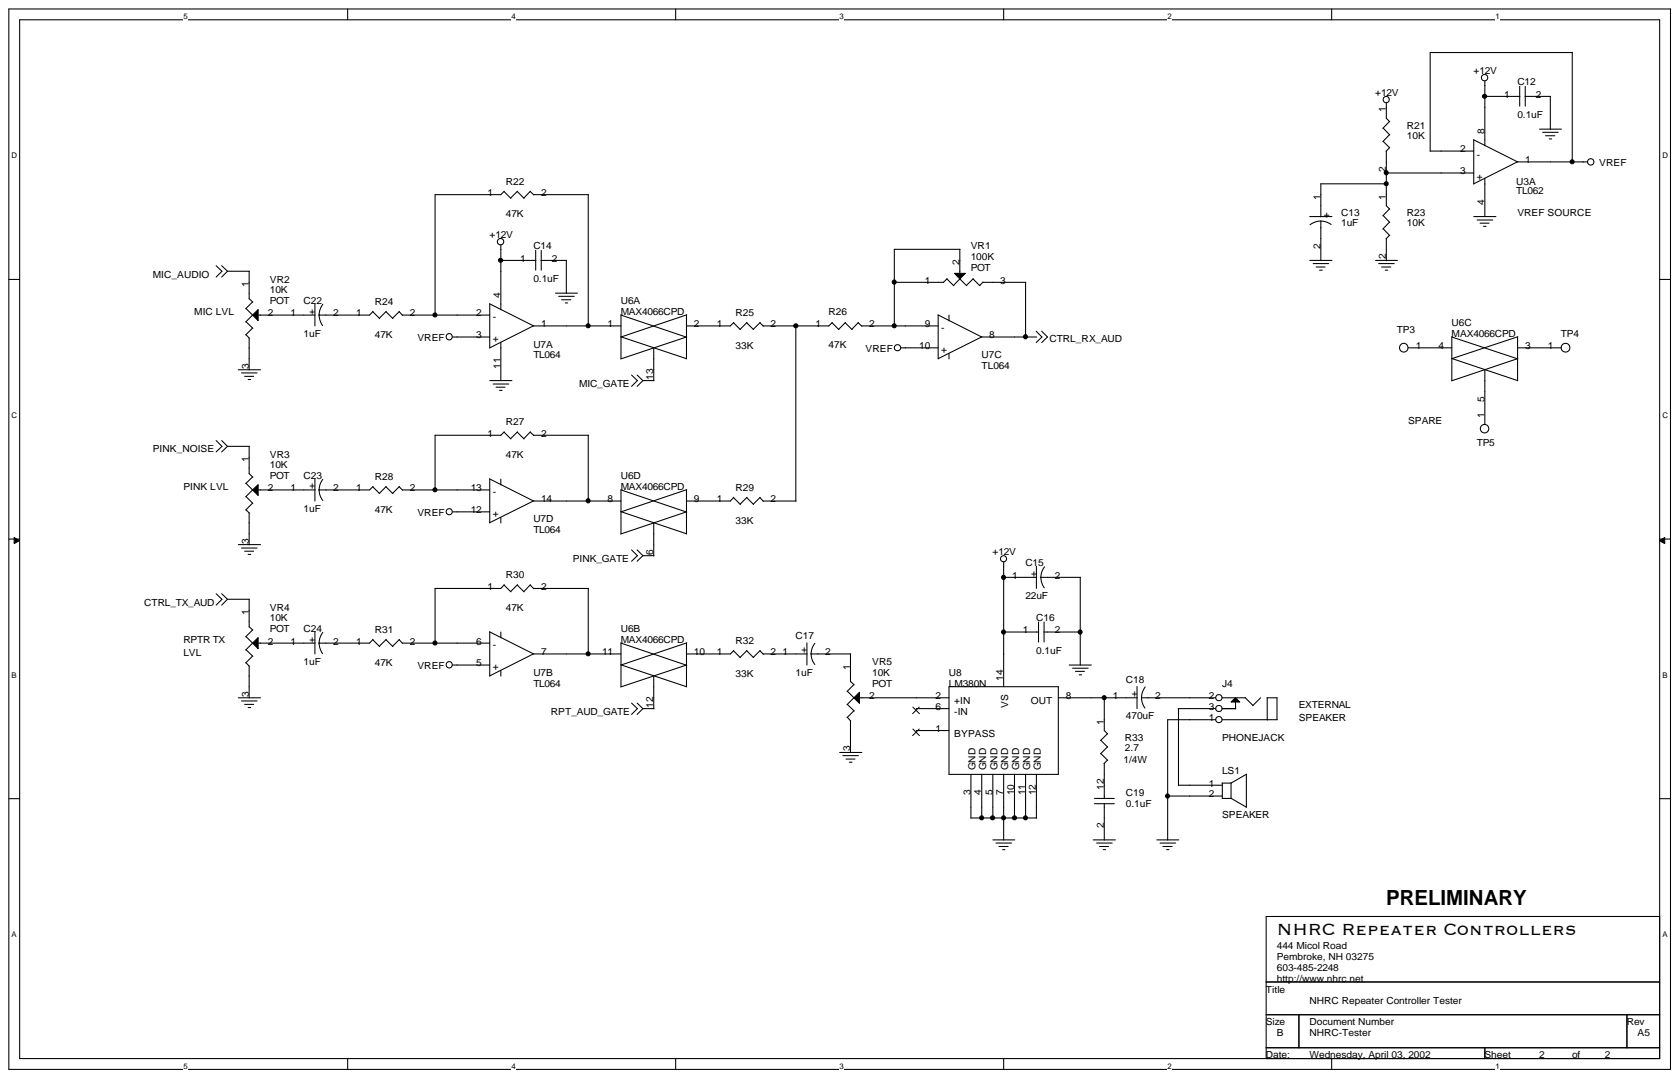
[picture p148: page 2]

NHRC Repeater Controller Tester

Size B | Document Number NHRC-Tester | Rev A5

Date: Wednesday, April 03, 2002 | Sheet 2 of 2
