nhrc-net/NHRC_Repeater_Controllers/nhrc-tester/hw/tester-schem-rev-c-20020830.pdf

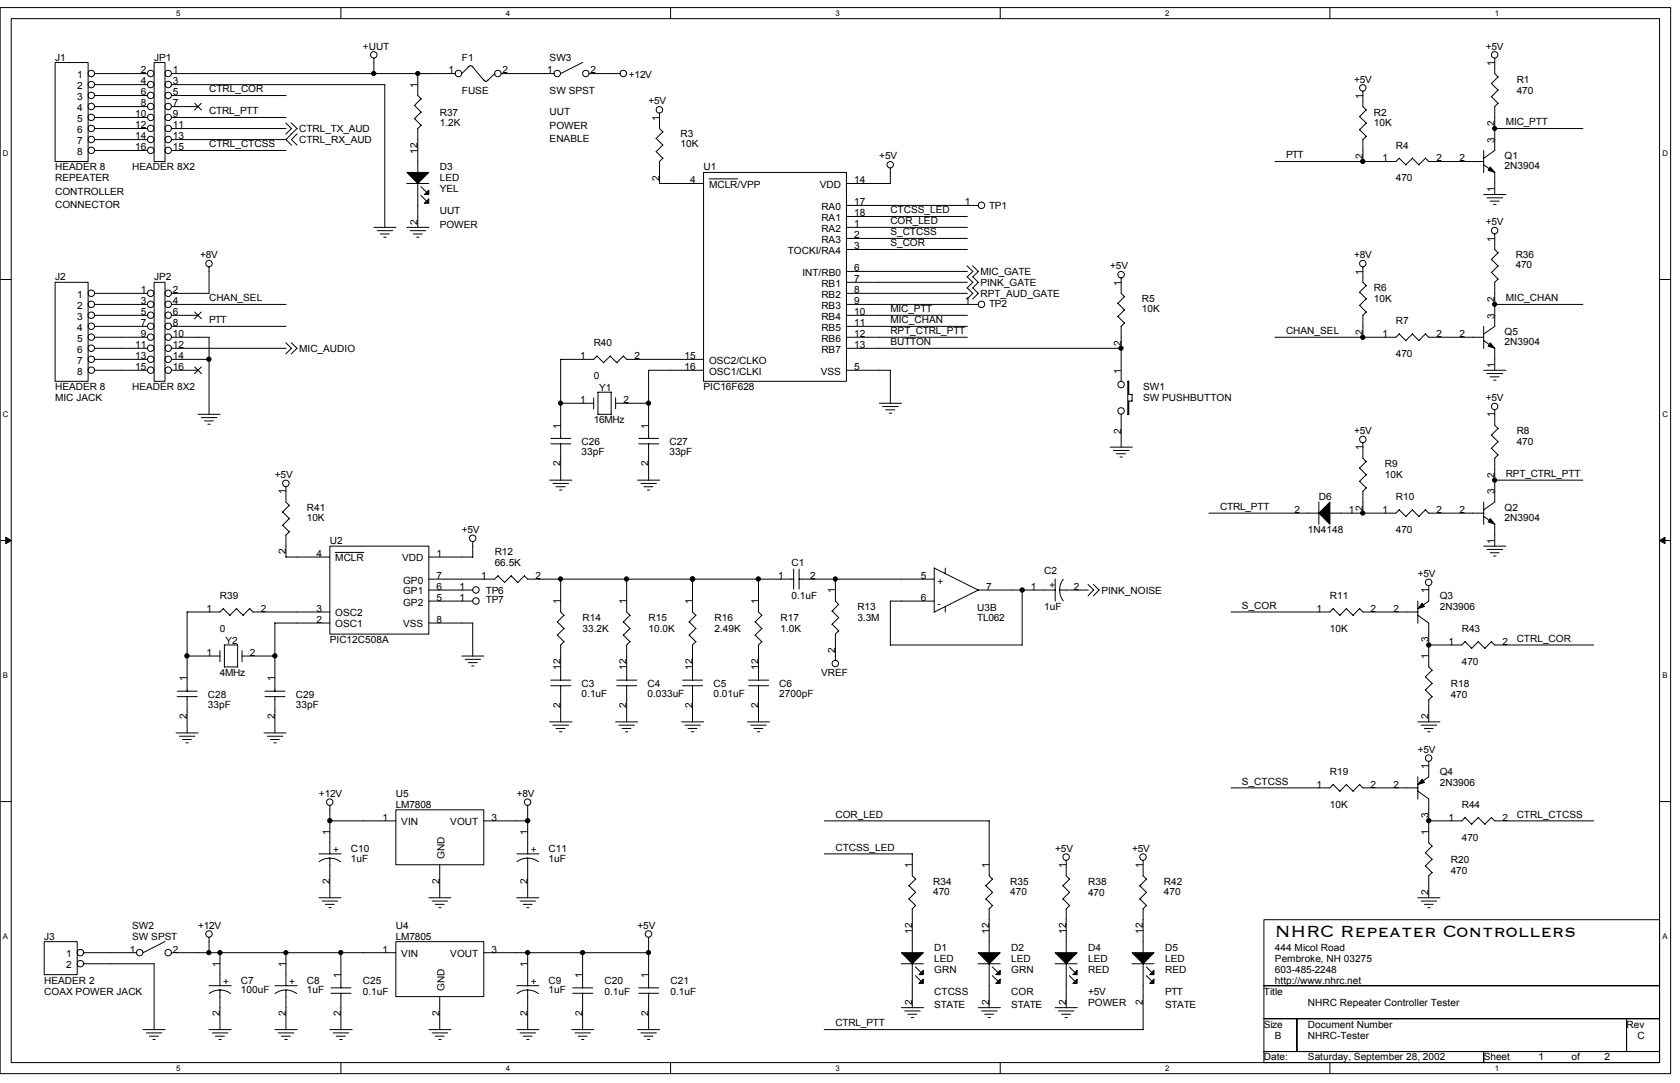
[picture p149: page 1]

NHRC Repeater Controllers 444 Micol Road Pembroke, NH 03275 603-485-2248 http://www.nhrc.net

Title NHRC Repeater Controller Tester

Size B | Document Number NHRC-Tester | | Rev C

Date: Saturday, September 28, 2002 | | Sheet 1 of 2

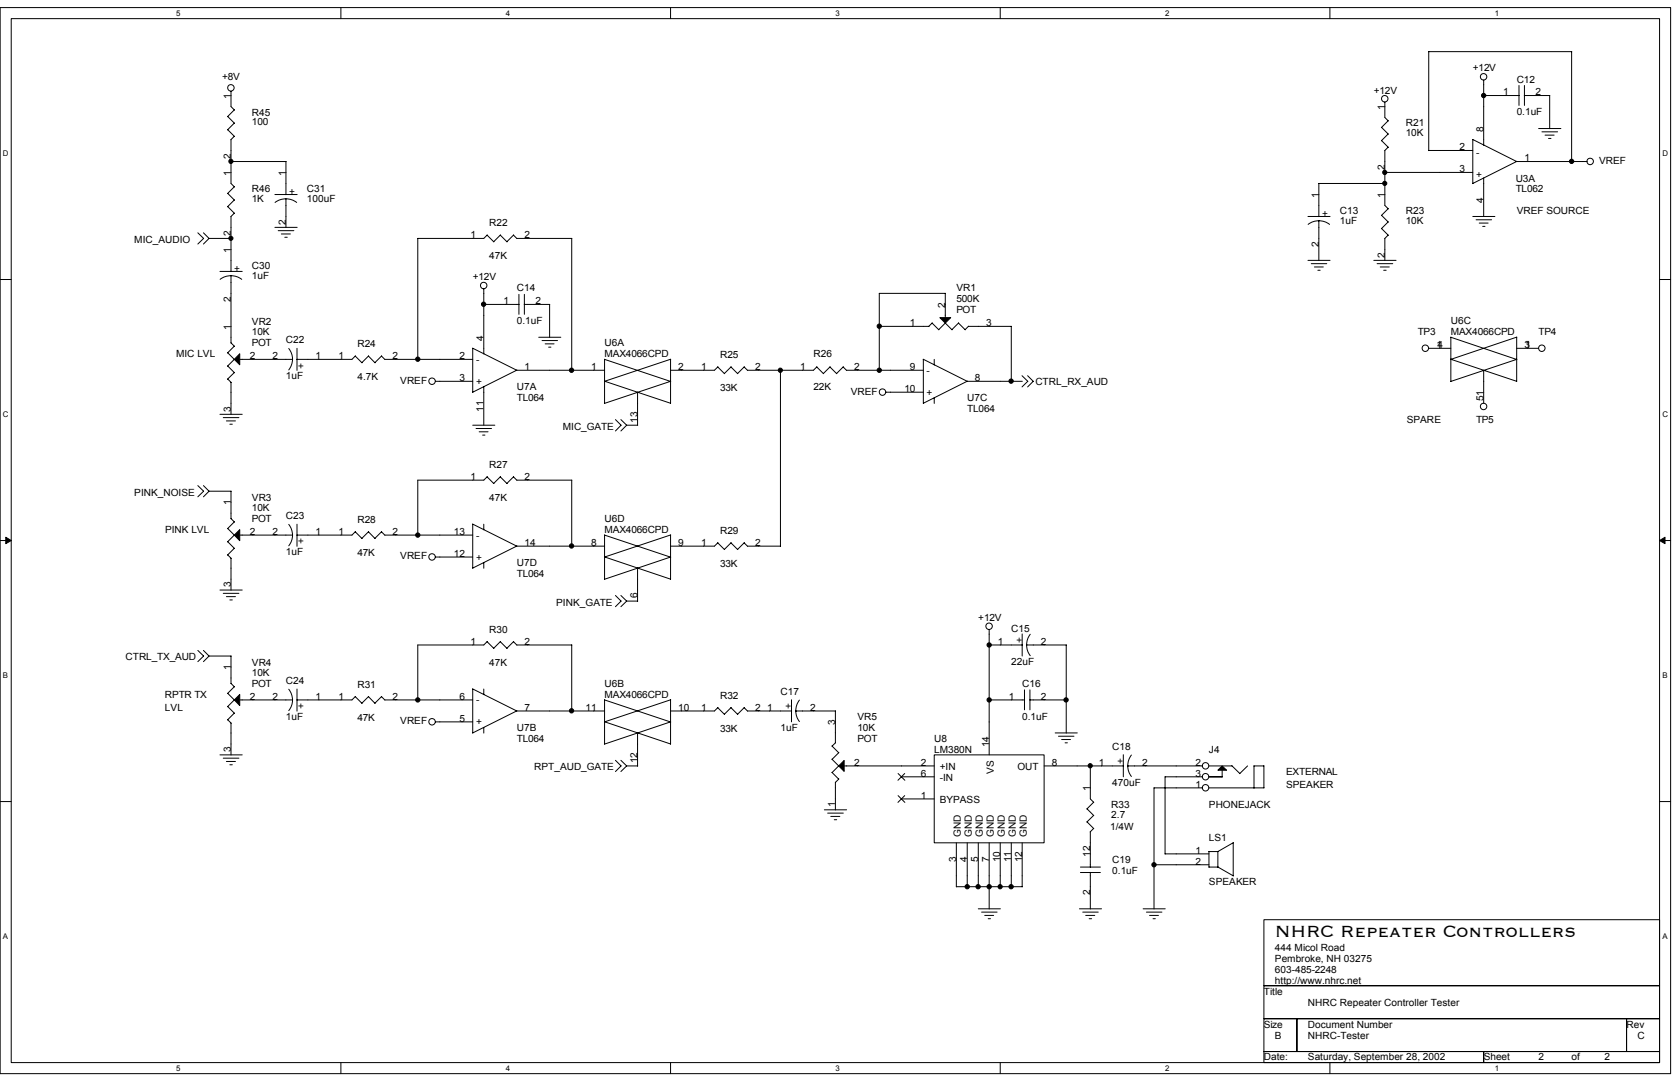
[picture p150: page 2]

NHRC Repeater Controllers 444 Micol Road Pembroke, NH 03275 603-485-2248 http://www.nhrc.net

Title NHRC Repeater Controller Tester

Size B | Document Number NHRC-Tester | | Rev C

Date: Saturday, September 28, 2002 | | Sheet 2 of 2
