nhrc-net/NHRC_Repeater_Controllers/nhrc-vox/doc/VOX CONCEPT DRAWING.pdf

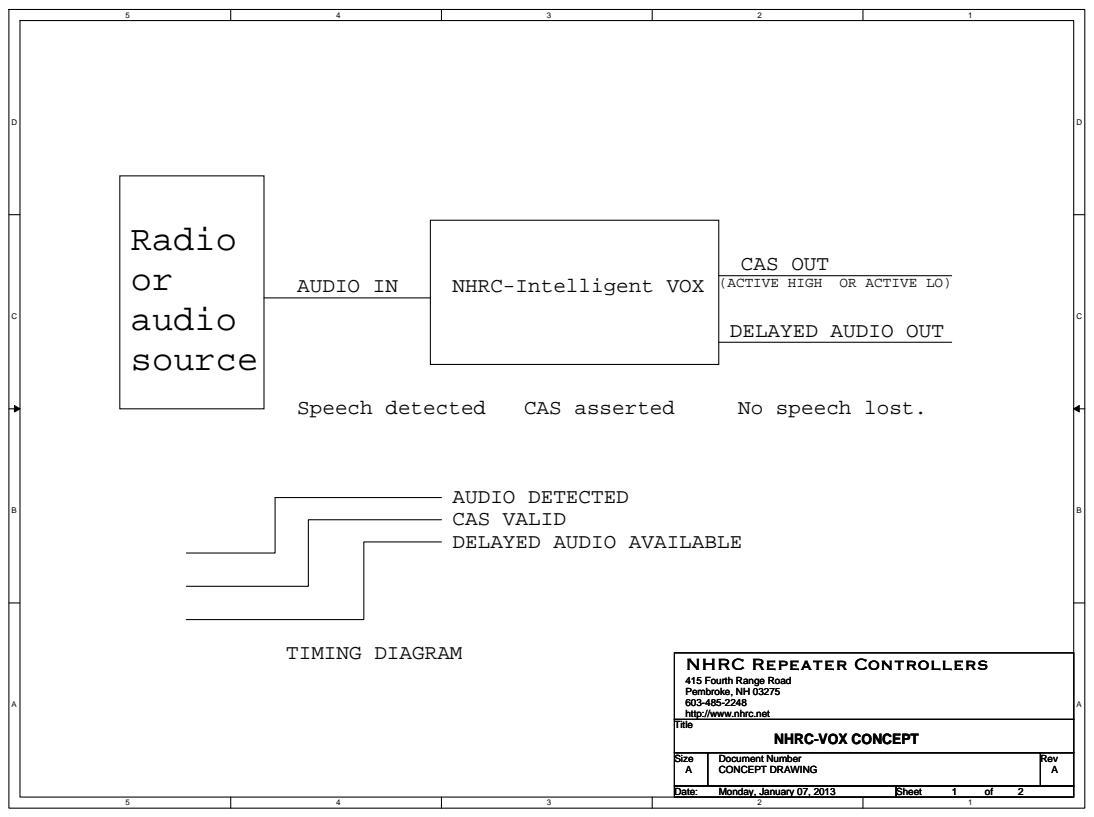
[picture p151: page 1]
Radio or audio source; AUDIO IN; NHRC-Intelligent VOX; Speech detected; CAS asserted; No speech lost.; TIMING DIAGRAM

CAS OUT
(ACTIVE HIGH OR ACTIVE LO)
DELAYED AUDIO OUT

AUDIO DETECTED
CAS VALID
DELAYED AUDIO AVAILABLE

NHRC Repeater Controllers

415 Fourth Range Road
Pembroke, NH 03275
http://www.nhrc.net
Title

NHRC-VOX CONCEPT

Size Size Size A A A | Document Number Document Number Document Number CONCEPT DRAWING CONCEPT DRAWING CONCEPT DRAWING | Rev Rev Rev A A A

Date: Date: Date: Monday, January 07, 2013 Monday, January 07, 2013 Monday, January 07, 2013 | Sheet Sheet Sheet 1 1 1 of of of 2 2 2
