nhrc-net/NHRC_Repeater_Controllers/nhrc-10/hw/nhrc10-schem-20011122.pdf

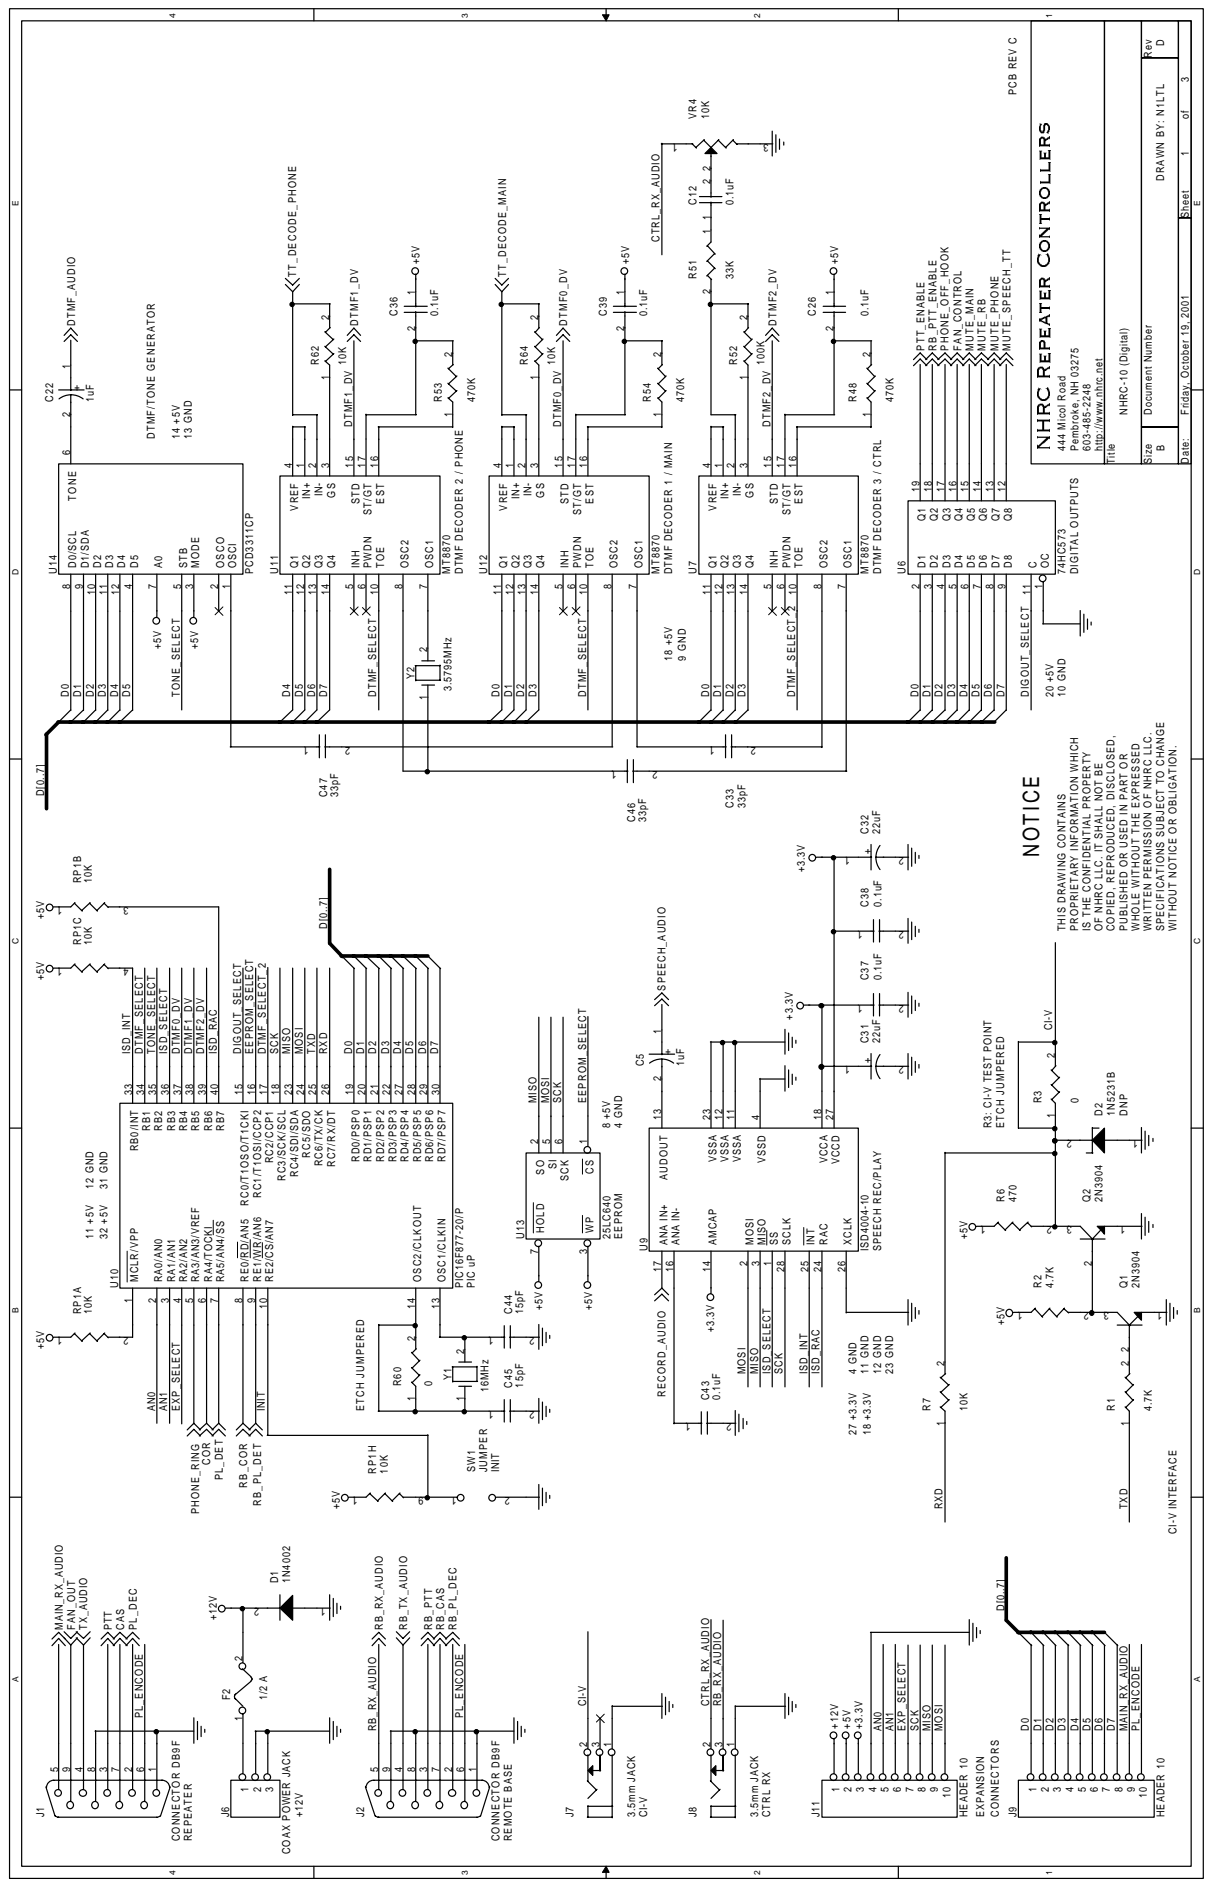
[picture p152: page 1]

Size Document Number Rev

http://www.nhrc.net

SPECIFICATIONS SUBJECT TO CHANGE

WHOLE WITHOUT THE EXPRESSED

WRITTEN PERMISSION OF NHRC LLC.

IS THE CONFIDENTIAL PROPERTY

OF NHRC LLC. IT SHALL NOT BE

PUBLISHED OR USED IN PART OR

WITHOUT NOTICE OR OBLIGATION.

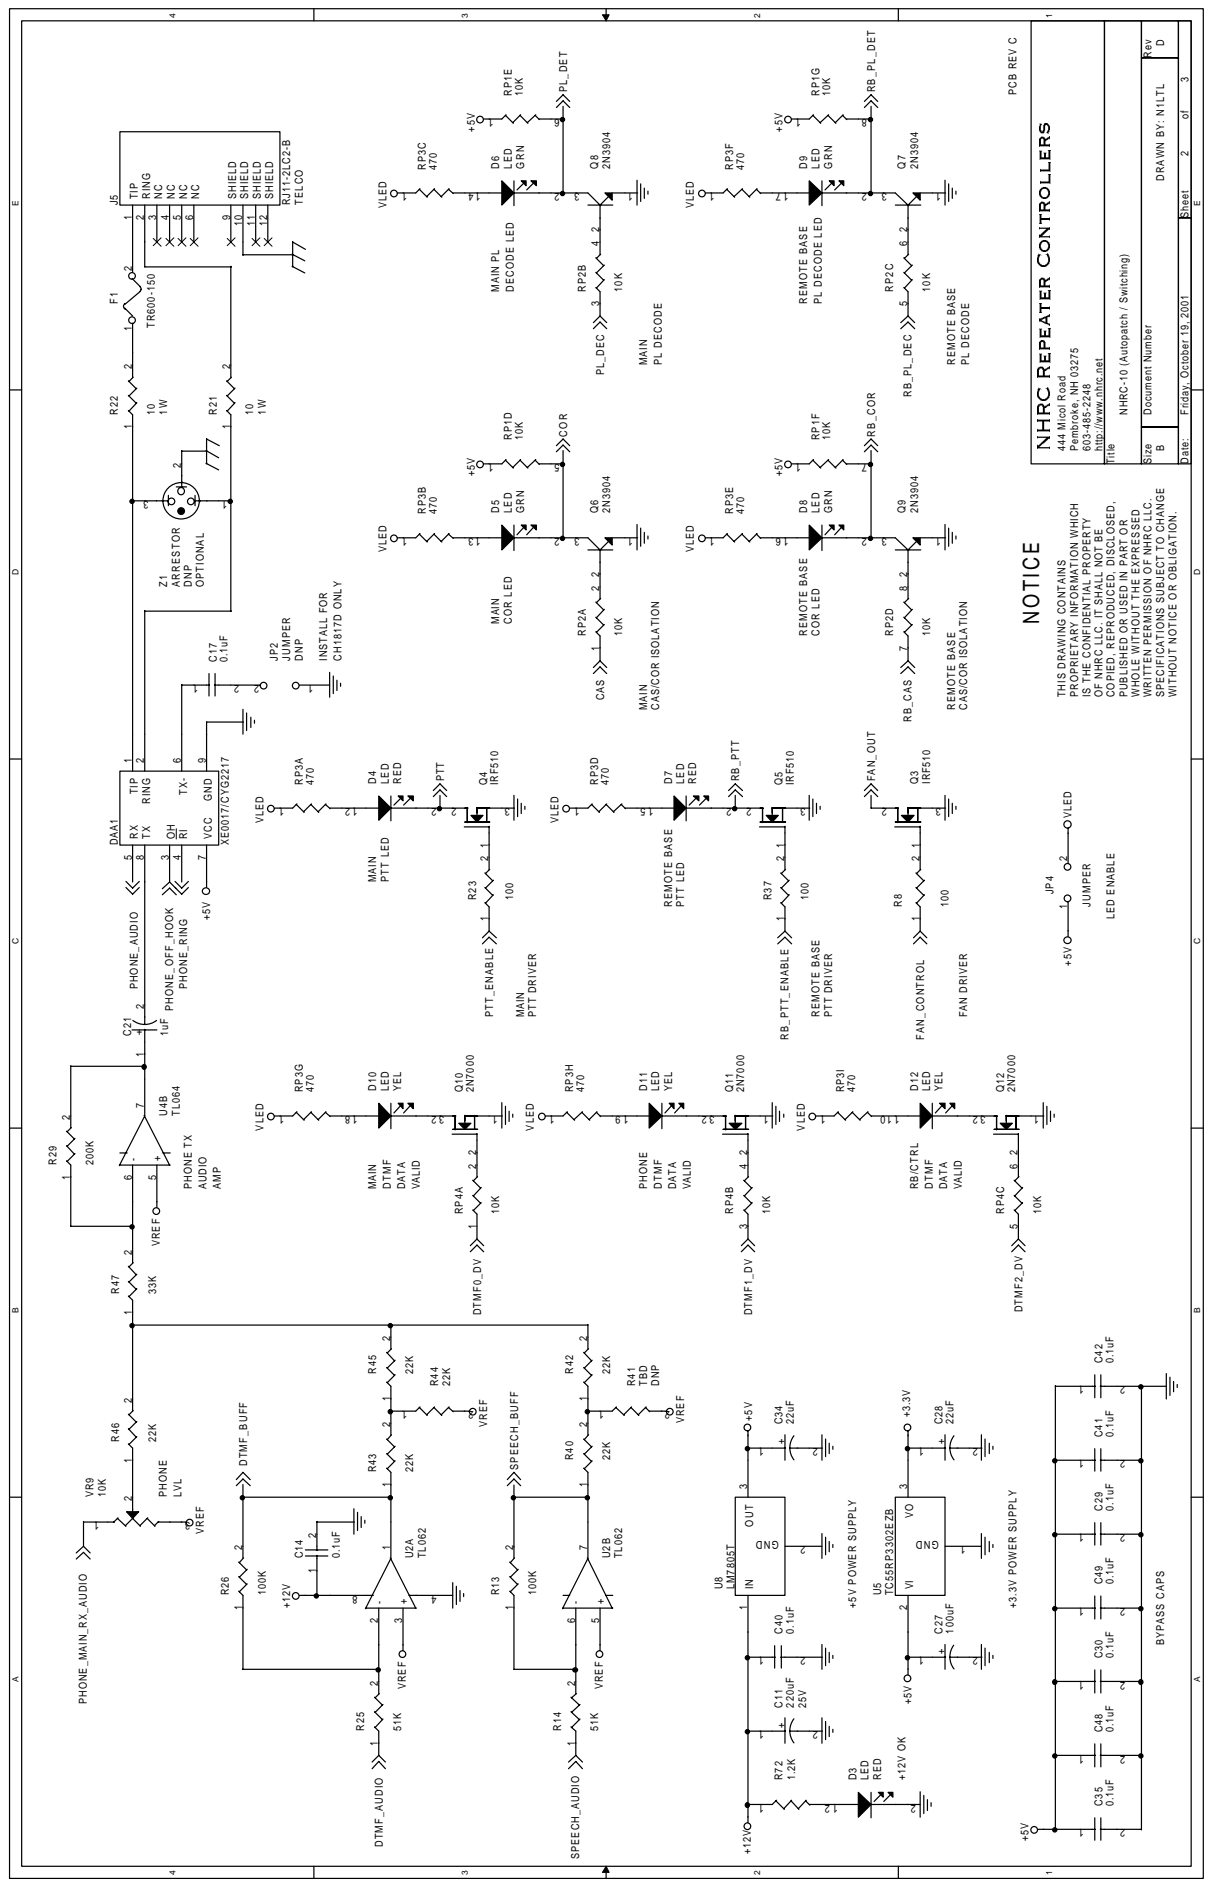
[picture p153: page 2]

Size Document Number Rev

http://www.nhrc.net

WRITTEN PERMISSION OF NHRC LLC.

SPECIFICATIONS SUBJECT TO CHANGE

IS THE CONFIDENTIAL PROPERTY

PUBLISHED OR USED IN PART OR

WHOLE WITHOUT THE EXPRESSED

WITHOUT NOTICE OR OBLIGATION.

OF NHRC LLC. IT SHALL NOT BE

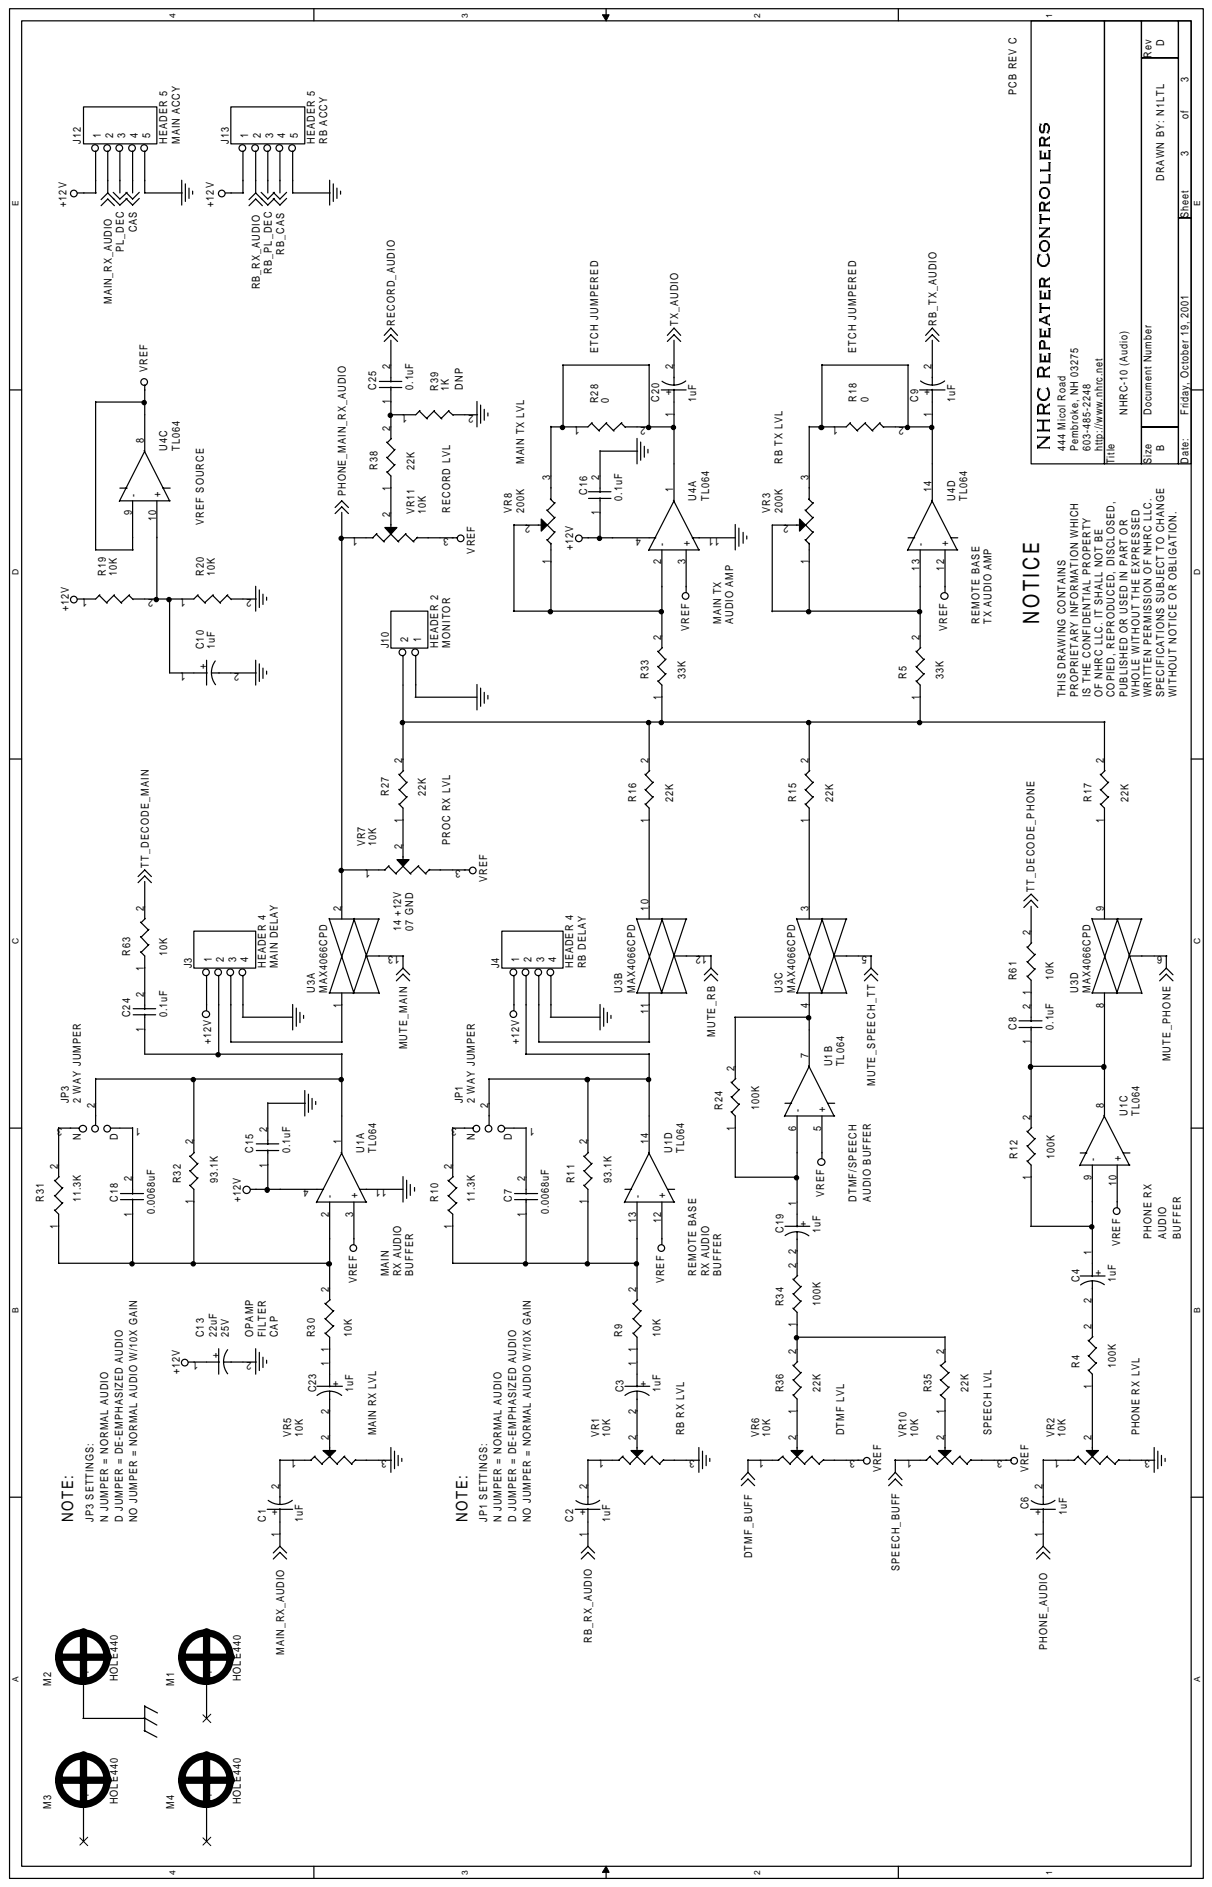
[picture p154: page 3]

Size Document Number Rev

http://www.nhrc.net

PROC RX LVL RECORD LVL

WRITTEN PERMISSION OF NHRC LLC.

SPECIFICATIONS SUBJECT TO CHANGE

IS THE CONFIDENTIAL PROPERTY

PUBLISHED OR USED IN PART OR

WHOLE WITHOUT THE EXPRESSED

WITHOUT NOTICE OR OBLIGATION.

OF NHRC LLC. IT SHALL NOT BE

NO JUMPER = NORMAL AUDIO W/10X GAIN

D JUMPER = DE-EMPHASIZED AUDIO
