nhrc-net/NHRC_Repeater_Controllers/nhrc-2/hw/nhrc-2.pdf

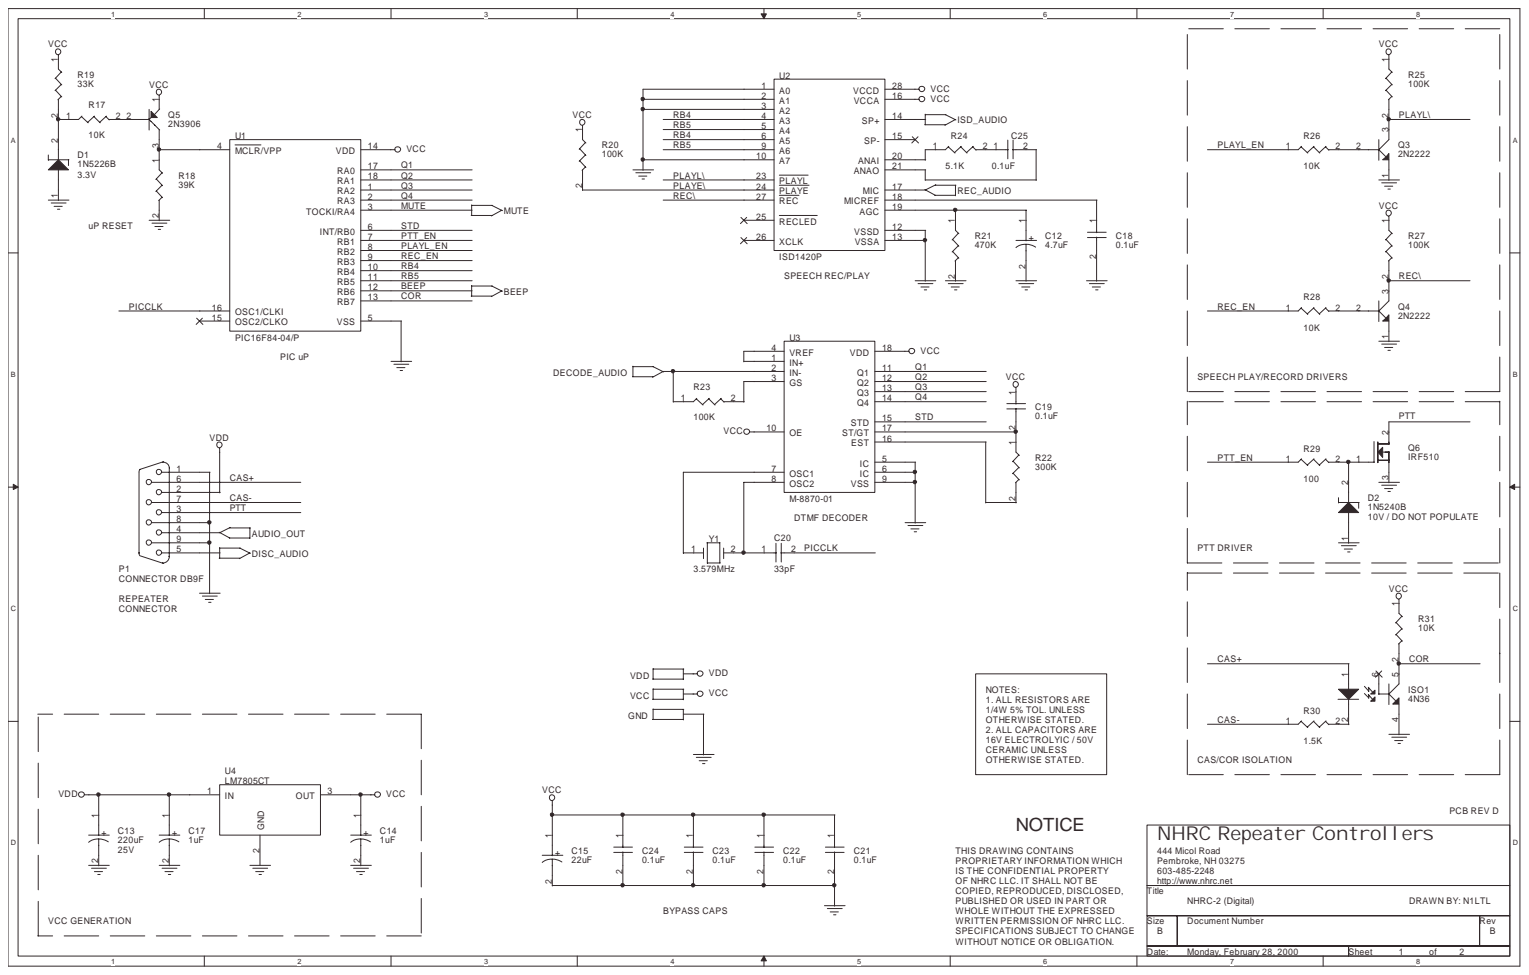
[picture p155: page 1]

SPEECH PLAY/RECORD DRIVERS

NHRC Repeater Controllers
444 Micol Road
Pembroke, NH 03275
http://www.nhrc.net
Title

THIS DRAWING CONTAINS
PROPRIETARY INFORMATION WHICH
IS THE CONFIDENTIAL PROPERTY
OF NHRC LLC. IT SHALL NOT BE
COPIED, REPRODUCED, DISCLOSED,
PUBLISHED OR USED IN PART OR
WHOLE WITHOUT THE EXPRESSED
WRITTEN PERMISSION OF NHRC LLC.
SPECIFICATIONS SUBJECT TO CHANGE
WITHOUT NOTICE OR OBLIGATION.

Size B | Document Number | | Rev B

Date: Monday, February 28, 2000 | | Sheet 1 of 2

C3 | NOTE:

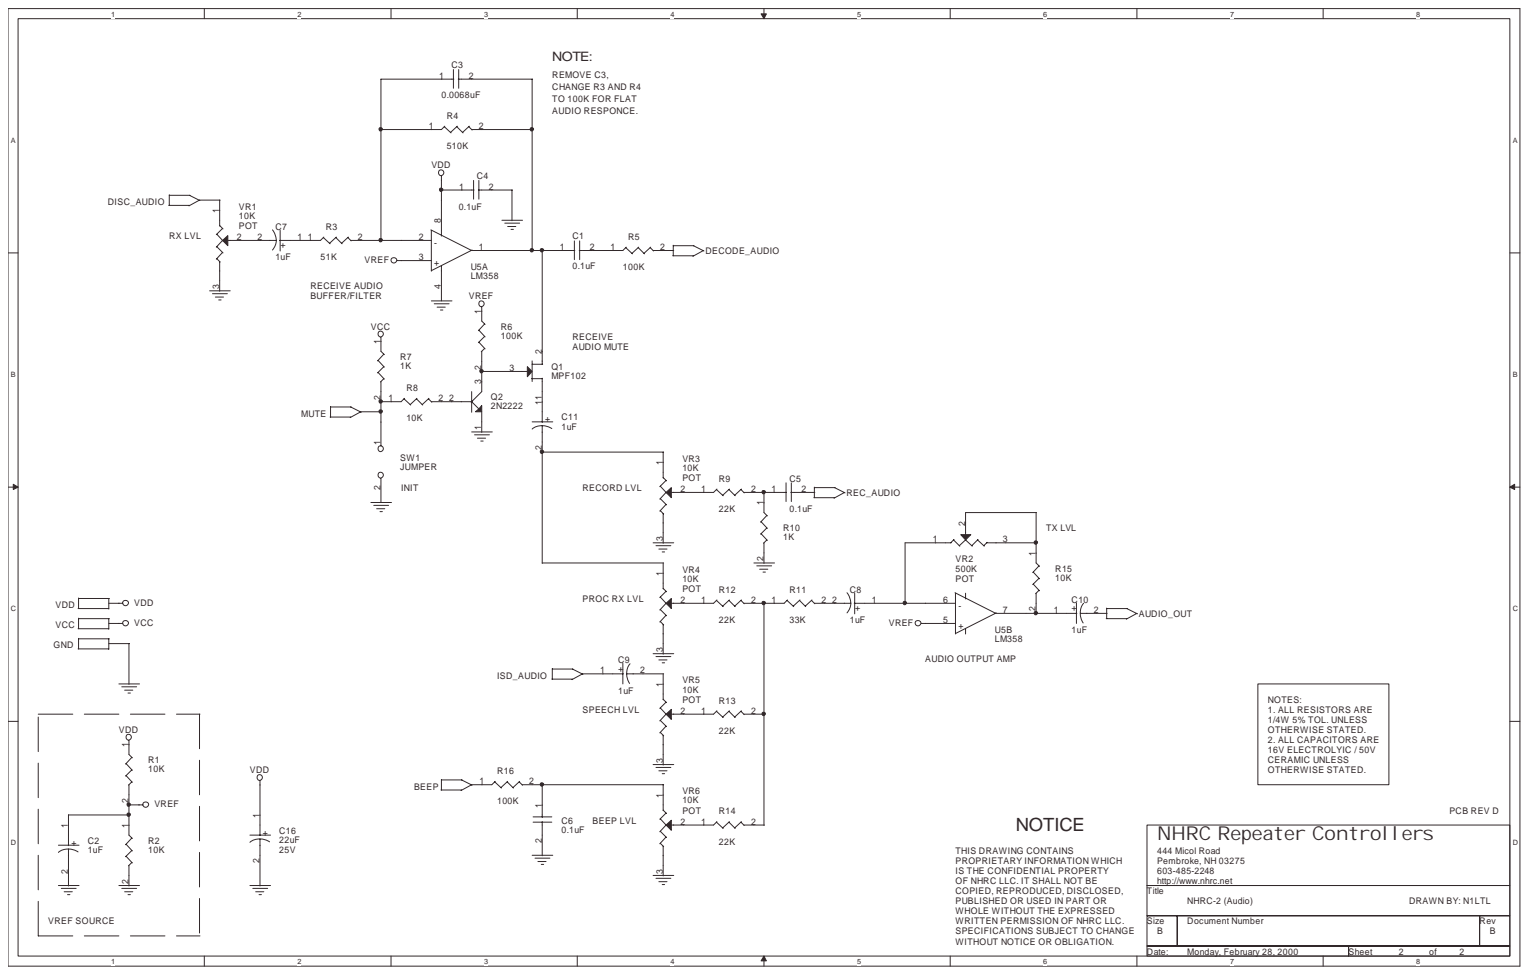
[picture p156: page 2]

VDD C4

NHRC Repeater Controllers 444 Micol Road Pembroke, NH 03275 603-485-2248 http://www.nhrc.net

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

Title NHRC-2 (Audio) | DRAWN BY: N1LTL

Size B | Document Number | | Rev B

Date: Monday, February 28, 2000 | | Sheet 2 of 2
