nhrc-net/NHRC_Repeater_Controllers/nhrc-10 programmer/Programmer/resource.h

//{{NO_DEPENDENCIES}}
// Microsoft Visual C++ generated include file.
// Used by Programmer.rc
//
#define IDC_MYICON                      2
#define IDD_PROGRAMMER_DIALOG           102
#define IDD_ABOUTBOX                    103
#define IDS_APP_TITLE                   103
#define IDM_ABOUT                       104
#define IDM_EXIT                        105
#define IDS_HELLO                       106
#define IDC_PROGRAMMER                  109
#define IDR_MAINFRAME                   128
#define IDD_TRANSFER                    129
#define IDI_N                           131
#define IDI_A_PROGRAMMER                132
#define IDD_PREFIXES                    137
#define IDD_TIMERS                      138
#define IDD_AUTOPATCH                   139
#define IDD_AUTODIALS                   140
#define IDD_EMERGENCYAUTODIALS          141
#define IDD_COURTESYTONES               142
#define IDD_CONTROLOP                   143
#define IDD_CWID                        144
#define IDD_EDIT_EXCHANGES              145
#define IDC_PROGRESSBAR                 1000
#define IDC_EPATCH_EDIT_0               1000
#define IDC_APATCH_EDIT_0               1000
#define IDC_CTLOP_CB_0                  1000
#define IDC_HEADING                     1000
#define IDC_CTLOP_CB_1                  1001
#define IDC_MESSAGE                     1001
#define IDC_EPATCH_EDIT_1               1001
#define IDC_APATCH_EDIT_1               1001
#define IDC_EDIT1                       1001
#define IDC_AREACODE                    1001
#define IDC_SEG_1_LENGTH_EDIT           1001
#define IDC_CTLOP_CB_2                  1002
#define IDC_ABOUT_TEXT                  1002
#define IDC_EPATCH_EDIT_2               1002
#define IDC_APATCH_EDIT_2               1002
#define IDC_CHECK1                      1002
#define IDC_BANK_ENABLE                 1002
#define IDC_BANK_ENABLED                1002
#define IDC_SEG_2_LENGTH_EDIT           1002
#define IDC_SEG_3_LENGTH_EDIT           1003
#define IDC_CHECK2                      1003
#define IDC_CTLOP_CB_3                  1003
#define IDC_EPATCH_EDIT_3               1003
#define IDC_APATCH_EDIT_3               1003
#define IDC_LEADING_1_ALLOWED           1003
#define IDC_SEG_4_LENGTH_EDIT           1004
#define IDC_CHECK3                      1004
#define IDC_CTLOP_CB_4                  1004
#define IDC_EPATCH_EDIT_4               1004
#define IDC_APATCH_EDIT_4               1004
#define IDC_LEADING_1_REQUIRED          1004
#define IDC_CHECK4                      1005
#define IDC_CTLOP_CB_5                  1005
#define IDC_PFX_EDIT_00                 1005
#define IDC_EPATCH_EDIT_5               1005
#define IDC_APATCH_EDIT_5               1005
#define IDC_LOCAL_AREA_CODE             1005
#define IDC_CHECK5                      1006
#define IDC_CTLOP_CB_6                  1006
#define IDC_PFX_EDIT_01                 1006
#define IDC_TIMER_EDIT_00               1006
#define IDC_EPATCH_EDIT_6               1006
#define IDC_APATCH_EDIT_6               1006
#define IDC_DIAL_PREFIX_ENABLED         1006
#define IDC_CTLOP_CB_7                  1007
#define IDC_PFX_EDIT_02                 1007
#define IDC_TIMER_EDIT_01               1007
#define IDC_EPATCH_EDIT_7               1007
#define IDC_APATCH_EDIT_7               1007
#define IDC_PFX_EDIT_03                 1008
#define IDC_TIMER_EDIT_02               1008
#define IDC_EPATCH_EDIT_8               1008
#define IDC_APATCH_EDIT_8               1008
#define IDC_PFX_EDIT_04                 1009
#define IDC_TIMER_EDIT_03               1009
#define IDC_EPATCH_EDIT_9               1009
#define IDC_APATCH_EDIT_9               1009
#define IDC_APATCH_LABEL_0              1010
#define IDC_PFX_EDIT_05                 1010
#define IDC_TIMER_EDIT_04               1010
#define IDC_EDIT2                       1010
#define IDC_DIAL_PREFIX                 1010
#define IDC_APATCH_LABEL_1              1011
#define IDC_PFX_EDIT_06                 1011
#define IDC_TIMER_EDIT_05               1011
#define IDC_BUTTON1                     1011
#define IDC_ENABLE_ALL_BUTTON           1011
#define IDC_APATCH_LABEL_2              1012
#define IDC_PFX_EDIT_07                 1012
#define IDC_TIMER_EDIT_06               1012
#define IDC_DISABLE_ALL_BUTTON          1012
#define IDC_APATCH_LABEL_3              1013
#define IDC_PFX_EDIT_08                 1013
#define IDC_TIMER_EDIT_07               1013
#define IDC_EDIT_BUTTON                 1013
#define IDC_APATCH_LABEL_4              1014
#define IDC_PFX_EDIT_09                 1014
#define IDC_TIMER_EDIT_08               1014
#define IDC_COMBO1                      1014
#define IDC_HUNDREDS_COMBO              1014
#define IDC_TONE_SELECT_COMBO           1014
#define IDC_APATCH_LABEL_5              1015
#define IDC_PFX_EDIT_10                 1015
#define IDC_TIMER_EDIT_09               1015
#define IDC_LABEL_0                     1015
#define IDC_LABEL_1                     1016
#define IDC_APATCH_LABEL_6              1016
#define IDC_PFX_EDIT_11                 1016
#define IDC_TIMER_EDIT_10               1016
#define IDC_TONES_RADIO                 1016
#define IDC_LABEL_2                     1017
#define IDC_APATCH_LABEL_7              1017
#define IDC_PFX_EDIT_12                 1017
#define IDC_TIMER_EDIT_11               1017
#define IDC_CWCHAR_RADIO                1017
#define IDC_LABEL_3                     1018
#define IDC_APATCH_LABEL_8              1018
#define IDC_PFX_EDIT_13                 1018
#define IDC_TIMER_EDIT_12               1018
#define IDC_SEG_1_PITCH_COMBO           1018
#define IDC_SEG_2_PITCH_COMBO           1019
#define IDC_LABEL_4                     1019
#define IDC_APATCH_LABEL_9              1019
#define IDC_PFX_EDIT_14                 1019
#define IDC_TIMER_EDIT_13               1019
#define IDC_SEG_3_PITCH_COMBO           1020
#define IDC_LABEL_5                     1020
#define IDC_PFX_EDIT_15                 1020
#define IDC_RANGE_COMBO                 1020
#define IDC_SEG_4_PITCH_COMBO           1021
#define IDC_LABEL_6                     1021
#define IDC_SAVEDSETUPMESSAGE           1021
#define IDC_LABEL_7                     1022
#define IDC_GROUP_COMBO                 1022
#define IDC_COMBO3                      1022
#define IDC_CWCHAR_COMBO                1022
#define IDC_LABEL_8                     1023
#define IDC_CWIDTEXT                    1023
#define IDC_LABEL_9                     1024
#define IDC_CHECK00                     1100
#define IDC_CHECK01                     1101
#define IDC_CHECK02                     1102
#define IDC_CHECK03                     1103
#define IDC_CHECK04                     1104
#define IDC_CHECK05                     1105
#define IDC_CHECK06                     1106
#define IDC_CHECK07                     1107
#define IDC_CHECK08                     1108
#define IDC_CHECK09                     1109
#define IDC_CHECK10                     1110
#define IDC_CHECK11                     1111
#define IDC_CHECK12                     1112
#define IDC_CHECK13                     1113
#define IDC_CHECK14                     1114
#define IDC_CHECK15                     1115
#define IDC_CHECK16                     1116
#define IDC_CHECK17                     1117
#define IDC_CHECK18                     1118
#define IDC_CHECK19                     1119
#define IDC_CHECK20                     1120
#define IDC_CHECK21                     1121
#define IDC_CHECK22                     1122
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
#define ID_AUTOPATCH_AREACODE00         32788
#define ID_AUTOPATCH_AREACODE01         32789
#define ID_AUTOPATCH_AREACODE02         32790
#define ID_AUTOPATCH_AREACODE03         32791
#define ID_AUTOPATCH_AREACODE04         32792
#define ID_AUTOPATCH_AREACODE05         32793
#define ID_AUTOPATCH_AREACODE06         32794
#define ID_AUTOPATCH_AREACODE07         32795
#define ID_AUTOPATCH_AREACODE08         32796
#define ID_AUTOPATCH_AREACODE09         32797
#define ID_AUTOPATCH_AREACODE10         32798
#define ID_AUTOPATCH_AREACODE11         32799
#define ID_AUTOPATCH_AREACODE12         32800
#define ID_AUTOPATCH_AREACODE13         32801
#define ID_AUTOPATCH_AREACODE14         32802
#define ID_AUTOPATCH_AREACODE15         32803
#define ID_EDIT_EMERGENCYAUTODIALS      32804
#define ID_EDIT_CWID                    32805
#define ID_EDIT_COURTESYTONES           32806
#define IDC_STATIC                      -1

// Next default values for new objects
// 
#ifdef APSTUDIO_INVOKED
#ifndef APSTUDIO_READONLY_SYMBOLS
#define _APS_NEXT_RESOURCE_VALUE        133
#define _APS_NEXT_COMMAND_VALUE         32771
#define _APS_NEXT_CONTROL_VALUE         1023
#define _APS_NEXT_SYMED_VALUE           110
#endif
#endif
