nhrc-net/NHRC_Repeater_Controllers/nhrc-10/sw/nhrc-10.asm

	;; NHRC-10 Advanced Repeater Controller.
	;; Copyright 1998 - 2010, NHRC LLC,
	;; as an unpublished proprietary work.
	;; All rights reserved.
	;; No part of this document may be used or reproduced by any means,
	;; for any purpose, without the expressed written consent of NHRC LLC.

	;; x-121 31 January 2006 eXperimental version
	;; x-122 03 February 2009 anti-kerchunker features
	;; x-123 01 January 2010 better COR debounce timers
	;; NHRC-10 V 1.24 06 October 2010 initial ID disable defers CW ID
	;; NHRC-10 V 1.25 21 October 2010 adjustable cw tone and speed
	;; NHRC-10 V 1.26 15 July 2015 don't change # into delay on
	;;                   regenerated DTMF.  removed CW ID defer change
	;;                   from 1.24
	;; NHRC-10 v 1.27 24 December 2015.
	;;		     If voice initial ID is disabled, and
	;;		     hang time is also disabled, do not play
	;;		     initial CW id -- stealth mode.
	;;		     
	;;		     
	;;		     
VER_INT equ	d'1'
VER_HI	equ	d'2'
VER_LO	equ	d'7'

	ERRORLEVEL 0, -302,-306 ; suppress Argument out of range errors

	IFDEF __16F877
	include "p16f877.inc"
	__FUSES _PWRTE_ON & _HS_OSC & _LVP_OFF & _CP_ALL & _WRT_ENABLE_OFF
	ENDIF

	IFDEF __16F877A	
	include "p16f877a.inc"
	__FUSES _PWRTE_ON & _HS_OSC & _LVP_OFF & _CP_ALL
	ENDIF

	IFDEF __16F887
	include "p16f887.inc"
	__CONFIG _CONFIG1, _PWRTE_ON & _HS_OSC & _LVP_OFF & _CP_ON
	ENDIF
		
	include "eeprom64.inc"
	include "vocab.inc"

;macro definitions for ROM paging.
	
PAGE0	macro			; select page 0
	bcf	PCLATH,3
	bcf	PCLATH,4
	endm

PAGE1	macro			; select page 1
	bsf	PCLATH,3
	bcf	PCLATH,4
	endm

PAGE2	macro			; select page 2
	bcf	PCLATH,3
	bsf	PCLATH,4
	endm

PAGE3	macro			; select page 3
	bsf	PCLATH,3
	bsf	PCLATH,4
	endm

TEN	equ	D'10'		; decade counter.

; ******************************************
; ** 25C320 EEPROM COMMANDS AND ADDRESSES ** 
; ******************************************

EEWREN	equ	b'00000110'	; set write enable latch
EEWRDI	equ	b'00000100'	; reset write enable latch
EERDSR	equ	b'00000101'	; read status register
EEWRSR	equ	b'00000001'	; write status register
EEREAD	equ	b'00000011'	; read array
EEWRITE equ	b'00000010'	; write array

; **********************
; ** ISD4004 COMMANDS **
; **********************

	;; note that only the 5 most significant bits of the command
	;; is used, the 3 least significant bits are used as part of
	;; message address.  Command word is stored in isdCmdC,
	;; address bytes in isdCmdH and isdCmdL

ISDCUE	equ	4		; ISD C0 bit - message cueing
ISDIAB	equ	3		; ISD C1 bit - ignore address bits
ISDPUP	equ	2		; ISD C2 bit - power up
ISDPLAY equ	1		; ISD C3 bit - Play / \record\
ISDRUN	equ	0		; ISD C4 bit - Run

	;; control flags for ISD operation.
	;; stored in isdFlag
ISDRUNF equ	0		; ISD is running
ISDRECF equ	1		; ISD is recording
ISDIABF equ	2		; ISD has had IAB set.
ISDRACF equ	3		; ISD wants RAC attention from service routine
ISDD4RC equ	4		; deferred record operation.
ISDTEST equ	5		; playback test message after recording.
ISDWRDF equ	6		; ISD wants another word.  Feed it.
ISDRECR equ	7		; ISD waiting to start recording on next keyup.


	;; constants for various ISD timers
ISD_DLY equ	d'100'		; ISD start delay (ms).
ISDDLYC equ	d'200'		; have to stop in record before the last
				; 31.25 ms marker passes us by. so last row
				; will only get ISDLREC ms. (200 of 250)
	
; *************************
; ** IO Port Assignments **
; *************************

; PORT A
LED1	equ	0		; debug LED output on A.0  watchdog timeout
LED2	equ	1		; debug LED output on A.1  Alive Blinker
EXPSEL	equ	2		; expansion port select on A.2
PHRING	equ	3		; phone ring detect input on A.3
RX0COR	equ	4		; COR input on A.4
RX0PL	equ	5		; CTCSS input on A.5

; PORT B
; B.0 is ISD interrupt input
DTMFSEL equ	1		; DTMF select output on B.1
TONESEL equ	2		; DTMF/TONE gen select output on B.2
ISDSEL	equ	3		; ISD SPI SS output on B.3
DTMF0DV equ	4		; DTMF decoder 0 DV input on B.4
DTMF1DV equ	5		; DTMF decoder 1 DV input on B.5
DTMF2DV equ	6		; DTMF decoder 2 DV input on B.6
ISDRAC	equ	7		; ISD row address clock input on B.7

; PORT C
OUTSEL	equ	0		; digital output select output on C.0 (outPort)
EEPSEL	equ	1		; EEPROM SPI SS output on C.1
DTMF2SE equ	2		; DTMF decoder 2 select on C.2
; C.3 is SPI clock
; C.4 is SPI MISO (mpu input)
; C.5 is SPI MOSI (mpu output)
; C.6 is SCI TXD
; C.7 is SCI RXD
	
; PORT D
; port D is all data I/O for DTMF 0 & 1, DTMF/Tone generator, digital out latch
	 
; PORT E
RX1COR	equ	0		; link COR input on E.0
RX1PL	equ	1		; link CTCSS input on E.1
INIT	equ	2		; init button input on E.2

; *******************
; ** Control Flags **
; *******************
	
; outPort
TX0PTT	equ	0		; main transmitter PTT
TX1PTT	equ	1		; link transmitter PTT
FONECTL equ	2		; phone off-hook
FANCTL	equ	3		; fan control
RX0AUD	equ	4		; main receiver audio gate
RX1AUD	equ	5		; link receiver audio gate
FONEAUD equ	6		; phone patch audio gate
BEEPAUD equ	7		; beep/voice audio gate
		
;tFlags				; timer flags	     
TICK	equ	0		; TICK indicator
ONEMS	equ	1		; 1 ms tick flag
TENMS	equ	2		; 10 ms tick flag
HUNDMS	equ	3		; 100 ms tick flag
ONESEC	equ	4		; 1 second tick flag
TENSEC	equ	5		; 10 second flag...
; niy	equ	6		; NIY
CWBEEP	equ	7		; cw beep is on.
	
;flags
initID	equ	0		; need to ID now
needID	equ	1		; need to send ID
TXONFLG equ	2		; last TX state flag
CMD_NIB equ	3		; command interpreter nibble flag for copy
DEF_CT	equ	4		; deferred courtesy tone.
DEFFONE equ	5		; deferred fone call.
RBMUTE	equ	6		; remote base muted flag.
CHUNKED	equ	7		; Kerchunked since last ID

;mscFlag			; misc flags...
DT0ZERO equ	0		; dtmf-0 last received 0
DT2ZERO equ	1		; dtmf-2 last received 0
LITZDT0 equ	2		; LiTZ on DTMF-0
LITZDT2 equ	3		; LiTZ on DTMF-2
NNXIE	equ	4		; NNX initialization in progress
CIV_RDY equ	5		; CI-V command received for interpretation.
CTCSS0	equ	6		; last CTCSS on main receiver
CTCSS2	equ	7		; last CTCSS on link receiver

; txFlag
RX0OPEN equ	0		; main receiver repeating
RX1OPEN equ	1		; link receiver repeating
TXHANG	equ	2		; hang time
PATCHON equ	3		; autopatch is on
DTMFING equ	4		; DTMF generation in progress
TALKING equ	5		; ISD playing back
BEEPING equ	6		; beep tone active
CWPLAY	equ	7		; CW playing

; idRFlag -- id & tail message rotate control flag
IDR0	equ	0		; ID rotate bit 0
IDR1	equ	1		; ID rotate bit 1
TAILR0	equ	2		; tail message rotate bit 0
TAILR1	equ	3		; tail message rotate bit 1
TAILRM	equ	4		; tail message rotate bit 2 (mbx)
; NIY	equ	5		; NIY
; NIY	equ	6		; NIY
IDNOW	equ	7		; id in progress now.

; beepCtl -- beeper control flags...
B_ADR0	equ	0		; beep or CW addressing mode indicator
B_ADR1	equ	1		; beep or CW addressing mode indicator
				;   00 from EEPROM, saved messages.
				;   01 from lookup table, built in messages.
				;   10 from RAM, generated messages.
				;   11 CW single letter mode.
				; 
B_BEEP	equ	2		; beep sequence in progress
B_CW	equ	3		; CW transmission in progress
B_DTMF	equ	4		; beeping out DTMF (autospace 5 counts)
B_PAUSE equ	5		; DTMF intra-digit pause.
B_LAST	equ	6		; last segment of CT tones.
B_MAIN	equ	7		; enable main port audio switch

CTPAUSE equ	d'5'		; 50 msec pause before CT.
DTMFLEN equ	d'10'		; 100 msec. digit/space length.
DTMFPRE equ	d'150'		; 1500 msec. predial delay.
DTMFPOZ equ	d'90'		; 900 msec. # pause.

;; beepCtl preset masks
BEEP_CT equ	b'10000100'	; CT from EEPROM
BEEP_CX equ	b'10000101'	; CT from ROM table
;BEEP_DT equ	 b'00111110'	 ; DTMF from RAM
BEEP_DT equ	b'00110110'	; DTMF from RAM
BEEPDTA equ	b'10110110'	; DTMF from RAM, over air.
BEEPADT equ	b'00110100'	; DTMF from EEPROM
CW_ROM	equ	b'10001001'	; CW from ROM table
CW_EE	equ	b'10001000'	; CW from EEPROM
CW_LETR	equ	b'10001011'	; CW, one letter only, from EE.

MAGICCT	equ	d'99'		; magic CT length, next digit is CW character.

;; mbxFlag -- voice mailbox control flag
;; low order 6 bits are used to indicate message presence

;; mbxCtl -- mailbox control flag for state machine
;;; need to indicate recording header or what else?
;; low order 4 bits indicate last message played.
MBXRHDR equ	5		; ready to record mailbox header.
MBXRMBX equ	6		; ready to record mailbox.
MBXLPLA equ	7		; last mailbox op was a play.

;; nnxInit -- call restrictions init control flag
NNXIA0	equ	0		; NNX init address indicator bit 0.
NNXIA1	equ	1		; NNX init address indicator bit 1.
NNXIA2	equ	2		; NNX init address indicator bit 2.
NNXCB	equ	3		; control bit--enable or disable NNXs.
NNXBI0	equ	4		; NNX init area code bank index bit 0.
NNXBI1	equ	5		; NNX init area code bank index bit 1.
NNXBI2	equ	6		; NNX init area code bank index bit 2.
NNXBI3	equ	7		; NNX init area code bank index bit 3.
	
;; COR debounce time
COR1DEB equ	5		; 5 ms.	 COR off to on debounce time
COR0DEB equ	5		; 5 ms.	 COR on to off debounce time
DLY1DEB equ	d'100'		; 100 ms. COR off->on debounce time, with DAD.
DLY0DEB equ	d'50'		; 50 ms.  COR on->off debounce time, with DAD.
CHNKDEB	equ	d'250'		; 250 ms.

IDSOON	equ	D'6'		; ID soon, polite IDer threshold, 60 sec
MUTEDLY equ	D'20'		; DTMF muting timer = 2.0 sec.
DTMFDLY equ	d'50'		; DTMF activity timer = 5.0 sec.
LITZTIM equ	d'20'		; 5.0-3.0=2.0 time left on DTMF timer for LITZ
UNLKDLY equ	d'120'		; unlocked mode timer.
	
; dtRFlag -- dtmf sequence received indicator
DT0RDY	equ	0		; some sequence received on DTMF-0
DT1RDY	equ	1		; some sequence received on DTMF-1
DT2RDY	equ	2		; some sequence received on DTMF-2
DTUL	equ	3		; command received from unlocked port.
DTSEVAL equ	4		; dtmf command evaluation in progress.
DT0UNLK equ	5		; unlocked indicator
DT1UNLK equ	6		; unlocked indicator
DT2UNLK equ	7		; unlocked indicator
		;; 
;dtEFlag -- DTMF command evaluator control flag.
	;; low order 5 bits indicate next prefix number/user command to scan
DT0CMD	equ	5		; received this command from dtmf0
DT1CMD	equ	6		; received this command from dtmf1
DT2CMD	equ	7		; received this command from dtmf2

; tuneFlg -- CI-V tune mode control flag
SUPP_OK equ	0		; suppress OK message (for fine tune.
; niy	equ	1		; NIY
; niy	equ	2		; NIY
; niy	equ	3		; NIY
DTTUNE	equ	4		; tune mode command.
DT0TUNE equ	5		; dtmf-0 CI-V fine tune mode.
DT1TUNE equ	6		; dtmf-1 CI-V fine tune mode.
DT2TUNE equ	7		; dtmf-2 CI-V fine tune mode.
	
; group6 -- digital output control flags.
D1PUL	equ	0		; digital output 1 is pulsed
D2PUL	equ	1		; digital output 2 is pulsed
D3PUL	equ	2		; digital output 3 is pulsed
D4PUL	equ	3		; digital output 4 is pulsed
D58PUL	equ	4		; digital outputs 5-8 are pulsed
DONEOF	equ	5		; digital outputs are in one-of mode.
; NIY	eqy	6		; NIY
; NIY	eqy	7		; NIY

PULS_TM equ	d'50'		; 50 x 10 ms = 500 ms.	pulse duration time.

; CI-V commands.
; CI-V bus addresses
CIV_ME	equ	h'E0'		; my CI-V address.
CIV_PC	equ	h'E1'		; Programming PC's CI-V address.
CIV_706 equ	h'48'		; IC-706's CI-V address.

; responses (radio to controller)
CIV_OK	equ	h'FB'		; fine business.
CIV_BAD equ	h'FA'		; facked ap command.
CIV_EOM	equ	h'FD'		; CI-V end of message.
CIV_PRE	equ	h'FE'		; CI-V preamble byte (sent twice)
	
; commands and command responses
CIV_RDF equ	h'03'		; read out frequency.
CIV_RDM equ	h'04'		; read out mode & PB width.
CIV_PVT	equ	h'77'		; NHRC private CI-V command.
CIV_PRD	equ	h'00'		; EEPROM Read subcommand.
CIV_WRT	equ	h'01'		; EEPROM Write subcommand.

; commands (controller to radio)
CIV_FRQ equ	h'05'		; write frequency to radio.
CIV_MOD equ	h'06'		; write mode to radio.
CIV_VFO equ	h'07'		; select VFO
				;    00 VFO A
				;    01 VFO B
				;    A0 copy this VFO to other VFO
				;    B0 swap this VFO with other VFO
CIV_MEM equ	h'08'		; memory command.
CIV_SPL equ	h'0F'		; select split/duplex operation.
				;    00 split off
				;    01 split on
				;    10 duplex off
				;    11 - duplex
				;    12 + duplex

CIVSCTM equ	d'25'		; CIV scan time 25 x 10 ms = 250 ms
	
; Ring Detect values.
RNG_DUR equ	d'250'		; 2500 ms (2 sec) ring duration timer.
RNG_TMO equ	d'80'		; 8.0 seconds ring timeout.
RNG_TON equ	h'14'		; address of ring tone in lookup table.
RNG_PLS equ	d'20'		; min. number of ring low polls for valid ring.
	
; receiver states
RXSOFF	equ	0
RXSON	equ	1
RXSTMO	equ	2

; cTone Courtesy tone selections
CTNONE	equ	h'ff'		; no courtesy tone.
CTNORM	equ	0		; normal courtesy tone
CTALERT equ	1		; alert mode alerted courtesy tone
CTRBTX	equ	2		; courtesy tone when link tx enabled
CTRRBRX equ	3		; courtesy tone link receiver link tx off
CTRRBTX equ	4		; courtesy tone link receiver link tx on
CTSPAR1 equ	5		; unused courtesy tone
CTTUNE	equ	6		; unused courtesy tone
CTUNLOK equ	7		; unlocked courtesy tone

; CW Message Addressing Scheme:
; These symbols represent the value of the CW characters in the ROM table.
;     1 - CW timeout message, "to"
;     2 - CW confirm message, "ok"
;     3 - CW bad message, "ng"
;     3 - CW link timeout "rb to"

CW_OK	equ	h'00'		; CW OK
CW_NG	equ	h'03'		; CW NG
CW_TO	equ	h'07'		; CW timeout

PATCBIP equ	h'10'		; patch expiry bip.
SCANBIP equ	h'0c'		; scan mode 100 KHz beep.

;
; CW sender constants
;

CWDIT	equ	1		; dit length in 100 ms
CWDAH	equ	CWDIT * 3	; dah 
CWIESP	equ	CWDIT		; inter-element space
CWILSP	equ	CWDAH		; inter-letter space
CWIWSP	equ	CWDIT * 7	; inter-word space

;
; Patch Area code config bits
;
ACENAB		equ	0	; this area code is enabled.
AC1OK		equ	1	; a leading one is allowed.
AC1REQ		equ	2	; a leading one is required.
ACNONE		equ	3	; the area code itself is not required.
				; used for area code #3 only.
ACPFX		equ	4	; use prefix for dialing.
T0PRE	equ	D'7'		; timer 0 preset for overflow in 250 counts.

; ***************
; ** VARIABLES **
; ***************
	cblock	h'20'		; 1st block of RAM at 20h-7fh (96 bytes here)
	;; interrupt pseudo-stack to save context during interrupt processing.
	s_copy			; 20  saved STATUS
	p_copy			; 21  saved PCLATH
	f_copy			; 22  saved FSR
	;; interrupt on port B change registers
	b_now			; 23  port b this read
	b_last			; 24  port b last read
	i_temp			; 25  temp for interrupt handler
	;; internal timing generation
	tFlags			; 26  Timer Flags
	oneMsC			; 27  one millisecond counter
	tenMsC			; 28  ten milliseconds counter
	hundMsC			; 29  hundred milliseconds counter
	thouMsC			; 2a  thousand milliseconds counter (1 sec)

	temp			; 2b  working storage. don't use in int handler.
	temp2			; 2c  more working storage
	temp3			; 2d  still more temporary storage
	temp4			; 2e  yet still more temporary storage
	temp5			; 2f  temporary storage...
	temp6			; 30  temporary storage...
	cmdSize			; 31  # digits received for current command
	;; operating flags
	flags			; 32  operating Flags
	mscFlag			; 33  misc. flags.
	txFlag			; 34  Transmitter control flag
	rxFlag			; 35  Receiver COS valid flags
	idRFlag			; 36  id & tail message rotate control flag
	;; beep generator control 
	beepTmr			; 37  timer for generating various beeps
	beepAdrH		; 38  address for various beepings, hi byte.
	beepAdrL		; 39  address for various beepings, low byte.
	beepCtl			; 3a  beeping control flag
	;; debounce timers
	rx0Dbc			; 3b  main receiver debounce timer
	rx1Dbc			; 3c  link receiver debounce timer
	;; receiver states
	rx0Stat			; 3d main receiver state
	rx1Stat			; 3e link receiver state
	;; timers
	rx0TOut			; 3f main receiver timeout timer, in seconds
	rx1TOut			; 40 link receiver timeout timer, in seconds
	idTmr			; 41 id timer, in 10 seconds
	hangTmr			; 42 hang timer, in tenths.
	muteTmr			; 43 DTMF muting timer, in tenths.
	lMutTmr			; 44 link muting timer, in tenths.
	ptchTmr			; 45 autopatch timer
	dtATmr			; 46 dtmf access timer
	fanTmr			; 47 fan timer
	tailCtr			; 48 tail message counter.
	unlkTmr			; 49 unlocked mode timer.
	pulsTmr			; 4a pulse timer.
	;; timer presets
	hangDly			; 4b hang timer preset, used enough to keep around
	;; message number
	msgNum			; 4c message number to play
	;; CW generator data
	cwTmr			; 4d CW element timer
	cwByte			; 4e CW current byte (bitmap)
	cwTbTmr			; 4f CW timebase timer
	
	rbTmr			; 50 remote base inactivity timer.
	
	outPort			; 51 output port data buffer
	cTone			; 52 courtesy tone to play

	eeAddrL			; 53 EEPROM address (low byte) to read/write
	eeAddrH			; 54 EEPROM address (low byte) to read/write
	eeCount			; 55 number of bytes to read/write from EEPROM
	;; control operator control flag groups
	group0			; 56 group 0 flags
	group1			; 57 group 1 flags
	group2			; 58 group 2 flags
	group3			; 59 group 3 flags
	group4			; 5a group 4 flags
	group5			; 5b group 5 flags
	group6			; 5c group 6 flags
	group7			; 5d group 7 flags
	group8			; 5e group 8 flags
	group9			; 5f group 9 flags
	mbxFlag			; 60 mailbox flags. must be after last Cntl-op.
	mbxCtl			; 61 mailbox control flags.
	;; ISD control variables
	isdFlag			; 62 isd control flag
	isdRACc			; 63 isd RAC counter.
	isdCmdH			; 64 isd command high  byte.
	isdCmdL			; 65 isd command low   byte.
	isdCmdC			; 66 isd command command byte.
	isdDly			; 67 isd command delay timer...
	isdMsg			; 68 isd message number...
	isdRMsg			; 69 isd RECORD message number...
	;; call restriction initialization control flag
	nnxInit			; 6a call restriction init'n control flag.
	ringTmr			; 6b ring timer.
	ringDur			; 6c ring duration timer.
	ringCtr			; 6d ring count.
	ringPul			; 6e ring pulses counter.
	tuneFlg			; 6f CI-V tune mode control flag.
	;; last var at 0x6f there are 0 left in this block...
	endc			; this block ends at 6f

	cblock	h'70'		; from 70 to 7f is common to all banks!
	w_copy			; 70  saved W register for interrupt handler
	dt0Ptr			; 71  DTMF-0 buffer pointer
	dt0Tmr			; 72  DTMF-0 buffer timer
	dt1Ptr			; 73  DTMF-1 buffer pointer
	dt1Tmr			; 74  DTMF-1 buffer timer
	dt2Ptr			; 75  DTMF-2 buffer pointer
	dt2Tmr			; 76  DTMF-2 buffer timer
	scratch			; 77  spare. unused.
	;; isdHead+1 is where words are added.
	;; isdTail+1 is where words are played.
	;; the tail follows the head.
	isdHead			; 78  ISD transmit buffer head pointer.
	isdTail			; 79  ISD transmit buffer tail pointer.
	dtRFlag			; 7a  DTMF receive flag...
	dtEFlag			; 7b  DTMF command interpreter control flag
	;; ci?Head+1 is where chars are added.
	;; ci?Tail+1 is where chars are consumed.
	;; the tail follows the head.
	ciTHead			; 7c  CI-V transmitter buffer head pointer.
	ciTTail			; 7d  CI-V transmitter buffer tail pointer.
	ciRHead			; 7e  CI-V receiver buffer head pointer.
	eebPtr			; 7f  eebuf write pointer.
	endc			; 1st RAM block ends at 7f

	cblock	h'a0'		; 2nd block of RAM at a0h-efh (80 bytes here)
	civfrq1			; a0  CI-V frequency cache.  byte 1 of 5.
	civfrq2			; a1  CI-V frequency cache.  byte 2 of 5.
	civfrq3			; a2  CI-V frequency cache.  byte 3 of 5.
	civfrq4			; a3  CI-V frequency cache.  byte 4 of 5.
	civfrq5			; a4  CI-V frequency cache.  byte 5 of 5.
	scanTmr			; a5  CI-V scan timer.
	scanMod			; a6  CI-V scan mode.
	kchkTmr			; a7  kerchunker timer
	cwTone			; a8  cw tone
	cwRate			; a9  cw speed
	;;  room from a7-af.
	endc

	;;
	;; 1.2x moved CI-V buffers to b0-cf and d0-ef and made 32 bytes long.
	;; this will allow transfer of 16 bytes of EEPROM data in a
	;; single CI-V message.
	;;
	
	cblock	h'b0'		; from b0 to ef is use for serial buffers.
	itbuf00			; b0 CI-V transmit buffer (32 bytes)
	itbuf01			; b1 CI-V transmit buffer
	itbuf02			; b2 CI-V transmit buffer
	itbuf03			; b3 CI-V transmit buffer
	itbuf04			; b4 CI-V transmit buffer
	itbuf05			; b5 CI-V transmit buffer
	itbuf06			; b6 CI-V transmit buffer
	itbuf07			; b7 CI-V transmit buffer
	itbuf08			; b8 CI-V transmit buffer
	itbuf09			; b9 CI-V transmit buffer
	itbuf0a			; ba CI-V transmit buffer
	itbuf0b			; bb CI-V transmit buffer
	itbuf0c			; bc CI-V transmit buffer
	itbuf0d			; bd CI-V transmit buffer
	itbuf0e			; be CI-V transmit buffer
	itbuf0f			; bf CI-V transmit buffer
	itbuf10			; c0 CI-V transmit buffer
	itbuf11			; c1 CI-V transmit buffer
	itbuf12			; c2 CI-V transmit buffer
	itbuf13			; c3 CI-V transmit buffer
	itbuf14			; c4 CI-V transmit buffer
	itbuf15			; c5 CI-V transmit buffer
	itbuf16			; c6 CI-V transmit buffer
	itbuf17			; c7 CI-V transmit buffer
	itbuf18			; c8 CI-V transmit buffer
	itbuf19			; c9 CI-V transmit buffer
	itbuf1a			; ca CI-V transmit buffer
	itbuf1b			; cb CI-V transmit buffer
	itbuf1c			; cc CI-V transmit buffer
	itbuf1d			; cd CI-V transmit buffer
	itbuf1e			; ce CI-V transmit buffer
	itbuf1f			; cf CI-V transmit buffer

	irbuf00			; d0 CI-V receive buffer (32 bytes)
	irbuf01			; d1 CI-V receive buffer
	irbuf02			; d2 CI-V receive buffer
	irbuf03			; d3 CI-V receive buffer
	irbuf04			; d4 CI-V receive buffer
	irbuf05			; d5 CI-V receive buffer
	irbuf06			; d6 CI-V receive buffer
	irbuf07			; d7 CI-V receive buffer
	irbuf08			; d8 CI-V receive buffer
	irbuf09			; d9 CI-V receive buffer
	irbuf0a			; da CI-V receive buffer
	irbuf0b			; db CI-V receive buffer
	irbuf0c			; dc CI-V receive buffer
	irbuf0d			; dd CI-V receive buffer
	irbuf0e			; de CI-V receive buffer
	irbuf0f			; df CI-V receive buffer
	irbuf10			; e0 CI-V receive buffer
	irbuf11			; e1 CI-V receive buffer
	irbuf12			; e2 CI-V receive buffer
	irbuf13			; e3 CI-V receive buffer
	irbuf14			; e4 CI-V receive buffer
	irbuf15			; e5 CI-V receive buffer
	irbuf16			; e6 CI-V receive buffer
	irbuf17			; e7 CI-V receive buffer
	irbuf18			; e8 CI-V receive buffer
	irbuf19			; e9 CI-V receive buffer
	irbuf1a			; ea CI-V receive buffer
	irbuf1b			; eb CI-V receive buffer
	irbuf1c			; ec CI-V receive buffer
	irbuf1d			; ed CI-V receive buffer
	irbuf1e			; ee CI-V receive buffer
	irbuf1f			; ef CI-V receive buffer
	endc			; end block c0-ef
	
	cblock	h'f0'		; this is really common with 70-7f
	rsvdf0			; f0  reserve these 16 bytes
	rsvdf1			; f1  reserve these 16 bytes
	rsvdf2			; f2  reserve these 16 bytes
	rsvdf3			; f3  reserve these 16 bytes
	rsvdf4			; f4  reserve these 16 bytes
	rsvdf5			; f5  reserve these 16 bytes
	rsvdf6			; f6  reserve these 16 bytes
	rsvdf7			; f7  reserve these 16 bytes
	rsvdf8			; f8  reserve these 16 bytes
	rsvdf9			; f9  reserve these 16 bytes
	rsvdfa			; fa  reserve these 16 bytes
	rsvdfb			; fb  reserve these 16 bytes
	rsvdfc			; fc  reserve these 16 bytes
	rsvdfd			; fd  reserve these 16 bytes
	rsvdfe			; fe  reserve these 16 bytes
	rsvdff			; ff  reserve these 16 bytes
	endc			; end block f0-ff

	;; 16c77 ram blocks continue...
	cblock	h'110'		; 16 bytes at 110h-11fh
	dt0buf0			; DTMF-0 receiver buffer (16 bytes) @ 120
	dt0buf1
	dt0buf2
	dt0buf3
	dt0buf4
	dt0buf5
	dt0buf6
	dt0buf7
	dt0buf8
	dt0buf9
	dt0bufa
	dt0bufb
	dt0bufc
	dt0bufd
	dt0bufe
	dt0buff
	endc
	
	cblock	h'120'		; 80 bytes 120h-16fh
	dt1buf0			; DTMF-1 receiver buffer (16 bytes) @ 120
	dt1buf1
	dt1buf2
	dt1buf3
	dt1buf4
	dt1buf5
	dt1buf6
	dt1buf7
	dt1buf8
	dt1buf9
	dt1bufa
	dt1bufb
	dt1bufc
	dt1bufd
	dt1bufe
	dt1buff

	dt2buf0			; DTMF-2 receiver buffer (16 bytes) @ 130
	dt2buf1
	dt2buf2
	dt2buf3
	dt2buf4
	dt2buf5
	dt2buf6
	dt2buf7
	dt2buf8
	dt2buf9
	dt2bufa
	dt2bufb
	dt2bufc
	dt2bufd
	dt2bufe
	dt2buff

	dtXbuf0			; dtmf TRANSMITTER buffer (32 bytes) @ 140
	dtXbuf1
	dtXbuf2
	dtXbuf3
	dtXbuf4
	dtXbuf5
	dtXbuf6
	dtXbuf7
	dtXbuf8
	dtXbuf9
	dtXbufa
	dtXbufb
	dtXbufc
	dtXbufd
	dtXbufe
	dtXbu10
	dtXbu11
	dtXbu12
	dtXbu13
	dtXbu14
	dtXbu15
	dtXbu16
	dtXbu17
	dtXbu18
	dtXbu19
	dtXbu1a
	dtXbu1b
	dtXbu1c
	dtXbu1d
	dtXbu1e
	dtXbu1f

	isdXB0			; ISD talker word buffer (16 bytes) @ 160
	isdXB1
	isdXB2
	isdXB3
	isdXB4
	isdXB5
	isdXB6
	isdXB7
	isdXB8
	isdXB9
	isdXBa
	isdXBb
	isdXBc
	isdXBd
	isdXBe
	isdXBf
	endc
	
	cblock	h'170'		; this is common with 70-7f
	rsvd170			; reserve these 16 bytes
	rsvd171			; reserve these 16 bytes
	rsvd172			; reserve these 16 bytes
	rsvd173			; reserve these 16 bytes
	rsvd174			; reserve these 16 bytes
	rsvd175			; reserve these 16 bytes
	rsvd176			; reserve these 16 bytes
	rsvd177			; reserve these 16 bytes
	rsvd178			; reserve these 16 bytes
	rsvd179			; reserve these 16 bytes
	rsvd17a			; reserve these 16 bytes
	rsvd17b			; reserve these 16 bytes
	rsvd17c			; reserve these 16 bytes
	rsvd17d			; reserve these 16 bytes
	rsvd17e			; reserve these 16 bytes
	rsvd17f			; reserve these 16 bytes
	endc			; 3nd RAM block ends at 17f
	
	;; cblock	h'190'	; 16 bytes at 190h-19fh
	;; endc
	cblock	h'1a0'		; 80 bytes 1a0h-1efh
	cmdbf00			; command buffer  @1a0
	cmdbf01			; command buffer
	cmdbf02			; command buffer
	cmdbf03			; command buffer
	cmdbf04			; command buffer
	cmdbf05			; command buffer
	cmdbf06			; command buffer
	cmdbf07			; command buffer
	cmdbf08			; command buffer
	cmdbf09			; command buffer
	cmdbf0a			; command buffer
	cmdbf0b			; command buffer
	cmdbf0c			; command buffer
	cmdbf0d			; command buffer
	cmdbf0e			; command buffer
	cmdbf0f			; command buffer  @1af (16 bytes)
	cmdbf10			; command buffer  @1b0
	cmdbf11			; command buffer
	cmdbf12			; command buffer
	cmdbf13			; command buffer
	cmdbf14			; command buffer
	cmdbf15			; command buffer
	cmdbf16			; command buffer
	cmdbf17			; command buffer
	cmdbf18			; command buffer
	cmdbf19			; command buffer
	cmdbf1a			; command buffer
	cmdbf1b			; command buffer
	cmdbf1c			; command buffer
	cmdbf1d			; command buffer
	cmdbf1e			; command buffer
	cmdbf1f			; command buffer @1bf (32 bytes)

	eebuf00			; eeprom buffer	 @1c0 (16 bytes)
	eebuf01			; eeprom buffer
	eebuf02			; eeprom buffer
	eebuf03			; eeprom buffer
	eebuf04			; eeprom buffer
	eebuf05			; eeprom buffer
	eebuf06			; eeprom buffer
	eebuf07			; eeprom buffer
	eebuf08			; eeprom buffer
	eebuf09			; eeprom buffer
	eebuf0a			; eeprom buffer
	eebuf0b			; eeprom buffer
	eebuf0c			; eeprom buffer
	eebuf0d			; eeprom buffer
	eebuf0e			; eeprom buffer
	eebuf0f			; eeprom buffer	 @1cf
	;; room from 1d0 to 1ef
	endc

	cblock	h'1f0'		; this is common with 70-7f
	rsvd1f0			; reserve these 16 bytes
	rsvd1f1			; reserve these 16 bytes
	rsvd1f2			; reserve these 16 bytes
	rsvd1f3			; reserve these 16 bytes
	rsvd1f4			; reserve these 16 bytes
	rsvd1f5			; reserve these 16 bytes
	rsvd1f6			; reserve these 16 bytes
	rsvd1f7			; reserve these 16 bytes
	rsvd1f8			; reserve these 16 bytes
	rsvd1f9			; reserve these 16 bytes
	rsvd1fa			; reserve these 16 bytes
	rsvd1fb			; reserve these 16 bytes
	rsvd1fc			; reserve these 16 bytes
	rsvd1fd			; reserve these 16 bytes
	rsvd1fe			; reserve these 16 bytes
	rsvd1ff			; reserve these 16 bytes
	endc			; 3nd RAM block ends at 1ff
	
; ********************
; ** STARTUP VECTOR **
; ********************
	org	0		; startup vector
	clrf	PCLATH		; stay in bank 0
	goto	Start

; ***********************
; ** INTERRUPT HANDLER **
; ***********************
IntHndlr
	org	4		; interrupt vector
	; preserve registers...
	movwf	w_copy		; save w register
	swapf	STATUS,w	; get STATUS
	clrf	STATUS		; force bank 0
	movwf	s_copy		; save STATUS
	movf	PCLATH,w	; get PCLATH
	movwf	p_copy		; save PCLATH
	clrf	PCLATH		; force page 0
	bsf	STATUS,IRP	; select RAM bank 1
	movf	FSR,w		; get FSR
	movwf	f_copy		; save FSR
	
	btfsc	INTCON,T0IF	; is it a timer interrupt?
	goto	TimrInt		; yes...
	btfsc	INTCON,RBIF	; is it a DTMF or ISDRAC interrupt?
	goto	RBInt		; yes...
	btfsc	INTCON,INTF	; is it an ISD general interrupt?
	goto	ISDInt		; yes
	;; not any of the interrupts indicated in INTCON...
	;; look at PIR1 interrupts...
	btfsc	PIR1,RCIF	; is it a USART Receive interrupt?
	goto	URInt		; yes.
	btfsc	PIR1,TXIF	; is it a USART transmit interrupt?
	goto	UTInt		; yes.
	goto	IntExit		; no...

ISDInt				; ISD 4004 interrupt handler
	;; can get an interrupt when recording if end of memory is reached.
	;; interrupt during playback for end-of-memory or end-of-message.
	;; must send command to ISD to clear IRQ.
	;; in any case, the first thing to do is to stop the ISD.
	bcf	INTCON,INTF	; clear interrupt request
	movlw	b'00000010'	; mask: clear all but ISDPLAY.
	andwf	isdCmdC,f	; clear bits.
	movlw	b'00001100'	; mask:	 set ISDIAB, ISDPUP.
	iorwf	isdCmdC,f	; set bits.
	movf	isdCmdC,w	; get the cmd  byte of the command.
	bcf	PORTB,ISDSEL	; select the ISD
	PAGE3			; select code page 3.
	call	SendSPI		; send & receive from the SPI
	PAGE0			; select code page 0.
	bsf	PORTB,ISDSEL	; deselect the ISD
	;; w now has the ISD status byte; but who cares?
	bcf	isdFlag,ISDRUNF ; clear ISD RUN indicator.
	btfss	isdFlag,ISDRECF ; was it recording?
	bsf	isdFlag,ISDWRDF ; nope, set IRQ attention bit.
	bcf	isdFlag,ISDRECF ; clear ISD RECORD indicator.
	bcf	isdFlag,ISDRACF ; clear RAC attention flag. don't need that now.
	clrf	isdDly		; clear ISD delay timer. don't need that now.
	clrf	isdRACc		; clear RAC counter.  don't need that 
	goto	IntExit

RBInt
	movf	PORTB,w		; read port b
	movwf	b_now		; save port b (only read once)
	xorwf	b_last,f	; b_last now is difference indicator
	btfss	b_last,DTMF0DV	; action on DTMF-0
	goto	CkDT1		; nope..
	btfss	rxFlag,RX0OPEN	; is receiver 1 marked active?
	goto	CkDT1		; no. ignore DTMF.
	btfss	b_now,DTMF0DV	; is DV high?
	goto	CkDT0L		; nope...
	
RdDT0
	btfsc	group1,3	; is muting enabled?
	bcf	outPort,RX0AUD	; mute receiver 0
	btfsc	group1,4	; drop link to mute enabled?
	bcf	outPort,TX1PTT	; turn off link PTT.
	btfsc	group6,6	; drop main TX to mute enabled?
	bcf	outPort,TX0PTT	; turn off main PTT.
	movlw	MUTEDLY		; get mute timer delay
	movwf	muteTmr		; preset mute timer
RdDT0m
	movlw	DTMFDLY		; get DTMF activity timer preset.
	movwf	dt0Tmr		; set dtmf command timer
	movlw	B'11111111'	; all inputs.
	bsf	STATUS,RP0	; select bank 1.
	movwf	TRISD		; set port D data direction.
	bcf	STATUS,RP0	; select bank 0.
	
	movf	dt0Ptr,w	; get index
	movwf	FSR		; put it in FSR
	bcf	STATUS,C	; clear carry (just in case)
	rrf	FSR,f		; hey! divide by 2.
	movlw	LOW dt0buf0	; get address of buffer
	addwf	FSR,f		; add to index.
	
	bsf	PORTB,DTMFSEL	; enable DTMF outputs.
	movlw	b'00001111'	; mask bits.
	andwf	PORTD,w		; get masked bits of tone into W.
	bcf	PORTB,DTMFSEL	; disable DTMF outputs.
	PAGE3			; select code page 3.
	call	MapDTMF		; remap tone into keystroke value..
	PAGE0			; select code page 0.
	iorlw	h'0'		; OR with zero to set status bits.
	bcf	mscFlag,DT0ZERO ; clear last zero received.
	btfsc	STATUS,Z	; was a zero the last received digit?
	bsf	mscFlag,DT0ZERO ; yes...
	
	btfsc	dt0Ptr,0	; is this an odd address?
	goto	DT0Odd		; yes;
	clrf	INDF		; zero both nibbles.
	movwf	INDF		; save tone in indirect register.
	swapf	INDF,f		; move the tone to the high nibble
	goto	DT0Done		; done here
DT0Odd
	iorwf	INDF,F		; save tone in low nibble
DT0Done 
	incf	dt0Ptr,f	; increment index
	movlw	h'1f'		; mask
	andwf	dt0Ptr,f	; don't let index grow past 1f (31)

	bsf	STATUS,RP0	; select page 1
	clrf	TRISD		; set port D all outputs.
	bcf	STATUS,RP0	; select bank 0.
	goto	CkDT1		; go look at DTMF-1

CkDT0L				; check for end of LITZ...
	btfss	mscFlag,DT0ZERO ; was zero the last received digit?
	goto	CkDT1		; no.
	movf	dt0Tmr,w	; get dtmf command timer
	btfsc	STATUS,Z	; is it already zero?
	goto	CkDT0LZ		; yes.
	sublw	LITZTIM		; subtract from litz time.
	btfss	STATUS,C	; is result positive?
	goto	CkDT1		; nope.

CkDT0LZ				; check for LITZ digits.
	bsf	mscFlag,LITZDT0 ; set LITZ on main receiver flag.
	clrf	dt0Ptr		; clear this, throw away received LITZ tone.
	clrf	dt0Tmr		; clear this, don't process tones normally.
		
CkDT1
	btfss	b_last,DTMF1DV	; action on DTMF-1
	goto	CkDT2		; nope..
	btfss	outPort,FONECTL ; is phone off-hook?
	goto	CkDT2		; nope.	 ignore tones from this source.
	btfss	b_now,DTMF1DV	; is DV high?
	goto	CkDT1L		; nope...

RdDT1
	btfsc	b_now,DTMF0DV	; is DV high on decoder 0?
	goto	CkDT2		; yes.	Ignore this digit.
	bcf	outPort,FONEAUD ; mute telephone audio
	;movlw	 MUTEDLY		; get mute timer delay
	;movwf	 muteTmr		; preset mute timer
	btfsc	txFlag,DTMFING	; is DTMF being sent right now?
	goto	CkDT2		; yes.	ignore digits received.
	movlw	DTMFDLY		; get DTMF activity timer preset
	movwf	dt1Tmr		; set dtmf command timer
	movlw	B'11111111'	; all inputs.
	bsf	STATUS,RP0	; select bank 1.
	movwf	TRISD		; set port D data direction.
	bcf	STATUS,RP0	; select bank 0.
	
	movf	dt1Ptr,w	; get index
	movwf	FSR		; put it in FSR
	bcf	STATUS,C	; clear carry (just in case)
	rrf	FSR,f		; hey! divide by 2.
	movlw	LOW dt1buf0	; get address of buffer
	addwf	FSR,f		; add to index.
	
	bsf	PORTB,DTMFSEL	; enable DTMF outputs.
	swapf	PORTD,w		; get decoder nibble & swap to low nibble
	andlw	b'00001111'	; mask bits.
	bcf	PORTB,DTMFSEL	; disable DTMF outputs.
	PAGE3			; select code page 3.
	call	MapDTMF		; remap tone into keystroke value..
	PAGE0			; select code page 0.
	btfsc	dt1Ptr,0	; is this an odd address?
	goto	DT1Odd		; yes;
	clrf	INDF		; zero both nibbles.
	movwf	INDF		; save tone in indirect register.
	swapf	INDF,f		; move the tone to the high nibble
	goto	DT1Done		; done here
DT1Odd
	iorwf	INDF,F		; save tone in low nibble
DT1Done 
	incf	dt1Ptr,f	; increment index
	movlw	h'1f'		; mask
	andwf	dt1Ptr,f	; don't let index grow past 1f (31)

	bsf	STATUS,RP0	; select page 1
	clrf	TRISD		; set port D all outputs.
	bcf	STATUS,RP0	; select bank 0.
	goto	CkDT2		; done here.

CkDT1L				; end of digit.
	btfsc	txFlag,PATCHON	; is patch on?
	bsf	outPort,FONEAUD ; yes, unmute telephone audio
	
CkDT2
	btfss	b_last,DTMF2DV	; action on DTMF-2
	goto	CkISDR
	btfss	b_now,DTMF2DV	; is DV high?
	goto	CkDT2L		; nope.	 Check for LiTZ.

RdDT2
	btfss	group1,7	; is control DTMF receiver set for link port?
	goto	RdDT2m		; no, it is the control receiver. dont mute.

	btfss	rxFlag,RX1OPEN	; is receiver 1 marked active?
	goto	CkISDR		; no. ignore DTMF.
	
	btfsc	group1,3	; is muting enabled?
	bcf	outPort,RX1AUD	; mute receiver 0
	btfsc	group1,4	; drop link to mute enabled?
	bcf	outPort,TX1PTT	; turn off link PTT.
	btfsc	group6,6	; drop main TX to mute enabled?
	bcf	outPort,TX0PTT	; turn off main PTT.
	movlw	MUTEDLY		; get mute timer delay
	movwf	muteTmr		; preset mute timer
RdDT2m
	btfsc	beepCtl,B_DTMF	; is controller SENDING DTMF?
	goto	CkISDR		; yes, do not receive these digits.
	movlw	DTMFDLY		; get DTMF activity timer preset
	movwf	dt2Tmr		; set dtmf command timer
	movlw	B'11111111'	; all inputs.
	bsf	STATUS,RP0	; select bank 1.
	movwf	TRISD		; set port D data direction.
	bcf	STATUS,RP0	; select bank 0.
	
	movf	dt2Ptr,w	; get index
	movwf	FSR		; put it in FSR
	bcf	STATUS,C	; clear carry (just in case)
	rrf	FSR,f		; hey! divide by 2.
	movlw	LOW dt2buf0	; get address of buffer
	addwf	FSR,f		; add to index.

	bsf	PORTC,DTMF2SE	; enable DTMF outputs.
	movlw	b'00001111'	; mask bits.
	andwf	PORTD,w		; get masked bits of tone into W.
	bcf	PORTC,DTMF2SE	; disable DTMF outputs.
	PAGE3			; select code page 3.
	call	MapDTMF		; remap tone into keystroke value..
	PAGE0			; select code page 0.
	iorlw	h'0'		; OR with zero to set status bits.
	bcf	mscFlag,DT2ZERO ; clear last zero received.
	btfsc	STATUS,Z	; was a zero the last received digit?
	bsf	mscFlag,DT2ZERO ; yes...
	btfsc	dt2Ptr,0	; is this an odd address?
	goto	DT2Odd		; yes;
	clrf	INDF		; zero both nibbles.
	movwf	INDF		; save tone in indirect register.
	swapf	INDF,f		; move the tone to the high nibble
	goto	DT2Done		; done here
DT2Odd
	iorwf	INDF,F		; save tone in low nibble
DT2Done 
	incf	dt2Ptr,f	; increment index
	movlw	h'1f'		; mask
	andwf	dt2Ptr,f	; don't let index grow past 1f (31)

	bsf	STATUS,RP0	; select page 1
	clrf	TRISD		; set port D all outputs.
	bcf	STATUS,RP0	; select bank 0.
	goto	CkISDR		; done here

CkDT2L				; check for end of LITZ...
	btfss	rxFlag,RX1OPEN	; is receiver 1 marked active?
	goto	CkISDR		; no. ignore DTMF.
	btfss	mscFlag,DT2ZERO ; was zero the last received digit?
	goto	CkISDR		; no.
	movf	dt2Tmr,w	; get dtmf command timer
	btfsc	STATUS,Z	; is it already zero?
	goto	CkDT2LZ		; yes.
	sublw	LITZTIM		; subtract from litz time.
	btfss	STATUS,C	; is result positive?
	goto	CkISDR		; nope.

CkDT2LZ				; check for LITZ digits.
	bsf	mscFlag,LITZDT2 ; set LITZ on main receiver flag.
	clrf	dt2Ptr		; clear this, throw away received LITZ tone.
	clrf	dt2Tmr		; clear this, don't process tones normally.
		
CkISDR
	btfss	b_last,ISDRAC	; action on ISDRAC
	goto	SaveB		; nope..

	btfsc	b_now,ISDRAC	; is ISDRAC low?
	goto	SaveB		; nope...
	bsf	isdFlag,ISDRACF ; set ISD RAC attention flag...
	
SaveB
	movf	b_now,w		; get port b (copy) byte
	movwf	b_last		; save last port b.
	bcf	INTCON,RBIF	; clear portb change f
	goto	IntExit		; done here.
	
TimrInt
	movlw	T0PRE		; get timer 0 preset value
	movwf	TMR0		; preset timer 0
	bsf	tFlags,TICK	; set tick indicator flag

TimrDone			
	bcf	INTCON,T0IF	; clear RTCC int mask
	goto	IntExit		; done here.

URInt				; USART receiver interrupt.
	movf	ciRHead,w	; save it...
	addlw	LOW irbuf00	; add to buffer base address.
	movwf	FSR		; set FSR as pointer
	movf	RCREG,w		; get received char.
	bcf	STATUS,IRP	; select 00-FF range for FSR/INDF
	movwf	INDF		; put char into buffer

	incf	ciRHead,w	; increment pointer.
	andlw	h'1f'		; mask so result stays in 0-31 range.
	movwf	ciRHead		; save pointer.

	movf	INDF,w		; get received character back.
	sublw	CIV_PRE		; subtract CI-V preamble character.
	btfsc	STATUS,Z	; skip if non-zero.
	clrf	ciRHead		; preamble.  Reset to start of buffer.

	movf	INDF,w		; get received character back.
	sublw	CIV_EOM		; subtract CI-V EOM character.
	btfsc	STATUS,Z	; skip if non-zero.
	bsf	mscFlag,CIV_RDY ; end of message received, ready to process.

	bsf	STATUS,IRP	; select 100-1FF range for FSR/INDF
	goto	IntExit		; done here.

UTInt				; USART transmitter interrupt.
	movf	ciTTail,w	; get tail pointer.
	subwf	ciTHead,w	; subtract from head pointer.
	btfsc	STATUS,Z	; result should be non-zero if buffer not empty
	goto	UTIntD		; buffer is empty.
	incf	ciTTail,w	; get pointer + 1.
	andlw	h'1f'		; mask so result stays in 0-31 range.
	movwf	ciTTail		; save it...
	addlw	LOW itbuf00	; add to buffer base address.
	movwf	FSR		; set FSR as pointer.
	bcf	STATUS,IRP	; select 00-FF range for FSR/INDF
	movf	INDF,w		; get char.
	bsf	STATUS,IRP	; select 100-1FF range for FSR/INDF
	movwf	TXREG		; send char.
	goto	IntExit		; done here.
	
UTIntD				; no more chars to transmit.
	;; turn off the transmitter interrupt.
	bsf	STATUS,RP0	; select bank 1
	bcf	PIE1,TXIE	; turn off the transmitter interrupt.
	bcf	STATUS,RP0	; select bank 1
	;; goto IntExit		; done here.
	
IntExit
	movf	p_copy,w	; get PCLATH preserved value
	movwf	PCLATH		; restore PCLATH
	movf	f_copy,w	; get FSR preserved value
	movwf	FSR		; restore FSR
	swapf	s_copy,w	; get STATUS preserved value
	movwf	STATUS		; restore STATUS
	swapf	w_copy,f	; swap W
	swapf	w_copy,w	; restore W
	retfie

;
; Play the appropriate ID message, reset ID timers & flags
;
DoID
	movf	txFlag,w	; get txFlag - looking to see if rx is still on
	andlw	b'00000011'	; mask out uninteresting bits.
	btfss	STATUS,Z	; are those receivers active?
	bsf	flags,needID	; yes.
	btfss	flags,needID	; need to ID?
	return			; nope--id timer expired without tx since last
	;; play the ID here.
	bsf	idRFlag,IDNOW	; set IDing now flag.
	movf	txFlag,w	; get tx flags
	andlw	h'03'		; w=w&(RX0OPEN|RX1OPEN), non zero if repeating
	btfss	STATUS,Z	; Z set is not repeating
	goto	DoIDCW		; actively repeating, play CW ID.
	;; not actively repeating (nobody talking), ok to play voice ID
	btfsc	flags,initID	; initial ID wanted?
	goto	DoIDInt		; yep.

	;; group2 bits 1, 2, & 3 enable the 3 normal IDs.
	movlw	b'00001110'	; bitmask for the 3 enabled IDs.
	andwf	group2,w	; check to see if the speech IDs are enabled.
	btfsc	STATUS,Z	; Z will be true if no speech IDs are enabled.
	goto	DoIDCW		; no speech IDs enabled.
	;; at least 1 speech normal ID is enabled
	btfsc	idRFlag,IDR0	; check to see if ID 2 is next.
	goto	DoIDck2		; ID 2 is next.
	btfsc	idRFlag,IDR1	; check to see if ID 3 is next.
	goto	DoIDck3		; ID 3 is next.

DoIDck1
	bsf	idRFlag,IDR0	; going to try ID 1 now, ID2 is next.
	bcf	idRFlag,IDR1	; make sure 2 is next.
	btfss	group2,1	; is Speech ID 1 enabled?
	goto	DoIDck2		; nope.
	movlw	VNID1		; get normal ID 1 message
	goto	DoIDSpc		; play ID message

DoIDck2
	bcf	idRFlag,IDR0	; going to try ID 2 now, ID 3 is next.
	bsf	idRFlag,IDR1	; make sure 3 is next.
	btfss	group2,2	; is Speech ID 2 enabled?
	goto	DoIDck3		; nope.
	movlw	VNID2		; get normal ID 2 message
	goto	DoIDSpc		; play ID message

DoIDck3
	bcf	idRFlag,IDR0	; going to try ID 3 now, ID 1 is next.
	bcf	idRFlag,IDR1	; make sure 1 is next.
	btfss	group2,3	; is Speech ID 3 enabled?
	goto	DoIDck1		; nope.
	movlw	VNID3		; get normal ID 2 message
	goto	DoIDSpc		; play ID message

DoIDInt				; play initial ID
	btfss	group2,0	; is initial speech ID enabled?
	goto	DoIDICW		; not enabled, play CW.
	movlw	VIID		; get initial ID

DoIDSpc				; play speech ID
	PAGE3			; select code page 3.
	call	PutWord		; add word in W to buffer.
	bsf	outPort,BEEPAUD ; turn on audio gate
	call	SetPort		; set the port.
	call	PTTon		; turn on tx if not on already.
	call	PlaySpc		; play the speech message.
	PAGE0			; select code page 0.
	goto	DoIDrst

DoIDICW				; play initial CW id.
	btfsc	group0,3	; is hang timer enabled?
	goto	DoIDCW		; send the CW ID
	bcf	flags,initID	; clear initID flag.
	return			; no initial ID -- stealth mode.

DoIDCW				; play CW id.
	PAGE3			; select code page 3.
	call	PTTon		; turn on tx if not on already.
	movlw	EECWID		; address of CW ID message in EEPROM.
	movwf	eeAddrL		; save CT base address
	clrf	eeAddrH		; save CT base address hi byte
	call	PlayCWe		; kick of the CW playback.
	PAGE0			; select code page 0.
	
DoIDrst				; reset ID timer & logic.
	clrf	eeAddrH		; clear EEPROM high address byte.
	movlw	EETID		; get EEPROM address of ID timer preset.
	movwf	eeAddrL		; set EEPROM address low byte.
	PAGE3			; select code page 3.
	call	ReadEEw		; read EEPROM.
	PAGE0			; select code page 0.
	movwf	idTmr		; store to idTmr down-counter
	bcf	flags,initID	; clear initial ID flag
	movf	txFlag,w	; get tx flags
	andlw	h'03'		; w=w&(RX0OPEN|RX1OPEN), non zero if RX active.
	btfsc	STATUS,Z	; is it zero?
	bcf	flags,needID	; yes. reset needID flag.
	return

PlayMsg				; play a speech message, message # in w.
	PAGE3			; select code page 3.
	call	PutWord		; add word in W to buffer.
	bsf	outPort,BEEPAUD ; turn on audio gate
	call	SetPort		; set the port.
	call	PTTon		; turn on tx if not on already.
	call	PlaySpc		; play the speech message.
	PAGE0			; select code page 0.
	return			; done here.
	
Rcv0Off				; turn off receiver 0
	movlw	RXSOFF		; get new state #
	movwf	rx0Stat		; set new receiver state
	bcf	outPort,RX0AUD	; mute it...
	bcf	txFlag,RX0OPEN	; clear main receiver on bit
	clrf	rx0TOut		; clear main receiver timeout timer
	return
	
Rcv1Off				; turn off receiver 1
	movlw	RXSOFF		; get new state #
	movwf	rx1Stat		; set new receiver state
	bcf	outPort,RX1AUD	; mute it...
	bcf	txFlag,RX1OPEN	; clear link receiver on bit
	clrf	rx1TOut		; clear link receiver timeout timer
	return
	
SetHang				; start hang timer...
	btfss	group0,3	; is hang timer enabled?
	return			; nope.
	clrf	eeAddrH		; clear EEPROM high address byte.
	movlw	EETHTS		; get EEPROM address of hang timer short preset
	btfsc	group0,4	; is long hang timer selected?
	movlw	EETHTL		; get EEPROM address of hang timer long preset
	movwf	eeAddrL		; set EEPROM address low byte.
	PAGE3			; select code page 3.
	call	ReadEEw		; read EEPROM.
	PAGE0			; select code page 0.
	movwf	hangDly		; save this in hangDly, used often.
	movwf	hangTmr		; preset hang timer
	btfsc	STATUS,Z	; check to see if the hang timer is zero.
	return			; it is.  can't hang...
	bsf	txFlag,TXHANG	; set hang time transmit flag
	return			; done.

ChkID				; call on receiver drop to see if want to ID
	btfsc	flags,initID	; check initial id flag
	call	DoID		; play the ID
	btfss	flags,needID	; need to ID?
	return
	;
	;if (idTmr <= idSoon) then goto StartID
	;implemented as: if ((IDSOON-idTimer)>=0) then ID
	;
	movf	idTmr,w		; get idTmr into W
	sublw	IDSOON		; IDSOON-w ->w
	btfsc	STATUS,C	; C is clear if result is negative
	call	DoID		; ok to ID now, let's do it.
	return			; don't need to ID yet...

; ***************************************************
; ** DoTail -- Play Tail Message and Reset Counter **
; ***************************************************

DoTail	
	;; group2 bits 4, 5, & 6 enable the normal tail messages.
	;; group2 biut 7 enabled the mailbox headers tail message.
	movlw	b'11110000'	; bitmask for the 4 tail messages.
	andwf	group2,w	; check if any tail messages are enabled.
	btfsc	STATUS,Z	; Z will be true if none are enabled.
	goto	DoTEnd		; no tail messages enabled.
	;; at least 1 tail message is enabled
	btfsc	idRFlag,TAILR0	; check to see if tail message 2 is next.
	goto	DoTck2		; tail message 2 is next.
	btfsc	idRFlag,TAILR1	; check to see if tail message 3 is next.
	goto	DoTck3		; tail message 3 is next.
	btfsc	idRFlag,TAILRM	; check to see if mbx tail message is next.
	goto	DoTckM		; mailbox tail message is next.
DoTck1
	bsf	idRFlag,TAILR0	; going to try TM 1 now, TM 2 is next.
	bcf	idRFlag,TAILR1	; make sure 2 is next.
	bcf	idRFlag,TAILRM	; make sure 2 is next.
	btfss	group2,4	; is TM 1 enabled?
	goto	DoTck2		; nope.
	movlw	VTAIL1		; get tail message 1
	goto	DoTSpc		; play tail message

DoTck2
	bcf	idRFlag,TAILR0	; going to try TM 2 now, TM 3 is next.
	bsf	idRFlag,TAILR1	; make sure 3 is next.
	bcf	idRFlag,TAILRM	; make sure 3 is next.
	btfss	group2,5	; is TM2 enabled?
	goto	DoTck3		; nope.
	movlw	VTAIL2		; get TM 2 message
	goto	DoTSpc		; play tail message

DoTck3
	bcf	idRFlag,TAILR0	; going to try TM 3 now, mbx tail is next.
	bcf	idRFlag,TAILR1	; make sure M is next.
	bsf	idRFlag,TAILRM	; make sure 3 is next.
	btfss	group2,6	; is Speech ID 3 enabled?
	goto	DoTckM		; nope.
	movlw	VTAIL3		; get TM 3 message
	goto	DoTSpc		; play tail message.

DoTckM
	bcf	idRFlag,TAILR0	; going to try mbx hdrs now, TM 1 is next.
	bcf	idRFlag,TAILR1	; make sure 1 is next.
	bcf	idRFlag,TAILRM	; make sure 1 is next.
	btfss	group2,7	; is mailbox header tail message enabled?
	goto	DoTck1		; nope.
	movf	mbxFlag,f	; check for messages in mailboxes.
	btfss	STATUS,Z	; skip if zero -- no messages
	goto	DoTckM1		; there are messages, play the headers.
	movlw	b'01110000'	; bitmask for the 3 normal tail messages.
	andwf	group2,w	; check if any tail messages are enabled.
	btfsc	STATUS,Z	; Z will be true if none are enabled.
	goto	DoTEnd		; no tail messages enabled.
	goto	DoTail		; try to play one of the other tail messages.

DoTckM1
	PAGE3			; select code page 3.
	bsf	outPort,BEEPAUD ; turn on audio gate
	call	SetPort		; set the port.
	call	PTTon		; turn on tx if not on already.
	call	MbxHdrs		; play mailbox headers.
	PAGE0			; select code page 0.
	goto	DoTEnd		; done here.

DoTSpc				; play speech ID
	PAGE3			; select code page 3.
	call	PutWord		; add word in W to buffer.
	bsf	outPort,BEEPAUD ; turn on audio gate
	call	SetPort		; set the port.
	call	PTTon		; turn on tx if not on already.
	call	PlaySpc		; play the speech message.
	PAGE0			; select code page 0.

DoTEnd
	;; now, reset tail message counter.
	clrf	eeAddrH		; clear EEPROM high address byte.
	movlw	EETTAIL		; get EEPROM address of tail message counter.
	movwf	eeAddrL		; set EEPROM address low byte.
	PAGE3			; select code page 3.
	call	ReadEEw		; read EEPROM.
	PAGE0			; select code page 0.
	movwf	tailCtr		; preset tail message counter.
	return			; done with tail message.
	
	;; **************************************************
	;; **************************************************
	;; **************************************************

; *********************
; ** PROGRAM STARTUP **
; *********************
	org	0200
Start
	bsf	STATUS,RP0	; select bank 1

	movlw	b'00000111'	; set all pins to digital I/O
	movwf	ADCON1
	
	IFDEF  __16F887
	bsf	STATUS,RP1	; select register page 2/3
	clrf	ANSEL		; clear analog select
	clrf	ANSELH		; clear analog select
	bcf	STATUS,RP1	; select register page 0/1
	ENDIF
	
	movlw	B'11111000'	; na/na/in/in/in/out/out/out
	movwf	TRISA		; set port A data direction

	movlw	B'11110001'	; in/in/in/in/out/out/out/in
	movwf	TRISB		; set port B data direction

	movlw	B'10010000'	; SCI/SCI/SPI/SPI/SPI/out/out/out
				; in  out out in  out out out out
	movwf	TRISC		; set port C data direction

	movlw	B'00000000'	; all outputs normally.
	movwf	TRISD		; set port D data direction

	movlw	B'00000111'	; na/na/na/na/na/in/in/in
	movwf	TRISE		; set port E data direction
 
	movlw	b'10000011'	; RBPU\ no pull up, 
				; INTEDG INT on falling edge
				; T0CS	 TMR0 uses instruction clock
				; T0SE	n/a
				; PSA TMR0 gets the prescaler 
				; PS2 \
				; PS1  > prescaler 16
				; PS0 /
	movwf	OPTION_REG	; set options
	
	movlw	b'11000000'	; SMP=1 CKE=1
	movwf	SSPSTAT		; input data on falling edge, output on rising
	movlw	d'103'		; 9600 baud at 16.0 MHz clock.
	movwf	SPBRG		; set baud rate generator.
	movlw	b'00100100'	; transmit enabled, hi speed async.
	movwf	TXSTA		; set transmit status and control register.
	movlw	b'00100000'	; USART rx interrupt enabled.
	movwf	PIE1		; set peripheral interrupts enable register.
	
	IFDEF	__16F887
	movlw	b'11110000'	; select RB7-RB4 for interrupt on change
	movwf	IOCB		; set port b pins for interrupt on change
	ENDIF
	
	bcf	STATUS,RP0	; select bank 0
	movlw	b'10010000'	; serial enabled, etc.
	movwf	RCSTA		; set receive status and control register.

	clrf	PORTA		; clear port outputs
	clrf	PORTB
	bsf	PORTB,ISDSEL	; isd ss\ should be hi.
	clrf	PORTC
	bsf	PORTC,EEPSEL	; eeprom ss\ should be hi.
	clrf	PORTD
	clrf	PORTE	

	movlw	b'00100001'	; set up spp: on, spi master, clk/16
	movwf	SSPCON		; set up SPP for SPI mode.
	
	btfss	STATUS,NOT_TO	; did WDT time out?
	bsf	PORTA,LED1	; yes, light warning lamp.

	clrwdt			; give me more time to get up and running.
	movlw	h'20'		; first address of RAM.
	movwf	FSR		; set pointer.
ClrMem
	clrf	INDF		; clear ram byte.
	incf	FSR,f		; increment FSR.
	btfss	FSR,7		; cheap test for address 80 and above.
	goto	ClrMem		; loop some more.
	bsf	STATUS,IRP	; select FSR is in 100-1ff range
	
	movlw	TEN		; get timebase presets
	movwf	oneMsC
	movwf	tenMsC
	movwf	hundMsC
	movwf	thouMsC
	clrf	tFlags

	bsf	STATUS,RP0	; select register page 1.
	;; preset CI-V frequency in buffer to 28.4 MHz.
	clrf	civfrq1		; reset to 0 0.
	clrf	civfrq2		; reset to 0 0.
	movlw	h'40'		;   set to 4 0.
	movwf	civfrq3		;   set to 4 0.
	movlw	h'28'		;   set to 2 8.
	movwf	civfrq4		;   set to 2 8.
	clrf	civfrq5		; reset to 0 0.
	clrf	scanTmr		; clear scan timer.
	clrf	scanMod		; clear scan mode.
	bcf	STATUS,RP0	; select register page 0.
	
	movlw	CTNONE		; no courtesy tone.
	movwf	cTone		; set courtesy tone selector.
	
	;; preset timer defaults
	clrf	cwTbTmr		; CW timebase counter.
	
	movf	PORTB,w		; get port B value
	movwf	b_last		; save it...

	;; initialize the output port.
	clrf	PORTD		; clear port D
	bsf	PORTC,OUTSEL	; raise output port enable
	nop			; short delay
	bcf	PORTC,OUTSEL	; lower output port enable
	;; initialize the tone generator.
	bsf	PORTB,TONESEL	; set PDC3311 STROBE high
	nop			; short delay (PDC3311 requires 400 ns here)
	bcf	PORTB,TONESEL	; set PDC3311 STROBE low.
	;; clear the digital outputs.
	bsf	PORTA,EXPSEL	; raise digital output port enable
	nop			; very short delay
	bcf	PORTA,EXPSEL	; lower digital output port enable

	;; enable enough interrupts to run timer.
	movlw	b'10100000'	; enable global + timer interrupts
	movwf	INTCON

	;; now have a short pause before turning the ISD chip on.
	call	Delay20		; delay 20 ms.

	;; power up ISD chip!
InitISD
	bcf	INTCON,GIE	; disable interrupts
	btfsc	INTCON,GIE	; test interrupts still enabled?
	goto	InitISD		; still enabled, retry disable.
	clrf	isdCmdC		; clear command.
	bsf	isdCmdC,ISDPUP	; power up only.
	PAGE3			; select code page 3.
	call	CmdISD8a	; send the power up command.
	PAGE0			; select code page 0.

	;; enable interrupts.
	movlw	b'11111000'	; enable global + int, peripheral, timer, portb
	movwf	INTCON

	btfsc	PORTE,INIT	; skip if init button pressed.
	goto	Start1		; no initialize request.
	PAGE2			; select code page 2.
	call	InitEE		; initialize the EEPROM contents.
	PAGE0			; select code page 0.
	goto	Start1		; no initialize request.
	
Delay20				; get a 20 ms delay.
	movlw	d'20'		; ms.
	PAGE2			; select code page 2
	call	InitDly		; delay
	PAGE0			; select code page 0
	return			; done.

; ********************************
; ** Ready to really start now. **
; ********************************
Start1
	clrw			; select macro set 0.
	PAGE3			; select page 3.
	call	LoadCtl		; load control op settings.
	;; get tail message counter.
	clrf	eeAddrH		; clear EEPROM high address byte.
	movlw	EETTAIL		; get EEPROM address of tail message counter.
	movwf	eeAddrL		; set EEPROM address low byte.
	call	ReadEEw		; read EEPROM.
	movwf	tailCtr		; preset tail message counter.
	;; get phone ring counter.
	clrf	eeAddrH		; clear EEPROM high address byte.
	movlw	EETRING		; get EEPROM address of ring counter.
	movwf	eeAddrL		; set EEPROM address low byte.
	call	ReadEEw		; read EEPROM.
	PAGE0			; select page 0.
	movwf	ringCtr		; preset ring counter.
	;;
	;; say hello to all the nice people out there.
	;; 
	PAGE3			; select code page 3.
	movlw	VNHRC		; get word "NHRC".
	call	PutWord		; add word to send buffer.
	movlw	V10		; get word "TEN".
	call	PutWord		; add word to send buffer.
	movlw	VREPEAT		; get word "REPEATER".
	call	PutWord		; add word to send buffer.
	movlw	VCNTRLR		; get word "CONTROLLER".
	call	PutWord		; add word to send buffer.
	movlw	VVERSN		; get word "VERSION".
	call	PutWord		; add word to send buffer.
	movlw	VER_INT		; get word for major version number.
	call	PutWord		; add word to send buffer.
	movlw	VPOINT		; get word "POINT".
	call	PutWord		; add word to send buffer.
	movlw	VER_HI		; get word for minor version number.
	call	PutWord		; add word for number to send buffer.
	movlw	VER_LO		; get word for even mode minor version number.
	addlw	h'00'		; add zero, will set Z if zero.
	btfss	STATUS,Z	; skip this word if it is zero.
	call	PutWord		; add word for number to send buffer.
	PAGE0			; select code page 0.
	bsf	flags,initID	; want initial ID right away.
	bsf	flags,needID	; want to ID right away.

	btfss	group2,0	; is initial speech ID enabled?
	goto	Hello1		; no.
	call	DoID		; so ID already...
	goto	Loop0		; get started.

Hello1
	bsf	group2,0	; enable initial speech ID for now.
	call	DoID		; so ID already...
	bcf	group2,0	; return initial speech ID to disabled.
	
; **************************************************************************
; ******************************* MAIN LOOP ********************************
; **************************************************************************
		
Loop0
	btfsc	tFlags,TENSEC	; is ten second flag set?
	bcf	tFlags,TENSEC	; reset it if it is...

Chek1000	
	btfss	tFlags,ONESEC	; is the 1000 mS flag set?
	goto	Check100	; nope...
	bcf	tFlags,ONESEC	; clear 1000 mS flag.
	decfsz	thouMsC,f	; decrement hundred millisecond counter.
	goto	Check100	; not zero.
	movlw	TEN		; get preset.
	movwf	thouMsC		; reset down counter.
	bsf	tFlags,TENSEC	; set TENSEC indicator.

Check100	
	btfss	tFlags,HUNDMS	; is the 100 mS flag set?
	goto	Check10		; nope...
	bcf	tFlags,HUNDMS	; clear 100 mS flag.
	decfsz	hundMsC,f	; decrement hundred millisecond counter.
	goto	Check10		; not zero.
	movlw	TEN		; get preset.
	movwf	hundMsC		; reset down counter.
	bsf	tFlags,ONESEC	; set ONESEC indicator.

Check10
	btfss	tFlags,TENMS	; is the 10 mS flag set?
	goto	Check1		; nope...
	bcf	tFlags,TENMS	; clear 10 mS flag.
	decfsz	tenMsC,f	; decrement ten millisecond counter.
	goto	Check1		; not zero.
	movlw	TEN		; get preset.
	movwf	tenMsC		; reset down counter.
	bsf	tFlags,HUNDMS	; set HUNDMS indicator.

Check1
	btfss	tFlags,ONEMS	; is the 1 mS flag set?
	goto	CheckTic	; nope...
	bcf	tFlags,ONEMS	; clear 1 mS flag.
	decfsz	oneMsC,f	; decrement one millisecond counter.
	goto	CheckTic	; not zero.
	movlw	TEN		; get preset.
	movwf	oneMsC		; reset down counter.
	bsf	tFlags,TENMS	; set TENMS indicator.

CheckTic
	
	btfss	tFlags,TICK	; did a tick occur?
	goto	Loop1		; nope.
	bcf	tFlags,TICK	; reset TICK indicator.
	bsf	tFlags,ONEMS	; set ONEMS indicator.
	CLRWDT

Loop1
	;; LED BLINKER!!!  I'M ALIVE!!!	 I'M ALIVE!!!  WOOHOO!!!
	btfss	tFlags,HUNDMS
	goto	LedEnd
	btfss	PORTA,LED2
	goto	l3off
	bcf	PORTA,LED2
	goto	LedEnd
l3off 
	bsf	PORTA,LED2
LedEnd
	
; ********************************************
; ** RECEIVER DEBOUNCE AND INPUT VALIDATION **
; ********************************************
DebRx
	btfss	tFlags,ONEMS	; ten ms tick, check for receiver active
	goto	NoDeb		; nope
CkRx0				; check COR state receiver 1
	bcf	mscFlag,CTCSS0	; clear LAST CTCSS flag.
	btfss	PORTA,RX0PL	; is the PL signal present?
	bsf	mscFlag,CTCSS0	; set LAST CTCSS flag.
	btfss	PORTA,RX0COR	; check cor receiver 1
	goto	Rx0COR1		; it's low, COR is present
				; COR is not present.
	btfss	group1,2	; (NOT) OR PL?
	goto	Rx0Off		; nope...
	;; v 1.14 change here.
	btfsc	group0,1	; is PL required?
	goto	Rx0Off		; yes.
	;; end 1.14 change.
	goto	Rx0CkPL		; yes, OR PL mode
Rx0COR1
	btfss	group0,1	; AND PL set?
	goto	Rx0On		; no.
	;; v 1.14 new code.
	btfss	group1,2	; OR PL set?
	goto	Rx0CkPL		; no.
	;; AND and OR PL are both set, PL is required to bring up repeater,
	;; but not to access it during tail.
	movf	txFlag,w	; get txFlag.
	andlw	b'00000111'	; hang, rx1 or rx2 open.
	btfss	STATUS,Z	; Z will be set if repeater is idle.
	goto	Rx0On		; repeater is not idle.  Allow COR access.
	;; end v 1.14 new code.
Rx0CkPL				; check PL...
	btfsc	PORTA,RX0PL	; is the PL signal present?
	goto	Rx0Off		; no.
Rx0On				; the COR and PL requirements have been met
	btfsc	rxFlag,RX0OPEN	; already marked active?
	goto	Rx0NC		; yes.
	movf	rx0Dbc,f	; check for zero
	btfss	STATUS,Z	; is it zero?
	goto	Rx01Dbc		; nope...
	movlw	COR1DEB		; get COR debounce timer value.
	btfsc	group3,6	; is the delay present?
	movlw	DLY1DEB		; get COR debounce with delay value.
	movf	txFlag,f	; check for transmitter already on.
	btfss	STATUS,Z	; is the transmitter already on?
	goto	Rx0SDeb		; yep.
	btfsc	group0,2	; is the kerchunker delay set?
	movlw	CHNKDEB		; get kerchunker filter delay.
Rx0SDeb				; set debounce timer.
	movwf	rx0Dbc		; set it
	goto	Rx0Done		; done.
Rx01Dbc
	decfsz	rx0Dbc,f	; decrement the debounce counter
	goto	Rx0Done		; not zero yet
	bsf	rxFlag,RX0OPEN	; set receiver active flag
	goto	Rx0Done		; continue...
Rx0Off				; the COR and PL requirements have not been met
	btfss	rxFlag,RX0OPEN	; was the receiver off before?
	goto	Rx0NC		; yes.
	movf	rx0Dbc,f	; check for zero
	btfss	STATUS,Z	; is it zero?
	goto	Rx00Dbc		; nope...
	movlw	COR0DEB		; get COR debounce timer value.
	btfsc	group3,6	; is the delay present?
	movlw	DLY0DEB		; get COR debounce with delay value.
	movwf	rx0Dbc		; set it
	goto	Rx0Done		; done.
Rx00Dbc
	decfsz	rx0Dbc,f	; decrement the debounce counter
	goto	Rx0Done		; not zero yet
	bcf	rxFlag,RX0OPEN	; clear receiver active flag
	movf	dt0Tmr,f	; test to see if touch-tones received...
	btfsc	STATUS,Z	; is it zero?
	goto	Rx0Done		; yes. don't need to accellerate execution.
	movlw	d'2'		; no
	movwf	dt0Tmr		; accelerate eval of DTMF command
	goto	Rx0Done		; continue...
Rx0NC
	clrf	rx0Dbc		; clear debounce counter.
Rx0Done
		
CkRx1				; check COR state receiver 2
	bcf	mscFlag,CTCSS2	; clear LAST CTCSS flag.
	btfss	PORTE,RX1PL	; is the PL signal present?
	bsf	mscFlag,CTCSS2	; set LAST CTCSS flag.
	btfss	PORTE,RX1COR	; check cor receiver 1
	goto	Rx1COR1		; it's low, COR is present
				; COR is not present.
	btfss	group5,6	; (NOT) OR PL?
	goto	Rx1Off		; nope...
	;; v 1.14 new code
	btfsc	group5,5	; is PL required?
	goto	Rx1Off		; yes.
	;; end v 1.14 new code
	goto	Rx1CkPL		; yes, OR PL mode

Rx1COR1
	btfss	group5,5	; AND PL set?
	goto	Rx1On		; no.
	;; v 1.14 new code
	btfss	group5,6	; OR PL set?
	goto	Rx1CkPL		; no.
	;; AND and OR PL are both set, PL is required to bring up repeater,
	;; but not to access it during tail.
	movf	txFlag,w	; get txFlag.
	andlw	b'00000111'	; hang, rx1 or rx2 open.
	btfss	STATUS,Z	; Z will be set if repeater is idle.
	goto	Rx1On		; repeater is not idle.  Allow COR access.
	;; end v 1.14 new code.
Rx1CkPL				; check PL...
	btfsc	PORTE,RX1PL	; is the PL signal present?
	goto	Rx1Off		; no.
Rx1On				; the COR and PL requirements have been met
	btfsc	rxFlag,RX1OPEN	; already marked active?
	goto	Rx1NC		; yes.
	movf	rx1Dbc,f	; check for zero
	btfss	STATUS,Z	; is it zero?
	goto	Rx11Dbc		; nope...
	movlw	COR1DEB		; get COR debounce timer value
	btfsc	group3,7	; is the delay present?
	movlw	DLY1DEB		; get COR debounce with delay value.
	movf	txFlag,f	; check for transmitter already on.
	btfss	STATUS,Z	; is the transmitter already on?
	goto	Rx1SDeb		; yep.
	btfsc	group0,2	; is the kerchunker delay set?
	movlw	CHNKDEB		; get kerchunker filter delay.
Rx1SDeb				; set debounce timer.
	movwf	rx1Dbc		; set it
	goto	Rx1Done		; done.
Rx11Dbc
	decfsz	rx1Dbc,f	; decrement the debounce counter
	goto	Rx1Done		; not zero yet
	bsf	rxFlag,RX1OPEN	; set receiver active flag
	goto	Rx1Done		; continue...
Rx1Off				; the COR and PL requirements have not been met
	btfss	rxFlag,RX1OPEN	; was the receiver off before?
	goto	Rx1NC		; yes.
	movf	rx1Dbc,f	; check for zero
	btfss	STATUS,Z	; is it zero?
	goto	Rx10Dbc		; nope...
	movlw	COR0DEB		; get COR debounce timer value.
	btfsc	group3,7	; is the delay present?
	movlw	DLY0DEB		; get COR debounce with delay value.
	movwf	rx1Dbc		; set it
	goto	Rx1Done		; done.
Rx10Dbc
	decfsz	rx1Dbc,f	; decrement the debounce counter
	goto	Rx1Done		; not zero yet
	bcf	rxFlag,RX1OPEN	; set receiver active flag
	btfss	group1,7	; is control rx & link port the same?
	goto	Rx1Done		; nope.
	movf	dt2Tmr,f	; test to see if touch-tones received...
	btfsc	STATUS,Z	; is it zero?
	goto	Rx1Done		; yes. don't need to accellerate execution.
	movlw	d'2'		; no
	movwf	dt2Tmr		; accelerate eval of DTMF command
	goto	Rx1Done		; done.
Rx1NC
	clrf	rx1Dbc		; clear debounce counter.
Rx1Done
	
NoDeb
	;; service ISD RAC request here...
	btfss	isdFlag,ISDRACF ; is there a RAC waiting for service?
	goto	NoRAC		; nope.
	bcf	isdFlag,ISDRACF ; yes, clear the RAC flag.
	;; got a RAC indication from the ISD.
	btfsc	isdFlag,ISDIABF ; sent IAB command yet?
	goto	RACcChk		; yes...
	;; send the IAB command to the ISD and set the flag bit.
SendIAB
	bcf	INTCON,GIE	; disable interrupts
	btfsc	INTCON,GIE	; test interrupts still enabled?
	goto	SendIAB		; still enabled, retry disable.
	PAGE3			; select code page 3.
	call	CmdISD8		; send 8-bit command to ISD.
	PAGE0			; select code page 0.
	bsf	isdFlag,ISDIABF ; sent the IAB command.
	bsf	INTCON,GIE	; re-enable interrupts

RACcChk				; check rac counter.
	movf	isdRACc,f	; test RAC counter, should be >0...
	btfss	STATUS,Z	; skip if isdRACc is zero.
	goto	RACCNZ		; it's non-zero, this is the expected conditn.
	;; something bad has happened.	got a RAC indication when not
	;; expecting any.  Simply stop the ISD.
	PAGE3			; select code page 3.
	call	ISDStop		; stop play or record.
	PAGE0			; select code page 0.
	bcf	txFlag,TALKING	; turn this off, too.
	goto	NoRAC		; continue on our merry way...

RACCNZ				; recording, RACCNT is non-zero
	decfsz	isdRACc,f	; decrement RAC counter
	goto	NoRAC		; not zero yet.
	;; isdRACc has counted to zero.
	;; very near the end of this message space; 
	btfss	isdFlag,ISDRECF ; is a record operation in progress?
	goto	RACPlay		; Playback in progress. deal with it.
	;; in record mode. only one row left. need to leave room for
	;; eom marker.	use timer to halt after ISDLREC delay (200 ms)
	movlw	ISDDLYC		; get stop delay
	movwf	isdDly		; set stop delay
	goto	NoRAC		; continue.

RACPlay				; got final RAC in playback mode.
	PAGE3			; select code page 3.
	call	ISDStop		; stop play or record.
	PAGE0			; select code page 0.
	bcf	txFlag,TALKING	; turn this off, too.
	bsf	isdFlag,ISDWRDF ; set get another word indicator.
	goto	NoRACD		; continue & get the next word.

NoRAC				; 
	;; service isdDly timer here...
	btfss	tFlags,ONEMS	; one MS flag set?
	goto	NoRACD		; nope...
	movf	isdDly,f	; test isdDly...
	btfsc	STATUS,Z	; is it zero?
	goto	NoRACD		; yes.	Do nothing here.
	decfsz	isdDly,f	; decrement isdDly
	goto	NoRACD		; not zero yet.
	btfsc	isdFlag,ISDRUN	; was the ISD running
	goto	NoRACR		; yes.
	btfss	isdFlag,ISDD4RC ; deferred record requested?
	goto	WordEnd		; no.  start speech.
	;; deferred record requested.
	bcf	isdFlag,ISDD4RC ; clear deferred record bit
	movf	isdRMsg,w	; get record message number.
	movwf	isdMsg		; set message number.
	movlw	h'ff'		; set invalid record message number.
	movwf	isdRMsg		; save it.
	PAGE3			; select code page 3.
	call	ISDRec		; start recording
	PAGE0			; select code page 0.
	goto	NoRACD

NoRACR
	;; isd timer timed out.
	PAGE3			; select code page 3.
	call	ISDStop		; stop the ISD.
	PAGE0			; select code page 0.

NoRACD
	;; check ISDWRDF bit; indicated playback of word complete.
	btfss	isdFlag,ISDWRDF ; was IRQ flag set?
	goto	NoISDInt	; nope.
	;; the ISD wants another word...  Feed it.
	bcf	isdFlag,ISDWRDF ; clear the indicator
WordEnd
	PAGE3			; select code page 3.
	call	NextWrd		; see if there is another word
	PAGE0			; select code page 0.
NoISDInt			; no action required on the ISD.
	
	;goto	MainLp		; crosses 256 byte boundary (to 0400)

	;; leave room to fill this in
		
	;org 0400

; *************************************
; * main loop for repeater controller *
; *************************************

MainLp
	movlw	high MlTbl	; set high byte of address
	movwf	PCLATH		; select page
	movf	rx0Stat,w	; get main receiver state
	addwf	PCL,f		; add w to PCL:	 computed GOTO
MlTbl
	goto	Main0		; quiet
	goto	Main1		; repeat
	goto	Main2		; timeout

Main0				; receiver quiet state
	btfss	rxFlag,RX0OPEN	; is squelch open?
	goto	ChkRb		; nope, don't turn receiver on
	;; receiver is unsquelched; put it on the air
	;; receiver inactive --> active transistion
	btfss	group0,0	; is repeater enabled?
	goto	ChkRb		; disabled, not gonna turn receiver on
	btfss	group0,5	; is DTMF access mode enabled?
	goto	Main00		; no.
	movf	dtATmr,f	; check DTMF access mode timer.
	btfsc	STATUS,Z	; is it zero?
	goto	ChkRb		; yes.	Don't turn receiver on.
	;; timer is not zero, reset to initial value.
	clrf	eeAddrH		; clear EEPROM high address byte.
	movlw	EETDTA		; get EEPROM address of DTMF access timer.
	movwf	eeAddrL		; set EEPROM address low byte.
	PAGE3			; select code page 3.
	call	ReadEEw		; read EEPROM.
	PAGE0			; select code page 0.
	movwf	dtATmr		; set DTMF access mode timer.
Main00				; receiver inactive --> active transition
	movlw	RXSON		; get new state #
	movwf	rx0Stat		; set new receiver state
	bsf	txFlag,RX0OPEN	; set main receiver on bit
	movlw	CTNONE		; no courtesy tone.
	movwf	cTone		; kill off any pending courtesy tone.
	;; read kerchunker timer.
	clrw			; default if not setting kerchunk timer

	;; determine if the kerchunk timer should be set
	movf	hangTmr,f	; check hang timer
	btfss	STATUS,Z	; is it zero?
	goto	Main00x		; nope.  don't set kerchunk timer
	
	clrf	eeAddrH		; clear EEPROM high address byte.
	movlw	EEKCTMR		; get EEPROM address of kerchunker filter timer.
	movwf	eeAddrL		; set EEPROM address low byte.
	PAGE3			; select code page 3.
	call	ReadEEw		; read EEPROM.
	PAGE0			; select code page 0.
Main00x
	bsf	STATUS,RP0	; select register page 1.
	movwf	kchkTmr		; set kerchunker timer.
	clrf	scanTmr		; stop scanning.
	clrf	scanMod		; stop scanning.
	bcf	STATUS,RP0	; select register page 0.
	btfss	group5,1	; is RB in receive mode?
	goto	Main00a		; nope.
	bsf	flags,RBMUTE	; set the muted indicator.
	bcf	outPort,RX1AUD	; mute the remote base.
Main00a
	movf	group5,w	; get group 5
	andlw	b'00000110'	; is the link in transmit or receive mode?
	btfsc	STATUS,Z	; skip if either bit is set.
	goto	Main00b		; neither bit is set.
	clrf	eeAddrH		; clear EEPROM high address byte.
	movlw	EERBTMR		; get EEPROM address of remote base timer.
	movwf	eeAddrL		; set EEPROM address low byte.
	PAGE3			; select code page 3.
	call	ReadEEw		; read EEPROM.
	PAGE0			; select code page 0.
	movwf	rbTmr		; set remote base activity timer.
Main00b
	
	movf	muteTmr,f	; check mute timer
	btfsc	STATUS,Z	; if it's non-zero, skip unmute
	bsf	outPort,RX0AUD	; unmute receiver
	;; stomp playing voice messages here.
	btfss	isdFlag,ISDRUNF ; is ISD Running?
	goto	ChkRec		; no
	;; ISD is running.
	btfss	idRFlag,IDNOW	; is an ID playing now?
	goto	Stomp		; nope.
	btfss	group3,1	; is stomp allowed?
	goto	MainUM		; nope.	 bypass record check, too.
Stomp
	clrf	isdDly		; clear this so it can't fire, just in case.
	PAGE3			; select code page 3.
	call	ISDAbort	; abort ISD
	PAGE0			; select code page 0.

	btfss	idRFlag,IDNOW	; is an ID playing now?
	;; hmmmm.  should this be allowed to set record mode now?
	goto	ChkRec		; no.

	movlw	EECWID		; address of CW ID message in EEPROM.
	movwf	eeAddrL		; save CT base address
	clrf	eeAddrH		; save CT base address hi byte
	PAGE3			; select code page 1.
	call	PTTon		; turn on tx if not on already.
	call	PlayCWe		; kick off the CW playback.
	PAGE0			; select code page 0.
	bcf	idRFlag,IDNOW	; clear IDing flag.
	
ChkRec
	btfss	isdFlag,ISDRECR ; is record mode flag set?
	goto	MainUM		; no continue...
	bcf	isdFlag,ISDRECR ; clear record mode flag.
	incfsz	isdRMsg,w	; check for invalid number
	goto	ChkRec1		; valid number
	goto	MainUM		; invalid number
ChkRec1
	clrf	isdDly
	bsf	isdFlag,ISDD4RC ; set deferred record bit.
	movlw	ISD_DLY		; get ISD delay time
	movwf	isdDly		; set ISD timer for deferred record.
	
MainUM
	;; link non-repeater PTT logic
	btfss	group5,2	; is link TX enabled?
	goto	Main01		; nope...
	btfsc	group3,3	; is link port a repeater?
	goto	Main01		; yes ...
	btfsc	group5,3	; is link enabled during patch?
	goto	MainUML		; yes.
	btfsc	txFlag,PATCHON	; is the patch on?
	goto	Main01		; yes.

MainUML				; turn on the link transmitter.
	bsf	outPort,TX1PTT	; turn on link PTT

Main01
	btfss	group1,0	; is time out timer enabled?
	goto	ChkRb		; nope...
	clrf	eeAddrH		; clear EEPROM high address byte.
	movlw	EETTMS		; EEPROM address of timeout timer short preset.
	btfsc	group1,1	; is short timeout selected
	movlw	EETTML		; EEPROM address of timeout timer long preset.
	movwf	eeAddrL		; set EEPROM address low byte.
	PAGE3			; select code page 3.
	call	ReadEEw		; read EEPROM.
	PAGE0			; select code page 0.
	movwf	rx0TOut		; set timeout counter
	goto	ChkRb		; done here...

Main1				; receiver active state
	btfss	group0,0	; is repeater enabled?
	goto	Main1Off	; no.  turn receiver off
	btfss	rxFlag,RX0OPEN	; is squelch open?
	goto	Main1Off	; no, on->off transition
	btfss	tFlags,HUNDMS	; tenth second tick?
	goto	Main1z		; nope

	bsf	STATUS,RP0	; select register page 1.
	movf	kchkTmr,f	; get kerchunker timer.
	btfsc	STATUS,Z	; is it zero
	goto	Main1z		; yes.  it is zero.
	decf	kchkTmr,f	; decrement the kerchunker timer.

Main1z	
	bcf	STATUS,RP0	; select register page 0.
	btfss	tFlags,ONESEC	; one second tick?
	goto	ChkRb		; nope, continue
	movf	rx0TOut,f	; squelch still open, check timeout timer
	btfsc	STATUS,Z	; skip if not zero
	goto	ChkRb		; timeout timer is zero, don't decrement
	decfsz	rx0TOut,f	; decrement the timeout timer
	goto	ChkRb		; have not timed out (yet), continue
	movlw	RXSTMO		; get new state, timed out
	movwf	rx0Stat		; set new receiver state
	bcf	txFlag,RX0OPEN	; clear main receiver on bit
	bcf	outPort,RX0AUD	; mute
	clrf	rx0TOut		; clear main receiver timeout timer
	btfsc	group3,2	; is voice timeout message enabled?
	goto	Main1TO		; yes...
	PAGE3			; select code page 3.
	movlw	CW_TO		; get CW timeout message.
	call	PlayCW		; play CW message.
	PAGE0			; select code page 1.
	goto	ChkRb		; done here...
Main1TO 
	movlw	VTOUT		; time out message
	call	PlayMsg		; play the message
	goto	ChkRb		; done here...

Main1Off			; receiver was active, became inactive
	call	Rcv0Off		; turn off receiver
	;; link non-repeater-mode PTT logic
	btfss	group5,2	; is link port TX enabled?
	goto	Main10		; nope...
	btfsc	group3,3	; is link port a repeater?
	goto	Main10		; yes...
	bcf	outPort,TX1PTT	; no, turn off link port tx
Main10
	;; version 1.14 changes
	;; bugfix for drop tx to mute dtmf not unmuting fast enough.
	movf	muteTmr,f	; test mute timer.
	btfsc	STATUS,Z	; z is set if NOT muting.
	goto	Main100		; muteTmr is zero.
	clrf	muteTmr		; make muting timer zero now.
	btfsc	group6,6	; drop tx to mute DTMF enabled, main.
	bsf	outPort,TX0PTT	; turn PTT back on.
	btfss	group1,4	; drop link to mute PTT enabled?
	goto	Main100		; no.
	btfss	group5,2	; link transmitter enabled?
	goto	Main100		; no.
	btfss	group3,3	; link port repeater mode enabled?
	goto	Main100		; no.
	bsf	outPort,TX1PTT	; turn link PTT back on.

Main100
	;; end version 1.14 changes
	btfss	isdFlag,ISDRECF ; is the ISD recording
	goto	Main10a		; nope.
	PAGE3			; select code page 3.
	call	ISDStop		; stop recording.
	PAGE0			; select code page 1.
	
Main10a
	btfss	isdFlag,ISDTEST ; was test message just recorded?
	goto	Main10b		; nope.
	bcf	isdFlag,ISDTEST ; clear test flag.
	movlw	VTESTM		; get test message track
	PAGE3			; select code page 3.
	call	PutWord		; put word into buffer
	bsf	outPort,BEEPAUD ; turn on beep audio
	call	SetPort		; set the output port
	call	PlaySpc		; play the speech message.
	PAGE0			; select code page 0.
	
Main10b
	btfss	mbxCtl,MBXRHDR	; was mailbox header just recorded?
	goto	Main10c		; no.
	movlw	VRECORD		; get word "record".
	PAGE3			; select code page 3.
	call	PutWord		; put word into buffer
	movlw	VMBX		; get word "mailbox".
	call	PutWord		; put word into buffer
	movlw	VMESSAG		; get word "message".
	call	PutWord		; put word into buffer
	bsf	outPort,BEEPAUD ; turn on beep audio
	call	SetPort		; set the output port
	call	PlaySpc		; play the speech message.
	PAGE0			; select code page 0.

	movf	mbxCtl,w	; get message number
	andlw	h'0f'		; mask out high nibble
	addlw	VMB1		; add address of mailbox message slot.
	movwf	isdRMsg		; set record message number.
	bsf	isdFlag,ISDRECR ; set record mode flag
	bcf	mbxCtl,MBXRHDR	; clear record header control bit
	bsf	mbxCtl,MBXRMBX	; set record mailbox control bit.
	goto	Main10d

Main10c
	btfss	mbxCtl,MBXRMBX	; was mailbox just recorded?
	goto	Main10d		; no.
	bcf	mbxCtl,MBXRMBX	; clear record mailbox control bit.
	movlw	VOK		; get word "OK".
	PAGE3			; select code page 3.
	call	PutWord		; put word into buffer
	bsf	outPort,BEEPAUD ; turn on beep audio
	call	SetPort		; set the output port
	call	PlaySpc		; play the speech message.
	PAGE0			; select code page 0.

Main10d
	;; check the kerchunker timer...
	bsf	STATUS,RP0	; select register page 1.
	movf	kchkTmr,f	; get kerchunker timer.
	btfsc	STATUS,Z	; is it zero
	goto	Main10dd	; yes.  it is zero.
	;; this is a kerchunk event!
	clrf	kchkTmr		; clear the kerchunk timer for next time
	bcf	STATUS,RP0	; select register page 0.
	bsf	flags,CHUNKED	; set kerchunked flag
	goto	ChkRb		; NO courtesy tone, tail, or ID...
	
Main10dd
	bcf	STATUS,RP0	; select register page 0.
	bcf	flags,CHUNKED	; clear kerchunked flag
	movlw	CTNORM		; get CT number
	btfss	group5,2	; is rb tx enabled?
	goto	Main10e		; nope.
	movlw	CTRBTX		; yes, get that courtesy tone
	goto	Main10h

Main10e
	btfss	group5,0	; is alert mode on?
	goto	Main10h		; nope.
	btfsc	rxFlag,RX1OPEN	; is rb squelch open?
	movlw	CTALERT		; yes, get that courtesy tone

Main10h
	movwf	cTone		; save the courtesy tone.
	call	SetHang		; start/restart the hang timer
	call	ChkID		; test if need an ID now

	btfss	mscFlag,LITZDT0 ; is LITZ bit set?
	goto	ChkRb		; nope.
	bcf	mscFlag,LITZDT0 ; clear LITZ bit.
	movlw	VLITZ		; get LITZ message.
	call	PlayMsg		; play the LiTZ message.
	goto	ChkRb		; done here...

Main2				; receiver timedout state
	btfss	group0,0	; is repeater enabled?
	goto	Main2Off	; no.  turn receiver off
	btfsc	rxFlag,RX0OPEN	; is squelch still open?
	goto	ChkRb		; yes, still timed out
Main2Off			; end of timeout condition.
	movlw	RXSOFF		; timeout condition ended, get new state (off)
	movwf	rx0Stat		; set new receiver state
	btfsc	group3,2	; is voice timeout message enabled?
	goto	Main2TO		; yes...
	PAGE3			; select code page 3.
	call	PTTon		; turn on PTT
	movlw	CW_TO		; get CW timeout message.
	call	PlayCW		; play CW message.
	PAGE0			; select code page 1.
	goto	ChkRb		; done here...
Main2TO 
	movlw	VTOUT		; time out message
	call	PlayMsg		; play the message
	goto	ChkRb		; seems redundant, but it ain't

ChkRb
	movlw	high RlTbl	; set high byte of address
	movwf	PCLATH		; select page
	movf	rx1Stat,w	; get link receiver state
	addwf	PCL,f		; add w to PCL:	 computed GOTO
RlTbl
	goto	RbRx0		; quiet
	goto	RbRx1		; repeat
	goto	RbRx2		; timeout

RbRx0				; receiver quiet state
	btfss	rxFlag,RX1OPEN	; is squelch open?
	goto	ChkTmrs		; nope, don't turn receiver on
	btfss	group0,0	; is repeater enabled?
	goto	ChkTmrs		; no.  don't allow link activity.
	movf	group5,w	; get group 6
	andlw	b'00000110'	; and it with receive mode || transmit mode
	btfsc	STATUS,Z	; is result zero?
	goto	ChkTmrs		; no...
	;; don't turn on link if patch is on and link disabled during patch.
	btfss	txFlag,PATCHON	; is patch on?
	goto	RbRx0a		; no.
	btfss	group5,3	; is link enabled during patch?
	goto	ChkTmrs		; no.

RbRx0a	
	btfss	group0,5	; is DTMF access mode enabled?
	goto	RbRx01		; no.
	movf	dtATmr,f	; check DTMF access mode timer.
	btfsc	STATUS,Z	; is it zero?
	goto	ChkTmrs		; yes.	Don't turn receiver on.
	;; timer is not zero, reset to initial value.
	clrf	eeAddrH		; clear EEPROM high address byte.
	movlw	EETDTA		; get EEPROM address of DTMF access timer.
	movwf	eeAddrL		; set EEPROM address low byte.
	PAGE3			; select code page 3.
	call	ReadEEw		; read EEPROM.
	PAGE0			; select code page 0.
	movwf	dtATmr		; set DTMF access mode timer.
	
RbRx01				; turn on remote base receiver.
	movlw	RXSON		; get new state #
	movwf	rx1Stat		; set new receiver state
	bsf	txFlag,RX1OPEN	; set link receiver on bit
	btfss	flags,RBMUTE	; is mute requested for some reason?
	bsf	outPort,RX1AUD	; no, unmute.
	btfss	group5,7	; is time out timer enabled?
	goto	ChkTmrs		; nope...
	clrf	eeAddrH		; clear EEPROM high address byte.
	movlw	EETTMS		; EEPROM address of timeout timer long preset.
	btfsc	group1,1	; is short timeout selected
	movlw	EETTML		; EEPROM address of timeout timer short preset.
	movwf	eeAddrL		; set EEPROM address low byte.
	PAGE3			; select code page 3.
	call	ReadEEw		; read EEPROM.
	PAGE0			; select code page 0.
	movwf	rx1TOut		; set timeout counter
	goto	ChkTmrs		; done here...

RbRx1				; receiver active state
	btfss	group0,0	; is repeater enabled?
	goto	RbRx1Off	; no.  turn off link receiver.
	movf	group5,w	; get group 5: link port configuration.
	andlw	b'00000110'	; and it with receive mode || transmit mode
	btfsc	STATUS,Z	; is result zero?
	goto	RbRx1Off	; yes.	turn off link receiver.
	
	btfss	rxFlag,RX1OPEN	; is squelch open?
	goto	RbRx1Off	; no, on->off transition
	btfss	tFlags,ONESEC	; one second tick?
	goto	ChkTmrs		; nope, continue
	movf	rx1TOut,f	; squelch still open, check timeout timer
	btfsc	STATUS,Z	; skip if not zero
	goto	ChkTmrs		; timeout timer is zero, don't decrement
	decfsz	rx1TOut,f	; decrement the timeout timer
	goto	ChkTmrs		; have not timed out (yet), continue
	movlw	RXSTMO		; get new state, timed out
	movwf	rx1Stat		; set new receiver state
	bcf	txFlag,RX1OPEN	; clear link receiver on bit
	bcf	outPort,RX1AUD	; mute receiver 1
	clrf	rx1TOut		; clear receiver 1 timeout timer
	btfsc	group3,2	; is voice timeout message enabled?
	goto	RbRx1TO		; yes...
	PAGE3			; select code page 3.
	movlw	CW_TO		; get CW timeout message.
	call	PlayCW		; play CW message.
	PAGE0			; select code page 1.
	goto	ChkTmrs		; done here...
RbRx1TO 
	movlw	VTOUT		; time out message
	call	PlayMsg		; play the message
	goto	ChkTmrs		; done here...

RbRx1Off			; receiver was active, became inactive
	call	Rcv1Off		; turn off link receiver

	;; if link tx is on, and link is not a repeater, then 
	;; suppress link ctsy tone.
	btfss	outPort,TX1PTT	; is link tx on?
	goto	RbRx1o1		; nope.
	btfss	group3,3	; is link port in slave repeater mode?
	goto	RbRx1oh		; no, just hang, no ctsy tone.

RbRx1o1 
	;; receiver 2 courtesy tone
	movlw	CTRRBRX		; get eeprom address CT mask
	btfss	group5,2	; is rb tx enabled?
	goto	RbRx1oc		; no, set the tone & hang
	movlw	CTRRBTX		; yes, get that courtesy tone
	btfsc	group3,3	; is RB port a repeater?
	goto	RbRx1oc		; yes, set the tone & hang
	btfsc	txFlag,RX0OPEN	; is main receiver on bit set?
	goto	RbRx1oh		; yes, hang without a beep!

RbRx1oc
	movwf	cTone		; save the courtesy tone mask.

	btfss	mscFlag,LITZDT2 ; is LITZ bit set?
	goto	RbRx1oh		; nope.
	bcf	mscFlag,LITZDT2 ; clear LITZ bit.
	movlw	VLITZ		; get LITZ message.
	call	PlayMsg		; play the LiTZ message.
	
RbRx1oh
	call	SetHang		; start/restart the hang timer
	call	ChkID		; test if need an ID now
	goto	ChkTmrs		; done here...

RbRx2				; receiver timedout state
	btfss	group0,0	; is repeater enabled?
	goto	RbRx2Off	; no.  turn off link receiver.
	movf	group5,w	; get group 6
	andlw	b'00000110'	; and it with receive mode || transmit mode
	btfsc	STATUS,Z	; is result zero?
	goto	RbRx2Off	; yes.	turn off link receiver.

	btfsc	rxFlag,RX1OPEN	; is squelch open?
	goto	ChkTmrs		; yes, still timed out
RbRx2Off	
	movlw	RXSOFF		; timeout condition ended, get new state (off)
	movwf	rx1Stat		; set new receiver state

	btfsc	group3,2	; is voice timeout message enabled?
	goto	RbRx2TO		; yes...
	PAGE3			; select code page 3.
	call	PTTon		; turn on PTT.
	movlw	CW_TO		; get CW timeout message.
	call	PlayCW		; play CW message.
	PAGE0			; select code page 1.
	goto	ChkTmrs		; done here...

RbRx2TO
	movlw	VTOUT		; time out message
	call	PlayMsg		; play the message


ChkTmrs				; check timers here.
	goto	Ck10mS		; skip one ms timer.
	;; start with one-millisecond timers
	btfss	tFlags,ONEMS	; is one-millisecond bit set?
	goto	Ck10mS		; nope.
	;; one-millisecond tick active.
	
Ck10mS				; check 10 millisecond timers
	btfss	tFlags,TENMS	; is ten-millisecond bit set?
	goto	Ck100mS		; nope.
	;; ten millisecond tick active.
	btfsc	PORTA,PHRING	; is the phone ringing?
	goto	NoRing		; no ring signal.
	;; there is a ring pulse detected.
	movf	ringDur,f	; check for zero...
	btfsc	STATUS,Z	; is it zero?
	goto	RingZer		; yes.
	movf	ringPul,f	; check ring pulse.
	btfsc	STATUS,Z	; skip if not zero.
	goto	NoRing		; it's zero.
	decfsz	ringPul,f	; decrement, skip if result is zero.
	goto	NoRing		; result is not zero.
	goto	GotRing		; result is zero.
	
RingZer				; ring just started.
	movlw	RNG_DUR		; get ring debounce duration.
	movwf	ringDur		; set ring debounce duration timer.
	movlw	RNG_PLS		; get ring pulse counter.
	movwf	ringPul		; set ring pulse counter.
	goto	RingEnd		; done here.

GotRing				; got a valid ring signal.
	movlw	RNG_TMO		; get ring timeout.
	movwf	ringTmr		; set ring timer.
	btfss	group4,7	; is phone auto-answer enabled?
	goto	RingAir		; nope.
	decfsz	ringCtr,f	; decrement ring counter.
	goto	RingAir		; not zero yet.
	;; going to pick up the phone now...
	;; reset ring counter for next time.
	clrf	eeAddrH		; clear EEPROM high address byte.
	movlw	EETRING		; get EEPROM address of ring counter.
	movwf	eeAddrL		; set EEPROM address low byte.
	PAGE3			; select page 3.
	call	ReadEEw		; read EEPROM.
	PAGE0			; select page 0.
	movwf	ringCtr		; preset ring counter.
	;; clear ring timeout timer.
	clrf	ringTmr		; clear ring counter timeout timer.
	;; now pick up the phone and say hello.
	clrf	eeAddrH		; clear EEPROM high address byte.
	movlw	EETPAT		; get EEPROM address of patch timer preset.
	movwf	eeAddrL		; set EEPROM address low byte.
	PAGE3			; select code page 3
	call	ReadEEw		; read EEPROM.
	movwf	ptchTmr		; set autopatch timer.
	call	FoneUp		; pick up phone.
	movlw	VPHONE		; get word 'phone'.
	call	PutWord		; put word into buffer.
	movlw	VON		; get word 'on'.
	call	PutWord		; put word into buffer.
	call	PlaySpc		; send the words.
	PAGE0			; select code page 0.
	goto	RingEnd		; done.
	
RingAir
	btfss	group4,6	; ring out over air allowed?
	goto	RingEnd		; nope.
	PAGE3			; select code page 3.
	movlw	RNG_TON		; offset of ring tone in ROM table.
	call	PlayCTx		; play ct from table.
	PAGE0			; select code page 0.
	goto	RingEnd		; done here.

NoRing				; there is no ringing signal right now.
	movf	ringDur,f	; check for zero...
	btfsc	STATUS,Z	; skip if not zero.
	goto	RingEnd		; it's zero.
	decfsz	ringDur,f	; decrement it.	 skip if result is zero.
	goto	RingEnd		; result is not zero.
	clrf	ringPul		; clear ring pulse counter.
	
	;; done with ringer debounce for no ring sig detected.
RingEnd
	movf	pulsTmr,f	; check for pulsed output
	btfsc	STATUS,Z	; is it zero?
	goto	PulsEnd		; yep.
	decfsz	pulsTmr,f	; decrement and check for zero.
	goto	PulsEnd		; not zero yet.
	movf	group6,w	; get digout pulse control.
	andlw	h'0f'		; mask leaves low 4 bits.
	xorlw	h'ff'		; invert.
	btfsc	group6,D58PUL	; bits 5-8 also pulsed?
	andlw	h'0f'		; clear the high nibble
	andwf	group7,f	; update the port.
PulsEnd				; done with IO output pulse logic
	;; check for scan mode enabled.
	bsf	STATUS,RP0	; select register page 1.
	movf	scanTmr,f	; check this out.
	btfsc	STATUS,Z	; skip if non-zero.
	goto	NoScan		; it is zero.
	decfsz	scanTmr,f	; decrement.  skip if now zero.
	goto	NoScan		; it is not zero yet.
	movlw	CIVSCTM		; get new timer value.
	movwf	scanTmr		; preset the timer for next time.
	bcf	STATUS,RP0	; select register page 0.
	PAGE2			; select code page 2.
	call	ScanTun		; re-tune the radio.
	PAGE0			; select code page 0.
	goto	ScnTEnd		; done.
NoScan
	bcf	STATUS,RP0	; select register page 0.
ScnTEnd				; scan timer processing done.

Ck100mS				; check 100 millisecond tick.
	btfss	tFlags,HUNDMS	; is 100 millisecond bit set?
	goto	Ck1S		; nope.
	;; 100 millisecond tick active.
	;; check hang timer.
	movf	hangTmr,f	; check hang timer
	btfsc	STATUS,Z	; is it zero?
	goto	NoHang		; yes, not hang active, continue

	movf	hangTmr,w	; get hang timer
	subwf	hangDly,w	; w = hangDly - hangTmr(w) (amount hang used)
	sublw	d'05'		; subtract .5 seconds
	btfss	STATUS,Z	; skip if result is 0
	goto	HangNob		; not 0...don't beep.
	;; check to see if there is something already playing
	movf	txFlag,w	; get txFlag
	andlw	b'10110000'	; and txFlag with (CW or ISD or DTMF)
	btfsc	STATUS,Z	; is the result zero?
	goto	HangCT		; yes, ok to play CT.
	bsf	flags,DEF_CT	; set defer CT flag.
	goto	HangNob		; don't beep now.
	
	;;  bag the beep, CW, ISD or DTMF is playing.

	;; select courtesy tone here.
HangCT
	btfsc	txFlag,PATCHON	; is patch on?
	goto	HangNob		; patch is on, suppress CT
	incf	cTone,w		; check cTone for FF
	btfsc	STATUS,Z	; is result 0?
	goto	HangNob		; yes, cTone was FF.
	btfss	group0,6	; is courtesy tone enabled?
	goto	HangNob		; courtesy tone disabled.
	movlw	CTTUNE		; get tune mode courtesy tone.
	btfsc	tuneFlg,DT0TUNE ; is this port (main receiver) in tune mode?
	movwf	cTone		; yep. set tune mode courtesy tone.
	btfsc	tuneFlg,DT2TUNE ; is this port (link/control rx) in tune mode?
	movwf	cTone		; yep. set tune mode courtesy tone.
	movlw	CTUNLOK		; get unlocked mode courtesy tone.
	btfsc	dtRFlag,DT0UNLK ; is this port (main receiver) unlocked?
	movwf	cTone		; yep. set unlocked courtesy tone.
	btfsc	dtRFlag,DT2UNLK ; is this port (link/cntl rx) unlocked?
	movwf	cTone		; yep. set unlocked courtesy tone.

	PAGE3			; select code page 3.
	call	PlayCT		; play courtesy tone #w
	PAGE0			; select code page 0.

HangNob				; hanging without a beep
	decfsz	hangTmr,f	; decrement and check if now zero
	goto	NoHang		; not zero
	;; end of hang time.
	bcf	txFlag,TXHANG	; turn off hang time flag
	movf	txFlag,f	; check tXflag for zero.
	btfss	STATUS,Z	; is it zero?
	goto	NoHang		; no.  Don't touch hang timer.
	;; check tail message
	movf	tailCtr,f	; check.
	btfsc	STATUS,Z	; skip if tailCtr not zero.
	goto	NoHang		; tailCtr is zero.
	decfsz	tailCtr,f	; decrement tailCtr, skip if now zero.
	goto	NoHang		; not zero
	;; tail message time.
	call	DoTail		; play tail message.
	
NoHang				; done with hang timer...
	;; process DTMF muting timer...
	movf	muteTmr,f	; test mute timer
	btfsc	STATUS,Z	; Z is set if not DTMF muting
	goto	NoMutTm		; muteTmr is zero.
	decfsz	muteTmr,f	; decrement muteTmr
	goto	NoMutTm		; have not reached the end of the mute time
	btfsc	txFlag,RX0OPEN	; is receiver 0 unsquelched
	bsf	outPort,RX0AUD	; unmute it...

	btfss	txFlag,RX1OPEN	; is receiver 1 unsquelched
	goto	UnMutTx		; no.
	btfss	flags,RBMUTE	; is RB muted for some other reason?
	bsf	outPort,RX1AUD	; no, unmute it...
UnMutTx 
	btfsc	group6,6	; drop main receiver to mute enabled?
	bsf	outPort,TX0PTT	; turn on main receiver PTT!
	btfss	group1,4	; drop link to mute enabled?
	goto	NoMutTm		; no.
	btfss	group5,2	; link transmitter enabled?
	goto	NoMutTm		; nope.
	btfsc	txFlag,RX0OPEN	; is receiver 0 unsquelched
	bsf	outPort,TX1PTT	; yes. turn on link PTT.

NoMutTm				; done with muting timer...
	btfss	mscFlag,NNXIE	; is the NNX INIT bit set?
	goto	NoNNXi		; nope.
	;; set up base eeprom address.
	clrf	eeAddrL		; clear EEPROM address lo byte.
	swapf	nnxInit,w	; swap bytes of nnxInit into w
	andlw	b'00001111'	; mask out unused bits
	movwf	eeAddrH		; save EEPROM address hi byte base.
	rrf	eeAddrH,f	; rotate right
	btfsc	STATUS,C	; was the low bit set?
	bsf	eeAddrL,7	; yep.  add 0x80 to low byte of EEPROM addr.
	movlw	high EEAC00	; get high byte of EEPROM address.
	addwf	eeAddrH,f	; add to hi byte of EEPROM address.

	swapf	nnxInit,w	; swap nibbles in nnxInit into w.
	andlw	b'01110000'	; mask out all bits except address.
	addwf	eeAddrL,f	; add to eeprom address.
	movlw	d'16'		; count of bytes to write.
	movwf	temp		; save this.
	;; now check for 96-99.
	movf	nnxInit,w	; get nnxInit.
	andlw	b'00000111'	; mask out all but init address indicator bits.
	xorlw	b'00000110'	; check for 6
	btfss	STATUS,Z	; is it zero?
	goto	NNXi1		; nope.
	;; special for the last bank.
	movlw	d'4'		; count of bytes to write.
	movwf	temp		; save this.
	bcf	mscFlag,NNXIE	; will be done after this.
NNXi1
	movf	temp,w		; get number of bytes to write into eeprom.
	movwf	eeCount		; set number of bytes to write into eeprom.
	movlw	h'ff'		; initial value.
	btfss	nnxInit,NNXCB	; want ones?
	clrw			; nope.
	movwf	temp2		; save initial value.
	movlw	low eebuf00	; get base of buffer
	movwf	FSR		; set into FSR.
NNXiL
	movf	temp2,w		; get initial byte
	movwf	INDF		; save it into buffer.
	incf	FSR,f		; increment buffer pointer.
	decfsz	temp,f		; decrement number of bytes to write.
	goto	NNXiL		; not zero yet, go around again.
	movlw	low eebuf00	; get base of buffer
	movwf	FSR		; set into FSR.
	PAGE3			; select code page 3.
	call	WriteEE		; write EEPROM
	PAGE0			; select code page 0.
	incf	nnxInit,f	; move on to next page
	;; done for now.
NoNNXi
	movf	ringTmr,f	; test.
	btfsc	STATUS,Z	; is it zero?
	goto	NoRngTm		; yep.
	decfsz	ringTmr,f	; decrement.
	goto	NoRngTm		; not zero yet.
	clrf	eeAddrH		; clear EEPROM high address byte.
	movlw	EETRING		; get EEPROM address of ring counter.
	movwf	eeAddrL		; set EEPROM address low byte.
	PAGE3			; select page 3.
	call	ReadEEw		; read EEPROM.
	PAGE0			; select page 0.
	movwf	ringCtr		; preset ring counter.
NoRngTm
	;; check for deferred patch...
	btfss	flags,DEFFONE	; is the defered call wanted?
	goto	NoCall		; nope.
	movf	txFlag,w	; get txFlag.
	andlw	b'11110000'	; any reason to not dial?
	btfss	STATUS,Z	; skip if zero: no reason not to dial.
	goto	NoCall		; there is a reason not to dial.
	PAGE3			; select ROM page 3.
	call	DoPhone		; make the call.
	PAGE0			; select ROM page 0.
NoCall	
	btfss	flags,RBMUTE	; is the remote base muted for some reason?
	goto	NoRBMut		; nope.
	movf	txFlag,w	; get txFlag.
	andlw	b'11110001'	; any reason to keep muting?
	btfss	STATUS,Z	; skip if zero: ok to unmute.
	goto	NoRBMut		; don't unmute yet.
	bcf	flags,RBMUTE	; clear the RBMUTE flag.
	btfsc	group5,1	; in receive mode?
	goto	RBUnMut		; yep.
	btfss	group5,2	; in transmit mode?
	goto	NoRBMut		; nope.
RBUnMut 
	btfsc	txFlag,RX1OPEN	; skip if the RB receiver is not active.
	bsf	outPort,RX1AUD	; unmute the remote base.
NoRBMut				; done with remote base muting checks.
	
Ck1S				; check 1-second flag bit.
	btfss	tFlags,ONESEC	; is one-second flag bit set?
	goto	Ck10S		; nope.
	;; 1-second tick active.
	decfsz	ptchTmr,w	; quick-n-dirty test for 1.
	goto	NoP1Tmr		; was not 1.
	;; 10 or less seconds remain for patch.	 notify.
	PAGE3			; select code page 3.
	movlw	PATCBIP		; offset of patch bip in ROM table.
	call	PlayCTx		; play ct from table
	PAGE0			; select code page 0.
NoP1Tmr				; not 10 or less seconds less on patch.
	movf	unlkTmr,f	; check unlkTmr
	btfsc	STATUS,Z	; is it zero?
	goto	NoULTmr		; yes, don't worry about it.
	decfsz	unlkTmr,f	; no, decrement it.
	goto	NoULTmr		; still not zero.
	;; unlkTmr counted down to zero, lock controller.
	movlw	b'00011111'	; mask:	 clear unlocked bits.
	andwf	dtRFlag,f	; and with dtRFlag: clear unlocked bits.
	movlw	VCONTRL		; word "control"
	PAGE3			; select code page 3.
	call	PutWord		; put word into buffer
	movlw	VACCESS		; word "access"
	call	PutWord		; put word into buffer
	movlw	VDISABL		; word "disabled".
	call	PutWord		; put word into buffer.
	bsf	outPort,BEEPAUD ; turn on audio gate
	call	SetPort		; set the port.
	call	PTTon		; turn on tx if not on already.
	call	PlaySpc		; play the speech message.
	PAGE0			; select code page 0.

NoULTmr				; unlocked timer is zero.
	
Ck10S				; check 10-second tick flag bit.
	btfss	tFlags,TENSEC	; is ten-second flag bit set?
	goto	NoTimr		; nope.	 no more timers to test.
	movf	idTmr,f
	btfsc	STATUS,Z	; is idTmr 0
	goto	NoIDTmr		; yes...
	decfsz	idTmr,f		; decrement ID timer
	goto	NoIDTmr		; not zero yet...
	btfss	flags,needID	; is an id needed?
	goto	NeedNoId	; nope.	 Id timer ran out, no ID needed.
	call	DoID		; id timer decremented to zero, play the ID
	goto	NoIDTmr
NeedNoId
	bsf	flags,initID	; the repeater is idle, set the initial ID flag
	
NoIDTmr				; process more 10 second timers here...
	movf	ptchTmr,f	; check patch timer.
	btfsc	STATUS,Z	; is it zero?
	goto	NoPtTmr		; yes
	decfsz	ptchTmr,f	; decrement patch timer
	goto	NoPtTmr		; not zero yet.
	PAGE3			; select code page 1.
	call	FoneOff		; turn off patch!
	movlw	VCALL		; word "call".
	call	PutWord		; put word into buffer
	movlw	VCOMPLT		; word "complete".
	call	PutWord		; put word into buffer
	bsf	outPort,BEEPAUD ; turn on audio gate
	call	SetPort		; set output port so message is heard
	call	PlaySpc		; play the speech message.
	PAGE0			; select code page 0.
NoPtTmr 
	movf	fanTmr,f	; check fan timer
	btfsc	STATUS,Z	; is it zero?
	goto	NoFanTm		; yes.
	btfss	group3,4	; fan mode configured?
	goto	NoFanTm		; no
	decfsz	fanTmr,f	; decrement fan timer
	goto	NoFanTm		; not zero yet
	bcf	outPort,FANCTL	; turn off fan
NoFanTm
	movf	dtATmr,f	; check DTMF access timer.
	btfsc	STATUS,Z	; is it zero?
	goto	NoDTATm		; yes
	decfsz	dtATmr,f	; decrement DTMF access timer
	goto	NoDTATm		; not zero yet.
	;; dtmf access mode timer has counted down to 0.
	;; make sure remote base is diabled here.
	btfss	group0,5	; is DTMF access mode enabled?
	goto	NoDTATm		; DTMF access mode is not enabled.
	movlw	RXSOFF		; get new state #
	movwf	rx1Stat		; set new receiver state
	bcf	outPort,RX1AUD	; mute it...
	bcf	txFlag,RX1OPEN	; clear link receiver on bit
	clrf	rx1TOut		; clear link receiver timeout timer
	bcf	outPort,TX1PTT	; turn off link transmitter.
	;; v 1.14 change - turn off tune mode here
	clrf	tuneFlg		; turn off tune mode
	;; end v 1.14 change
		
	movlw	VREPEAT		; word "repeater".
	PAGE3			; select code page 3.
	call	PutWord		; put word into buffer
	movlw	VACCESS		; word "access".
	call	PutWord		; put word into buffer
	movlw	VDISABL		; word "disabled".
	call	PutWord		; put word into buffer
	bsf	outPort,BEEPAUD ; turn on audio gate
	call	SetPort		; set output port so message is heard
	call	PlaySpc		; play the speech message.
	PAGE0			; select code page 0.
NoDTATm

	movf	rbTmr,f		; check remote-base activity timer.
	btfsc	STATUS,Z	; is it zero?
	goto	NoRBTmr		; yes
	decfsz	rbTmr,f		; decrement remote-base activity timer
	goto	NoRBTmr		; not zero yet.
	;; remote base auto-shutoff timer has timed out.
	PAGE1			; select code page 1.
	call	RBOff		; turn off remote base
	PAGE0			; select code page 0
NoRBTmr				; the remote base timer is not running.
		
NoTimr				; no more timers to test.
	

ChkTx				; check if transmitter should be on
	movf	txFlag,f	; check txFlag
	btfsc	STATUS,Z	; skip if not zero
	goto	ChkTx0		; it's zero, turn off transmitter
	btfsc	flags,TXONFLG	; skip if not already on
	goto	ChkTxE		; done here
	PAGE3			; select code page 1.
	call	PTTon		; turn on transmitter (will set TXONFLG)
	PAGE0			; select code page 0.
	goto	ChkTxE		; OK, done here.
ChkTx0
	btfss	flags,TXONFLG	; skip if tx is on
	goto	ChkTxE		; was already off
	PAGE3			; select code page 1.
	call	PTToff		; turn off PTT
	PAGE0			; select code page 0.
ChkTxE				; end of ChkTx

; ***************
; ** CW SENDER ** 
; ***************
CWSendr
	btfss	txFlag,CWPLAY	; sending CW?
	goto	NoCW		; nope

	btfss	tFlags,ONEMS	; is this a one-ms tick?
	goto	NoCW		; nope.

	decfsz	cwTbTmr,f	; decrement CW timebase counter
	goto	NoCW		; not zero yet.

	bsf	STATUS,RP0	; select register page 1
	movf	cwRate,w
	bcf	STATUS,RP0	; select register page 0
	movwf	cwTbTmr		; preset CW timebase.
	
	decfsz	cwTmr,f		; decrement CW element timer
	goto	NoCW		; not zero

	btfsc	cwByte,7	; is high bit set?
	goto	CWCmd		; yes. this is a command
	
	btfss	tFlags,CWBEEP	; was "key" down? 
	goto	CWKeyUp		; nope
				; key was down
	bcf	tFlags,CWBEEP	; key->up
	clrf	PORTD		; write quiet beep tone info to port
	bsf	PORTB,TONESEL	; set PDC3311 STROBE high
	nop			; short delay (PDC3311 requires 400 ns here)
	bcf	PORTB,TONESEL	; set PDC3311 STROBE low (should be 500 ns pulse)
	decf	cwByte,w	; test CW byte to see if 1
	btfsc	STATUS,Z	; was it 1 (Z set if cwByte == 1)
	goto	CWNext		; it was 1...
	movlw	CWIESP		; get cw inter-element space
	movwf	cwTmr		; preset cw timer
	goto	NoCW		; done with this pass...

CWNext				; get next character of message
	PAGE3			; select code page 1.
	call	GtBeep		; get the next cw character
	PAGE0			; select code page 0.
	movwf	cwByte		; store character bitmap
	btfsc	STATUS,Z	; is this a space (zero)
	goto	CWWord		; yes, it is 00
	btfss	cwByte,7	; is high bit set?
	goto	CWNoCmd		; nope.  not a command
CWCmd	
	btfsc	cwByte,6	; bit 6 set?
	goto	CWDone		; yes. end of message.
	btfss	cwByte,5	; bit 5 set indicates pitch command
	goto	CWSRate		; bit 5 clear -- this is a speed command
	
CWPitch				; 
	movf	cwByte,w	; get the cw Byte
	andlw	b'00011111'	; mask off the command bits - rate is left
	addlw	h'10'		; offset into the right part of tone table.
	PAGE3			; select code page 3
	call	GetTone		; get the pitch byte
	PAGE0			; select code page 0
	bsf	STATUS,RP0	; select register page 1
	movwf	cwTone		; save the tone code
	bcf	STATUS,RP0	; select register page 0
	goto	CWNext		; get the next CW byte
	
CWSRate				; set cw rate.
	movf	cwByte,w	; get the cw Byte
	andlw	b'00011111'	; mask off the command bits - rate is left
	PAGE3			; select code page 3
	call	GetCWD		; get the CW delay
	PAGE0			; select code page 0
	bsf	STATUS,RP0	; select register page 1
	movwf	cwRate		; save the rate
	bcf	STATUS,RP0	; select register page 0
	goto	CWNext		; get the next CW byte

CWNoCmd	
	movlw	CWILSP		; no, not 00 or FF, inter letter space
	movwf	cwTmr		; preset cw timer
	goto	NoCW		; done with this pass...

CWWord				; word space
	movlw	CWIWSP		; get word space
	movwf	cwTmr		; preset cw timer
	goto	NoCW		; done with this pass...

CWKeyUp				; key was up, key again...
	incf	cwByte,w	; is cwByte == ff?
	btfsc	STATUS,Z	; Z is set if cwByte == ff
	goto	CWDone		; got EOM

	movf	cwByte,f	; check for zero/word space
	btfss	STATUS,Z	; is it zero
	goto	CWTest		; no...
	goto	CWNext		; is 00, word space...

CWTest
	movlw	CWDIT		; get dit length
	btfsc	cwByte,0	; check low bit
	movlw	CWDAH		; get DAH length
	movwf	cwTmr		; preset cw timer
	bsf	tFlags,CWBEEP	; turn key->down
	bsf	STATUS,RP0	; select register page 1
	movf	cwTone,w	; get CW tone
	bcf	STATUS,RP0	; select register page 0
	movwf	PORTD		; write beep tone info to port
	bsf	PORTB,TONESEL	; set PDC3311 STROBE high
	nop			; short delay (PDC3311 requires 400 ns here)
	bcf	PORTB,TONESEL	; set PDC3311 STROBE low (will be 500 ns pulse)
	rrf	cwByte,f	; rotate cw bitmap
	bcf	cwByte,7	; clear the MSB
	goto	NoCW		; done with this pass...

CWDone				; done sending CW
	bcf	txFlag,CWPLAY	; turn off CW flag
	btfss	beepCtl,B_MAIN	; did beep turn on audio gate?
	goto	CWDone1		; no.
	btfss	txFlag,TALKING	; don't turn off audio gate if talking.
	bcf	outPort,BEEPAUD ; turn off audio gate
CWDone1
	clrf	beepCtl		; clear beep control flags

NoCW
CasEnd
CkTone
	btfss	tFlags,HUNDMS	; check the DTMF timers every 100 msec.
	goto	TonDone		; not 100 MS tick.
CkDt0	
	movf	dt0Tmr,f	; check for zero...
	btfsc	STATUS,Z	; is it zero
	goto	CkDt1		; yes
	decfsz	dt0Tmr,f	; decrement timer
	goto	CkDt1		; not zero yet
	bsf	dtRFlag,DT0RDY	; ready to evaluate command.
CkDt1
	movf	dt1Tmr,f	; check for zero...
	btfsc	STATUS,Z	; is it zero
	goto	CkDt2		; yes
	decfsz	dt1Tmr,f	; decrement timer
	goto	CkDt2		; not zero yet
	bsf	dtRFlag,DT1RDY	; ready to evaluate command.
CkDt2
	movf	dt2Tmr,f	; check for zero...
	btfsc	STATUS,Z	; is it zero
	goto	TonDone		; yes
	decfsz	dt2Tmr,f	; decrement timer
	goto	TonDone		; not zero yet
	bsf	dtRFlag,DT2RDY	; ready to evaluate command.
TonDone
	;; manage beep timer 
	btfss	tFlags,TENMS	; is this a 10 ms tick?
	goto	NoTime		; nope.
	movf	beepTmr,f	; check beep timer
	btfsc	STATUS,Z	; is it zero?
	goto	NBeep		; yes.
BeepTic				; a valid beep tick.
	decfsz	beepTmr,f	; decrement beepTmr
	goto	NoTime		; not zero yet.
	PAGE3			; select code page 3.
	call	GetBeep		; get the next beep tone...
	PAGE0			; select code page 0.
	goto	NoTime		; done here.
NBeep				; verify that beeping is really over. HACK.
	movf	cwTmr,f		; check cwTmr.
	btfss	STATUS,Z	; is it zero?
	goto	NoTime		; no.
	movf	beepCtl,f	; check this.
	btfsc	STATUS,Z	; is it zero?
	goto	NoTime		; yes.
	PAGE3			; select code page 3.
	call	GetBeep		; get the next beep tone...
	PAGE0			; select code page 0.

NoTime
	movf	tFlags,f	; evaluate tFlags
	btfss	STATUS,Z	; skip if ZERO
	goto	LoopEnd
	;; no timing flags were set...
	;; likely some excess, available CPU cycles here.
	;; evaluate DTMF buffers...
PfxDT0
	;; evaluate DTMF 0 buffer for command
	btfsc	dtRFlag,DTSEVAL ; is a command being interpreted now?
	goto	DTEval		; yes, don't bother looking at the DTMF buffers right now
	btfss	dtRFlag,DT0RDY	; is a command ready to evaluate?
	goto	PfxDT1		; no command waiting.
	;; copy command from dtmf rx buf to command interpreter input buffer.
	movlw	low dt0buf0	; get address of this dtmf receiver's buffer
	movwf	FSR		; store.
	movf	dt0Ptr,w	; get command size...
	movwf	cmdSize		; save it.
	PAGE1			; select code page 1.
	call	CpyDTMF		; copy the command...
	PAGE0			; select code page 0.
	movf	dt0Ptr,w	; get command size back, CpyDTMF clobbers.
	movwf	cmdSize		; save it.
	clrf	dt0Ptr		; make ready to receive again.
	clrf	dtEFlag		; start evaluating from first prefix.
	bsf	dtEFlag,DT0CMD	; command from DTMF-0.
	bsf	dtRFlag,DTSEVAL ; set evaluate DTMF bit.
	btfsc	dtRFlag,DT0UNLK ; port 0 unlocked?
	bsf	dtRFlag,DTUL	; this port is unlocked.
	btfsc	tuneFlg,DT0TUNE ; is this port in tune mode?
	bsf	tuneFlg,DTTUNE	; set tune bit.
	bcf	dtRFlag,DT0RDY	; reset DTMF ready bit.
	bsf	outPort,BEEPAUD ; got cmd from main rx -- turn on audio gate
	goto	DTEval		; go and evaluate the command right now.

PfxDT1
	;; evaluate DTMF command from decoder 1 here.
	btfss	dtRFlag,DT1RDY	; is a command ready to evaluate?
	goto	PfxDT2		; no command waiting.
	;; copy command from dtmf rx buf to command interpreter input buffer.
	movlw	low dt1buf0	; get address of this dtmf receiver's buffer
	movwf	FSR		; store.
	movf	dt1Ptr,w	; get command size...
	movwf	cmdSize		; save it.
	PAGE1			; select code page 1.
	call	CpyDTMF		; copy the command...
	PAGE0			; select code page 0.
	movf	dt1Ptr,w	; get command size back, CpyDTMF clobbers.
	movwf	cmdSize		; save it.
	clrf	dt1Ptr		; make ready to receive again.
	clrf	dtEFlag		; start evaluating from first prefix.
	bsf	dtEFlag,DT1CMD	; command from DTMF-1.
	bsf	dtRFlag,DTSEVAL ; set evaluate DTMF bit.
	btfsc	dtRFlag,DT1UNLK ; port 1 unlocked?
	bsf	dtRFlag,DTUL	; this port is unlocked.
	btfsc	tuneFlg,DT1TUNE ; is this port in tune mode?
	bsf	tuneFlg,DTTUNE	; set tune bit.
	bcf	dtRFlag,DT1RDY	; reset DTMF ready bit.
	goto	DTEval		; go and evaluate the command right now.

PfxDT2
	;; evaluate DTMF command from decoder 1 here.
	btfss	dtRFlag,DT2RDY	; is a command ready to evaluate?
	goto	XPfxDT		; no command waiting.
	;; copy command from dtmf rx buf to command interpreter input buffer.
	movlw	low dt2buf0	; get address of this dtmf receiver's buffer
	movwf	FSR		; store.
	movf	dt2Ptr,w	; get command size...
	movwf	cmdSize		; save it.
	PAGE1			; select code page 1.
	call	CpyDTMF		; copy the command...
	PAGE0			; select code page 0.
	movf	dt2Ptr,w	; get command size back, CpyDTMF clobbers.
	movwf	cmdSize		; save it.
	clrf	dt2Ptr		; make ready to receive again.
	clrf	dtEFlag		; start evaluating from first prefix.
	bsf	dtEFlag,DT2CMD	; command from DTMF-2.
	bsf	dtRFlag,DTSEVAL ; set evaluate DTMF bit.
	btfsc	dtRFlag,DT2UNLK ; port 2 unlocked?
	bsf	dtRFlag,DTUL	; this port is unlocked.
	btfsc	tuneFlg,DT2TUNE ; is this port in tune mode?
	bsf	tuneFlg,DTTUNE	; set tune bit.
	bcf	dtRFlag,DT2RDY	; reset DTMF ready bit.
	bsf	outPort,BEEPAUD ; got cmd from ctl/link rx--turn on audio gate.
	goto	DTEval		; go and evaluate the command right now.

XPfxDT
	goto	LoopEnd
	
DTEval				; evaluate DTMF command in command buffer
	btfsc	tuneFlg,DTTUNE	; is this command from a port in tune mode?
	goto	DTEvalT		; yep.
	
	btfsc	dtRFlag,DTUL	; is this command from an unlocked port?
	goto	DTEvalU		; yep.

	;; evaluate the command in the buffer against the contents of eeprom.
	movlw	low cmdbf00	; get command buffer address
	movwf	FSR		; set pointer
	movf	dtEFlag,w	; get dtEFlag.
	andlw	b'00011111'	; mask out control bits.
	movwf	temp		; set prefix index.
	movlw	EEPFL		; max number of digits in prefix.
	movwf	temp2		; save max number of digits to look at.
	clrf	eeAddrH		; clear EEPROM address hi byte.
	movf	temp,w		; get prefix index.
	movwf	eeAddrL		; set EEPROM address low byte
	bcf	STATUS,C	; clear carry bit
	rlf	eeAddrL,f	; rotate (x2)
	rlf	eeAddrL,f	; rotate (x4 this time)
	rlf	eeAddrL,f	; rotate (x8 now)
	movlw	EEPFB		; get EEPROM base address for prefix 0
	addwf	eeAddrL,f	; add to offset.
	;; now have address of base of selected prefix.
DTEval1
	PAGE3			; select code page 3.
	call	ReadEEw		; read EEPROM.
	PAGE0			; select code page 0.
	movwf	temp3		; save retrieved byte
	sublw	h'ff'		; subtract FF.
	btfsc	STATUS,Z	; skip if temp3 was NOT FF.
	goto	DTEvalY		; value was FF, end of valid prefix. process.
	movf	temp3,w		; get back real value for retrieved byte.
	subwf	INDF,w		; subtract bytes.
	btfss	STATUS,Z	; skip if they were the same.
	goto	DTEvalN		; them bytes were not equal.
	decfsz	temp2,f		; decrease number of bytes to scan
	goto	DTEnext		; go evaluate next byte.
	goto	DTEvalN		; go on to next prefix.
DTEnext				; evaluate next byte.
	incf	eeAddrL,f	; move to the next EEPROM byte.
	incf	FSR,f		; move to the next cmdbuf byte.
	goto	DTEval1		; look at the next prefix
	
DTEvalN				; was not this prefix.
	incf	dtEFlag,f	; move to next prefix
	movf	dtEFlag,w	; get dtEFlag.
	andlw	b'00011111'	; mask out control bits.
	sublw	EEPFC		; subtract number of last prefix.
	btfsc	STATUS,Z	; is result 0? (all prefixes checked)
	goto	DTEdone		; it's zero, done evaluating.
	goto	LoopEnd		; continue.

DTEvalY				; HEY! it is this prefix!
	;; temp has the prefix number.
	;; EEPFL - temp2 is the index of the first byte after the prefix.
	movf	temp2,w		; get temp2 value.
	sublw	EEPFL		; w = EEPFL - w
	subwf	cmdSize,f	; get corrected cmdSize
	;; cmdSize has the number of bytes left in the command.
	PAGE1			; select code page 1.
	call	LCmd		; process the locked command
	PAGE0			; select code page 0.
	goto	DTEdone		; done evaluating.
	
DTEvalU				; evaluate unlocked DTMF command.
	PAGE2			; select code page 2.
	call	UlCmd		; evaluate the unlocked command.
	PAGE0			; select code page 0.
	goto	DTEdone		; done evaluating.

DTEvalT				; evaluate unlocked DTMF command.
	PAGE2			; select code page 2.
	call	TuneCmd		; evaluate the fine-tune command.
	movlw	CTTUNE		; get tune courtesy tone.
	movwf	cTone		; set courtesy tone.
	PAGE0			; select code page 0.

DTEdone				; done evaluating DTMF commands.
	clrf	dtEFlag		; yes.	reset evaluate DTMF flags.
	bcf	dtRFlag,DTSEVAL ; done evaluating.
	bcf	dtRFlag,DTUL	; so we don't care about unlocked anymore.
	bcf	tuneFlg,DTTUNE	; clear the tune mode flag.
	
LoopEnd
	;; always update the output latch here.
	;; maybe add logic later to only update it when different.

	btfss	mscFlag,CIV_RDY ; is there a CI-V message waiting?
	goto	FanCtl		; nope.
	PAGE3			; select ROM code page 2.
	call	ChkCIV		; yep.
	PAGE0			; select ROM code page 0.

FanCtl
	;; fan/control output control.
	btfsc	group3,4	; is fan control enabled?
	goto	LoopE1		; yes.
	btfsc	group3,5	; is digital output on?
	bsf	outPort,FANCTL	; yes, turn on control output.
	btfss	group3,5	; is digital output off?
	bcf	outPort,FANCTL	; yes, turn off control output.
LoopE1	
	;; end of loop here.
	;; always update the output latch here.
	movf	outPort,w	; get outport value
	movwf	PORTD		; copy to port
	bsf	PORTC,OUTSEL	; raise output port enable
	nop			; short delay
	bcf	PORTC,OUTSEL	; lower output port enable
	movf	group7,w	; get digital output value
	btfsc	group8,5	; is debug mode turned on?
	movf	txFlag,w	; yes. copy txFlag to output LEDs
	movwf	PORTD		; copy to port
	bsf	PORTA,EXPSEL	; raise digital output port enable
	nop			; short delay
	bcf	PORTA,EXPSEL	; lower digital output port enable
	goto	Loop0
		      
; ************************************************************************
; ****************************** ROM PAGE 1 ******************************
; ************************************************************************
	org	0800		; page 1

LCmd
	btfss	group0,5	; is DTMF access mode enabled?
	goto	LCmdS		; no,  process command.
	movf	temp,w		; get prefix index number.
	sublw	d'6'		; subtract DTMF access prefix.
	btfsc	STATUS,Z	; is it the DTMF access prefix?
	goto	LCmdS		; yes.  process command.
	movf	dtATmr,f	; get the DTMF access mode timer.
	btfsc	STATUS,Z	; is it zero?
	return			; yes. do nothing quietly.
	
LCmdS
	movlw	high LTable	; set high byte of address
	movwf	PCLATH		; select page
	movf	temp,w		; get prefix index number.
	andlw	h'0f'		; restrict to reasonable range
	addwf	PCL,f		; add w to PCL

LTable				; jump table for locked commands.
	goto	LCmd0		; prefix 00 -- control operator
	goto	LCmd1		; prefix 01 -- autopatch
	goto	LCmd2		; prefix 02 -- unresricted autopatch
	goto	LCmd3		; prefix 03 -- autodial
	goto	LCmd4		; prefix 04 -- emergency autodial
	goto	LCmd5		; prefix 05 -- patch hang up code
	goto	LCmd6		; prefix 06 -- dtmf access
	goto	LCmd7		; prefix 07 -- pass dtmf
	goto	LCmd8		; prefix 08 -- dtmf test
	goto	LCmd9		; prefix 09 -- reverse patch
	goto	LCmdA		; prefix 10 -- audio check
	goto	LCmdB		; prefix 11 -- mailbox & audio check
	goto	LCmdC		; prefix 12 -- remote base
	goto	LCmdD		; prefix 13 -- (reserved)
	goto	LCmdE		; prefix 14 -- load saved state.
	goto	LCmdF		; prefix 15 -- unlock controller.

; ***********
; ** LCmd0 **
; ***********
LCmd0				; control operator switches
	btfss	group0,7	; CTCSS required?
	goto	LCmd0x		; no.
	btfss	dtEFlag,DT0CMD	; did the command come from the main receiver?
	goto	LCmd0c1		; no.
	btfss	mscFlag,CTCSS0	; was CTCSS on?
	return			; do nothing quietly.

LCmd0c1 
	btfss	dtEFlag,DT2CMD	; did the command come from the control RX?
	goto	LCmd0x		; no. must be the phone. process it.
	btfss	group1,7	; is the control receiver on the link port?
	goto	LCmd0x		; no, process it.
	btfss	mscFlag,CTCSS2	; was CTCSS on?
	return			; do nothing quietly.
LCmd0x				; actually do it.
	movlw	d'2'		; minimum command length
	subwf	cmdSize,w	; w = cmdSize - w
	btfss	STATUS,C	; skip if result is non-negative (cmdsize >= 2)
	return			; not enough command digits. fail quietly.
	movf	cmdSize,w	; get command size
	sublw	d'3'		; get max command length
	btfss	STATUS,C	; skip if result is non-negative (cmdSize <= 3)
	return			; too many command digits. Fail quietly.

	movf	INDF,w		; get Group byte
	movwf	temp2		; save group byte.
	sublw	d'7'		; w = 7-w.
	btfss	STATUS,C	; skip if w is not negative
	return			; bad, bad user tried to enter invalid group.
	;; check access to change that group.
	movf	temp2,w		; get group number 0-7.
	PAGE3
	call	GetMask		; get bitmask for that group.
	PAGE1
	;; now have bit representing group number in w.
	andwf	group9,w	; and with enabled groups mask.
	btfsc	STATUS,Z	; zero if group is disabled.
	return			; quietly do nothing.
	incf	FSR,f		; move to next byte (bit #)
	decf	cmdSize,f	; decrement command size.
	movf	INDF,w		; get Item byte (bit #)
	movwf	temp		; save it.
	incf	FSR,f		; move to next byte (state)
	decf	cmdSize,f	; decrement command size.

	sublw	d'7'		; w = 7-w.
	btfss	STATUS,C	; skip if w is not negative
	return			; bad, bad user tried to enter invalid item.
	PAGE2			; select code page 2.
	goto	CtlOpC		; execute control op command

; ***********
; ** LCmd1 **
; ***********
LCmd1				; autopatch
	btfss	group4,0	; is autopatch enabled?
	return			; no.  quietly do nothing.
	btfss	group1,5	; CTCSS required?
	goto	LCmd1x		; no.
	btfss	dtEFlag,DT0CMD	; did the command come from the main receiver?
	goto	LCmd1c1		; no.
	btfss	mscFlag,CTCSS0	; was CTCSS on?
	return			; do nothing quietly.
LCmd1c1 
	btfss	dtEFlag,DT2CMD	; did the command come from the control RX?
	goto	LCmd1x		; no. must be the phone. process it.
	btfss	group1,7	; is the control receiver on the link port?
	goto	LCmd1x		; no, process it.
	btfss	mscFlag,CTCSS2	; was CTCSS on?
	return			; do nothing quietly.
LCmd1x
	movf	cmdSize,f	; get command size.
	btfss	STATUS,Z	; is it zero?
	goto	LCmd1z		; no.
	;; zero, extend patch timer.
	btfss	txFlag,PATCHON	; is patch active?
	return			; no.  quietly do nothing.
	clrf	eeAddrH		; clear EEPROM high address byte.
	movlw	EETPAT		; get EEPROM address of patch timer preset.
	movwf	eeAddrL		; set EEPROM address low byte.
	PAGE3			; select code page 3.
	call	ReadEEw		; read EEPROM.
	PAGE1			; select code page 1.
	movwf	ptchTmr		; set autopatch timer.
	return			; done.
	
LCmd1z	
	movf	FSR,w		; get pointer to digits to send.
	movwf	temp4		; save FSR for later.
	movf	cmdSize,w	; get command size...
	sublw	d'7'		; subtract from 7.
	btfsc	STATUS,Z	; is result 0?
	goto	LCmd17		; 7 digit dialing
	movf	cmdSize,w	; get command size...
	sublw	d'8'		; subtract from 8.
	btfsc	STATUS,Z	; is result 0?
	goto	LCmd18		; 8 digit dialing ("1" + 7 digits)
	movf	cmdSize,w	; get command size...
	sublw	d'10'		; subtract from 10.
	btfsc	STATUS,Z	; is result 0?
	goto	LCmd1A		; 10 digit dialing (area code + 7 digits)
	movf	cmdSize,w	; get command size...
	sublw	d'11'		; subtract from 11.
	btfsc	STATUS,Z	; is result 0?
	goto	LCmd1B		; 11 digit dialing (1 + area code + 7 digits)
	return			; not 7, 8, 10, or 11; quietly do nothing.

LCmd17				; 7 digit phone number entered.
	movlw	high EEACSFL	; get address of last AC flags.
	movwf	eeAddrH		; save EEPROM address hi byte base.
	movlw	low EEACSFL	; get address of last AC flags.
	movwf	eeAddrL		; save EEPROM address low byte base.
	PAGE3			; select code page 3.
	call	ReadEEw		; read EEPROM.
	PAGE1			; select code page 1.
	movwf	temp6		; save configuration byte.
	btfss	temp6,ACENAB	; is this area code enabled?
	goto	LCmd1Bad	; nope.
	btfss	temp6,ACNONE	; is area code not specified?
	goto	LCmd1Bad	; nope.
	btfsc	temp6,AC1REQ	; is one NOT required?
	goto	LCmd1Bad	; nope.
	goto	LCmd18a		; yes.	continue.
	
LCmd18				; 8 digit phone number entered.
	movlw	high EEACSFL	; get address of last AC flags.
	movwf	eeAddrH		; save EEPROM address hi byte base.
	movlw	low EEACSFL	; get address of last AC flags.
	movwf	eeAddrL		; save EEPROM address low byte base.
	PAGE3			; select code page 3.
	call	ReadEEw		; read EEPROM.
	PAGE1			; select code page 1.
	movwf	temp6		; save configuration byte.
	btfss	temp6,ACENAB	; is this area code enabled?
	goto	LCmd1Bad	; nope.
	btfss	temp6,ACNONE	; is area code not specified?
	goto	LCmd1Bad	; nope.
	btfss	temp6,AC1OK	; is one allowed?
	goto	LCmd1Bad	; nope.
	movf	INDF,w		; get 1st digit.
	sublw	d'1'		; subtract from 1.
	btfss	STATUS,Z	; was result 0?
	goto	LCmd1Bad	; nope.
	incf	FSR,f		; move past digit 1.
LCmd18a
	movlw	EELSTAC		; get last area code number
	movwf	temp		; ChkNNX wants the area code index in temp.
	PAGE3			; select code page 3.
	call	ChkNNX		; check NNX.
	PAGE1			; select code page 1.
	btfsc	STATUS,Z	; valid NNX?
	goto	LCmd1Bad	; nope.
	btfss	temp6,ACPFX	; is prefix required?
	goto	LCmd1NP		; make the call, no prefix...
	
	movlw	high EEACSPF	; get address of special area code prefix
	movwf	eeAddrH		; save EEPROM address hi byte base.
	movlw	low EEACSPF	; get address of special area code prefix
	movwf	eeAddrL		; save EEPROM address low byte base.
	goto	LCmd1DP		; dial with prefix.
	
LCmd1A				; 10 digit phone number entered.
	PAGE3			; select code page 3.
	call	GetAC		; get area code.
	PAGE1			; select code page 1.
	movwf	temp		; save index.  will be mashed by ChkNNX.
	movwf	temp5		; save index again.
	andlw	EEACMSK		; mask of invalid bits.
	btfss	STATUS,Z	; is result zero?
	goto	LCmd1Bad	; yes, invalid area code...
	movf	temp,w		; get back area code index.

	PAGE3			; select code page 3.
	call	ChkNNX		; check NNX.
	PAGE1			; select code page 1.
	btfsc	STATUS,Z	; valid NNX?
	goto	LCmd1Bad	; nope.
	
	clrf	eeAddrL		; clear EEPROM address lo byte.
	movf	temp5,w		; get temp5 (AC index)
	movwf	eeAddrH		; save EEPROM address hi byte base.
	rrf	eeAddrH,f	; rotate right
	btfsc	STATUS,C	; was the low bit set?
	bsf	eeAddrL,7	; yep.  add 0x80 to low byte of EEPROM addr.
	movlw	high EEAC00	; get high byte of EEPROM address.
	addwf	eeAddrH,f	; add to hi byte of EEPROM address.
	;; now have eeprom base address for area code of index temp5.
	;; get the flags to see if this area code is enabled.
	movlw	EEAFOFF		; get area code flags offset.
	addwf	eeAddrL,f	; add to eeprom address.
	PAGE3			; select code page 3.
	call	ReadEEw		; read the area code config bits.
	PAGE1			; select code page 1.
	movwf	temp6		; save area code config bits in temp.

	btfsc	temp6,AC1REQ	; is a leading 1 was required? (didn't get it.)
	goto	LCmd1Bad	; error.  did not get leading 1.
	
	btfss	temp6,ACPFX	; is prefix required?
	goto	LCmd1NP		; make the call, no prefix...
	incf	eeAddrL,f	; get address of prefix, it's after flags.
	goto	LCmd1DP		; make the call, with the prefix.
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
