nhrc-net/NHRC_Repeater_Controllers/nhrc-17/sw/nhrc-17.asm

        ;; NHRC-17 Interoperability Controller.
        ;; Copyright 2011, 2012 NHRC LLC as an unpublished proprietary work.
        ;; All rights reserved.
        ;; No part of this document may be used or reproduced by any means,
        ;; for any purpose, without the expressed written consent of NHRC LLC.

        ;; v 0.01 10 December 2011 -- initial
        ;; v 0.02 02 January  2012 -- 3 ms CTSEL debounce for auto state change
        ;;                         -- command prefix max length now 8 (was 7)
        ;;                         -- DTMF eval can be disabled for each RX
        ;; v 0.03 08 January  2012 -- fix missing CT for RX2->TX1
        ;;                            fix *71 test courtesy tone works on RX
        ;;                            turned off CT for factor states 0,1
        ;; v 0.04 28 February 2012 -- now running on real hardware.
        ;; v 0.05 03 March    2012 -- fixed default IDs to be NHRC17
        ;; v 0.06 26 January  2016 -- fix obscure unmute bug on port 3
        
VER_INT equ     d'0'            ; remember to change CW version, too.
VER_HI  equ     d'0'            ; search for "VERSION DATA" in the source.
VER_LO  equ     d'6'

LOAD_EE=1
xxSIMULATOR=1
        
        ERRORLEVEL 0, -302,-306 ; suppress Argument out of range errors

        IFDEF __16F887
        include "p16f887.inc"
        ENDIF
        
        IFDEF __DEBUG
        __CONFIG _CONFIG1, _HS_OSC & _LVP_OFF & _WDT_OFF & _IESO_OFF
        ELSE
        ;;  NOT a DEBUG build
        __CONFIG _CONFIG1, _PWRTE_ON & _HS_OSC & _LVP_OFF & _CP_ON
        ENDIF                   ; __DEBUG

        include "eeprom.inc"

;macro definitions for ROM paging.
        
PAGE0   macro                   ; select page 0
        bcf     PCLATH,3
        bcf     PCLATH,4
        endm

PAGE1   macro                   ; select page 1
        bsf     PCLATH,3
        bcf     PCLATH,4
        endm

PAGE2   macro                   ; select page 2
        bcf     PCLATH,3
        bsf     PCLATH,4
        endm

PAGE3   macro                   ; select page 3
        bsf     PCLATH,3
        bsf     PCLATH,4
        endm

        IFDEF SIMULATOR
TEN     equ     D'5'            ; faster than speeding decade counters.
        ELSE
TEN     equ     D'10'           ; decade counter.
        ENDIF

; *************************
; ** IO Port Assignments **
; *************************

; PORTA
DTMFQ1  equ     0               ; input, DTMF decoder Q1
DTMFQ2  equ     1               ; input, DTMF decoder Q2
DTMFQ3  equ     2               ; input, DTMF decoder Q3
DTMFQ4  equ     3               ; input, DTMF decoder Q4
INIT    equ     4               ; input, initialize jumper.
FANCTL  equ     5               ; output, fan control/digital output.

; PORTB
DTMF1OE equ     0               ; output, DTMF 1 output enable.
DTMF2OE equ     1               ; output, DTMF 2 output enable.
TX1PTT  equ     2               ; output, TX1 PTT when high.
TX2PTT  equ     3               ; output, TX2 PTT when high.
RX11AUD equ     4               ; output, audio 1->1 mute, muted when low.
RX21AUD equ     5               ; output, audio 2->1 mute, muted when low.
RX12AUD equ     6               ; output, audio 1->2 mute, muted when low.
RX22AUD equ     7               ; output, audio 2->2 mute, muted when low.
        
; PORTC
BEEP1   equ     0               ; PWM output, beep tone source.
BEEP2   equ     1               ; PWM output, beep tone source.
DTMF1DV equ     2               ; input, DTMF digit valid decoder 1 when high.
DTMF2DV equ     3               ; input, DTMF digit valid decoder 2 when high.
RX2PL   equ     4               ; input, RX2 CTCSS present when low.
RX2COR  equ     5               ; input, RX2 COR present when low.

; PORTD
EXP1    equ     0               ; expand 1 input
ALARM   equ     0               ; ALARM\ input
EXP2    equ     1               ; expand 2 input
CT4SEL  equ     1               ; CT4 SEL\ input
EXP3    equ     2               ; expand 3 input
CT5SEL  equ     2               ; CT5 SEL \ input
EXP4    equ     3               ; expand 4 input
CT6SEL  equ     3               ; CT6 SEL \ input
EXP5    equ     4               ; expand 5 output
TX1ENC  equ     4               ; TX1 Encoder output
EXP6    equ     5               ; expand 6 output
TX2ENC  equ     5               ; TX2 Encoder output
EXP7    equ     6               ; expand 7 output
EXP8    equ     7               ; expand 8 output

; PORTE
RX1COR  equ     0               ; input, RX1 COR present when low.
RX1PL   equ     1               ; input, RX1 CTCSS present when low.
RE2     equ     2               ; spare.
; *******************
; ** Control Flags **
; *******************
        
;tFlags                         ; timer flags        
TICK    equ     0               ; TICK indicator
ONEMS   equ     1               ; 1 ms tick flag
TENMS   equ     2               ; 10 ms tick flag
HUNDMS  equ     3               ; 100 ms tick flag
ONESEC  equ     4               ; 1 second tick flag
TENSEC  equ     5               ; 10 second flag...
; niy   equ     6               ; NIY
; niy   equ     7               ; NIY

; rx1flag, rx2flag, rx3flag
DTMF0   equ     0               ; DTMF decoder last received a zero
LASTDV  equ     1               ; last digit valid indicator
;CTCSS  equ     2               ; last CTCSS flag.
        
; tx1flag, tx2flag
RX1TX   equ     0               ; receiver 0 is being transmitted
RX2TX   equ     1               ; receiver 1 is being transmitted
HANG    equ     2               ; hang time
BEEPING equ     3               ; CT beep is active
CWPLAY  equ     4               ; CW playback active
CTDELAY equ     5               ; CT delay, leave tx on.
;NIY    equ     6               ; 
;NIY    equ     7               ; 

; tx1flg2, tx2flg2
NEEDID  equ     0               ; need to send ID
INITID  equ     1               ; need to send initial id.
TXONFLG equ     2               ; last TX state flag
DEF_CT  equ     3               ; deferred courtesy tone.
;; NIY  equ     4               ; 
CWBEEP  equ     5               ; cw beep is on.
;; NIY  equ     6               ; 
;; NIY  equ     7               ; 

;; COR debounce time
COR1DEB equ     5               ; 5 ms.  COR off to on debounce time
COR0DEB equ     5               ; 5 ms.  COR on to off debounce time
DLY1DEB equ     d'100'          ; 100 ms. COR off->on debounce time, with DAD.
DLY0DEB equ     d'50'           ; 50 ms.  COR on->off debounce time, with DAD.
CHNKDEB equ     d'250'          ; 250 ms.
        
IDSOON  equ     D'6'            ; ID soon, polite IDer threshold, 60 sec
MUTEDLY equ     D'20'           ; DTMF muting timer = 2.0 sec.
DTMFDLY equ     d'20'           ; DTMF activity timer = 2.0 sec.
UNLKDLY equ     d'120'          ; unlocked mode timer.
        
; dtRFlag -- DTMF sequence received indicator
DT1RDY  equ     0               ; some sequence received on DTMF-1
DT2RDY  equ     1               ; some sequence received on DTMF-2
;niy    equ     2               ; 
DTUL    equ     3               ; command received from unlocked port.
DTSEVAL equ     4               ; DTMF command evaluation in progress.
DT1UNLK equ     5               ; unlocked indicator, port 1
DT2UNLK equ     6               ; unlocked indicator, port 2
;niy    equ     7               ;
                ;; 
;dtEFlag -- DTMF command evaluator control flag.
        ;; low order 5 bits indicate next prefix number/user command to scan
DT1CMD  equ     5               ; received this command from DTMF-1
DT2CMD  equ     6               ; received this command from DTMF-2
;niy     equ     7               ; 

; beep1ctl -- beeper control flags...
B_ADR0  equ     0               ; beep or CW addressing mode indicator
B_ADR1  equ     1               ; beep or CW addressing mode indicator
                                ;   00 EEPROM
                                ;   01 lookup table index, built in messages.
                                ;   10 from RAM
                                ;   11 CW single letter mode
                                ; 
B_BEEP  equ     2               ; beep sequence in progress
B_CW    equ     3               ; CW transmission in progress
;       equ     4               ;
;       equ     5               ;
B_LAST  equ     6               ; last segment of CT tones.

; beep1ctl preset masks
BEEP_CT equ     b'10000100'     ; CT from EEPROM
BEEP_CX equ     b'10000101'     ; CT from ROM table
CW_ROM  equ     b'10001001'     ; CW from ROM table
CW_EE   equ     b'10001000'     ; CW from EEPROM
CW_LETR equ     b'10001011'     ; CW ONE LETTER ONLY.

CTPAUSE equ     d'5'            ; 50 msec pause before CT.
MAGICCT equ     d'99'           ; magic CT length.  next digit is CW digit.
PULS_TM equ     d'50'           ; 50 x 10 ms = 500 ms.  pulse duration time.

; flags
RX1USQ  equ     0               ; receiver 1 unsquelched
RX1MUTD equ     1               ; receiver 1 muted
RX2USQ  equ     2               ; receiver 2 unsquelched
RX2MUTD equ     3               ; receiver 2 muted
;;      equ     4               ; not used
CMD_NIB equ     5               ; command interpreter nibble flag for copy
RX1NOCT equ     6               ; suppress CT on RX1
RX2NOCT equ     7               ; suppress CT on RX2

; serFlag -- serial IO control flags
SC_CMD  equ     5               ; have received command initiator
SC_ECHO equ     6               ; serial character ready to echo
SC_RDY  equ     7               ; serial command ready to process
        
; receiver states
RXSOFF  equ     0
RXSON   equ     1
RXSTMO  equ     2

; cTone Courtesy tone selections
CTNONE  equ     h'ff'           ; no courtesy tone.
CTRX11  equ     0               ; rx1 -> tx1 tone.
CTRX12  equ     1               ; rx1 -> tx2 tone.
CTRX21  equ     2               ; rx2 -> tx1 tone.
CTRX22  equ     3               ; rx2 -> tx2 tone.
CT4     equ     4               ; spare.
CT5     equ     5               ; spare.
CT6     equ     6               ; spare.
CTUNLOK equ     7               ; unlocked courtesy tone.

; CW Message Addressing Scheme:
; These symbols represent the value of the CW characters in the ROM table.
;     1 - CW timeout message, "to"
;     2 - CW confirm message, "ok"
;     3 - CW bad message, "ng"
;     3 - CW link timeout "rb to"

CW_OK   equ     h'00'           ; CW: OK
CW_NG   equ     h'03'           ; CW: NG
CW_TO1  equ     h'07'           ; CW: TO1
CW_TO2  equ     h'0b'           ; CW: TO2
CW_ON   equ     h'0f'           ; CW: ON
CW_OFF  equ     h'12'           ; CW: OFF
CW_N17  equ     h'16'           ; CW: NHRC 17 message.
BP_ALM  equ     h'24'           ; beep: alarm tone
        
;
; CW sender constants
;

CWDIT   equ     1               ; dit length in 100 ms
CWDAH   equ     CWDIT * 3       ; dah 
CWIESP  equ     CWDIT           ; inter-element space
CWILSP  equ     CWDAH           ; inter-letter space
CWIWSP  equ     CWDIT * 7       ; inter-word space

        IFDEF SIMULATOR
T0PRE   equ     D'127'          ; timer 0 preset for overflow in 127 counts, FAST.
        ELSE
T0PRE   equ     D'7'            ; timer 0 preset for overflow in 250 counts.
        ENDIF
        
; Alarm timer values
ALM_DBC equ     d'4'            ; alarm debounce counts.

CT_DBC  equ     d'3'            ; CT4/5/6 debounce counts. ms.
        
; chicken burst
CKNBRST equ     d'25'           ; 250 msec chicken burst.

;
; Serial control constants
;
SCATTN  equ     h'3a'           ; attention character, :
        
SCREAD  equ     h'52'           ; read command R
SCWRITE equ     h'57'           ; write command W
SCRESET equ     h'21'           ; reset command '!'
SCTERM  equ     h'0d'           ; command terminator <CR>
SCACK   equ     h'4b'           ; ACK message K
SCNAK   equ     h'4e'           ; NAK message N
SCCR    equ     h'0d'           ; CR
SCLF    equ     h'0a'           ; LF
        

; ***************
; ** VARIABLES **
; ***************
        cblock  h'20'           ; 1st block of RAM at 20h-7fh (96 bytes here)
        ;; port 1 receiver
        rx1flag                 ; 20 receiver 1 flags
        rx1stat                 ; 21 receiver 1 state
        rx1dbc                  ; 22 receiver 1 debounce timer
        rx1tout                 ; 23 receiver 1 timeout timer, in seconds
        mute1Tmr                ; 24 receiver 1 DTMF muting timer, in tenths.
        dt1atmr                 ; 25 receiver 1 DTMF access timer
        ;; port 1 transmitter
        tx1flag                 ; 26 Transmitter 1 control flag
        tx1flg2                 ; 27 Transmitter 1 control flag
        beep1tmr                ; 28 beeper 1 interval timer
        beep1ton                ; 29 beeper 1 tone
        beep1tnt                ; 2a beeper 1 tone timer
        beep1adr                ; 2b beeper 1 address for various beepings, low byte.
        beep1ctl                ; 2c beeper 1 control flag
        id1tmr                  ; 2d transmitter 1 id timer, in 10 seconds
        hang1tmr                ; 2e transmitter 1 hang timer, in tenths.
        tx1ctd                  ; 2f tx1 ct front porch delay
        cw1tmr                  ; 30 CW element timer
        cw1byte                 ; 31 CW current byte (bitmap)
        cw1tbtmr                ; 32 CW timebase timer
        cw1tone                 ; 33 CW tone 
        ct1tone                 ; 34 courtesy tone to play
        ulk1Tmr                 ; 35 unlocked mode timer.
        cb1Tmr                  ; 36 transmitter 1 chicken burst timer
        cw1spd                  ; 37 CW speed
        
        ;; port 2 receiver
        rx2flag                 ; 38 receiver 1 flags
        rx2stat                 ; 39 receiver 2 state
        rx2dbc                  ; 3a receiver 2 debounce timer
        rx2tout                 ; 3b receiver 2 timeout timer, in seconds
        mute2Tmr                ; 3c receiver 2 DTMF muting timer, in tenths.
        dt2atmr                 ; 3d receiver 2 DTMF access timer
        ;; port 2 transmitter
        tx2flag                 ; 3e transmitter 2 control flag
        tx2flg2                 ; 3f transmitter 2 control flag
        beep2tmr                ; 40 beeper 2 timer
        beep2ton                ; 41 beeper 2 tone 
        beep2tnt                ; 42 beeper 2 tone timer
        beep2adr                ; 43 beeper 2 address for various beepings, low byte.
        beep2ctl                ; 44 beeper 2 control flag
        id2tmr                  ; 45 transmitter 2 id timer, in 10 seconds
        hang2tmr                ; 46 transmitter 2 hang timer, in tenths.
        tx2ctd                  ; 47 tx2 ct front porch delay
        cw2tmr                  ; 48 CW element timer
        cw2byte                 ; 49 CW current byte (bitmap)
        cw2tbtmr                ; 4a CW timebase timer
        cw2tone                 ; 4b CW tone 
        ct2tone                 ; 4c courtesy tone to play
        ulk2Tmr                 ; 4d unlocked mode timer.
        cb2Tmr                  ; 4e transmitter 2 chicken burst timer
        cw2spd                  ; 4f CW speed
        endc

        cblock  h'50'           ; RAM block

        flags                   ; 50 receivers activity flag
        ;; internal timing generation
        oneMsC                  ; 51 one millisecond counter
        tenMsC                  ; 52 ten milliseconds counter
        hundMsC                 ; 53 hundred milliseconds counter
        thouMsC                 ; 54 thousand milliseconds counter (1 sec)
        temp                    ; 55 working storage. don't use in int handler.
        temp2                   ; 56 more working storage
        temp3                   ; 57 still more temporary storage
        temp4                   ; 58 yet still more temporary storage
        temp5                   ; 59 temporary storage...
        temp6                   ; 5a temporary storage...
        ;; operating flags
        fanTmr                  ; 5b fan timer
        pulsTmr                 ; 5c pulse timer.
        cmdSize                 ; 5d # digits received for current command
        eeAddr                  ; 5e EPROM address (low byte) to read/write
        eeCount                 ; 5f number of bytes to read/write from EEPROM
        endc                    ; this block ends at 5f
        
        cblock  h'60'           ; 60 to 6f is 16 control flag bytes.
                                ; but, since there are only 10, use 10! 
        ;; control operator control flag groups
        group0                  ; 60 group 0 flags
        group1                  ; 61 group 1 flags
        group2                  ; 62 group 2 flags
        group3                  ; 63 group 3 flags
        group4                  ; 64 group 4 flags
        group5                  ; 65 group 5 flags
        group6                  ; 66 group 6 flags
        group7                  ; 67 group 7 flags
        group8                  ; 68 group 8 flags
        group9                  ; 69 group 9 flags
        serFlag                 ; 6a serial interface control flags
        echoCh                  ; 6b character to echo.
        endc                    ; this block ends at 6f

        cblock  h'70'           ; from 70 to 7f is common to all banks!
        rICD70                  ; 70 reserved for ICD2
        dt1ptr                  ; 71  DTMF-1 buffer pointer
        dt1tmr                  ; 72  DTMF-1 buffer timer
        dt2ptr                  ; 73  DTMF-2 buffer pointer
        dt2tmr                  ; 74  DTMF-2 buffer timer
        txHead                  ; 75  serial transmitter buffer head pointer.
        txTail                  ; 76  serial transmitter buffer tail pointer.
        rxHead                  ; 77  serial receiver buffer head pointer.
        rxTail                  ; 78  serial receiver buffer head pointer.
        dtRFlag                 ; 79  DTMF receive flag...
        dtEFlag                 ; 7a  DTMF command interpreter control flag
        eebPtr                  ; 7b  eebuf write pointer.
        tFlags                  ; 7c  Timer Flags
        ;; interrupt pseudo-stack to save context during interrupt processing.
        s_copy                  ; 7d  saved STATUS
        p_copy                  ; 7e  saved PCLATH
        w_copy                  ; 7f  saved W register for interrupt handler
        endc                    ; 1st RAM block ends at 7f

        cblock  h'a0'           ; 2nd block of RAM at a0h-efh (80 bytes here)
        alrmTmr                 ; a0 alarm beeper timer.
        alrmDbc                 ; a1 alarm debounce timer.
        stateNo                 ; a2 the last state loaded.
        ct4dbc                  ; a3 ct4sel debounce timer
        ct5dbc                  ; a4 ct5sel debounce timer
        ct6dbc                  ; a5 ct6sel debounce timer
        endc
        
        cblock  h'b0'           ; from b0 to ef is use for serial buffers.

        txBuf00                 ; b0 serial transmit buffer (32 bytes)
        txBuf01                 ; b1 serial transmit buffer
        txBuf02                 ; b2 serial transmit buffer
        txBuf03                 ; b3 serial transmit buffer
        txBuf04                 ; b4 serial transmit buffer
        txBuf05                 ; b5 serial transmit buffer
        txBuf06                 ; b6 serial transmit buffer
        txBuf07                 ; b7 serial transmit buffer
        txBuf08                 ; b8 serial transmit buffer
        txBuf09                 ; b9 serial transmit buffer
        txBuf0a                 ; ba serial transmit buffer
        txBuf0b                 ; bb serial transmit buffer
        txBuf0c                 ; bc serial transmit buffer
        txBuf0d                 ; bd serial transmit buffer
        txBuf0e                 ; be serial transmit buffer
        txBuf0f                 ; bf serial transmit buffer
        txBuf10                 ; c0 serial transmit buffer
        txBuf11                 ; c1 serial transmit buffer
        txBuf12                 ; c2 serial transmit buffer
        txBuf13                 ; c3 serial transmit buffer
        txBuf14                 ; c4 serial transmit buffer
        txBuf15                 ; c5 serial transmit buffer
        txBuf16                 ; c6 serial transmit buffer
        txBuf17                 ; c7 serial transmit buffer
        txBuf18                 ; c8 serial transmit buffer
        txBuf19                 ; c9 serial transmit buffer
        txBuf1a                 ; ca serial transmit buffer
        txBuf1b                 ; cb serial transmit buffer
        txBuf1c                 ; cc serial transmit buffer
        txBuf1d                 ; cd serial transmit buffer
        txBuf1e                 ; ce serial transmit buffer
        txBuf1f                 ; cf serial transmit buffer

        rxBuf00                 ; d0 serial receive buffer (32 bytes)
        rxBuf01                 ; d1 serial receive buffer
        rxBuf02                 ; d2 serial receive buffer
        rxBuf03                 ; d3 serial receive buffer
        rxBuf04                 ; d4 serial receive buffer
        rxBuf05                 ; d5 serial receive buffer
        rxBuf06                 ; d6 serial receive buffer
        rxBuf07                 ; d7 serial receive buffer
        rxBuf08                 ; d8 serial receive buffer
        rxBuf09                 ; d9 serial receive buffer
        rxBuf0a                 ; da serial receive buffer
        rxBuf0b                 ; db serial receive buffer
        rxBuf0c                 ; dc serial receive buffer
        rxBuf0d                 ; dd serial receive buffer
        rxBuf0e                 ; de serial receive buffer
        rxBuf0f                 ; df serial receive buffer
        rxBuf10                 ; e0 serial receive buffer
        rxBuf11                 ; e1 serial receive buffer
        rxBuf12                 ; e2 serial receive buffer
        rxBuf13                 ; e3 serial receive buffer
        rxBuf14                 ; e4 serial receive buffer
        rxBuf15                 ; e5 serial receive buffer
        rxBuf16                 ; e6 serial receive buffer
        rxBuf17                 ; e7 serial receive buffer
        rxBuf18                 ; e8 serial receive buffer
        rxBuf19                 ; e9 serial receive buffer
        rxBuf1a                 ; ea serial receive buffer
        rxBuf1b                 ; eb serial receive buffer
        rxBuf1c                 ; ec serial receive buffer
        rxBuf1d                 ; ed serial receive buffer
        rxBuf1e                 ; ee serial receive buffer
        rxBuf1f                 ; ef serial receive buffer
        endc                    ; end block c0-ef
        


        cblock  h'f0'           ; this is really common with 70-7f
        rsvdf0                  ; f0  reserve these 16 bytes
        rsvdf1                  ; f1  reserve these 16 bytes
        rsvdf2                  ; f2  reserve these 16 bytes
        rsvdf3                  ; f3  reserve these 16 bytes
        rsvdf4                  ; f4  reserve these 16 bytes
        rsvdf5                  ; f5  reserve these 16 bytes
        rsvdf6                  ; f6  reserve these 16 bytes
        rsvdf7                  ; f7  reserve these 16 bytes
        rsvdf8                  ; f8  reserve these 16 bytes
        rsvdf9                  ; f9  reserve these 16 bytes
        rsvdfa                  ; fa  reserve these 16 bytes
        rsvdfb                  ; fb  reserve these 16 bytes
        rsvdfc                  ; fc  reserve these 16 bytes
        rsvdfd                  ; fd  reserve these 16 bytes
        rsvdfe                  ; fe  reserve these 16 bytes
        rsvdff                  ; ff  reserve these 16 bytes
        endc                    ; 2nd RAM block ends at ff

        ;; 16F87x ram blocks continue...
        cblock  h'110'          ; 16 bytes at 110h-11fh
        endc
        
        cblock  h'120'          ; 80 bytes 120h-16fh
        dt1buf0                 ; DTMF-1 receiver buffer (16 bytes) @ 120
        dt1buf1
        dt1buf2
        dt1buf3
        dt1buf4
        dt1buf5
        dt1buf6
        dt1buf7
        dt1buf8
        dt1buf9
        dt1bufa
        dt1bufb
        dt1bufc
        dt1bufd
        dt1bufe
        dt1buff
        dt2buf0                 ; DTMF-2 receiver buffer (16 bytes) @ 130
        dt2buf1
        dt2buf2
        dt2buf3
        dt2buf4
        dt2buf5
        dt2buf6
        dt2buf7
        dt2buf8
        dt2buf9
        dt2bufa
        dt2bufb
        dt2bufc
        dt2bufd
        dt2bufe
        dt2buff
        eebuf00                 ; eeprom write buffer (16 bytes) @ 140
        eebuf01
        eebuf02
        eebuf03
        eebuf04
        eebuf05
        eebuf06
        eebuf07
        eebuf08
        eebuf09
        eebuf0a
        eebuf0b
        eebuf0c
        eebuf0d
        eebuf0e
        eebuf0f                 ; buffers end at 014f
        endc
        ;;
        ;;  there is room here from 0150 - 016f
        ;; 
        cblock  h'170'          ; 0170 this is common with 70-7f
        rsvd170                 ; reserve these 16 bytes
        rsvd171                 ; reserve these 16 bytes
        rsvd172                 ; reserve these 16 bytes
        rsvd173                 ; reserve these 16 bytes
        rsvd174                 ; reserve these 16 bytes
        rsvd175                 ; reserve these 16 bytes
        rsvd176                 ; reserve these 16 bytes
        rsvd177                 ; reserve these 16 bytes
        rsvd178                 ; reserve these 16 bytes
        rsvd179                 ; reserve these 16 bytes
        rsvd17a                 ; reserve these 16 bytes
        rsvd17b                 ; reserve these 16 bytes
        rsvd17c                 ; reserve these 16 bytes
        rsvd17d                 ; reserve these 16 bytes
        rsvd17e                 ; reserve these 16 bytes
        rsvd17f                 ; reserve these 16 bytes
        endc                    ; 3nd RAM block ends at 17f
        
        ;; cblock       h'190'  ; 16 bytes at 190h-19fh
        ;; endc
        cblock  h'1a0'          ; 80 bytes 1a0h-1efh
        cmdbf00                 ; command buffer  @1a0
        cmdbf01                 ; command buffer
        cmdbf02                 ; command buffer
        cmdbf03                 ; command buffer
        cmdbf04                 ; command buffer
        cmdbf05                 ; command buffer
        cmdbf06                 ; command buffer
        cmdbf07                 ; command buffer
        cmdbf08                 ; command buffer
        cmdbf09                 ; command buffer
        cmdbf0a                 ; command buffer
        cmdbf0b                 ; command buffer
        cmdbf0c                 ; command buffer
        cmdbf0d                 ; command buffer
        cmdbf0e                 ; command buffer
        cmdbf0f                 ; command buffer  @1af (16 bytes)
        cmdbf10                 ; command buffer  @1b0
        cmdbf11                 ; command buffer
        cmdbf12                 ; command buffer
        cmdbf13                 ; command buffer
        cmdbf14                 ; command buffer
        cmdbf15                 ; command buffer
        cmdbf16                 ; command buffer
        cmdbf17                 ; command buffer
        cmdbf18                 ; command buffer
        cmdbf19                 ; command buffer
        cmdbf1a                 ; command buffer
        cmdbf1b                 ; command buffer
        cmdbf1c                 ; command buffer
        cmdbf1d                 ; command buffer
        cmdbf1e                 ; command buffer
        cmdbf1f                 ; command buffer @1bf (32 bytes)
        endc                    ; end of block @ 1bf

        ;;
        ;;  there is room here from 01c0 to 01ef
        ;; 

        cblock  h'1f0'          ; this is common with 70-7f
        rsvd1f0                 ; reserve these 16 bytes
        rsvd1f1                 ; reserve these 16 bytes
        rsvd1f2                 ; reserve these 16 bytes
        rsvd1f3                 ; reserve these 16 bytes
        rsvd1f4                 ; reserve these 16 bytes
        rsvd1f5                 ; reserve these 16 bytes
        rsvd1f6                 ; reserve these 16 bytes
        rsvd1f7                 ; reserve these 16 bytes
        rsvd1f8                 ; reserve these 16 bytes
        rsvd1f9                 ; reserve these 16 bytes
        rsvd1fa                 ; reserve these 16 bytes
        rsvd1fb                 ; reserve these 16 bytes
        rsvd1fc                 ; reserve these 16 bytes
        rsvd1fd                 ; reserve these 16 bytes
        rsvd1fe                 ; reserve these 16 bytes
        rsvd1ff                 ; reserve these 16 bytes
        endc                    ; 3nd RAM block ends at 1ff
        
; ********************
; ** STARTUP VECTOR **
; ********************
        org     0               ; startup vector
        clrf    PCLATH          ; stay in bank 0
        goto    Start

; ***********************
; ** INTERRUPT HANDLER **
; ***********************
IntHndlr
        org     4               ; interrupt vector
        ; preserve registers...
        movwf   w_copy          ; save w register
        swapf   STATUS,w        ; get STATUS
        clrf    STATUS          ; force bank 0
        movwf   s_copy          ; save STATUS
        movf    PCLATH,w        ; get PCLATH
        movwf   p_copy          ; save PCLATH
        clrf    PCLATH          ; force page 0

        btfss   INTCON,T0IF     ; is it a timer interrupt?
        goto    INotTmr0        ; no

        ;;  process timer 0 interrupt.
        movlw   T0PRE           ; get timer 0 preset value
        movwf   TMR0            ; preset timer 0
        bsf     tFlags,TICK     ; set tick indicator flag
        bcf     INTCON,T0IF     ; clear RTCC int mask

INotTmr0                        ; no timer interrupt.
        btfss   PIR1,CCP1IF     ; is there a timer 1/compare interrupt?
        goto    INotTmr1

        ;; process timer 1 interrupt.
        clrf    TMR1L           ; clear timer 1
        clrf    TMR1H           ; clear timer 1
        bcf     PIR1,CCP1IF     ; clear compare match interrupt bit.
        btfss   PORTC,BEEP1     ; is beep1 hi?
        goto    ITmr11          ; no.
        bcf     PORTC,BEEP1     ; lower beep bit.
        goto    INotTmr1        ; done.
ITmr11                          ; beep bit was low.
        bsf     PORTC,BEEP1     ; raise beep bit.

INotTmr1                        ; end of timer 1 interrupt code.
        btfss   PIR1,TMR2IF     ; is there a timer 2 interrupt?
        goto    INotTmr2        ; no.

        ;; process timer 2 interrupt.
        ;; 101.6 us (.1016 ms)
        bcf     PIR1,TMR2IF     ; clear timer 2 interrupt bit.
        btfss   PORTC,BEEP2     ; is beep bit set?
        goto    ITmr21          ; no.
        bcf     PORTC,BEEP2     ; reset beep bit.
        goto    INotTmr2        ; done.
ITmr21                          ; set beep bit
        bsf     PORTC,BEEP2     ; set beep bit

INotTmr2                        ; end of timer 2 interrupt code.
        btfss   PIR1,RCIF       ; is it a USART Receive interrupt?
        goto    INotUSR         ; nope

        movf    rxHead,w        ; get head of buffer pointer.
        addlw   LOW rxBuf00     ; add to buffer base address.
        movwf   FSR             ; set FSR as pointer
        movf    RCREG,w         ; get received char.
        bcf     STATUS,IRP      ; select 00-FF range for FSR/INDF
        movwf   INDF            ; put char into buffer

        incf    rxHead,w        ; increment pointer.
        andlw   h'1f'           ; mask so result stays in 0-31 range.
        movwf   rxHead          ; save pointer.

        movf    INDF,w          ; get received character back.
        sublw   SCATTN          ; subtract serial attention character.
        btfss   STATUS,Z        ; skip if zero -- is cmd initiator
        goto    INotCmd         ; not the command initiator
        clrf    rxHead          ; preamble.  Reset to start of buffer.
        bsf     serFlag,SC_CMD  ; set the in-command no-echo flag
        
INotCmd
        btfsc   serFlag,SC_CMD  ; want to echo chars?
        goto    INoEcho         ; nope.
        movf    INDF,w          ; get received character back.
        movwf   echoCh          ; save this character for echo
        bsf     serFlag,SC_ECHO ; mark for echo

INoEcho
        movf    INDF,w          ; get received character back.
        sublw   SCTERM          ; subtract serial EOM character.
        btfsc   STATUS,Z        ; skip if non-zero.
        bsf     serFlag,SC_RDY  ; end of message received, ready to process.

INotUSR                         ; end of USART receive interrupt code.

        btfss   PIR1,TXIF       ; is it a USART transmit interrupt?
        goto    INotUST         ; nope
        
        movf    txTail,w        ; get tail pointer.
        subwf   txHead,w        ; subtract from head pointer.
        btfsc   STATUS,Z        ; result should be non-zero if buffer no
        goto    UTIntD          ; buffer is empty.
        incf    txTail,w        ; get pointer + 1.
        andlw   h'1f'           ; mask so result stays in 0-31 range.
        movwf   txTail          ; save it...
        addlw   LOW txBuf00     ; add to buffer base address.
        movwf   FSR             ; set FSR as pointer.
        bcf     STATUS,IRP      ; select 00-FF range for FSR/INDF
        movf    INDF,w          ; get char.
        bsf     STATUS,IRP      ; select 100-1FF range for FSR/INDF
        movwf   TXREG           ; send char.
        goto    IntExit         ; done here.
        
UTIntD                          ; no more chars to transmit.
        ;; turn off the transmitter interrupt.
        bsf     STATUS,RP0      ; select bank 1
        bcf     PIE1,TXIE       ; turn off the transmitter interrupt.
        bcf     STATUS,RP0      ; select bank 1

INotUST                         ; end of USART transmit interrupt code.


IntExit
        ;; clean up and return from interrupt.
        movf    p_copy,w        ; get PCLATH preserved value
        movwf   PCLATH          ; restore PCLATH
        swapf   s_copy,w        ; get STATUS preserved value
        movwf   STATUS          ; restore STATUS
        swapf   w_copy,f        ; swap W
        swapf   w_copy,w        ; restore W
        retfie                  ; return from interrupt.

; ***********************************************
; ** This is the end of the interrupt handler. **
; ***********************************************

;;; these are page 0 subroutines.
                
;
; send the ID message, reset ID timers & flags
;
DoID1
        btfss   group4,3        ; is ID enabled for tx1?
        goto    NoID1           ; no.
        btfss   tx1flg2,NEEDID  ; need to ID?
        return                  ; nope--id timer expired without tx since last
        ;; play the ID here.
        movlw   EECWID1         ; address of CW ID message in EEPROM.
        btfsc   group4,4        ; is ID2 selected?
        movlw   EECWID2         ; yes.
        movwf   eeAddr          ; save CT base address
        PAGE3                   ; select code page 3.
        call    PlayCWe1        ; kick of the CW playback.
        PAGE0                   ; select code page 0.
        
        movlw   EETID1          ; get EEPROM address of ID timer preset.
        movwf   eeAddr          ; set EEPROM address low byte.
        PAGE3                   ; select code page 3.
        call    ReadEEw         ; read EEPROM.
        PAGE0                   ; select code page 0.
        movwf   id1tmr          ; store to id1tmr down-counter
        bcf     tx1flg2,INITID  ; always reset initial ID flag
        movf    tx1flag,w       ; get tx flags
        andlw   b'00000011'     ; w=w&(RX1TX|RX2TX), non zero if RX active.
        btfsc   STATUS,Z        ; is it zero?
        bcf     tx1flg2,NEEDID  ; yes. reset NEEDID flag.
        return

NoID1
        clrf    id1tmr          ; clear id timer
        bcf     tx1flg2,INITID  ; clear INITID flag
        bcf     tx1flg2,NEEDID  ; clear NEEDID flag

;
; send the ID message, reset ID timers & flags
;
DoID2
        btfss   group5,3        ; is ID enabled for tx1?
        goto    NoID2           ; no.
        btfss   tx2flg2,NEEDID  ; need to ID?
        return                  ; nope--id timer expired without tx since last
        ;; play the ID here.
        movlw   EECWID1         ; address of CW ID message in EEPROM.
        btfsc   group5,4        ; is ID2 selected?
        movlw   EECWID2         ; yes.
        movwf   eeAddr          ; save CT base address
        PAGE3                   ; select code page 3.
        call    PlayCWe2        ; kick of the CW playback.
        PAGE0                   ; select code page 0.
        movlw   EETID2          ; get EEPROM address of ID timer preset.
        movwf   eeAddr          ; set EEPROM address low byte.
        PAGE3                   ; select code page 3.
        call    ReadEEw         ; read EEPROM.
        PAGE0                   ; select code page 0.
        movwf   id2tmr          ; store to id2tmr down-counter
        bcf     tx2flg2,INITID  ; always reset initial ID flag
        movf    tx2flag,w       ; get tx flags
        andlw   b'00000011'     ; w=w&(RX1TX|RX2TX), non zero if RX active.
        btfss   STATUS,Z        ; is it zero?
        return                  ; no, not zero.
        bcf     tx2flg2,NEEDID  ; yes. reset NEEDID flag.
        return

NoID2
        clrf    id2tmr          ; clear id timer
        bcf     tx2flg2,INITID  ; clear INITID flag
        bcf     tx2flg2,NEEDID  ; clear NEEDID flag

Rcv1Off                         ; turn off receiver 0
        movlw   RXSOFF          ; get new state #
        movwf   rx1stat         ; set new receiver state
        bcf     PORTB,RX11AUD   ; mute rx1 into tx1 audio
        bcf     PORTB,RX12AUD   ; mute rx1 into tx2 audio
        bcf     tx1flag,RX1TX   ; clear rx1 into tx1 bit
        bcf     tx2flag,RX1TX   ; clear rx1 into tx2 bit
        clrf    mute1Tmr        ; clear muting timer
        clrf    rx1tout         ; clear main receiver timeout timer
        return                  ; done here.
        
Rcv2Off                         ; turn off receiver 2
        movlw   RXSOFF          ; get new state #
        movwf   rx2stat         ; set new receiver state
        bcf     PORTB,RX21AUD   ; mute rx1 into tx1 audio
        bcf     PORTB,RX22AUD   ; mute rx2 into tx2 audio
        bcf     tx1flag,RX2TX   ; clear rx1 into tx1 bit
        bcf     tx2flag,RX2TX   ; clear rx1 into tx2 bit
        clrf    mute2Tmr        ; clear muting timer
        clrf    rx2tout         ; clear main receiver timeout timer
        return                  ; done here.

SetHang1                        ; start hang timer for tx1...
        btfss   group4,1        ; is hang timer enabled?
        return                  ; nope.
        movlw   EETHTS          ; get EEPROM address of hang timer short preset
        btfsc   group4,2        ; is long hang timer selected?
        movlw   EETHTL          ; get EEPROM address of hang timer long preset
        movwf   eeAddr          ; set EEPROM address low byte.
        PAGE3                   ; select code page 3.
        call    ReadEEw         ; read EEPROM.
        PAGE0                   ; select code page 0.
        movwf   hang1tmr        ; preset hang timer
        btfss   STATUS,Z        ; is hang timer zero.
        bsf     tx1flag,HANG    ; no, set hang time transmit flag
        return                  ; done.

SetHang2                        ; start hang timer for tx1...
        btfss   group5,1        ; is hang timer enabled?
        return                  ; nope.
        movlw   EETHTS          ; get EEPROM address of hang timer short preset
        btfsc   group5,2        ; is long hang timer selected?
        movlw   EETHTL          ; get EEPROM address of hang timer long preset
        movwf   eeAddr          ; set EEPROM address low byte.
        PAGE3                   ; select code page 3.
        call    ReadEEw         ; read EEPROM.
        PAGE0                   ; select code page 0.
        movwf   hang2tmr        ; preset hang timer
        btfss   STATUS,Z        ; is hang timer zero.
        bsf     tx2flag,HANG    ; no, set hang time transmit flag
        return                  ; done.

SetCT1                          ; start CT timer, transmitter 1
        incf    ct1tone,w       ; check ct1tone for FF
        btfsc   STATUS,Z        ; is result 0?
        return                  ; yes, ct1tone was FF.
        movlw   EECT1BO         ; get EEPROM address of tx1 ct front porch.
        movwf   eeAddr          ; set EEPROM address.
        PAGE3                   ; select code page 3.
        call    ReadEEw         ; read EEPROM.
        PAGE0                   ; select code page 0.
        movwf   tx1ctd          ; preset tx1 ct front porch timer.
        btfss   STATUS,Z        ; is the front porch timer zero?
        bsf     tx1flag,CTDELAY ; set the tx flag indicator.
        return                  ; done here.

SetCT2                          ; start CT timer, transmitter 2
        incf    ct2tone,w       ; check ct2tone for FF
        btfsc   STATUS,Z        ; is result 0?
        return                  ; yes, ct1tone was FF.
        movlw   EECT2BO         ; get EEPROM address of tx1 ct front porch
        movwf   eeAddr          ; set EEPROM address.
        PAGE3                   ; select code page 3.
        call    ReadEEw         ; read EEPROM.
        PAGE0                   ; select code page 0.
        movwf   tx2ctd          ; preset tx1 ct front porch timer.
        btfss   STATUS,Z        ; is the front porch timer zero?
        bsf     tx2flag,CTDELAY ; set the tx flag indicator.
        return                  ; done here.

ChkID1                          ; call on receiver drop to see if want to ID
        btfsc   tx1flg2,INITID  ; check initial ID flag
        call    DoID1           ; play the ID
        btfss   tx1flg2,NEEDID  ; need to ID?
        return
        ;
        ;if (id1tmr <= idSoon) then goto StartID
        ;implemented as: if ((IDSOON-idTimer)>=0) then ID
        ;
        movf    id1tmr,w        ; get id1tmr into W
        sublw   IDSOON          ; IDSOON-w ->w
        btfsc   STATUS,C        ; C is clear if result is negative
        call    DoID1           ; ok to ID now, let's do it.
        return                  ; don't need to ID yet...

ChkID2                          ; call on receiver drop to see if want to ID
        btfsc   tx2flg2,INITID  ; check initial ID flag
        call    DoID2           ; play the ID
        btfss   tx2flg2,NEEDID  ; need to ID?
        return
        ;
        ;if (id1tmr <= idSoon) then goto StartID
        ;implemented as: if ((IDSOON-idTimer)>=0) then ID
        ;
        movf    id2tmr,w        ; get id1tmr into W
        sublw   IDSOON          ; IDSOON-w ->w
        btfsc   STATUS,C        ; C is clear if result is negative
        call    DoID2           ; ok to ID now, let's do it.
        return                  ; don't need to ID yet...

        ;; **************************************************
        ;; **************************************************
        ;; **************************************************

; *************
; ** Init256 **
; *************
Init256                         ; initialize 256 bytes from the 32 in cmdbuf00
        movlw   d'8'            ; 8 * 32 = 256. 
        movwf   temp2           ; store into temp.
        movlw   d'32'           ; 32 bytes to write each cycle.
        movwf   eeCount         ; save eeCount:  number of bytes to write.
I256a                           ; loop through writes of 32 bytes.
        movlw   low cmdbf00     ; get base of buffer
        movwf   FSR             ; set into FSR.
        PAGE3                   ; select ROM code page 3.
        call    WriteEE         ; write into EEPROM.
        PAGE0                   ; select ROM code page 0.
        ;; pause while EE operation completes.
        call    InitPos         ; pause.
        movlw   d'32'           ; get size.
        addwf   eeAddr,f        ; add to address.
        movwf   eeCount         ; reset number of bytes to write.
        decfsz  temp2,f         ; decrement cycle count.
        goto    I256a           ; next cycle.
        return                  ; done.
        
; *************
; ** InitPos **
; *************
InitPos                         ; short pause for EEPROM write cycle.
        movlw   d'20'           ; 20 ms.
        call    InitDly         ; delay.
        movlw   d'19'           ; 19 ms.
        call    InitDly         ; delay.
        return                  ; done with pause

; *************
; ** InitDly **
; *************
InitDly                         ; delay w ms for init code.
        movwf   temp6           ; counter.
InitDl2
        btfss   tFlags,TICK     ; looking for 1 ms TICK
        goto    InitDl2         ; loop.
        bcf     tFlags,TICK     ; clear TICK marker.
        clrwdt                  ; reset WDT every ms.
        decfsz  temp6,f         ; decrement counter
        goto    InitDl2         ; counter not zeroed yet.
        return
        
; *********************
; ** PROGRAM STARTUP **
; *********************
        org     0200
Start
        bsf     STATUS,RP0      ; select bank 1
        bsf     STATUS,RP0      ; select bank 1

        movlw   b'00000000'
        movwf   ADCON0
        movlw   b'00000111'
        movwf   ADCON1
        
        movlw   b'10000011'     ; RBPU pull ups ON=0, breaks ICD3.
                                ; INTEDG INT on falling edge
                                ; T0CS   TMR0 uses instruction clock
                                ; T0SE  n/a
                                ; PSA TMR0 gets the prescaler 
                                ; PS2 \
                                ; PS1  > prescaler 16
                                ; PS0 /
        movwf   OPTION_REG      ; set options

        movlw   B'11011111'     ; na/na/out/in/in/in/in/in
        movwf   TRISA           ; set port A data direction

        movlw   B'00000000'     ; out/out/out/out/out/out/out/out
        movwf   TRISB           ; set port B data direction

        movlw   B'11111100'     ; in/in/in/in/in/in/out/out
        movwf   TRISC           ; set port C data direction

        movlw   B'00001111'     ; out/out/out/out/in/in/in/in
        movwf   TRISD           ; set port D data direction
        movlw   B'00000011'     ; out/out/out/out/out/out/in/in
        movwf   TRISE           ; set port E data direction
        
        IFDEF  __16F887
        bsf     STATUS,RP1      ; select register page 2/3
        clrf    ANSEL           ; clear analog select
        clrf    ANSELH          ; clear analog select
        bcf     STATUS,RP1      ; select register page 0/1
        ENDIF

        ; set up serial port, part 1

        movlw   b'11000000'     ; SMP=1 CKE=1
        movwf   SSPSTAT         ; input data on falling edge, output on rising
        movlw   d'103'          ; 9600 baud at 16.0 MHz clock.
        movwf   SPBRG           ; set baud rate generator.
        movlw   b'00100100'     ; transmit enabled, hi speed async.
        movwf   TXSTA           ; set transmit status and control register.
        movlw   b'00100110'     ; USART rx interrupt enabled.
                                ; interrupt on CCP1 or TMR2.
        movwf   PIE1            ; set peripheral interrupts enable register.

        bcf     STATUS,RP0      ; select bank 0

        movlw   b'10010000'     ; serial enabled, etc.
        movwf   RCSTA           ; set receive status and control register.

        ;; PORT A does not need to be initialized, it is input-only.
        clrf    PORTA           ; turn fan off
        clrf    PORTB           ; preset PORTB all off.
        clrf    PORTC           ; preset PORTC.
        clrf    PORTD
        clrf    PORTE
        
        clrwdt                  ; give me more time to get up and running.

        ;; set up timer 1
        movlw   b'00000000'     ; set up timer 1.
        movwf   T1CON           ; set up timer 1.
        movlw   b'00001010'     ; timer 1 compare throws interrupt.
        movwf   CCP1CON         ; set up compare mode.
        movlw   h'ff'           ; init compare value.
        movwf   CCPR1L          ; set up initial compare (invalid)
        movwf   CCPR1H          ; set up initial compare (invalid)
        
        ;; set up timer 2
        ;; timer 2 is shut off
        clrf    T2CON           ; set up timer 2.
        
        ;; enable interrupts.
        movlw   b'11100000'     ; enable global + peripheral + timer0
        movwf   INTCON

        btfsc   PORTA,INIT      ; skip if init button pressed.
        goto    Start1          ; no initialize request.
        
; *********************
; * INITIALIZE EEPROM *
; *********************
                
        clrf    temp2           ; byte index
InitLp
        movf    temp2,w         ; get init address
        movwf   eeAddr          ; set eeprom address
        movf    temp2,w         ; get init address
        PAGE3                   ; select page 3
        call    InitDat         ; get init byte
        call    WriteEw         ; write byte to EEPROM.
        PAGE0                   ; select page 0
        incfsz  temp2,f         ; skip to next byte till all 256 are done.
        goto    InitLp          ; get the next block of 16 or be done.
        
; ********************************
; ** Ready to really start now. **
; ********************************
Start1
        ;; 
        ;; clear memory
        ;; 
        bcf     STATUS,IRP      ; select FSR is in 00-ff range
        movlw   h'20'           ; first address of RAM.
        movwf   FSR             ; set pointer.
ClrMem                          ; clear memory.
        clrf    INDF            ; clear ram byte.
        incf    FSR,f           ; increment FSR.
        btfss   FSR,7           ; cheap test for address 80 and above.
        goto    ClrMem          ; loop some more.
        ; now clear from a0 to ff
        movlw   h'a0'           ; first address of RAM.
        movwf   FSR             ; set pointer.
ClrMem1                         ; clear more memory.
        clrf    INDF            ; clear ram byte.
        incfsz  FSR,f           ; increment FSR.
        goto    ClrMem1         ; loop some more.
        bsf     STATUS,IRP      ; select FSR is in 100-1ff range

        ;; 
        ;; preset stuff that needs to be non-zero
        ;; 
        movlw   TEN             ; get timebase presets
        movwf   oneMsC
        movwf   tenMsC
        movwf   hundMsC
        movwf   thouMsC
        clrf    tFlags

        movlw   CTNONE          ; no courtesy tone.
        movwf   ct1tone         ; set courtesy tone selector.
        movwf   ct2tone         ; set courtesy tone selector.

        ;; 
        ;; load eeprom data, saved state 0
        ;; 
        clrw                    ; select macro set 0.
        PAGE3                   ; select page 3.
        call    LoadCtl         ; load control op settings.
        call    CWParms         ; get the CW Parameters.
        PAGE0                   ; select page 0
        
        ;;
        ;; say hello to all the nice people out there.
        ;;
        PAGE3                   ; select code page 3.
        movlw   CW_N17          ; get controller name announcement.
        call    PlayCW1         ; start playback
        PAGE0                   ; select code page 0.

; **************************************************************************
; ******************************* MAIN LOOP ********************************
; **************************************************************************
                
Loop0
        btfsc   tFlags,TENSEC   ; is ten second flag set?
        bcf     tFlags,TENSEC   ; reset it if it is...

Chek1000        
        btfss   tFlags,ONESEC   ; is the 1000 mS flag set?
        goto    Check100        ; nope...
        bcf     tFlags,ONESEC   ; clear 1000 mS flag.
        decfsz  thouMsC,f       ; decrement hundred millisecond counter.
        goto    Check100        ; not zero.
        movlw   TEN             ; get preset.
        movwf   thouMsC         ; reset down counter.
        bsf     tFlags,TENSEC   ; set TENSEC indicator.

Check100        
        btfss   tFlags,HUNDMS   ; is the 100 mS flag set?
        goto    Check10         ; nope...
        bcf     tFlags,HUNDMS   ; clear 100 mS flag.
        decfsz  hundMsC,f       ; decrement hundred millisecond counter.
        goto    Check10         ; not zero.
        movlw   TEN             ; get preset.
        movwf   hundMsC         ; reset down counter.
        bsf     tFlags,ONESEC   ; set ONESEC indicator.

Check10
        btfss   tFlags,TENMS    ; is the 10 mS flag set?
        goto    Check1          ; nope...
        bcf     tFlags,TENMS    ; clear 10 mS flag.
        decfsz  tenMsC,f        ; decrement ten millisecond counter.
        goto    Check1          ; not zero.
        movlw   TEN             ; get preset.
        movwf   tenMsC          ; reset down counter.
        bsf     tFlags,HUNDMS   ; set HUNDMS indicator.

Check1
        btfss   tFlags,ONEMS    ; is the 1 mS flag set?
        goto    CheckTic        ; nope...
        bcf     tFlags,ONEMS    ; clear 1 mS flag.
        decfsz  oneMsC,f        ; decrement one millisecond counter.
        goto    CheckTic        ; not zero.
        movlw   TEN             ; get preset.
        movwf   oneMsC          ; reset down counter.
        bsf     tFlags,TENMS    ; set TENMS indicator.

CheckTic
        
        btfss   tFlags,TICK     ; did a tick occur?
        goto    Loop1           ; nope.
        bcf     tFlags,TICK     ; reset TICK indicator.
        bsf     tFlags,ONEMS    ; set ONEMS indicator.
        CLRWDT

Loop1
        ;; LED BLINKER.
        ;btfss   tFlags,HUNDMS  ; DEBUG!!!
        ;goto    LedEnd
        ;btfss   PORTD,5
        ;goto    l3off
        ;bcf     PORTD,5
        ;goto    LedEnd
l3off 
        ;bsf     PORTD,5
LedEnd
        
; ********************************************
; ** RECEIVER DEBOUNCE AND INPUT VALIDATION **
; ********************************************
DebRx
        btfss   tFlags,ONEMS    ; is the one ms tick active?
        goto    OneMsD          ; nope
CkRx1                           ; check COR state receiver 1
        btfss   PORTE,RX1COR    ; check cor receiver 1
        goto    Rx1COR1         ; it's low, COR is present
                                ; COR is not present.
        btfss   group0,2        ; (NOT) OR PL? (dual squelch)
        goto    Rx1Off          ; nope...
        goto    Rx1CkPL         ; yes, OR PL mode
Rx1COR1
        btfss   group0,1        ; AND PL set? (CTCSS required)
        goto    Rx1On           ; no.
Rx1CkPL                         ; check PL...
        btfsc   PORTE,RX1PL     ; is the PL signal present?
        goto    Rx1Off          ; no.
Rx1On                           ; the COR and PL requirements have been met
        btfsc   flags,RX1USQ    ; already marked active?
        goto    Rx1NC           ; yes.
        movf    rx1dbc,f        ; check for zero
        btfss   STATUS,Z        ; is it zero?
        goto    Rx11Dbc         ; nope...
        movlw   COR1DEB         ; get COR debounce timer value.
        btfsc   group1,4        ; is the delay present?
        movlw   DLY1DEB         ; get COR debounce with delay value.

        btfss   group1,0        ; is the kerchunker delay set?
        goto    Rx1SDeb         ; no.
        btfss   group0,6        ; is rx1->tx1 enabled?
        goto    Rx1CC2          ; no, check rx1->tx2 then.
        movf    tx1flag,f       ; check for transmitter already on.
        btfss   STATUS,Z        ; is the transmitter already on?
        goto    Rx1SDeb         ; yep.
Rx1CC2
        btfss   group0,7        ; is rx1->tx2 enabled?
        goto    Rx1CCD          ; no, going to use the kerchunker delay.
        movf    tx2flag,f       ; check for transmitter already on.
        btfsc   STATUS,Z        ; is the transmitter already on?
Rx1CCD                          ; going to use the kerchunker delay.
        movlw   CHNKDEB         ; get kerchunker filter delay.
Rx1SDeb                         ; set debounce timer.
        movwf   rx1dbc          ; set it
        goto    Rx1Done         ; done.
Rx11Dbc
        decfsz  rx1dbc,f        ; decrement the debounce counter
        goto    Rx1Done         ; not zero yet
        bsf     flags,RX1USQ    ; set receiver active flag
        goto    Rx1Done         ; continue...
Rx1Off                          ; the COR and PL requirements have not been met
        btfss   flags,RX1USQ    ; was the receiver off before?
        goto    Rx1NC           ; yes.
        movf    rx1dbc,f        ; check for zero
        btfss   STATUS,Z        ; is it zero?
        goto    Rx10Dbc         ; nope...
        movlw   COR0DEB         ; get COR debounce timer value.
        btfsc   group1,4        ; is the delay present?
        movlw   DLY0DEB         ; get COR debounce with delay value.
        movwf   rx1dbc          ; set it
        goto    Rx1Done         ; done.
Rx10Dbc
        decfsz  rx1dbc,f        ; decrement the debounce counter
        goto    Rx1Done         ; not zero yet
        bcf     flags,RX1USQ    ; clear receiver active flag
        movf    dt1tmr,f        ; test to see if touch-tones received...
        btfsc   STATUS,Z        ; is it zero?
        goto    Rx1Done         ; yes. don't need to accellerate execution.
        movlw   d'2'            ; no
        movwf   dt1tmr          ; accelerate eval of DTMF command
        goto    Rx1Done         ; continue...
Rx1NC
        clrf    rx1dbc          ; clear debounce counter.
Rx1Done

CkRx2                           ; check COR state receiver 2
        btfss   PORTC,RX2COR    ; check cor receiver 2
        goto    Rx2COR1         ; it's low, COR is present
                                ; COR is not present.
        btfss   group2,2        ; (NOT) OR PL? (DUAL SQUELCH)
        goto    Rx2Off          ; nope...
        goto    Rx2CkPL         ; yes, OR PL mode
Rx2COR1
        btfss   group2,1        ; AND PL set?
        goto    Rx2On           ; no.
Rx2CkPL                         ; check PL...
        btfsc   PORTC,RX2PL     ; is the PL signal present?
        goto    Rx2Off          ; no.
Rx2On                           ; the COR and PL requirements have been met
        btfsc   flags,RX2USQ    ; already marked active?
        goto    Rx2NC           ; yes.
        movf    rx2dbc,f        ; check for zero
        btfss   STATUS,Z        ; is it zero?
        goto    Rx21Dbc         ; nope...
        movlw   COR1DEB         ; get COR debounce timer value
        btfsc   group3,4        ; is the delay present?
        movlw   DLY1DEB         ; get COR debounce with delay value.

        btfss   group3,0        ; is the kerchunker delay set?
        goto    Rx2SDeb         ; no.
        btfss   group2,6        ; is rx2->tx1 enabled?
        goto    Rx2CC2          ; no, check rx2->tx2 then.
        movf    tx1flag,f       ; check for transmitter already on.
        btfss   STATUS,Z        ; is the transmitter already on?
        goto    Rx2SDeb         ; yep.
Rx2CC2
        btfss   group2,7        ; is rx2->tx2 enabled?
        goto    Rx2CCD          ; no, going to use the kerchunker delay.
        movf    tx2flag,f       ; check for transmitter already on.
        btfsc   STATUS,Z        ; is the transmitter already on?
Rx2CCD                          ; going to use the kerchunker delay.
        movlw   CHNKDEB         ; get kerchunker filter delay.
Rx2SDeb                         ; set debounce timer.
        movwf   rx2dbc          ; set it
        goto    Rx2Done         ; done.
Rx21Dbc
        decfsz  rx2dbc,f        ; decrement the debounce counter
        goto    Rx2Done         ; not zero yet
        bsf     flags,RX2USQ    ; set receiver active flag
        goto    Rx2Done         ; continue...
Rx2Off                          ; the COR and PL requirements have not been met
        btfss   flags,RX2USQ    ; was the receiver off before?
        goto    Rx2NC           ; yes.
        movf    rx2dbc,f        ; check for zero
        btfss   STATUS,Z        ; is it zero?
        goto    Rx20Dbc         ; nope...
        movlw   COR0DEB         ; get COR debounce timer value.
        btfsc   group3,4        ; is the delay present?
        movlw   DLY0DEB         ; get COR debounce with delay value.
        movwf   rx2dbc          ; set it
        goto    Rx2Done         ; done.
Rx20Dbc
        decfsz  rx2dbc,f        ; decrement the debounce counter
        goto    Rx2Done         ; not zero yet
        bcf     flags,RX2USQ    ; set receiver active flag
        movf    dt2tmr,f        ; test to see if touch-tones received...
        btfsc   STATUS,Z        ; is it zero?
        goto    Rx2Done         ; yes. don't need to accellerate execution.
        movlw   d'2'            ; no
        movwf   dt2tmr          ; accelerate eval of DTMF command
        goto    Rx2Done         ; done.
Rx2NC
        clrf    rx2dbc          ; clear debounce counter.
Rx2Done

        ;; debounce CT4SEL, CT5SEL, and CT6SEL here
        btfss   group1,3        ; is CTSEL state change enabled?
        goto    NoCtSC          ; nope
        
CkCt4                           ; check CT4SEL state
        btfss   PORTD,CT4SEL    ; is CT select 4 input active (low)?
        goto    CT4DB0          ; is is low
        bsf     STATUS,RP0      ; set A7 for addresses 80-ff, 180-1ff
        clrf    ct4dbc          ; clear debounce counter.
        bcf     STATUS,RP0      ; clear A7 for addresses 00-7f, 100-17f
        goto    CkCt5           ; done here
        
CT4DB0                          ; CT4 is LOW.
        bsf     STATUS,RP0      ; set A7 for addresses 80-ff, 180-1ff
        movf    ct4dbc,w        ; get ct4 debounce timer
        bcf     STATUS,RP0      ; clear A7 for addresses 00-7f, 100-17f
        sublw   CT_DBC          ; subtract CT4/5/6 debounce time.
        btfss   STATUS,C        ; skip if CT_DBC - ctXDbc is positive.
        goto    SetS1           ; possibly set state 1
        bsf     STATUS,RP0      ; set A7 for addresses 80-ff, 180-1ff
        incf    ct4dbc,f        ; increment ct4 debounce timer.
        bcf     STATUS,RP0      ; clear A7 for addresses 00-7f, 100-17f
        goto    CkCt5           ; done here.

SetS1
        bsf     STATUS,RP0      ; set A7 for addresses 80-ff, 180-1ff
        movf    stateNo,f       ; get current state.
        bcf     STATUS,RP0      ; clear A7 for addresses 00-7f, 100-17f
        sublw   d'1'            ; compare to state 1
        btfsc   STATUS,Z        ; is it zero?
        goto    NoCtSC          ; no state change
        movlw   d'1'            ; select state 1
        PAGE3                   ; select page 3.
        call    LoadCtl         ; load control op settings.
        PAGE0                   ; select page 0
        goto    NoCtSC          ; done for now.
        
CkCt5                           ; check CT5SEL state
        btfss   PORTD,CT5SEL    ; is CT select 5 input active (low)?
        goto    CT5DB0          ; is is low
        bsf     STATUS,RP0      ; set A7 for addresses 80-ff, 180-1ff
        clrf    ct5dbc          ; clear debounce counter.
        bcf     STATUS,RP0      ; clear A7 for addresses 00-7f, 100-17f
        goto    CkCt6           ; done here
        
CT5DB0                          ; CT4 is LOW.
        bsf     STATUS,RP0      ; set A7 for addresses 80-ff, 180-1ff
        movf    ct5dbc,w        ; get ct5 debounce timer
        bcf     STATUS,RP0      ; clear A7 for addresses 00-7f, 100-17f
        sublw   CT_DBC          ; subtract CT4/5/6 debounce time.
        btfss   STATUS,C        ; skip if CT_DBC - ctXDbc is positive.
        goto    SetS2           ; possibly set state 1
        bsf     STATUS,RP0      ; set A7 for addresses 80-ff, 180-1ff
        incf    ct5dbc,f        ; increment ct4 debounce timer.
        bcf     STATUS,RP0      ; clear A7 for addresses 00-7f, 100-17f
        goto    CkCt6           ; done here.

SetS2
        bsf     STATUS,RP0      ; set A7 for addresses 80-ff, 180-1ff
        movf    stateNo,f       ; get current state.
        bcf     STATUS,RP0      ; clear A7 for addresses 00-7f, 100-17f
        sublw   d'2'            ; compare to state 2
        btfsc   STATUS,Z        ; is it zero?
        goto    NoCtSC          ; no state change
        movlw   d'2'            ; select state 2
        PAGE3                   ; select page 3.
        call    LoadCtl         ; load control op settings.
        PAGE0                   ; select page 0
        goto    NoCtSC          ; done for now.

CkCt6                           ; check CT6SEL state
        btfss   PORTD,CT6SEL    ; is CT select 6 input active (low)?
        goto    CT6DB0          ; is is low
        bsf     STATUS,RP0      ; set A7 for addresses 80-ff, 180-1ff
        clrf    ct6dbc          ; clear debounce counter.
        bcf     STATUS,RP0      ; clear A7 for addresses 00-7f, 100-17f
        goto    NoCtSC          ; done here
        
CT6DB0                          ; CT4 is LOW.
        bsf     STATUS,RP0      ; set A7 for addresses 80-ff, 180-1ff
        movf    ct6dbc,w        ; get ct6 debounce timer
        bcf     STATUS,RP0      ; clear A7 for addresses 00-7f, 100-17f
        sublw   CT_DBC          ; subtract CT4/5/6 debounce time.
        btfss   STATUS,C        ; skip if CT_DBC - ctXDbc is positive.
        goto    SetS3           ; possibly set state 1
        bsf     STATUS,RP0      ; set A7 for addresses 80-ff, 180-1ff
        incf    ct6dbc,f        ; increment ct6 debounce timer.
        bcf     STATUS,RP0      ; clear A7 for addresses 00-7f, 100-17f
        goto    NoCtSC          ; done here.

SetS3
        bsf     STATUS,RP0      ; set A7 for addresses 80-ff, 180-1ff
        movf    stateNo,f       ; get current state.
        bcf     STATUS,RP0      ; clear A7 for addresses 00-7f, 100-17f
        sublw   d'3'            ; compare to state 3
        btfsc   STATUS,Z        ; is it zero?
        goto    NoCtSC          ; no state change
        movlw   d'3'            ; select state 3
        PAGE3                   ; select page 3.
        call    LoadCtl         ; load control op settings.
        PAGE0                   ; select page 0
        goto    NoCtSC          ; done for now.
        
NoCtSC  
OneMsD                          ; one ms timer tic processing done
        
        btfss   tFlags,TENMS    ; is the ten ms tick active?
        goto    TenMsD          ; nope
        
        ;; ******************************
        ;; ** debounce the alarm input **
        ;; ******************************
        btfss   group6,3        ; is the alarm enabled?
        goto    CkAlDon         ; no.  ignore all this.
        btfss   PORTD,ALARM     ; is alarm bit off?
        goto    DebAlm          ; no.
        bsf     STATUS,RP0      ; set A7 for addresses 80-ff, 180-1ff
        clrf    alrmDbc         ; clear debounce counter.
        bcf     STATUS,RP0      ; clear A7 for addresses 00-7f, 100-17f
        goto    CkAlDon         ; done here.
DebAlm                          ; debounce alarm input.
        bsf     STATUS,RP0      ; set A7 for addresses 80-ff, 180-1ff
        movf    alrmDbc,w       ; get alarm debounce timer
        bcf     STATUS,RP0      ; clear A7 for addresses 00-7f, 100-17f
        sublw   ALM_DBC         ; subtract alarm debounce time.
        btfss   STATUS,C        ; skip if ALM_DBC - alrmDbc is positive.
        goto    SetAlrm         ; it's positive.
        bsf     STATUS,RP0      ; set A7 for addresses 80-ff, 180-1ff
        incf    alrmDbc,f       ; increment alarm debounce timer.
        bcf     STATUS,RP0      ; clear A7 for addresses 00-7f, 100-17f
        goto    CkAlDon         ; done here.
SetAlrm                         ; set the alarm tone up, if not already set.
        bsf     STATUS,RP0      ; set A7 for addresses 80-ff, 180-1ff
        movf    alrmTmr,f       ; check alarm timer.
        bcf     STATUS,RP0      ; clear A7 for addresses 00-7f, 100-17f
        btfss   STATUS,Z        ; is it zero?
        goto    CkAlDon         ; no.  Alarm timer is already set.
        movlw   d'1'            ; immediately start alarm tone.
        bsf     STATUS,RP0      ; set A7 for addresses 80-ff, 180-1ff
        movwf   alrmTmr         ; save alarm timer.
        bcf     STATUS,RP0      ; clear A7 for addresses 00-7f, 100-17f
CkAlDon                         ; checking alarm done.
                
        ;; ******************
        ;; ** check DTMF-1 ** 
        ;; ******************
CkDTMF1 
        btfss   PORTC,DTMF1DV   ; is a DTMF digit being decoded?
        goto    CkDT1L          ; no
        btfsc   rx1flag,LASTDV  ; was it there last time?
        goto    CkDTMF2         ; yes, do nothing.
        bsf     rx1flag,LASTDV  ; set last DV indicator.

RdDT1
        btfsc   group1,6        ; muting rx1 -> tx1 enabled?
        bcf     PORTB,RX11AUD   ; mute rx1 -> tx1.
        btfsc   group1,7        ; muting rx1 -> tx2 enabled?
        bcf     PORTB,RX12AUD   ; mute rx1 -> tx2.
        movlw   MUTEDLY         ; get mute timer delay
        movwf   mute1Tmr        ; preset mute timer
RdDT1m
        movlw   DTMFDLY         ; get DTMF activity timer preset.
        movwf   dt1tmr          ; set DTMF command timer
        
        movf    dt1ptr,w        ; get index
        movwf   FSR             ; put it in FSR
        bcf     STATUS,C        ; clear carry (just in case)
        rrf     FSR,f           ; hey! divide by 2.
        movlw   LOW dt1buf0     ; get address of buffer
        addwf   FSR,f           ; add to index.

        bsf     PORTB,DTMF1OE   ; enable DTMF-0 output port.
        movlw   b'00001111'     ; mask bits.
        andwf   PORTA,w         ; get masked bits of tone into W.
        bcf     PORTB,DTMF1OE   ; disable DTMF-0 output port.
        PAGE3                   ; select code page 3.
        call    MapDTMF         ; remap tone into keystroke value..
        PAGE0                   ; select code page 0.
        iorlw   h'0'            ; OR with zero to set status bits.
        bcf     rx1flag,DTMF0   ; clear last zero received.
        btfsc   STATUS,Z        ; was a zero the last received digit?
        bsf     rx1flag,DTMF0   ; yes...
        
        btfsc   dt1ptr,0        ; is this an odd address?
        goto    DT1Odd          ; yes;
        clrf    INDF            ; zero both nibbles.
        movwf   INDF            ; save tone in indirect register.
        swapf   INDF,f          ; move the tone to the high nibble
        goto    DT1Done         ; done here
DT1Odd
        iorwf   INDF,F          ; save tone in low nibble
DT1Done 
        incf    dt1ptr,f        ; increment index
        movlw   h'1f'           ; mask
        andwf   dt1ptr,f        ; don't let index grow past 1f (31)

        goto    CkDTMF2         ; done with DTMF checking.

CkDT1L                          ; check for end of LITZ...
        btfss   rx1flag,LASTDV  ; was it low last time?
        goto    CkDTMF2         ; yes.  Done.
        bcf     rx1flag,LASTDV  ; no, clear last DV indicator.

        ;; ******************
        ;; ** check DTMF-2 ** 
        ;; ******************
CkDTMF2
        btfss   PORTC,DTMF2DV   ; is a DTMF digit being decoded?
        goto    CkDT2L          ; no
        btfsc   rx2flag,LASTDV  ; was it there last time?
        goto    CkDTDone        ; yes, do nothing.
        bsf     rx2flag,LASTDV  ; set last DV indicator.

RdDT2
        btfsc   group3,6        ; muting rx2 -> tx1 enabled?
        bcf     PORTB,RX21AUD   ; mute rx2 -> tx1.
        btfsc   group3,7        ; muting rx2 -> tx2 enabled?
        bcf     PORTB,RX22AUD   ; mute rx2 -> tx2.
        movlw   MUTEDLY         ; get mute timer delay
        movwf   mute2Tmr        ; preset mute timer
RdDT2m
        movlw   DTMFDLY         ; get DTMF activity timer preset.
        movwf   dt2tmr          ; set DTMF command timer
        
        movf    dt2ptr,w        ; get index
        movwf   FSR             ; put it in FSR
        bcf     STATUS,C        ; clear carry (just in case)
        rrf     FSR,f           ; hey! divide by 2.
        movlw   LOW dt2buf0     ; get address of buffer
        addwf   FSR,f           ; add to index.

        bsf     PORTB,DTMF2OE   ; enable DTMF-1 output port.
        movlw   b'00001111'     ; mask bits.
        andwf   PORTA,w         ; get masked bits of tone into W.
        bcf     PORTB,DTMF2OE   ; disable DTMF-1 output port.
        PAGE3                   ; select code page 3.
        call    MapDTMF         ; remap tone into keystroke value..
        PAGE0                   ; select code page 0.
        iorlw   h'0'            ; OR with zero to set status bits.
        bcf     rx2flag,DTMF0   ; clear last zero received.
        btfsc   STATUS,Z        ; was a zero the last received digit?
        bsf     rx2flag,DTMF0   ; yes...
        
        btfsc   dt2ptr,0        ; is this an odd address?
        goto    DT2Odd          ; yes;
        clrf    INDF            ; zero both nibbles.
        movwf   INDF            ; save tone in indirect register.
        swapf   INDF,f          ; move the tone to the high nibble
        goto    DT2Done         ; done here
DT2Odd
        iorwf   INDF,F          ; save tone in low nibble
DT2Done 
        incf    dt2ptr,f        ; increment index
        movlw   h'1f'           ; mask
        andwf   dt2ptr,f        ; don't let index grow past 1f (31)

        goto    CkDTDone        ; done with DTMF checking.

CkDT2L                          ; check for end of LITZ...
        btfss   rx2flag,LASTDV  ; was it low last time?
        goto    CkDTDone        ; yes.  Done.
        bcf     rx2flag,LASTDV  ; clear last DV indicator.
        
CkDTDone                        ; done with DTMF scanning.
TenMsD                          ; ten ms tasks done.

        goto    MainLp          ; crosses 256 byte boundary (to 0300)

; *************************************
; * main loop for repeater controller *
; *************************************
        
        org     0400
MainLp

; ***********************
; * Receiver processing *
; ***********************
        
DoRx1
        movlw   high Rx1Tbl     ; set high byte of address
        movwf   PCLATH          ; select page
        movf    rx1stat,w       ; get main receiver state
        addwf   PCL,f           ; add w to PCL:  computed GOTO
Rx1Tbl
        goto    Rx1Quiet        ; quiet
        goto    Rx1Rpt          ; repeat
        goto    Rx1Tmot         ; timeout

Rx1Quiet                        ; receiver quiet state
        btfss   flags,RX1USQ    ; is squelch open?
        goto    Rx1End          ; nope, don't turn receiver on
        ;; receiver is unsquelched; put it on the air
        ;; receiver inactive --> active transistion
        btfss   group0,0        ; is repeater enabled?
        goto    Rx1End          ; disabled, not gonna turn receiver on
        btfss   group0,3        ; is DTMF access mode enabled?
        goto    Rx1OffOn        ; no. start repeating.
        movf    dt1atmr,f       ; check DTMF access mode timer.
        btfsc   STATUS,Z        ; is it zero?
        goto    Rx1End          ; yes.  Don't turn receiver on.
        ;; timer is not zero, reset to initial value.
        movlw   EETDTA          ; get EEPROM address of DTMF access timer.
        movwf   eeAddr          ; set EEPROM address low byte.
        PAGE3                   ; select code page 3.
        call    ReadEEw         ; read EEPROM.
        PAGE0                   ; select code page 0.
        movwf   dt1atmr         ; set DTMF access mode timer.
Rx1OffOn                        ; receiver inactive --> active transition
        ;; check for priority
        movf    group0,w        ; get group 0 flags
        andwf   group2,w        ; and with group 2 flags
        andlw   b'11000000'     ; result is non-zero if linked.
        btfsc   STATUS,Z        ; are ports linked?
        goto    Rx101a          ; no.
        btfss   group3,5        ; does RX 2 have priority?
        goto    Rx101a          ; nope.
        movf    rx2stat,w       ; get RX 2 receiver state.
        sublw   RXSON           ; subtract ON state value.
        btfsc   STATUS,Z        ; is result zero?
        goto    Rx1End          ; yes.  RX 2 is ON. don't turn on RX1.
Rx101a
        movlw   RXSON           ; get new state #
        movwf   rx1stat         ; set new receiver state
        btfss   group0,6        ; is rx1 to tx1 enabled?
        goto    Rx101b          ; no.
        btfss   group4,5        ; is tx1 considered duplex?
        goto    Rx101b          ; no.
        bsf     tx1flag,RX1TX   ; set main receiver on bit
        movlw   CTNONE          ; no courtesy tone.
        movwf   ct1tone         ; kill off any pending courtesy tone.
        movf    mute1Tmr,f      ; check mute timer
        btfsc   STATUS,Z        ; if it's non-zero, skip unmute
        bsf     PORTB,RX11AUD   ; unmute rx1 into tx1
Rx101b                          ; check rx1 into tx2 now.
        btfss   group0,7        ; is rx1 to tx1 enabled?
        goto    Rx101c          ; no.
        bsf     tx2flag,RX1TX   ; set main receiver on bit
        movlw   CTNONE          ; no courtesy tone.
        movwf   ct2tone         ; kill off any pending courtesy tone.
        movf    mute1Tmr,f      ; check mute timer
        btfsc   STATUS,Z        ; if it's non-zero, skip unmute
        bsf     PORTB,RX12AUD   ; unmute rx1 into tx2
Rx101c  
        btfss   group1,1        ; is time out timer enabled?
        goto    Rx1End          ; nope...
        movlw   EETTMS          ; EEPROM address of timeout timer short preset.
        btfsc   group1,2        ; is short timeout selected
        movlw   EETTML          ; EEPROM address of timeout timer long preset.
        movwf   eeAddr          ; set EEPROM address low byte.
        PAGE3                   ; select code page 3.
        call    ReadEEw         ; read EEPROM.
        PAGE0                   ; select code page 0.
        movwf   rx1tout         ; set timeout counter
        goto    Rx1End          ; done here...
Rx1Rpt                          ; receiver active state
        btfss   group0,0        ; is repeater enabled?
        goto    Rx1OnOff        ; no.  turn receiver off
        btfss   flags,RX1USQ    ; is squelch open?
        goto    Rx1OnOff        ; no, on->off transition
        ;; check for priority
        movf    group0,w        ; get group 0 flags
        andwf   group2,w        ; and with group 2 flags
        andlw   b'11000000'     ; result is non-zero if linked.
        btfsc   STATUS,Z        ; are ports linked?
        goto    Rx1Rpt1         ; no.
        btfss   group3,5        ; does RX 2 have priority?
        goto    Rx1Rpt1         ; nope. ignore RX2 priority.
        movf    rx2stat,w       ; get RX 2 receiver state.
        sublw   RXSON           ; subtract ON state value.
        btfss   STATUS,Z        ; is result zero?
        goto    Rx1Rpt1         ; no.
        bsf     flags,RX1NOCT   ; yes. RX2 is on.  Kill RX1 and its CT.
        goto    Rx1OnOff        ; 
Rx1Rpt1 
        btfss   tFlags,ONESEC   ; one second tick?
        goto    Rx1End          ; nope, continue
        movf    rx1tout,f       ; squelch still open, check timeout timer
        btfsc   STATUS,Z        ; skip if not zero
        goto    Rx1End          ; timeout timer is zero, don't decrement
        decfsz  rx1tout,f       ; decrement the timeout timer
        goto    Rx1End          ; have not timed out (yet), continue
        ;; receiver has timed out.
        movlw   RXSTMO          ; get new state, timed out
        movwf   rx1stat         ; set new receiver state
        clrf    rx1tout         ; clear rx2 timeout timer
        btfss   group0,6        ; is rx1 into tx1 on?
        goto    Rx1to2          ; no.
        bcf     tx1flag,RX1TX   ; clear rx1 on bit
        bcf     PORTB,RX11AUD   ; mute rx1 -> tx1
        PAGE3                   ; select code page 3.
        movlw   CW_TO1          ; get CW timeout message.
        call    PlayCW1         ; play CW message.
        PAGE0                   ; select code page 1.
Rx1to2                          ; check rx2 -> tx1.
        btfss   group0,7        ; is rx1 into tx2 on?
        goto    Rx1End          ; no.
        bcf     tx2flag,RX1TX   ; clear rx1 on bit
        bcf     PORTB,RX12AUD   ; mute rx1 -> tx2
        PAGE3                   ; select code page 3.
        movlw   CW_TO1          ; get CW timeout message.
        call    PlayCW2         ; play CW message.
        PAGE0                   ; select code page 1.
        goto    Rx1End          ; done here...

Rx1OnOff                        ; receiver was active, became inactive
        call    Rcv1Off         ; turn off rx1.
        btfss   group0,6        ; is rx1 into tx1 on?
        goto    Rx110a          ; no.
        movlw   CTRX11          ; get CT number
        btfss   group4,6        ; is rx1 -> tx1 courtesy tone enabled.
        movlw   CTNONE          ; no CT.
        btfsc   flags,RX1NOCT   ; is CT suppressed? (priority)
        movlw   CTNONE          ; no CT.
        movwf   ct1tone         ; save the courtesy tone.
        call    SetCT1          ; start tx1 ct front porch timer
        call    SetHang1        ; start/restart the hang timer
        call    ChkID1          ; test if need an ID now

Rx110a                          ; look at rx1 into tx2 here.
        btfss   group0,7        ; is rx1 into tx2 on?
        goto    Rx1End          ; nope, done here.
        movlw   CTRX12          ; get CT number
        btfss   group5,6        ; is rx1 -> tx2 courtesy tone enabled.
        movlw   CTNONE          ; no CT.
        btfsc   flags,RX1NOCT   ; is CT suppressed?  (priority)
        movlw   CTNONE          ; no CT.
        movwf   ct2tone         ; save the courtesy tone.
        call    SetCT2          ; start tx2 ct front porch timer
        call    SetHang2        ; start/restart the hang timer
        call    ChkID2          ; test if need an ID now
        goto    Rx1End          ; done here...

Rx1Tmot                         ; receiver timedout state
        btfss   group0,0        ; is repeater enabled?
        goto    Rx1TEnd         ; no.  turn receiver off
        btfsc   flags,RX1USQ    ; is squelch still open?
        goto    Rx1End          ; yes, still timed out
Rx1TEnd                         ; end of timeout condition.
        movlw   RXSOFF          ; timeout condition ended, get new state (off)
        movwf   rx1stat         ; set new receiver state

        btfss   group0,6        ; is rx1 into tx1 on?
        goto    Rx1Toe2         ; no.
        PAGE3                   ; select code page 3.
        movlw   CW_TO1          ; get CW timeout message.
        call    PlayCW1         ; play CW message.
        PAGE0                   ; select code page 1.
Rx1Toe2                         ; now look at rx2 -> tx2.
        btfss   group0,7        ; is rx1 into tx2 on?
        goto    Rx1End          ; no.
        PAGE3                   ; select code page 3.
        movlw   CW_TO1          ; get CW timeout message.
        call    PlayCW2         ; play CW message.
        PAGE0                   ; select code page 1.
        goto    Rx1End          ; done here...

Rx1End                          ; done with RX1 processing.
        bcf     flags,RX1NOCT   ; clear NO CT flag

DoRx2                           ; process RX2 here.
        movlw   high Rx2Tbl     ; set high byte of address
        movwf   PCLATH          ; select page
        movf    rx2stat,w       ; get main receiver state
        addwf   PCL,f           ; add w to PCL:  computed GOTO
Rx2Tbl
        goto    Rx2Quiet        ; quiet
        goto    Rx2Rpt          ; repeat
        goto    Rx2Tmot         ; timeout

Rx2Quiet                        ; receiver quiet state
        btfss   flags,RX2USQ    ; is squelch open?
        goto    Rx2End          ; nope, don't turn receiver on
        ;; receiver is unsquelched; put it on the air
        ;; receiver inactive --> active transistion
        btfss   group2,0        ; is receiver enabled?
        goto    Rx2End          ; disabled, not gonna turn receiver on
        btfss   group2,3        ; is DTMF access mode enabled?
        goto    Rx2OffOn        ; no. start repeating.
        movf    dt2atmr,f       ; check DTMF access mode timer.
        btfsc   STATUS,Z        ; is it zero?
        goto    Rx2End          ; yes.  Don't turn receiver on.
        ;; timer is not zero, reset to initial value.
        movlw   EETDTA          ; get EEPROM address of DTMF access timer.
        movwf   eeAddr          ; set EEPROM address low byte.
        PAGE3                   ; select code page 3.
        call    ReadEEw         ; read EEPROM.
        PAGE0                   ; select code page 0.
        movwf   dt2atmr         ; set DTMF access mode timer.
Rx2OffOn                        ; receiver inactive --> active transition
        ;; check for priority
        movf    group0,w        ; get group 0 flags
        andwf   group2,w        ; and with group 2 flags
        andlw   b'11000000'     ; result is non-zero if linked.
        btfsc   STATUS,Z        ; are ports linked?
        goto    Rx201a          ; no.
        btfss   group1,5        ; does RX 1 have priority?
        goto    Rx201a          ; nope.
        movf    rx1stat,w       ; get RX 1 receiver state.
        sublw   RXSON           ; subtract ON state value.
        btfsc   STATUS,Z        ; is result zero?
        goto    Rx2End          ; yes.  RX 1 is ON. don't turn on RX2.
Rx201a
        movlw   RXSON           ; get new state #
        movwf   rx2stat         ; set new receiver state
        btfss   group2,6        ; is rx2 to tx1 enabled?
        goto    Rx201b          ; no.
        bsf     tx1flag,RX2TX   ; set rx2->tx1 tx on bit
        movlw   CTNONE          ; no courtesy tone.
        movwf   ct2tone         ; kill off any pending courtesy tone.
        movf    mute2Tmr,f      ; check mute timer
        btfsc   STATUS,Z        ; if it's non-zero, skip unmute
        bsf     PORTB,RX21AUD   ; unmute rx2 into tx1
Rx201b                          ; check rx2 into tx2 now.
        btfss   group2,7        ; is rx2 to tx2 enabled?
        goto    Rx201c          ; no.
        btfss   group5,5        ; is tx2 considered duplex?
        goto    Rx201c          ; no.
        bsf     tx2flag,RX2TX   ; set rx2->tx2 tx on bit
        movlw   CTNONE          ; no courtesy tone.
        movwf   ct2tone         ; kill off any pending courtesy tone.
        movf    mute2Tmr,f      ; check mute timer
        btfsc   STATUS,Z        ; if it's non-zero, skip unmute
        bsf     PORTB,RX22AUD   ; unmute rx2 into tx2
Rx201c  
        btfss   group3,1        ; is time out timer enabled?
        goto    Rx2End          ; nope...
        movlw   EETTMS          ; EEPROM address of timeout timer short preset.
        btfsc   group3,2        ; is short timeout selected
        movlw   EETTML          ; EEPROM address of timeout timer long preset.
        movwf   eeAddr          ; set EEPROM address low byte.
        PAGE3                   ; select code page 3.
        call    ReadEEw         ; read EEPROM.
        PAGE0                   ; select code page 0.
        movwf   rx2tout         ; set timeout counter
        goto    Rx2End          ; done here...
Rx2Rpt                          ; receiver active state
        btfss   group2,0        ; is receiver enabled?
        goto    Rx2OnOff        ; no.  turn receiver off
        btfss   flags,RX2USQ    ; is squelch open?
        goto    Rx2OnOff        ; no, on->off transition
        ;; check for priority
        movf    group0,w        ; get group 0 flags
        andwf   group2,w        ; and with group 2 flags
        andlw   b'11000000'     ; result is non-zero if linked.
        btfsc   STATUS,Z        ; are ports linked?
        goto    Rx2Rpt1         ; no.
        btfss   group1,5        ; does RX 1 have priority?
        goto    Rx2Rpt1         ; nope. ignore RX1 priority.
        movf    rx1stat,w       ; get RX 1 receiver state.
        sublw   RXSON           ; subtract ON state value.
        btfss   STATUS,Z        ; is result zero?
        goto    Rx2Rpt1         ; no.
        bsf     flags,RX2NOCT   ; yes. RX1 is on.  Kill RX2 and its CT.
        goto    Rx2OnOff        ; 
Rx2Rpt1
        btfss   tFlags,ONESEC   ; one second tick?
        goto    Rx2End          ; nope, continue
        movf    rx2tout,f       ; squelch still open, check timeout timer
        btfsc   STATUS,Z        ; skip if not zero
        goto    Rx2End          ; timeout timer is zero, don't decrement
        decfsz  rx2tout,f       ; decrement the timeout timer
        goto    Rx2End          ; have not timed out (yet), continue
        ;; receiver has timed out.
        movlw   RXSTMO          ; get new state, timed out
        movwf   rx2stat         ; set new receiver state
        clrf    rx2tout         ; clear rx2 timeout timer
        btfss   group2,6        ; is rx2 into tx1 on?
        goto    Rx2to2          ; no.
        bcf     tx1flag,RX2TX   ; clear rx2 on bit
        bcf     PORTB,RX21AUD   ; mute rx2 -> tx1
        PAGE3                   ; select code page 3.
        movlw   CW_TO2          ; get CW timeout message.
        call    PlayCW1         ; play CW message.
        PAGE0                   ; select code page 1.
Rx2to2                          ; check rx2 -> tx1.
        btfss   group2,7        ; is rx2 into tx2 on?
        goto    Rx2End          ; no.
        bcf     tx2flag,RX2TX   ; clear rx2 on bit
        bcf     PORTB,RX22AUD   ; mute rx2 -> tx2
        PAGE3                   ; select code page 3.
        movlw   CW_TO2          ; get CW timeout message.
        call    PlayCW2         ; play CW message.
        PAGE0                   ; select code page 1.
        goto    Rx2End          ; done here...

Rx2OnOff                        ; receiver was active, became inactive
        call    Rcv2Off         ; yes.  turn off rx2.
        btfss   group2,6        ; is rx2 into tx1 on?
        goto    Rx210a
        movlw   CTRX21          ; get CT number
        btfss   group4,7        ; is rx2 -> tx1 courtesy tone enabled.
        movlw   CTNONE          ; no CT.
        btfsc   flags,RX2NOCT   ; is CT suppressed? (priority)
        movlw   CTNONE          ; no CT.
        movwf   ct1tone         ; save the courtesy tone.
        call    SetCT1          ; start tx1 ct front porch timer
        call    SetHang1        ; start/restart the hang timer
        call    ChkID1          ; test if need an ID now

Rx210a                          ; look at rx2 into tx2 here.
        btfss   group2,7        ; is rx2 into tx2 on?
        goto    Rx2End          ; nope, done here.
        movlw   CTRX22          ; get CT number
        btfss   group5,7        ; is rx2 -> tx2 courtesy tone enabled.
        movlw   CTNONE          ; no CT.
        btfsc   flags,RX2NOCT   ; is CT suppressed? (priority)
        movlw   CTNONE          ; no CT.
        movwf   ct2tone         ; save the courtesy tone.
        call    SetCT2          ; start tx2 ct front porch timer
        call    SetHang2        ; start/restart the hang timer
        call    ChkID2          ; test if need an ID now
        goto    Rx2End          ; done here...

Rx2Tmot                         ; receiver timedout state
        btfss   group2,0        ; is receiver enabled?
        goto    Rx2TEnd         ; no.  turn receiver off
        btfsc   flags,RX2USQ    ; is squelch still open?
        goto    Rx2End          ; yes, still timed out
Rx2TEnd                         ; end of timeout condition.
        movlw   RXSOFF          ; timeout condition ended, get new state (off)
        movwf   rx2stat         ; set new receiver state

        btfss   group2,6        ; is rx2 into tx1 on?
        goto    Rx2Toe2         ; no.
        PAGE3                   ; select code page 3.
        movlw   CW_TO2          ; get CW timeout message.
        call    PlayCW1         ; play CW message.
        PAGE0                   ; select code page 1.
Rx2Toe2                         ; now look at rx2 -> tx2.
        btfss   group2,7        ; is rx2 into tx2 on?
        goto    Rx2End          ; no.
        PAGE3                   ; select code page 3.
        movlw   CW_TO2          ; get CW timeout message.
        call    PlayCW2         ; play CW message.
        PAGE0                   ; select code page 1.
        goto    Rx2End          ; done here...

Rx2End                          ; done with RX2 processing.
        bcf     flags,RX2NOCT   ; clear NO CT flag

; ********************
; * Timer processing *
; ********************
        
ChkTmrs                         ; check timers here.
        goto    Ck10mS          ; skip one ms timer.
        ;; start with one-millisecond timers
        btfss   tFlags,ONEMS    ; is one-millisecond bit set?
        goto    Ck10mS          ; nope.
        ;; one-millisecond tick active.
        
Ck10mS                          ; check 10 millisecond timers
        btfss   tFlags,TENMS    ; is ten-millisecond bit set?
        goto    Ck100mS         ; nope.
        ;; ten millisecond tick active.
        movf    pulsTmr,f       ; check for pulsed output
        btfsc   STATUS,Z        ; is it zero?
        goto    PulsEnd         ; yep.
        decfsz  pulsTmr,f       ; decrement and check for zero.
        goto    PulsEnd         ; not zero yet.
        ;; this is where the pulsed output gets turned off.
        swapf   group7,w        ; get group 7
        andwf   group7,w        ; and group 7
        xorlw   b'11111111'     ; invert result
        iorlw   b'11110000'     ; mask to protect bits 4-7
        andwf   group7,f        ; clear bits.
        swapf   group7,w        ; get group 7, swap nibbles.
        andlw   b'11110000'     ; clear unneeded bits.
        movwf   temp            ; save.
        movf    PORTD,w         ; get PORTD bits.
        andlw   b'00001111'     ; clear unneeded bits.
        iorwf   temp,w          ; set bits from group 7
        movwf   PORTD           ; put entire byte back to PORTD.

        btfss   group6,0        ; is digital output enabled?
        goto    PulsEnd         ; no
        btfss   group6,1        ; is digital output currently on?
        goto    PulsEnd         ; no
        btfss   group6,2        ; is pulsed mode selected?
        goto    PulsEnd         ; no
        bcf     group6,1        ; mark output off
        bcf     PORTA,FANCTL    ; turn off pulsed digital output.
PulsEnd                         ; done with digital output pulse logic

        ;; check chickenburst timer, tx0
        movf    cb1Tmr,f        ; check tx0 chicken burst timer
        btfsc   STATUS,Z        ; is it zero?
        goto    Chkn2           ; yep.
        decfsz  cb1Tmr,f        ; decrement the timer
        goto    Chkn2           ; not zero yet.
        bcf     PORTB,TX1PTT    ; turn off tx0 PTT!

Chkn2
        ;; check chickenburst timer, tx1
        movf    cb2Tmr,f        ; check tx1 chicken burst timer
        btfsc   STATUS,Z        ; is it zero?
        goto    ChknEnd         ; yep.
        decfsz  cb2Tmr,f        ; decrement the timer
        goto    ChknEnd         ; not zero yet.
        bcf     PORTB,TX2PTT    ; turn off tx1 PTT!
ChknEnd

        ;; now check tx1 ct front porch timer.
        movf    tx1ctd,f        ; check for tx1 ct front porch timer.
        btfsc   STATUS,Z        ; is it zero?
        goto    T1CTDE          ; yes.
        decfsz  tx1ctd,f        ; decrement and check for zero.
        goto    T1CTDE          ; not zero yet.
        ;; time to play the courtesy tone
        bcf     tx1flag,CTDELAY ; clear tx indicator.
        movf    tx1flag,w       ; get tx1flag
        andlw   b'00010000'     ; and tx1flag with CW indicator
        btfsc   STATUS,Z        ; is the result zero?
        goto    DoCT1           ; yes, ok to play CT.
        bsf     tx1flg2,DEF_CT  ; set defer CT flag.
        goto    T1CTDE          ; don't beep now.

DoCT1
        incf    ct1tone,w       ; check ct1tone for FF
        btfsc   STATUS,Z        ; is result 0?
        goto    T1CTDE          ; yes, ct1tone was FF.
        btfss   group3,3        ; using state number for ct number?
        goto    DoCT1A          ; no
        bsf     STATUS,RP0      ; set A7 for addresses 80-ff, 180-1ff
        movf    stateNo,w       ; get the last selected state number
        bcf     STATUS,RP0      ; clear A7 for addresses 00-7f, 100-17f
        goto    DoCT1B
DoCT1A
        movf    ct1tone,w       ; get courtesy tone.
        btfss   PORTD,CT4SEL    ; is CT select 4 input active (low)?
        movlw   CT4             ; yes, select courtesy tone 4.
        btfss   PORTD,CT5SEL    ; is CT select 5 input active (low)?
        movlw   CT5             ; yes, select courtesy tone 5.
        btfss   PORTD,CT6SEL    ; is CT select 6 input active (low)?
        movlw   CT6             ; yes, select courtesy tone 6.
DoCT1B  
        btfsc   dtRFlag,DT1UNLK ; is this port (main receiver) unlocked?
        movlw   CTUNLOK         ; get unlocked mode courtesy tone.
        movwf   ct1tone         ; yep. set unlocked courtesy tone.
        PAGE3                   ; select code page 3.
        call    PlayCT1         ; play courtesy tone #w
        PAGE0                   ; select code page 0.
        ;; end of tx1 ct processing...
T1CTDE                          ; done with tx1 ct front porch delay timer
        ;; now check tx2 ct front porch timer.
        movf    tx2ctd,f        ; check for tx1 ct front porch timer.
        btfsc   STATUS,Z        ; is it zero?
        goto    T2CTDE          ; yes.
        decfsz  tx2ctd,f        ; decrement and check for zero.
        goto    T2CTDE          ; not zero yet.
        ;; time to play the courtesy tone
        bcf     tx2flag,CTDELAY ; clear tx indicator.
        movf    tx2flag,w       ; get tx2flag
        andlw   b'00010000'     ; and tx2flag with CW indicator
        btfsc   STATUS,Z        ; is the result zero?
        goto    DoCT2           ; yes, ok to play CT.
        bsf     tx2flg2,DEF_CT  ; set defer CT flag.
        goto    T2CTDE          ; don't beep now.

DoCT2
        incf    ct2tone,w       ; check ct1tone for FF
        btfsc   STATUS,Z        ; is result 0?
        goto    T2CTDE          ; yes, ct1tone was FF.
        btfss   group3,3        ; using state number for ct number?
        goto    DoCT2A          ; no
        bsf     STATUS,RP0      ; set A7 for addresses 80-ff, 180-1ff
        movf    stateNo,w       ; get the last selected state number
        bcf     STATUS,RP0      ; clear A7 for addresses 00-7f, 100-17f
        goto    DoCT2B
DoCT2A
        movf    ct2tone,w       ; get courtesy tone.
        btfss   PORTD,CT4SEL    ; is CT select 4 input active (low)?
        movlw   CT4             ; yes, select courtesy tone 4.
        btfss   PORTD,CT5SEL    ; is CT select 5 input active (low)?
        movlw   CT5             ; yes, select courtesy tone 5.
        btfss   PORTD,CT6SEL    ; is CT select 6 input active (low)?
        movlw   CT6             ; yes, select courtesy tone 6.
DoCT2B
        btfsc   dtRFlag,DT2UNLK ; is this port (main receiver) unlocked?
        movlw   CTUNLOK         ; get unlocked mode courtesy tone.
        movwf   ct2tone         ; yep. set unlocked courtesy tone.
        PAGE3                   ; select code page 3.
        call    PlayCT2         ; play courtesy tone #w
        PAGE0                   ; select code page 0.
        ;; end of tx2 ct processing...
T2CTDE                          ; done with tx2 ct front porch delay timer
        
Ck100mS                         ; check 100 millisecond tick.
        btfss   tFlags,HUNDMS   ; is 100 millisecond bit set?
        goto    Ck1S            ; nope.
        ;; 100 millisecond tick active.

        ;; check hang timer1
        movf    hang1tmr,f      ; check hang timer
        btfsc   STATUS,Z        ; is it zero?
        goto    NoHang1         ; yes, not hang active, continue
        decfsz  hang1tmr,f      ; decrement and check if now zero
        goto    NoHang1         ; not zero
        ;; end of hang time.
        bcf     tx1flag,HANG    ; turn off hang time flag
NoHang1

        ;; check hang timer2
        movf    hang2tmr,f      ; check hang timer
        btfsc   STATUS,Z        ; is it zero?
        goto    NoHang2         ; yes, not hang active, continue
        decfsz  hang2tmr,f      ; decrement and check if now zero
        goto    NoHang2         ; not zero
        ;; end of hang time.
        bcf     tx2flag,HANG    ; turn off hang time flag
NoHang2                         ; done with hang timers..
        
        ;; process DTMF-1 muting timer...
        movf    mute1Tmr,f      ; test mute timer
        btfsc   STATUS,Z        ; Z is set if not DTMF muting
        goto    NoMutTm1        ; mute1Tmr is zero.
        decfsz  mute1Tmr,f      ; decrement mute1Tmr
        goto    NoMutTm1        ; have not reached the end of the mute time
        btfsc   tx1flag,RX1TX   ; is rx1 -> tx1 turned on?
        bsf     PORTB,RX11AUD   ; unmute rx1 -> tx1.
        btfsc   tx2flag,RX1TX   ; is rx1 -> tx2 turned on?
        bsf     PORTB,RX12AUD   ; unmute rx1 -> tx2.
NoMutTm1                        ; done with muting 1 timer...

        ;; process DTMF-2 muting timer...
        movf    mute2Tmr,f      ; test mute timer
        btfsc   STATUS,Z        ; Z is set if not DTMF muting
        goto    NoMutTm2        ; mute1Tmr is zero.
        decfsz  mute2Tmr,f      ; decrement mute1Tmr
        goto    NoMutTm2        ; have not reached the end of the mute time
        btfsc   tx1flag,RX2TX   ; is rx2 -> tx1 turned on?
        bsf     PORTB,RX21AUD   ; unmute rx1 -> tx1.
        btfsc   tx2flag,RX2TX   ; is rx2 -> tx2 turned on.
        bsf     PORTB,RX22AUD   ; unmute rx1 -> tx2.
NoMutTm2                        ; done with muting 1 timer...
        
Ck1S                            ; check 1-second flag bit.
        btfss   tFlags,ONESEC   ; is one-second flag bit set?
        goto    Ck10S           ; nope.
        ;; 1-second tick active.
        ;; check rx1 unlocked mode timer.
        movf    ulk1Tmr,f       ; check ulk1Tmr
        btfsc   STATUS,Z        ; is it zero?
        goto    NoUL1Tmr        ; yes, don't worry about it.
        decfsz  ulk1Tmr,f       ; no, decrement it.
        goto    NoUL1Tmr        ; still not zero.
        ;; ulk1Tmr counted down to zero, lock controller.
        bcf     dtRFlag,DT1UNLK ; lock port 1
NoUL1Tmr                        ; end of unlocked timer 1.
        
        ;; check rx2 unlocked mode timer.
        movf    ulk2Tmr,f       ; check ulk1Tmr
        btfsc   STATUS,Z        ; is it zero?
        goto    NoUL2Tmr        ; yes, don't worry about it.
        decfsz  ulk2Tmr,f       ; no, decrement it.
        goto    NoUL2Tmr        ; still not zero.
        ;; ulk1Tmr counted down to zero, lock controller.
        bcf     dtRFlag,DT2UNLK ; lock port 2
NoUL2Tmr                        ; end of unlocked timer 2.

Ck10S                           ; check 10-second tick flag bit.
        btfss   tFlags,TENSEC   ; is ten-second flag bit set?
        goto    NoTimr          ; nope.  no more timers to test.
        ;; check ID timer for tx1
        movf    id1tmr,f        ; check id1tmr
        btfsc   STATUS,Z        ; is id1tmr 0
        goto    NoID1Tmr        ; yes...
        decfsz  id1tmr,f        ; decrement ID timer
        goto    NoID1Tmr                ; not zero yet...
        call    DoID1           ; id timer decremented to zero, play the ID
NoID1Tmr                        ; process more 10 second timers here...
        ;; check ID timer for tx1
        movf    id2tmr,f        ; check id2tmr
        btfsc   STATUS,Z        ; is id2tmr 0
        goto    NoID2Tmr        ; yes...
        decfsz  id2tmr,f        ; decrement ID timer
        goto    NoID2Tmr        ; not zero yet...
        call    DoID2           ; id timer decremented to zero, play the ID
NoID2Tmr                        ; process more 10 second timers here...
        
        movf    fanTmr,f        ; check fan timer
        btfsc   STATUS,Z        ; is it zero?
        goto    NoFanTm         ; yes.
        btfsc   group6,0        ; fan mode configured?
        goto    NoFanTm         ; no
        decfsz  fanTmr,f        ; decrement fan timer
        goto    NoFanTm         ; not zero yet
        bcf     PORTA,FANCTL    ; turn off fan
NoFanTm

        ;; check DTMF access mode timer for rx1
        movf    dt1atmr,f       ; check DTMF access timer.
        btfsc   STATUS,Z        ; is it zero?
        goto    NoDTATm1        ; yes
        decfsz  dt1atmr,f       ; decrement DTMF access timer
        goto    NoDTATm1        ; not zero yet.
        ;; jeff, is something supposed to happen here?
        nop
NoDTATm1
        
        ;; check DTMF access mode timer for rx1
        movf    dt2atmr,f       ; check DTMF access timer.
        btfsc   STATUS,Z        ; is it zero?
        goto    NoDTATm2        ; yes
        decfsz  dt2atmr,f       ; decrement DTMF access timer
        goto    NoDTATm2        ; not zero yet.
        ;; jeff, is something supposed to happen here?
        nop
NoDTATm2
        
        bsf     STATUS,RP0      ; set A7 for addresses 80-ff, 180-1ff
        movf    alrmTmr,f       ; check alarm timer.
        btfsc   STATUS,Z        ; is it zero?
        goto    NoAlmTm         ; yes
        decfsz  alrmTmr,f       ; decrement alarm timer
        goto    NoAlmTm         ; not zero yet.
        bcf     STATUS,RP0      ; clear A7 for addresses 0-7f, 100-17f
        movlw   EETALM          ; get EEPROM address of alarm timer preset.
        movwf   eeAddr          ; set EEPROM address low byte.
        PAGE3                   ; select code page 3.
        call    ReadEEw         ; read EEPROM.
        PAGE0                   ; select code page 0.
        bsf     STATUS,RP0      ; set A7 for addresses 80-ff, 180-1ff
        movwf   alrmTmr         ; preset alarm timer.
        bcf     STATUS,RP0      ; clear A7 for addresses 0-7f, 100-17f
        btfss   group4,0        ; is transmitter 1 enabled?
        goto    NoAlTx1         ; no.
        movlw   BP_ALM          ; get alarm beep tone.
        PAGE3                   ; select code page 3.
        call    PlayCTx1        ; play courtesy tone #w, Tx1.
        PAGE0                   ; select code page 0.
NoAlTx1
        btfss   group5,0        ; is transmitter 2 enabled?
        goto    NoAlmTm         ; no.
        movlw   BP_ALM          ; get alarm beep tone.
        PAGE3                   ; select code page 3.
        call    PlayCTx2        ; play courtesy tone #w, Tx2.
        PAGE0                   ; select code page 0.
NoAlmTm                         ; done with alarm timer.
        bcf     STATUS,RP0      ; clear A7 for addresses 0-7f, 100-17f
        
NoTimr                          ; no more timers to test.
        
ChkTx1                          ; check if transmitter 1 should be on
        btfsc   group6,6        ; chicken-burst mode TX1?
        goto    ChkTx1A         ; yes.  don't do encode control here.
        
        btfsc   group0,4        ; encode tone for RX1 -> TX1 ?
        goto    CkTx1aa         ; yes.
        btfss   group2,4        ; encode tone for RX2 -> TX1 ?
        goto    ChkTx1A         ; no.
CkTx1aa
        clrf    temp            ; encoder enable flag.
        btfss   group0,4        ; encode tone for RX1->TX1?
        goto    CkT1a           ; no.
        btfsc   tx1flag,RX1TX   ; is receiver 1 active?
        bsf     temp,0          ; yes, set flag to encode.
CkT1a
        btfss   group2,4        ; encode tone for RX2->TX1?
        goto    CkT1b           ; no.
        btfsc   tx1flag,RX2TX   ; is receiver 2 active?
        bsf     temp,0          ; yes, set flag to encode.
CkT1b   
        btfsc   temp,0          ; is flag set?
        bsf     PORTD,TX1ENC    ; yes, turn on encoder.
        btfss   temp,0          ; is flag clear?
        bcf     PORTD,TX1ENC    ; yes, turn off encoder.
ChkTx1A
        movf    tx1flag,f       ; check tx1flag
        btfsc   STATUS,Z        ; skip if not zero
        goto    ChkTx10         ; it's zero, turn off transmitter
        btfsc   tx1flg2,TXONFLG ; skip if not already on
        goto    ChkTx1E         ; done here
        PAGE3                   ; select code page 1.
        call    Tx1On           ; turn on transmitter (will set TXONFLG)
        PAGE0                   ; select code page 0.
        goto    ChkTx1E         ; now done here.
        
ChkTx10
        btfss   tx1flg2,TXONFLG ; skip if tx is on
        goto    ChkTx1E         ; was already off
        PAGE3                   ; select code page 1.
        call    Tx1Off          ; turn off PTT
        PAGE0                   ; select code page 0.
ChkTx1E                         ; end of ChkTx

ChkTx2                          ; check if transmitter 2 should be on
        btfsc   group6,7        ; chicken-burst mode TX2?
        goto    ChkTx2A         ; yes.  don't do encode control here.

        btfsc   group0,5        ; encode tone for RX1 -> TX2 ?
        goto    CkTx2aa         ; yes.
        btfss   group2,5        ; encode tone for RX2 -> TX2 ?
        goto    ChkTx2A         ; no.
CkTx2aa
        
        clrf    temp            ; encoder enable flag.
        btfss   group0,5        ; encode tone for RX1->TX2?
        goto    CkT2a           ; no.
        btfsc   tx2flag,RX1TX   ; is receiver 1 active?
        bsf     temp,0          ; yes, set flag to encode.
CkT2a
        btfss   group2,5        ; encode tone for RX2->TX2?
        goto    CkT2b           ; no.
        btfsc   tx2flag,RX2TX   ; is receiver 2 active?
        bsf     temp,0          ; yes, set flag to encode.
CkT2b   
        btfsc   temp,0          ; is flag set?
        bsf     PORTD,TX2ENC    ; yes, turn on encoder.
        btfss   temp,0          ; is flag clear?
        bcf     PORTD,TX2ENC    ; yes, turn off encoder.
ChkTx2A
        movf    tx2flag,f       ; check tx2flag
        btfsc   STATUS,Z        ; skip if not zero
        goto    ChkTx20         ; it's zero, turn off transmitter
        btfsc   tx2flg2,TXONFLG ; skip if not already on
        goto    ChkTx2E         ; done here
        PAGE3                   ; select code page 1.
        call    Tx2On           ; turn on transmitter (will set TXONFLG)
        PAGE0                   ; select code page 0.
        goto    ChkTx2E         ; now done here.
        
ChkTx20
        btfss   tx2flg2,TXONFLG ; skip if tx is on
        goto    ChkTx2E         ; was already off
        PAGE3                   ; select code page 1.
        call    Tx2Off          ; turn off PTT
        PAGE0                   ; select code page 0.
ChkTx2E                         ; end of ChkTx

; ******************************
; ** CW SENDER, transmitter 1 ** 
; ******************************
CWSendr1
        btfss   tx1flag,CWPLAY  ; sending CW?
        goto    NoCW1           ; nope

        btfss   tFlags,ONEMS    ; is this a one-ms tick?
        goto    NoCW1           ; nope.

        decfsz  cw1tbtmr,f      ; decrement CW timebase counter
        goto    NoCW1           ; not zero yet.

        movf    cw1spd,w        ; get cw timebase preset.
        movwf   cw1tbtmr        ; preset CW timebase.

        decfsz  cw1tmr,f        ; decrement CW element timer
        goto    NoCW1           ; not zero

        btfss   tx1flg2,CWBEEP  ; was "key" down? 
        goto    CWKeyUp1        ; nope
                                ; key was down
        bcf     tx1flg2,CWBEEP  ; 
        ; turn off beep here.
        clrw                    ; clear W.
        PAGE3                   ; select code page 3.
        call    SetTone1        ; set the beep tone up.
        PAGE0                   ; select code page 0.
        decf    cw1byte,w       ; test CW byte to see if 1
        btfsc   STATUS,Z        ; was it 1 (Z set if cw1byte == 1)
        goto    CWNext1         ; it was 1...
        movlw   CWIESP          ; get cw inter-element space
        movwf   cw1tmr          ; preset cw timer
        goto    NoCW1           ; done with this pass...

CWNext1                         ; get next character of message
        PAGE3                   ; select code page 1.
        call    GtBeep1         ; get the next cw character
        PAGE0                   ; select code page 0.
        movwf   cw1byte         ; store character bitmap
        btfsc   STATUS,Z        ; is this a space (zero)
        goto    CWWord1         ; yes, it is 00
        incf    cw1byte,w       ; check to see if it is FF
        btfsc   STATUS,Z        ; if this bitmap was FF then Z will be set
        goto    CWDone1         ; yes, it is FF
        movlw   CWILSP          ; no, not 00 or FF, inter letter space
        movwf   cw1tmr          ; preset cw timer
        goto    NoCW1           ; done with this pass...

CWWord1                         ; word space
        movlw   CWIWSP          ; get word space
        movwf   cw1tmr          ; preset cw timer
        goto    NoCW1           ; done with this pass...

CWKeyUp1                        ; key was up, key again...
        incf    cw1byte,w       ; is cw1byte == ff?
        btfsc   STATUS,Z        ; Z is set if cw1byte == ff
        goto    CWDone1         ; got EOM

        movf    cw1byte,f       ; check for zero/word space
        btfss   STATUS,Z        ; is it zero
        goto    CWTest1         ; no...
        goto    CWNext1         ; is 00, word space...

CWTest1
        movlw   CWDIT           ; get dit length
        btfsc   cw1byte,0       ; check low bit
        movlw   CWDAH           ; get DAH length
        movwf   cw1tmr          ; preset cw timer
        bsf     tx1flg2,CWBEEP  ; turn key->down
        movf    cw1tone,w       ; get CW tone
        ;; turn on beep here.
        PAGE3                   ; select code page 3.
        call    SetTone1        ; set the beep tone up.
        PAGE0                   ; select code page 0.
        rrf     cw1byte,f       ; rotate cw bitmap
        bcf     cw1byte,7       ; clear the MSB
        goto    NoCW1           ; done with this pass...

CWDone1                         ; done sending CW
        bcf     tx1flag,CWPLAY  ; turn off CW flag
        clrf    beep1ctl        ; clear beep control flags
        btfss   tx1flg2,DEF_CT  ; is the deferred CT set?
        goto    NoCW1           ; nope.
        bcf     tx1flg2,DEF_CT  ; clear deferred beep flag.
        incf    ct1tone,w       ; check ct1tone for FF
        btfsc   STATUS,Z        ; is result 0?
        goto    NoCW1           ; yes, ct1tone was FF.
        movf    ct1tone,w       ; get courtesy tone.
        btfsc   dtRFlag,DT1UNLK ; is this port (main receiver) unlocked?
        movlw   CTUNLOK         ; get unlocked mode courtesy tone.
        movwf   ct1tone         ; yep. set unlocked courtesy tone.
        PAGE3                   ; select code page 3.
        call    PlayCT1         ; play courtesy tone #w
        PAGE0                   ; select code page 0.

NoCW1

; ******************************
; ** CW SENDER, transmitter 2 ** 
; ******************************
CWSendr2
        btfss   tx2flag,CWPLAY  ; sending CW?
        goto    NoCW2           ; nope

        btfss   tFlags,ONEMS    ; is this a one-ms tick?
        goto    NoCW2           ; nope.

        decfsz  cw2tbtmr,f      ; decrement CW timebase counter
        goto    NoCW2           ; not zero yet.

        movf    cw2spd,w        ; get cw timebase preset.
        movwf   cw2tbtmr        ; preset CW timebase.

        decfsz  cw2tmr,f        ; decrement CW element timer
        goto    NoCW2           ; not zero

        btfss   tx2flg2,CWBEEP  ; was "key" down? 
        goto    CWKeyUp2        ; nope
                                ; key was down
        bcf     tx2flg2,CWBEEP  ; 
        ; turn off beep here.
        clrw                    ; clear W.
        PAGE3                   ; select code page 3.
        call    SetTone2        ; set the beep tone up.
        PAGE0                   ; select code page 0.
        decf    cw2byte,w       ; test CW byte to see if 1
        btfsc   STATUS,Z        ; was it 1 (Z set if cw1byte == 1)
        goto    CWNext2         ; it was 1...
        movlw   CWIESP          ; get cw inter-element space
        movwf   cw2tmr          ; preset cw timer
        goto    NoCW2           ; done with this pass...

CWNext2                         ; get next character of message
        PAGE3                   ; select code page 1.
        call    GtBeep2         ; get the next cw character
        PAGE0                   ; select code page 0.
        movwf   cw2byte         ; store character bitmap
        btfsc   STATUS,Z        ; is this a space (zero)
        goto    CWWord2         ; yes, it is 00
        incf    cw2byte,w       ; check to see if it is FF
        btfsc   STATUS,Z        ; if this bitmap was FF then Z will be set
        goto    CWDone2         ; yes, it is FF
        movlw   CWILSP          ; no, not 00 or FF, inter letter space
        movwf   cw2tmr          ; preset cw timer
        goto    NoCW2           ; done with this pass...

CWWord2                         ; word space
        movlw   CWIWSP          ; get word space
        movwf   cw2tmr          ; preset cw timer
        goto    NoCW2           ; done with this pass...

CWKeyUp2                        ; key was up, key again...
        incf    cw2byte,w       ; is cw1byte == ff?
        btfsc   STATUS,Z        ; Z is set if cw1byte == ff
        goto    CWDone2         ; got EOM

        movf    cw2byte,f       ; check for zero/word space
        btfss   STATUS,Z        ; is it zero
        goto    CWTest2         ; no...
        goto    CWNext2         ; is 00, word space...

CWTest2
        movlw   CWDIT           ; get dit length
        btfsc   cw2byte,0       ; check low bit
        movlw   CWDAH           ; get DAH length
        movwf   cw2tmr          ; preset cw timer
        bsf     tx2flg2,CWBEEP  ; turn key->down
        movf    cw2tone,w       ; get CW tone
        ;; turn on beep here.
        PAGE3                   ; select code page 3.
        call    SetTone2        ; set the beep tone up.
        PAGE0                   ; select code page 0.
        rrf     cw2byte,f       ; rotate cw bitmap
        bcf     cw2byte,7       ; clear the MSB
        goto    NoCW2           ; done with this pass...
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
