nhrc-net/NHRC_Repeater_Controllers/nhrc-2.1/sw/nhrc-3_1.asm

        ;; NHRC-3.1 Repeater Controller.
        ;; Copyright 1996 - 2010 NHRC LLC,
        ;; as an unpublished proprietry work.
        ;; All rights reserved.
        ;; No part of this document may be used or reproduced by any means,
        ;; for any purpose, without the expressed written consent of NHRC LLC.

        ;; V 0.01 15 March 2009 Initial port from NHRC-3 Plus code
        ;; V 0.02 02 January 2010 ISD is working!
        ;; V 0.03 04 January 2010 simplex working, sort of, serial enabled.
        ;; V 0.11 28 September 2010 8 message expansion.
        ;; V 0.20 21 November 2010 two tail messages
        ;; V 0.90 24 November 2010 functionally complete (I think)
        ;; V 0.92 05 January 2011 5 saved setups, turn off failsafe clock
        ;; v 0.93 06 January 2011 simplex message works with timeout timer.
        ;;                        erase simplex msg on state change to simplex
        ;;                        CTCSS control op mode works right now.
        ;; v 0.94 07 January 2011 simplex message length fixed
        ;; v 0.95 08 January 2011 simplex message in slots 5-9, 90 sec max
        ;; v 0.96 09 January 2011 normal IDs toggle correctly
        ;; v 0.97 09 January 2011 euro ID mode end speech ID works now.
        ;; v 0.98 11 January 2011 reprogram unlock code.
        ;; v 0.99 11 January 2011 digital outputs port 5 bits 0 and 1
        ;; v 1.00 02 June 2011 bump version to 1.00
        ;; v 1.01 15 July 2011 version 1.01 NHRC-2.1 support
        ;; v 1.02 07 May 2011 Version 1.02 NHRC-2.1 fixes

        ;; NOTE: when updating the version, search this file for
        ;; CW version data
        
VERS1   equ     h'3e'           ; 1
VERS2   equ     h'3f'           ; 0
VERS3   equ     h'3c'           ; 2
                        
LOAD_EE=1
;NHRC3_1=1               ; set in NHRC-3.1 build Project->Build Options->Project->MPASM Macro Definitions

        ERRORLEVEL 0, -302,-306 ; suppress Argument out of range errors

        IFDEF __16F886
        include "p16f886.inc"

        IFDEF __MPLAB_DEBUGGER_ICD2
        __CONFIG _CONFIG1, _PWRTE_ON & _FCMEN_OFF & _XT_OSC & _LVP_OFF & _CP_OFF & _WDT_OFF
        ELSE
        __CONFIG _CONFIG1, _PWRTE_ON & _FCMEN_OFF & _XT_OSC & _LVP_OFF & _CP_ON
        ENDIF                   ; __MPLAB_DEBUGGER_ICD2
        ELSE
        ERROR THIS PROCESSOR IS NOT SUPPORTED
        ENDIF                   ; __16F886
        
        include "eeprom.inc"

;macro definitions for ROM paging.
        
PAGE0   macro                   ; select page 0
        bcf     PCLATH,3
        bcf     PCLATH,4
        endm

PAGE1   macro                   ; select page 1
        bsf     PCLATH,3
        bcf     PCLATH,4
        endm

PAGE2   macro                   ; select page 2
        bcf     PCLATH,3
        bsf     PCLATH,4
        endm

PAGE3   macro                   ; select page 3
        bsf     PCLATH,3
        bsf     PCLATH,4
        endm

        IFDEF DEBUG
TEN     equ     D'4'            ; decade counter.
        ELSE
TEN     equ     D'10'           ; decade counter.
        ENDIF

        
        ;; ISD command queue commands
        ;; bit 7 6 5 4 3 2 1 0
        ;;     0 0 c c c c c c send command c:
        ;;     0 1 m m m m m m play message    m
        ;;     1 0 m m m m m m erase message   m
        ;;     1 1 m m m m m m record message  m
        ;;
        ;;  commands are:
        ;;     c = 0 0 0 0 0 0  = 0 invalid!
        ;;     c = 0 0 0 0 0 1  = 1 STOP
        ;;     c = 0 0 0 0 1 0  = 2 RESET
        ;;     c = 0 0 0 0 1 1  = 3 CLR_INT (will I need this from here?)
        ;;     c = 0 0 0 1 0 0  = 4 RD_STATUS
        ;;     c = 0 0 0 1 0 1  = 5 DEVID read
        ;;     c = 0 0 0 1 1 0  = 6 G_ERASE
        ;;     c = 0 0 0 1 1 1  = 7 WR_APC2 (set APC)
        ;;     c = 0 0 1 0 0 0  = 8 PU
        ;;     c = 1 d d d d d  = delay d (0-31) * 10 ms before next operation

IDLY50  equ     b'00100101'     ; delay 5  =  50 ms
IDLY60  equ     b'00100110'     ; delay 6  =  60 ms
IDLY100 equ     b'00101010'     ; delay 10 = 100 ms
IDLY200 equ     b'00110100'     ; delay 20 = 200 ms
IDLY250 equ     b'00111001'     ; delay 25 = 250 ms
ICMDPL  equ     b'01000000'     ; is mask, or in message number
ICMDREC equ     b'11000000'     ; is mask
ICMDDEL equ     b'10000000'     ; is mask
ICMDBAD equ     b'00000000'     ; invalid! bad!
ICMDST  equ     b'00000001'     ; stop
ICMDRST equ     b'00000010'     ; reset
ICMDCLI equ     b'00000011'     ; clear interrupt
ICMDRDS equ     b'00000100'     ; read status
ICMDDID equ     b'00000101'     ; read devid
ICMDGER equ     b'00000110'     ; G_erase
ICMDWAP equ     b'00000111'     ; write APC2 
ICMDPU  equ     b'00001000'     ; power up
        
        ;; ISD commands, reversed bit patterns
        ;; LED sets bit4, reversed is bit3
ISDPU   equ     b'10000000'     ; PU        - 0x01 - 2 byte command
ISDSTOP equ     b'01000000'     ; STOP      - 0x02 - 2 byte command -- int
ISDRST  equ     b'11000000'     ; RESET     - 0x03 - 2 byte command
ISDCINT equ     b'00100000'     ; CLR_INT   - 0x04 - 2 byte command
ISDSTS  equ     b'10100000'     ; RD_STATUS - 0x05 - 2 byte command
ISDPD   equ     b'11100000'     ; PD        - 0x07 - 2 byte command
ISDDID  equ     b'10010000'     ; DEVID     - 0x09 - 3 byte command
ISDGER  equ     b'11001010'     ; G_ERASE   - 0x43 - 2 byte command -- int
ISDWAPC equ     b'10100110'     ; WR_APC2   - 0x65 - 3 byte command
ISDPLAY equ     b'00001001'     ; SET PLAY  - 0x80 - 7 byte command -- int
ISDREC  equ     b'10001001'     ; SET REC   - 0x81 - 7 byte command -- int
ISDERAS equ     b'01001001'     ; SET ERASE - 0x82 - 7 byte command -- int

        ;; APC values configured for max volume
        ;; record from analog in
        ;; analog in always passed
        ;; analog output in AUX mode (voltage output)
        ;; pwm speaker disabled
        ;; analog output powered up
        ;; vAlert disabled
        ;; EOM stops playback
xPC07   equ     b'00010101'     ; APC register bits 0-7
APC07   equ     b'00011111'     ; APC register bits 0-7
        ;;        1xxxxxxx      ; D0 VOL0
        ;;        x1xxxxxx      ; D1 VOL1  -- max is 000
        ;;        xx1xxxxx      ; D2 VOL2 
        ;;        xxx1xxxx      ; D3 monitor during recording
        ;;        xxxx1xxx      ; D4 mix mic input 
        ;;        xxxxx1xx      ; D5 sound effects disable
        ;;        xxxxxx1x      ; D6 feed through disable
        ;;        xxxxxxx1      ; D7 analog outupt AUX mode
APC811  equ     b'10110000'     ; APC register bits 8-11 and 4 fill 0s
        ;;        1xxxxxxx      ; PWM Speaker power down
        ;;        x1xxxxxx      ; analog output power down
        ;;        xx1xxxxx      ; vAlert disable 
        ;;        xxx1xxxx      ; EOM stops playback enable

; *************************
; ** IO Port Assignments **
; *************************

; PORTA
DTMFQ1  equ     0               ; input, DTMF decoder Q1
DTMFQ2  equ     1               ; input, DTMF decoder Q2
DTMFQ3  equ     2               ; input, DTMF decoder Q3
DTMFQ4  equ     3               ; input, DTMF decoder Q4
RX0AUD  equ     4               ; output, audio mute, muted when high.
INIT    equ     4               ; output, audio mute, muted when high.
DTMF_DV equ     5               ; input, DTMF digit valid when high.

; PORTB
FANCTL  equ     0               ; output, fan control/digital output.
RX0COR  equ     1               ; input, COR
ISDSEL  equ     2               ; output, ISD Slave Select not.
ISDINT  equ     3               ; input, ISD interrupt.
CTSEL1  equ     4               ; input, courtesy tone selection.
CTSEL2  equ     5               ; input, courtesy tone selection.
ALARMIN equ     5               ; alarm input bit
OUT1    equ     6               ; digital output 1.
OUT2    equ     7               ; digital output 2.

; PORTC
TX0PTT  equ     0               ; output, PTT when high.
BEEP    equ     1               ; PWM output, beep tone source.
RX0PL   equ     2               ; input, CTCSS present when low.
;       equ     3               ; SPI clock
;       equ     4               ; MISO
;       equ     5               ; MOSI
;       equ     6               ; serial TX
;       equ     7               ; serial RX


; *******************
; ** Control Flags **
; *******************
        
;tFlags                         ; timer flags  
TICK    equ     0               ; TICK indicator
ONEMS   equ     1               ; 1 ms tick flag
TENMS   equ     2               ; 10 ms tick flag
HUNDMS  equ     3               ; 100 ms tick flag
ONESEC  equ     4               ; 1 second tick flag
TENSEC  equ     5               ; 10 second flag...
; niy   equ     6               ; NIY
CWBEEP  equ     7               ; cw beep is on.
        
;flags
initID  equ     0               ; need to ID now
needID  equ     1               ; need to send ID
IDNOW   equ     2               ; ID is running now.
TXONFLG equ     3               ; last TX state flag
CMD_NIB equ     4               ; command interpreter nibble flag for copy
DEF_CT  equ     5               ; deferred courtesy tone.
DEF_ID  equ     6               ; deferred ID message.
LAST_DV equ     7               ; last DTMF digit valid.

;mscFlag                        ; misc flags...
DT0ZERO equ     0               ; dtmf-0 last received 0
; NIY   equ     1               ; NIY
LITZDT0 equ     2               ; LiTZ on DTMF-0
IDTOGL  equ     3               ; ID2 flag.  used to alternate ID messages.
TAIL2F  equ     4               ; tail 2 flag1. used to alternate tail messages.
ALARMED equ     5               ; alarmed!
CTCSS0  equ     6               ; last CTCSS on main receiver
SC_RDY  equ     7               ; serial command is ready.

; txFlag
RX0OPEN equ     0               ; main receiver repeating
; NIY   equ     1               ; NIY
TXHANG  equ     2               ; hang time
; NIY   equ     3               ; NIY
; NIY   equ     4               ; NIY
TALKING equ     5               ; ISD playing back
BEEPING equ     6               ; beep tone active
CWPLAY  equ     7               ; CW playing


CWTBDLY equ     d'60'           ; CW timebase delay for 20 WPM.

; isdFlag
ISDRUNF equ     0               ; isd running flag
ISDRECF equ     1               ; isd recording flag.
ISDRECR equ     2               ; isd record flag. record next keyup.
ISDERS  equ     3               ; isd is erasing
ISDTEST equ     5               ; isd test mode
ISDZAPS equ     6               ; delete simplex message flag.
ISDRECE equ     7               ; isd record ERROR: message overflow

;; ismpcf -- ISD state machine processor control flag
ISMWAIT equ     0               ; wait for isdtmr countdown 
ISMWINT equ     1               ; wait for ISD interrupt
ISMERAS equ     7               ; erase cannot be interrupted!
        
;; COR debounce time
COR1DEB equ     5               ; 5 ms.  COR off to on debounce time
COR0DEB equ     5               ; 5 ms.  COR on to off debounce time
COR0DBS equ     50              ; 50 ms. COR on to off debounce time, simplex
DLY1DEB equ     d'100'          ; 100 ms. COR off->on debounce time, with DAD.
DLY0DEB equ     d'50'           ; 50 ms.  COR on->off debounce time, with DAD.
CHNKDEB equ     d'250'          ; 250 ms.

IDSOON  equ     D'6'            ; ID soon, polite IDer threshold, 60 sec
MUTEDLY equ     D'20'           ; DTMF muting timer = 2.0 sec.
DTMFDLY equ     d'50'           ; DTMF activity timer = 5.0 sec.
LITZTIM equ     d'20'           ; 5.0-3.0=2.0 time left on DTMF timer for LITZ
UNLKDLY equ     d'120'          ; unlocked mode timer.
        
; dtRFlag -- dtmf sequence received indicator
DT0RDY  equ     0               ; some sequence received on DTMF-0
DT1RDY  equ     1               ; some sequence received on DTMF-1
DT2RDY  equ     2               ; some sequence received on DTMF-2
DTUL    equ     3               ; command received from unlocked port.
DTSEVAL equ     4               ; dtmf command evaluation in progress.
DT0UNLK equ     5               ; unlocked indicator
DT1UNLK equ     6               ; unlocked indicator
DT2UNLK equ     7               ; unlocked indicator
                ;; 
;dtEFlag -- DTMF command evaluator control flag.
        ;; low order 5 bits indicate next prefix number/user command to scan
DT0CMD  equ     5               ; received this command from dtmf0
DT1CMD  equ     6               ; received this command from dtmf1
DT2CMD  equ     7               ; received this command from dtmf2

; beepCtl -- beeper control flags...
B_ADR0  equ     0               ; beep or CW addressing mode indicator
B_ADR1  equ     1               ; beep or CW addressing mode indicator
                                ;   00 EEPROM
                                ;   01 lookup table index, built in messages.
                                ;   10 Raw RAM address
                                ;   11 Direct from DTMF buffer.
                                ; 
B_BEEP  equ     2               ; beep sequence in progress
B_CW    equ     3               ; CW transmission in progress
;NIY    equ     4               ; 
;NIY    equ     5               ; 
B_LAST  equ     6               ; last segment of CT tones.
;NIY    equ     7               ; 

; beepCtl preset masks
BEEP_CT equ     b'10000100'     ; CT from EEPROM
BEEP_CX equ     b'10000101'     ; CT from ROM table
CW_ROM  equ     b'10001001'     ; CW from ROM table
CW_EE   equ     b'10001000'     ; CW from EEPROM

CTPAUSE equ     d'5'            ; 50 msec pause before CT.

PULS_TM equ     d'50'           ; 50 x 10 ms = 500 ms.  pulse duration time.
        
; receiver states
RXSOFF  equ     0
RXSON   equ     1
RXSTMO  equ     2
RXSREC  equ     3               ; record with rptr disabled. new for 1.04
RXSOFON equ     4               ; receiver is active but repeater disabled,
                                ; new feature for 1.12
         
; cTone Courtesy tone selections
CTNONE  equ     h'ff'           ; no courtesy tone.
CT0     equ     0               ; normal courtesy tone
CT1     equ     1               ; 
CT2     equ     2               ; 
CT3     equ     3               ; 
CTSP1   equ     4               ; 
CTSP2   equ     5               ; unused courtesy tone
CTSP3   equ     6               ; unused courtesy tone
CTUNLOK equ     7               ; unlocked courtesy tone

; Voice message numbers.
	IFDEF NHRC3_1
VINITID equ     0               ; initial ID.
VNORMID equ     1               ; normal ID.
VNORMI2 equ     2               ; normal ID.
VTIMOUT equ     3               ; timeout message.
VTAIL   equ     4               ; tail message.
VCTONE  equ     4               ; courtesy tone message.
VTAIL2  equ     5               ; tail message.
VALARM  equ     6               ; alarm track
VTEST   equ     7               ; test track
VSIMPLX equ     5               ; simplex message is 5-7 (~90 sec)
VLAST   equ     7               ; last valid message number
	ELSE
VINITID equ     0               ; initial ID.
VNORMID equ     1               ; normal ID.
VTIMOUT equ     2               ; timeout message.
VTAIL   equ     3               ; tail message.
VCTONE  equ     3               ; courtesy tone message.
VSIMPLX equ     1               ; simplex message is 1-3 (~30 sec)
VLAST   equ     3               ; last valid message number
	ENDIF

; 
; CW Message indexes into table at MesgTabl
;
CW_OK   equ     h'00'           ; CW: OK
CW_ERR  equ     h'03'           ; CW: ERR
CW_TO   equ     h'07'           ; CW: TO
CW_ON   equ     h'0a'           ; CW: ON
CW_OFF  equ     h'0d'           ; CW: OFF
CWHELLO equ     h'11'           ; CW: powerup message.
        
;
; CW sender constants
;
CWDIT   equ     1               ; dit length in 100 ms
CWDAH   equ     CWDIT * 3       ; dah 
CWIESP  equ     CWDIT           ; inter-element space
CWILSP  equ     CWDAH           ; inter-letter space
CWIWSP  equ     CWDIT * 7       ; inter-word space

T0PRE   equ     D'37'           ; timer 0 preset for overflow in 224 counts.

;
; Serial control constants
;
SCATTN  equ     h'3a'           ; attention character, :
        
SCREAD  equ     h'52'           ; read command R
SCWRITE equ     h'57'           ; write command W
SCTERM  equ     h'0d'           ; command terminator <CR>
SCACK   equ     h'4b'           ; ACK message K
SCNAK   equ     h'4e'           ; NAK message N
SCCR    equ     h'0d'           ; CR
SCLF    equ     h'0a'           ; LF


; ***************
; ** VARIABLES **
; ***************
        cblock  h'20'           ; 1st block of RAM at 20h-7fh (96 bytes here)
        ;; interrupt pseudo-stack to save context during interrupt processing.
        s_copy                  ; 20 saved STATUS
        p_copy                  ; 21 saved PCLATH
        f_copy                  ; 22 saved FSR
        i_temp                  ; 23 temp for interrupt handler
        ;; internal timing generation
        tFlags                  ; 24 Timer Flags
        oneMsC                  ; 25 one millisecond counter
        tenMsC                  ; 26 ten milliseconds counter
        hundMsC                 ; 26 hundred milliseconds counter
        thouMsC                 ; 28 thousand milliseconds counter (1 sec)

        temp                    ; 29 working storage. don't use in int handler.
        temp2                   ; 2a more working storage
        temp3                   ; 2b still more temporary storage
        temp4                   ; 2c yet still more temporary storage
        temp5                   ; 2d temporary storage...
        temp6                   ; 2e temporary storage...
        cmdSize                 ; 2f # digits received for current command
        ;; operating flags
        flags                   ; 30 operating Flags
        mscFlag                 ; 31 misc. flags.
        txFlag                  ; 32 Transmitter control flag
        rxFlag                  ; 33 Receiver COS valid flags
        isdFlag                 ; 34 ISD control flag.
        ;; beep generator control 
        beepTmr                 ; 35 timer for generating various beeps
        beepAddr                ; 36 address for various beepings, low byte.
        beepCtl                 ; 37 beeping control flag
        ;; debounce timers
        rx0Dbc                  ; 38 main receiver debounce timer
        ;; receiver states
        rx0Stat                 ; 39 main receiver state
        ;; timers
        rx0TOut                 ; 3a main receiver timeout timer, in seconds
        idTmr                   ; 3b id timer, in 10 seconds
        hangTmr                 ; 3c hang timer, in tenths.
        muteTmr                 ; 3d DTMF muting timer, in tenths.
        lMutTmr                 ; 3e link muting timer, in tenths.
        dtATmr                  ; 3f dtmf access timer
        fanTmr                  ; 40 fan timer
        tailCtr                 ; 41 tail message counter.
        unlkTmr                 ; 42 unlocked mode timer.
        pulsTmr                 ; 43 pulse timer.
        ;; timer presets
        hangDly                 ; 44 hang timer preset, keep it handy.
        ;; CW generator data
        cwTmr                   ; 45 CW element timer
        cwByte                  ; 46 CW current byte (bitmap)
        cwTbTmr                 ; 47 CW timebase timer
        cwTone                  ; 48 CW tone
        cwSpeed                 ; 49 CW Speed
        
        cTone                   ; 4a courtesy tone to play

        eeAddr                  ; 4b EEPROM address (low byte) to read/write
        eeCount                 ; 4c number of bytes to read/write from EEPROM
        ;; control operator control flag groups
        group0                  ; 4d group 0 flags
        group1                  ; 4e group 1 flags
        group2                  ; 4f group 2 flags
        group3                  ; 50 group 3 flags
        group4                  ; 51 group 4 flags
        group5                  ; 52 group 5 flags
        group6                  ; 53 group 6 flags
        group7                  ; 54 group 7 flags
        ;; ISD control variables
        isdDly                  ; 55 isd command delay timer...
        isdMsg                  ; 56 isd message number...
        isdRMsg                 ; 57 isd RECORD message number...
        sr0lo                   ; 58 isd SR0 register lo byte
        sr0hi                   ; 59 isd SR0 register hi byte
        sr1lo                   ; 5a isd SR1 register lo byte
        isdDvId                 ; 5b isd device ID
        isdS1                   ; 5c isd start address first byte
        isdS2                   ; 5d isd start address 2nd byte
        isdE1                   ; 5e isd end address 1st byte
        isdE2                   ; 5f isd end address 2nd byte
        isdCmd                  ; 60 isd command byte
        ismpcf                  ; 61 isd state machine process control flags
        alrmTmr                 ; 62 alarm announce timer.

        ;; last var at 0x6f there are 14 left in this block...
        
        endc                    ; this block ends at 6f

        cblock  h'70'           ; from 70 to 7f is common to all banks!
        rICD70                  ; 70 reserved for ICD2
        w_copy                  ; 71 saved W register for interrupt handler
        dt0Ptr                  ; 72 DTMF-0 buffer pointer
        dt0Tmr                  ; 73 DTMF-0 buffer timer
        dtRFlag                 ; 74 DTMF receive flag...
        dtEFlag                 ; 75 DTMF command interpreter control flag
        eebPtr                  ; 76 eebuf write pointer.
        scratch                 ; 77 scratchpad. (not currently used.)
        txHead                  ; 78 serial transmitter buffer head.
        txTail                  ; 79 serial transmitter buffer tail.
        rxHead                  ; 7a serial receiver buffer head.
        rxTail                  ; 7b serial receiver buffer tail.
        isdcbh                  ; 7c isd command buffer head
        isdcbt                  ; 7c isd command buffer tail
        endc                    ; 1st RAM block ends at 7f

        cblock  h'a0'           ; 2nd block of RAM at a0h-efh (80 bytes here)
        ;; 32 bytes serial transmit buffer
        txBuf00                 ; a0
        txBuf01                 ; a1
        txBuf02                 ; a2
        txBuf03                 ; a3
        txBuf04                 ; a4
        txBuf05                 ; a5
        txBuf06                 ; a6
        txBuf07                 ; a7
        txBuf08                 ; a8
        txBuf09                 ; a9
        txBuf0a                 ; aa
        txBuf0b                 ; ab
        txBuf0c                 ; ac
        txBuf0d                 ; ad
        txBuf0e                 ; ae
        txBuf0f                 ; af
        txBuf10                 ; b0
        txBuf11                 ; b1
        txBuf12                 ; b2
        txBuf13                 ; b3
        txBuf14                 ; b4
        txBuf15                 ; b5
        txBuf16                 ; b6
        txBuf17                 ; b7
        txBuf18                 ; b8
        txBuf19                 ; b9
        txBuf1a                 ; ba
        txBuf1b                 ; bb
        txBuf1c                 ; bc
        txBuf1d                 ; bd
        txBuf1e                 ; be
        txBuf1f                 ; bf
        ;; 32 bytes serial receive buffer
        rxBuf00                 ; c0
        rxBuf01                 ; c1
        rxBuf02                 ; c2
        rxBuf03                 ; c3
        rxBuf04                 ; c4
        rxBuf05                 ; c5
        rxBuf06                 ; c6
        rxBuf07                 ; c7
        rxBuf08                 ; c8
        rxBuf09                 ; c9
        rxBuf0a                 ; ca
        rxBuf0b                 ; cb
        rxBuf0c                 ; cc
        rxBuf0d                 ; cd
        rxBuf0e                 ; ce
        rxBuf0f                 ; cf
        rxBuf10                 ; d0
        rxBuf11                 ; d1
        rxBuf12                 ; d2
        rxBuf13                 ; d3
        rxBuf14                 ; d4
        rxBuf15                 ; d5
        rxBuf16                 ; d6
        rxBuf17                 ; d7
        rxBuf18                 ; d8
        rxBuf19                 ; d9
        rxBuf1a                 ; da
        rxBuf1b                 ; db
        rxBuf1c                 ; dc
        rxBuf1d                 ; dd
        rxBuf1e                 ; de
        rxBuf1f                 ; df
        ;; 8 bytes isd commands queue
        isdcb00                 ; e0
        isdcb01                 ; e1
        isdcb02                 ; e2
        isdcb03                 ; e3
        isdcb04                 ; e4
        isdcb05                 ; e5
        isdcb06                 ; e6
        isdcb07                 ; e7
        endc
        
        cblock  h'f0'           ; this is really common with 70-7f
        rsvdf0                  ; f0  reserve these 16 bytes
        rsvdf1                  ; f1  reserve these 16 bytes
        rsvdf2                  ; f2  reserve these 16 bytes
        rsvdf3                  ; f3  reserve these 16 bytes
        rsvdf4                  ; f4  reserve these 16 bytes
        rsvdf5                  ; f5  reserve these 16 bytes
        rsvdf6                  ; f6  reserve these 16 bytes
        rsvdf7                  ; f7  reserve these 16 bytes
        rsvdf8                  ; f8  reserve these 16 bytes
        rsvdf9                  ; f9  reserve these 16 bytes
        rsvdfa                  ; fa  reserve these 16 bytes
        rsvdfb                  ; fb  reserve these 16 bytes
        rsvdfc                  ; fc  reserve these 16 bytes
        rsvdfd                  ; fd  reserve these 16 bytes
        rsvdfe                  ; fe  reserve these 16 bytes
        rsvdff                  ; ff  reserve these 16 bytes
        endc                    ; 2nd RAM block ends at ff

        ;; 16c77 ram blocks continue...
        cblock  h'110'          ; 16 bytes at 110h-11fh
        endc
        
        cblock  h'120'          ; 80 bytes 120h-16fh
        dt0buf0                 ; DTMF-0 receiver buffer (16 bytes) @ 120
        dt0buf1
        dt0buf2
        dt0buf3
        dt0buf4
        dt0buf5
        dt0buf6
        dt0buf7
        dt0buf8
        dt0buf9
        dt0bufa
        dt0bufb
        dt0bufc
        dt0bufd
        dt0bufe
        dt0buff
        endc

        cblock  h'130'          ; eeprom write buffer (16 bytes) @ 130
        eebuf00                 ; eeprom write buffer (16 bytes) @ 130
        eebuf01
        eebuf02
        eebuf03
        eebuf04
        eebuf05
        eebuf06
        eebuf07
        eebuf08
        eebuf09
        eebuf0a
        eebuf0b
        eebuf0c
        eebuf0d
        eebuf0e
        eebuf0f
        endc

        cblock  h'165'          ; reserved for ICD2
        rICD165                 ; reserved for ICD2
        rICD166                 ; reserved for ICD2
        rICD167                 ; reserved for ICD2
        rICD168                 ; reserved for ICD2
        rICD169                 ; reserved for ICD2
        rICD16a                 ; reserved for ICD2
        rICD16b                 ; reserved for ICD2
        rICD16c                 ; reserved for ICD2
        rICD16d                 ; reserved for ICD2
        rICD16e                 ; reserved for ICD2
        rICD16f                 ; reserved for ICD2
        endc
        
        cblock  h'170'          ; this is common with 70-7f
        rsvd170                 ; reserve these 16 bytes
        rsvd171                 ; reserve these 16 bytes
        rsvd172                 ; reserve these 16 bytes
        rsvd173                 ; reserve these 16 bytes
        rsvd174                 ; reserve these 16 bytes
        rsvd175                 ; reserve these 16 bytes
        rsvd176                 ; reserve these 16 bytes
        rsvd177                 ; reserve these 16 bytes
        rsvd178                 ; reserve these 16 bytes
        rsvd179                 ; reserve these 16 bytes
        rsvd17a                 ; reserve these 16 bytes
        rsvd17b                 ; reserve these 16 bytes
        rsvd17c                 ; reserve these 16 bytes
        rsvd17d                 ; reserve these 16 bytes
        rsvd17e                 ; reserve these 16 bytes
        rsvd17f                 ; reserve these 16 bytes
        endc                    ; 3nd RAM block ends at 17f
        
        ;; cblock       h'190'  ; 16 bytes at 190h-19fh
        ;; endc
        cblock  h'1a0'          ; 80 bytes 1a0h-1efh
        cmdbf00                 ; command buffer  @1a0
        cmdbf01                 ; command buffer
        cmdbf02                 ; command buffer
        cmdbf03                 ; command buffer
        cmdbf04                 ; command buffer
        cmdbf05                 ; command buffer
        cmdbf06                 ; command buffer
        cmdbf07                 ; command buffer
        cmdbf08                 ; command buffer
        cmdbf09                 ; command buffer
        cmdbf0a                 ; command buffer
        cmdbf0b                 ; command buffer
        cmdbf0c                 ; command buffer
        cmdbf0d                 ; command buffer
        cmdbf0e                 ; command buffer
        cmdbf0f                 ; command buffer  @1af (16 bytes)
        cmdbf10                 ; command buffer  @1b0
        cmdbf11                 ; command buffer
        cmdbf12                 ; command buffer
        cmdbf13                 ; command buffer
        cmdbf14                 ; command buffer
        cmdbf15                 ; command buffer
        cmdbf16                 ; command buffer
        cmdbf17                 ; command buffer
        cmdbf18                 ; command buffer
        cmdbf19                 ; command buffer
        cmdbf1a                 ; command buffer
        cmdbf1b                 ; command buffer
        cmdbf1c                 ; command buffer
        cmdbf1d                 ; command buffer
        cmdbf1e                 ; command buffer
        cmdbf1f                 ; command buffer @1bf (32 bytes)
        endc                    ; end of block @ 1bf


        cblock  h'1f0'          ; this is common with 70-7f
        rsvd1f0                 ; reserve these 16 bytes
        rsvd1f1                 ; reserve these 16 bytes
        rsvd1f2                 ; reserve these 16 bytes
        rsvd1f3                 ; reserve these 16 bytes
        rsvd1f4                 ; reserve these 16 bytes
        rsvd1f5                 ; reserve these 16 bytes
        rsvd1f6                 ; reserve these 16 bytes
        rsvd1f7                 ; reserve these 16 bytes
        rsvd1f8                 ; reserve these 16 bytes
        rsvd1f9                 ; reserve these 16 bytes
        rsvd1fa                 ; reserve these 16 bytes
        rsvd1fb                 ; reserve these 16 bytes
        rsvd1fc                 ; reserve these 16 bytes
        rsvd1fd                 ; reserve these 16 bytes
        rsvd1fe                 ; reserve these 16 bytes
        rsvd1ff                 ; reserve these 16 bytes
        endc                    ; 3nd RAM block ends at 1ff
        
; ********************
; ** STARTUP VECTOR **
; ********************
        org     0               ; startup vector
        clrf    PCLATH          ; stay in bank 0
        goto    Start

; ***********************
; ** INTERRUPT HANDLER **
; ***********************
IntHndlr
        org     4               ; interrupt vector
        ; preserve registers...
        movwf   w_copy          ; save w register
        swapf   STATUS,w        ; get STATUS
        clrf    STATUS          ; force bank 0
        movwf   s_copy          ; save STATUS
        movf    PCLATH,w        ; get PCLATH
        movwf   p_copy          ; save PCLATH
        clrf    PCLATH          ; force page 0
        bsf     STATUS,IRP      ; select RAM bank 1
        movf    FSR,w           ; get FSR
        movwf   f_copy          ; save FSR
        
TimrInt
        btfss   INTCON,T0IF     ; is it a timer interrupt?
        goto    CompInt         ; no
        movlw   T0PRE           ; get timer 0 preset value
        movwf   TMR0            ; preset timer 0
        bsf     tFlags,TICK     ; set tick indicator flag
        bcf     INTCON,T0IF     ; clear RTCC int mask

CompInt                         ; timer 1 compare match interrupt.
        btfss   PIR1,CCP1IF     ; is it a compare interrupt?
        goto    EEWrInt         ; no.
        clrf    TMR1L           ; clear timer 1
        clrf    TMR1H           ; clear timer 1
        bcf     PIR1,CCP1IF     ; clear compare match interrupt bit.
        btfss   PORTC,BEEP      ; is beep bit hi?
        goto    CompInL         ; no.
        bcf     PORTC,BEEP      ; lower beep bit.
        goto    EEWrInt         ; done.
CompInL                         ; beep bit was low.
        bsf     PORTC,BEEP      ; raise beep bit.

EEWrInt
        btfss   PIR1,EEIF       ; EE Write Complete interrupt?
        goto    SRcvInt         ; no.
        bcf     PIR1,EEIF       ; yes, clear interrupt bit.

SRcvInt                         ; Serial Receive Interrupt.
        btfss   PIR1,RCIF       ; serial receive interrupt?
        goto    SXmtInt         ; no.
        
        movf    rxHead,w        ; get head of buffer pointer.
        addlw   LOW rxBuf00     ; add to buffer base address.
        movwf   FSR             ; set FSR as pointer
        movf    RCREG,w         ; get received char.
        bcf     STATUS,IRP      ; select 00-FF range for FSR/INDF
        movwf   INDF            ; put char into buffer

        incf    rxHead,w        ; increment pointer.
        andlw   h'1f'           ; mask so result stays in 0-31 range.
        movwf   rxHead          ; save pointer.

        movf    INDF,w          ; get received character back.
        sublw   SCATTN          ; subtract CI-V preamble character.
        btfsc   STATUS,Z        ; skip if non-zero.
        clrf    rxHead          ; preamble.  Reset to start of buffer.

        movf    INDF,w          ; get received character back.
        sublw   SCTERM          ; subtract CI-V EOM character.
        btfsc   STATUS,Z        ; skip if non-zero.
        bsf     mscFlag,SC_RDY  ; end of message received, ready to process.

SXmtInt                         ; Serial Transmit Interrupt.
        btfss   PIR1,TXIF       ; serial transmit Interrupt?
        goto    IntExit         ; no.

        movf    txTail,w        ; get tail pointer.
        subwf   txHead,w        ; subtract from head pointer.
        btfsc   STATUS,Z        ; result should be non-zero if buffer no
        goto    UTIntD          ; buffer is empty.
        incf    txTail,w        ; get pointer + 1.
        andlw   h'1f'           ; mask so result stays in 0-31 range.
        movwf   txTail          ; save it...
        addlw   LOW txBuf00     ; add to buffer base address.
        movwf   FSR             ; set FSR as pointer.
        bcf     STATUS,IRP      ; select 00-FF range for FSR/INDF
        movf    INDF,w          ; get char.
        bsf     STATUS,IRP      ; select 100-1FF range for FSR/INDF
        movwf   TXREG           ; send char.
        goto    IntExit         ; done here.
        
UTIntD                          ; no more chars to transmit.
        ;; turn off the transmitter interrupt.
        bsf     STATUS,RP0      ; select bank 1
        bcf     PIE1,TXIE       ; turn off the transmitter interrupt.
        bcf     STATUS,RP0      ; select bank 1
        ;; goto IntExit         ; done here.
        
IntExit
        movf    p_copy,w        ; get PCLATH preserved value
        movwf   PCLATH          ; restore PCLATH
        movf    f_copy,w        ; get FSR preserved value
        movwf   FSR             ; restore FSR
        swapf   s_copy,w        ; get STATUS preserved value
        movwf   STATUS          ; restore STATUS
        swapf   w_copy,f        ; swap W
        swapf   w_copy,w        ; restore W
        retfie

;
; Play the appropriate ID message, reset ID timers & flags
;
DoID
        ;; euro ID mode change... ID forever, part 1
        btfsc   group3,0        ; euro ID mode?
        goto    DoIDEu          ; yep.
        btfsc   group3,5        ; ID Beacon Mode?
        goto    DoIDEu          ; yep.
        btfsc   flags,DEF_ID    ; deferred ID wanted?
        goto    DoIDEu          ; yes.
        btfss   flags,needID    ; need to ID?
        return                  ; nope--id timer expired without tx since last

        btfsc   group1,6        ; in simplex mode?
        goto    DoIDS           ; yes.
        
DoIDEu
        ;; check to see if ID is currently playing.
        btfsc   flags,IDNOW     ; is the ID playing already?
        return                  ; yes.  Don't start to ID again.
        
        ;; play the ID here.
        btfss   txFlag,RX0OPEN  ; is the receiver active?
        goto    DoIDQ           ; no, it is quiet.
        btfss   group3,6        ; is NO CW ID mode selected?
        goto    DoIDCW          ; no, and actively repeating, play CW ID.
        bsf     flags,DEF_ID    ; set deferred ID flag.
        return                  ; bail out for now.

DoIDQ
        ;; not actively repeating (nobody talking), ok to play voice ID
        btfsc   flags,DEF_ID    ; deferred ID wanted?
        goto    DoIDNor         ; yes.  Play NORMAL voice ID.

        btfsc   flags,initID    ; initial ID wanted?
        goto    DoIDInt         ; yep.
        
DoIDNor
        movf    group2,w        ; get group2 flags
        andlw   b'00000110'     ; mask, either normal ID
        btfss   STATUS,Z        ; is result zero?
        goto    DoIDNCW         ; 
        btfss   group3,6        ; is NO CW ID mode selected?
        goto    DoIDCW          ; yes. do CW ID.
DoIDNCW                         ; NOT doing CW ID
	IFDEF NHRC3_1
        xorlw   b'00000110'     ; are they both on?
        btfss   STATUS,Z        ; are they both on?
        goto    IdNoTog         ; no.
        ;; both ID messages are enabled.  alternate them.
        btfss   mscFlag,IDTOGL  ; toggle bit set?
        goto    IdNoAlt         ; nope
        bcf     mscFlag,IDTOGL  ; clear toggle bit
        movlw   VNORMI2         ; no.  get normal ID message2.
        ELSE
        btfss   group2,1        ; is normal ID 1 enabled?
        goto    DoIDCW          ; no.  send CW ID.
        movlw   VNORMID         ; NHRC-2.1 -- get normal ID message.
        ENDIF
        goto    DoIDSpc         ; play ID message

IdNoAlt
        bsf     mscFlag,IDTOGL  
        movlw   VNORMID         ; no.  get normal ID message.
        goto    DoIDSpc         ; play ID message

IdNoTog                         ; not alternating IDs.
        movlw   VNORMID         ; get normal ID the first
        IFDEF NHRC3_1
        btfsc   group2,2        ; normal ID 2 enabled?
        movlw   VNORMI2         ; get normal ID the second
        ENDIF
        goto    DoIDSpc         ; play it

DoIDS                           ; simplex mode ID message.
        btfss   group1,7        ; simplex mode voice ID requested?
        goto    DoIDCW          ; no.  Play CW ID.
        movlw   VINITID         ; get initial ID
        goto    DoIDSpc         ; play speech ID.
        
DoIDInt                         ; play initial ID
        btfsc   group3,6        ; is NO CW ID mode selected?
        goto    DoIDI1          ; yes.
        btfss   group2,0        ; is initial speech ID enabled?
        goto    DoIDCW          ; not enabled, play CW.
DoIDI1
        movlw   VINITID         ; get initial ID
        ;; 1.06 changes for improved Euro mode ID
        goto    DoIDSpc         ; play speech ID.

        
DoIDSpc                         ; play speech ID
        ;; 1.08 changes for suppressed ID...
        btfsc   group3,7        ; is NO ID mode set?
        goto    DoIDrst         ; yes.  NO ID mode is set.  Don't ID.
        ;; end 1.08 changes.
        ;; 1.06 changes for improved Euro mode ID
        btfsc   flags,IDNOW     ; is the ID playing already?
        return                  ; yes.  don't do it again
        bsf     flags,IDNOW     ; set IDing now flag.
        ;; end 1.06 changes
        call    NewPlay
        goto    DoIDrst

DoIDCW                          ; play CW id.
        ;; 1.08 changes for suppressed ID...
        btfsc   group3,7        ; is NO ID mode set?
        goto    DoIDrst         ; yes.  NO ID mode is set.  Don't ID.
        ;; end 1.08 changes.
        ;; 1.06 changes for improved Euro mode ID
        btfsc   flags,IDNOW     ; is the ID playing already?
        return                  ; yes.  don't do it again
        bsf     flags,IDNOW     ; set IDing now flag.
        ;; end 1.06 changes
        PAGE3                   ; select code page 3.
        movlw   EECWID          ; address of CW ID message in EEPROM.
        movwf   eeAddr          ; save CT base address
        call    PlayCWe         ; kick off the CW playback.
        PAGE0                   ; select code page 0.
        
DoIDrst                         ; reset ID timer & logic.
        movlw   EETID           ; get EEPROM address of ID timer preset.
        movwf   eeAddr          ; set EEPROM address low byte.
        PAGE3                   ; select code page 3.
        call    ReadEEw         ; read EEPROM.
        PAGE0                   ; select code page 0.
        movwf   idTmr           ; store to idTmr down-counter
        bcf     flags,initID    ; clear initial ID flag
        
        movf    txFlag,w        ; get tx flags
        andlw   h'01'           ; w=w&RX0OPEN, non zero if RX active.
        btfsc   STATUS,Z        ; is it zero?
        bcf     flags,needID    ; yes. reset needID flag.
        return

Rcv0Off                         ; turn off receiver 0
        movlw   RXSOFF          ; get new state #
        movwf   rx0Stat         ; set new receiver state
        bsf     PORTA,RX0AUD    ; mute it...
        bcf     txFlag,RX0OPEN  ; clear main receiver on bit
        clrf    rx0TOut         ; clear main receiver timeout timer
        return
        
SetHang                         ; start hang timer...
        btfss   group0,3        ; is hang timer enabled?
        return                  ; nope.
        movlw   EETHTS          ; get EEPROM address of hang timer short preset
        btfsc   group0,4        ; is long hang timer selected?
        movlw   EETHTL          ; get EEPROM address of hang timer long preset
        movwf   eeAddr          ; set EEPROM address low byte.
        PAGE3                   ; select code page 3.
        call    ReadEEw         ; read EEPROM.
        PAGE0                   ; select code page 0.
        movwf   hangDly         ; save this in hangDly, used often.
        movwf   hangTmr         ; preset hang timer
        btfss   STATUS,Z        ; don't hang if hang timer is 0.
        bsf     txFlag,TXHANG   ; set hang time transmit flag
        return                  ; done.

ChkID                           ; call on receiver drop to see if want to ID
        btfsc   flags,initID    ; is the initial ID wanted?
        goto    ChkID1          ; yes, play the ID
        btfsc   flags,DEF_ID    ; is the deferred ID wanted?
        goto    ChkID1          ; yes, play the ID.
        btfss   flags,needID    ; need to ID sometime?
        return                  ; nope.
        ;
        ;if (idTmr <= IDSOON then goto StartID
        ;implemented as: if ((IDSOON-idTimer)>=0) then ID
        ;
        movf    idTmr,w         ; get idTmr into W
        sublw   IDSOON          ; IDSOON-w ->w
        btfsc   STATUS,C        ; C is clear if result is negative
ChkID1
        call    DoID            ; ok to ID now, let's do it.
        return                  ; don't need to ID yet...

; ***************************************************
; ** DoTail -- Play Tail Message and Reset Counter **
; ***************************************************

DoTail
        IFDEF NHRC3_1
        movf    group1,w        ; get group1 flags
        andlw   b'00110000'     ; mask, either normal ID
        btfsc   STATUS,Z        ; is result zero? (none enabled)
        goto    ResetTC         ; reset the counter
        xorlw   b'00110000'     ; are they both on?
        btfss   STATUS,Z        ; are they both on?
        goto    TailNTg         ; no.
        ;; both ID messages are enabled.  alternate them.
        btfss   mscFlag,TAIL2F  ; toggle bit set?
        goto    TlNoAlt         ; nope
        bcf     mscFlag,TAIL2F  ; clear toggle bit
        movlw   VTAIL2          ; use tail message 2.
        goto    PlayTl          ; play ID message

TlNoAlt
        bsf     mscFlag,TAIL2F  
        movlw   VTAIL           ; use tail message 1.
        goto    PlayTl          ; play ID message

TailNTg                         ; not toggling tail messages
        movlw   VTAIL           ; get tail message 1
        btfsc   group1,4        ; is tail 1 enabled?
        goto    PlayTl          ; yes it is.  use it.
        movlw   VTAIL2          ; get tail message 2
        btfss   group1,5        ; is tail 2 enabled?
        goto    ResetTC         ; no.  should never get here.  handle anyway.
        ELSE
        btfss   group1,4        ; is tail 1 enabled?
        goto    ResetTC         ; it is not.  Don't play a tail message.
        movlw   VTAIL           ; get tail message 1
        ENDIF
        
PlayTl  
        call    NewPlay         ; play ISD Message

ResetTC 
        ;; now, reset tail message counter.
        movlw   EETTAIL         ; get EEPROM address of tail message counter.
        movwf   eeAddr          ; set EEPROM address low byte.
        PAGE3                   ; select code page 3.
        call    ReadEEw         ; read EEPROM.
        PAGE0                   ; select code page 0.
        movwf   tailCtr         ; preset tail message counter.
        return                  ; done with tail message.
        
        ;; **************************************************
        ;; **************************************************
        ;; **************************************************

; *************
; ** Init256 **
; *************
Init256                         ; initialize 256 bytes from the 32 in cmdbuf00
        movlw   d'8'            ; 8 * 32 = 256. 
        movwf   temp2           ; store into temp.
        movlw   d'32'           ; 32 bytes to write each cycle.
        movwf   eeCount         ; save eeCount:  number of bytes to write.
I256a                           ; loop through writes of 32 bytes.
        movlw   low cmdbf00     ; get base of buffer
        movwf   FSR             ; set into FSR.
        PAGE3                   ; select ROM code page 3.
        call    WriteEE         ; write into EEPROM.
        PAGE0                   ; select ROM code page 0.
        ;; pause while EE operation completes.
        call    InitPos         ; pause.
        movlw   d'32'           ; get size.
        addwf   eeAddr,f        ; add to address.
        movwf   eeCount         ; reset number of bytes to write.
        decfsz  temp2,f         ; decrement cycle count.
        goto    I256a           ; next cycle.
        return                  ; done.
        
; *************
; ** InitPos **
; *************
InitPos                         ; short pause for EEPROM write cycle.
        movlw   d'20'           ; 20 ms.
        call    InitDly         ; delay.
        movlw   d'19'           ; 19 ms.
        call    InitDly         ; delay.
        return                  ; done with pause

; *************
; ** InitDly **
; *************
InitDly                         ; delay w ms for init code.
        movwf   temp6           ; counter.
InitDl2
        btfss   tFlags,TICK     ; looking for 1 ms TICK
        goto    InitDl2         ; loop.
        bcf     tFlags,TICK     ; clear TICK marker.
        clrwdt                  ; reset WDT every ms.
        decfsz  temp6,f         ; decrement counter
        goto    InitDl2         ; counter not zeroed yet.
        return
        
; *********************
; ** PROGRAM STARTUP **
; *********************
        org     0200
Start
        bsf     STATUS,RP0      ; select bank 1

        movlw   b'00000000'     ; turn off A/D
        movwf   ADCON0
        movlw   b'00000111'
        movwf   ADCON1

        movlw   b'01111000'     ;
        movwf   OSCCON          ; set for external clock
        movlw   b'00000001'     ; RBPU pull ups 
                                ; INTEDG INT on falling edge
                                ; T0CS   TMR0 uses instruction clock
                                ; T0SE  n/a
                                ; PSA TMR0 gets the prescaler 
                                ; PS2 \
                                ; PS1  > prescaler 4
                                ; PS0 /
        movwf   OPTION_REG      ; set options

        ;; SPI setup
        movlw   b'11000000'     ; SMP=1 CKE=1
        movwf   SSPSTAT         ; input data on falling edge, output on rising

        ;; Serial port setup
        movlw   d'46'           ; 1200 (1190)  baud at 3.579545 MHz clock.
        movwf   SPBRG           ; set baud rate generator.
        movlw   b'00100000'     ; transmit enabled, low speed async.
        movwf   TXSTA           ; set transmit status and control register.
        movlw   b'00100100'     ; RCIE | CCP1IE interrupts enabled.
        movwf   PIE1            ; set peripheral interrupts enable register.
        
        movlw   B'11101111'     ; na/na/in/out/in/in/in/in
        movwf   TRISA           ; set port A data direction

        movlw   B'00111010'     ; out/out/in/in/in/out/in/out
        movwf   TRISB           ; set port B data direction

        movlw   B'00110000'     ; CTSEL1 & CTSEL2
        movwf   WPUB            ; set port weak pullups

        movlw   B'11010100'     ; na/na/SDO(out)/SDI(in)/SCK(out)/in/out/out
        movwf   TRISC           ; set port C data direction

        movlw   b'00000100'     ; enable on CCP1 interrupt.
        movwf   PIE1            ; set up interrupt control.

        bsf     STATUS,RP1      ; select register page 2/3
        clrf    ANSEL           ; clear analog select
        clrf    ANSELH          ; clear analog select

        bcf     STATUS,RP1      ; select register page 0/1

        bcf     STATUS,RP0      ; select register page 0/2

        ;; SPI setup
        movlw   b'00100001'     ; set up spp: on, spi master, clk/16
        movwf   SSPCON          ; set up SPP for SPI mode.
        
        ;; enable serial port
        movlw   b'10010000'     ; serial enabled, etc.
        movwf   RCSTA           ; set receive status and control register.

        movlw   b'00010000'     ; port a preset muted.
        movwf   PORTA           ; preset PORTA
        clrf    PORTB           ; preset PORTB
        bsf     PORTB,ISDSEL    ; set SPI select high
        movlw   b'00011000'     ; presets for PORTC so ISD does not start
        movwf   PORTC           ; preset PORTC

        clrwdt                  ; give me more time to get up and running.

        ;; set up timer 1
        movlw   b'00000000'     ; set up timer 1.
        movwf   T1CON           ; set up timer 1.
        movlw   b'00001010'     ; timer 1 compare throws interrupt.
        movwf   CCP1CON         ; set up compare mode.
        movlw   h'ff'           ; init compare value.
        movwf   CCPR1L          ; set up initial compare (invalid)
        movwf   CCPR1H          ; set up initial compare (invalid)
        movlw   h'20'           ; first address of RAM.
        movwf   FSR             ; set pointer.

ClrMem
        clrf    INDF            ; clear ram byte.
        incf    FSR,f           ; increment FSR.
        btfss   FSR,7           ; cheap test for address 80 and above.
        goto    ClrMem          ; loop some more.
        bsf     STATUS,IRP      ; select FSR is in 100-1ff range
        
        movlw   TEN             ; get timebase presets
        movwf   oneMsC
        movwf   tenMsC
        movwf   hundMsC
        movwf   thouMsC
        clrf    tFlags

        movlw   CTNONE          ; no courtesy tone.
        movwf   cTone           ; set courtesy tone selector.

        ;; preset timer defaults
        clrf    cwTbTmr         ; CW timebase counter.
        
        ;; enable interrupts.
        movlw   b'11100000'     ; enable global + peripheral + timer0
        movwf   INTCON

        ;;  power up the ISD
        movlw   ICMDPU          ; get power up command constant
        call    QISDCmd         ; enqueue the PU command.

        ;;  50 ms T_PU_D power up delay.
        movlw   IDLY60          ; 60 ms delay
        call    QISDCmd         ; enqueue the delay command
                
        ;; set the MUTE pin to an input to look for init
        bsf     STATUS,RP0      ; select bank 1
        movlw   B'11111111'     ; na/na/in/*in*/in/in/in/in
        movwf   TRISA           ; set port A data direction
        bcf     STATUS,RP0      ; select bank 0

        btfsc   PORTA,INIT      ; skip if init button pressed.
        goto    Start1          ; no initialize request.
        
; *********************
; * INITIALIZE EEPROM *
; *********************
                
        clrf    temp2           ; byte index
InitLp
        movf    temp2,w         ; get last address.
        sublw   EELAST          ; subtract last init address.
        btfss   STATUS,C        ; c will be clear if result is negative.
        goto    InitDun         ; done initializing...
        movf    temp2,w         ; get init address
        movwf   eeAddr          ; set eeprom address
        movf    temp2,w         ; get init address
        PAGE3                   ; select page 3
        call    InitDat         ; get init byte
        call    WriteEw         ; write byte to EEPROM.
        PAGE0                   ; select page 0
        incf    temp2,f         ; go to next byte
        goto    InitLp          ; get the next block of 16 or be done.
        
InitDun                         ; done with init loop
        movlw   ICMDGER         ; get global erase command
        call    QISDCmd         ; enqueue the GER command.
        clrwdt                  ; get more time to start up.
        
; ********************************
; ** Ready to really start now. **
; ********************************
Start1
        ;; reset the state of the MUTE pin to an output
        bsf     STATUS,RP0      ; select bank 1
        movlw   B'11101111'     ; na/na/in/out/in/in/in/in
        movwf   TRISA           ; set port A data direction
        bcf     STATUS,RP0      ; select bank 0

        movlw   ICMDWAP         ; get the WAPC2 command
        call    QISDCmd         ; enqueue the WAPC2 command.

        movlw   ICMDDID         ; get the DID command
        call    QISDCmd         ; enqueue the DID command.
        
        
Start2  
        clrw                    ; select macro set 0.
        PAGE3                   ; select page 3.
        call    LoadCtl         ; load control op settings.
        call    CWParms         ; get the CW parameters for pitch and speed.
        PAGE0                   ; select page 0
        movlw   1               ; 1 = 10 seconds for ID timer in euro mode.
        btfsc   group3,0        ; in euro mode?
        movwf   idTmr           ; preload ID timer in euro mode.
        btfsc   group3,5        ; in ID Beacon mode?
        movwf   idTmr           ; preload ID timer in euro mode.
                
        ;; get tail message counter.
        movlw   EETTAIL         ; get EEPROM address of tail message counter.
        movwf   eeAddr          ; set EEPROM address low byte.
        PAGE3                   ; select page 3.
        call    ReadEEw         ; read EEPROM.
        PAGE0                   ; select page 0.
        movwf   tailCtr         ; preset tail message counter.
        ;;
        ;; say hello to all the nice people out there.
        ;;
        btfsc   group3,7        ; NO ID set?
        goto    Loop0           ; yes.  NO ID.
        PAGE3                   ; select code page 3.
        movlw   CWHELLO         ; get HELLO announcement.
        call    PlayCW          ; start playback
        PAGE0                   ; select code page 0.
        
; **************************************************************************
; ******************************* MAIN LOOP ********************************
; **************************************************************************
                
Loop0
        btfsc   tFlags,TENSEC   ; is ten second flag set?
        bcf     tFlags,TENSEC   ; reset it if it is...

Chek1000        
        btfss   tFlags,ONESEC   ; is the 1000 mS flag set?
        goto    Check100        ; nope...
        bcf     tFlags,ONESEC   ; clear 1000 mS flag.
        decfsz  thouMsC,f       ; decrement hundred millisecond counter.
        goto    Check100        ; not zero.
        movlw   TEN             ; get preset.
        movwf   thouMsC         ; reset down counter.
        bsf     tFlags,TENSEC   ; set ONESEC indicator.

Check100        
        btfss   tFlags,HUNDMS   ; is the 100 mS flag set?
        goto    Check10         ; nope...
        bcf     tFlags,HUNDMS   ; clear 100 mS flag.
        decfsz  hundMsC,f       ; decrement hundred millisecond counter.
        goto    Check10         ; not zero.
        movlw   TEN             ; get preset.
        movwf   hundMsC         ; reset down counter.
        bsf     tFlags,ONESEC   ; set ONESEC indicator.

Check10
        btfss   tFlags,TENMS    ; is the 10 mS flag set?
        goto    Check1          ; nope...
        bcf     tFlags,TENMS    ; clear 10 mS flag.
        decfsz  tenMsC,f        ; decrement ten millisecond counter.
        goto    Check1          ; not zero.
        movlw   TEN             ; get preset.
        movwf   tenMsC          ; reset down counter.
        bsf     tFlags,HUNDMS   ; set HUNDMS indicator.

Check1
        btfss   tFlags,ONEMS    ; is the 1 mS flag set?
        goto    CheckTic        ; nope...
        bcf     tFlags,ONEMS    ; clear 1 mS flag.
        decfsz  oneMsC,f        ; decrement one millisecond counter.
        goto    CheckTic        ; not zero.
        movlw   TEN             ; get preset.
        movwf   oneMsC          ; reset down counter.
        bsf     tFlags,TENMS    ; set TENMS indicator.

CheckTic
        
        btfss   tFlags,TICK     ; did a tick occur?
        goto    Loop1           ; nope.
        bcf     tFlags,TICK     ; reset TICK indicator.
        bsf     tFlags,ONEMS    ; set ONEMS indicator.
        clrwdt

Loop1
; ********************************************
; ** RECEIVER DEBOUNCE AND INPUT VALIDATION **
; ********************************************
DebRx
        btfss   tFlags,ONEMS    ; one ms tick, check for receiver active
        goto    NoDeb           ; nope
CkRx0                           ; check COR state receiver 1
        btfss   PORTB,RX0COR    ; check cor receiver 1
        goto    Rx0COR1         ; it's low, COR is present
                                ; COR is not present.
        btfss   group1,2        ; (NOT) OR PL?
        goto    Rx0Off          ; nope...
        ;; v01.2 change here.
        btfsc   group0,1        ; is PL required?
        goto    Rx0Off          ; yes.
        ;; end v01.2 change.
        goto    Rx0CkPL         ; yes, OR PL mode
Rx0COR1
        btfss   group0,1        ; AND PL set?
        goto    Rx0On           ; no.
        ;; v01.2  new code.
        btfss   group1,2        ; OR PL set?
        goto    Rx0CkPL         ; no.
        ;; AND and OR PL are both set, PL is required to bring up repeater,
        ;; but not to access it during tail.
        movf    txFlag,w        ; get txFlag.
        andlw   b'00000101'     ; hang time or rx0 is open.
        btfss   STATUS,Z        ; Z will be set if not hang or rx0.
        goto    Rx0On           ; repeater is not idle.  Allow COR access.
        ;; end v 01.2 new code.
        ;; 1.06 change.  fix for 1750 mode in timeout...
        btfsc   rxFlag,RX0OPEN  ; already marked active?
        goto    Rx0On           ; stay set on.
        ;; end of 1.06 change...

Rx0CkPL                         ; check PL...
        btfsc   PORTC,RX0PL     ; is the PL signal present?
        goto    Rx0Off          ; no.
        
Rx0On                           ; the COR and PL requirements have been met
        btfsc   rxFlag,RX0OPEN  ; already marked active?
        goto    Rx0NC           ; yes.
        movf    rx0Dbc,f        ; check for zero
        btfss   STATUS,Z        ; is it zero?
        goto    Rx01Dbc         ; nope...
        movlw   COR1DEB         ; get COR debounce timer value.
        btfsc   group2,7        ; is the delay present?
        movlw   DLY1DEB         ; get COR debounce with delay value.
        movf    txFlag,f        ; check for transmitter already on.
        btfss   STATUS,Z        ; is the transmitter already on?
        goto    Rx0SDeb         ; yep.
        btfsc   group0,2        ; is the kerchunker delay set?
        movlw   CHNKDEB         ; get kerchunker filter delay.
Rx0SDeb                         ; set debounce timer.
        movwf   rx0Dbc          ; set it
        goto    Rx0Done         ; done.
Rx01Dbc
        decfsz  rx0Dbc,f        ; decrement the debounce counter
        goto    Rx0Done         ; not zero yet
        bsf     rxFlag,RX0OPEN  ; set receiver active flag
        goto    Rx0Done         ; continue...
Rx0Off                          ; the COR and PL requirements have not been met
        btfss   rxFlag,RX0OPEN  ; was the receiver off before?
        goto    Rx0NC           ; yes.
        movf    rx0Dbc,f        ; check for zero
        btfss   STATUS,Z        ; is it zero?
        goto    Rx00Dbc         ; nope...
        movlw   COR0DEB         ; get COR debounce timer value.
        btfsc   group2,7        ; is the delay present?
        movlw   DLY0DEB         ; get COR debounce with delay value.
        ;; 1.06 change; use long debounce in simplex mode
        btfsc   group1,6        ; in simplex mode?
        movlw   COR0DBS         ; get COR simplex debounce time.
        ;; end 1.06 change...
        movwf   rx0Dbc          ; set it
        goto    Rx0Done         ; done.
Rx00Dbc
        decfsz  rx0Dbc,f        ; decrement the debounce counter
        goto    Rx0Done         ; not zero yet
        bcf     rxFlag,RX0OPEN  ; clear receiver active flag
        movf    dt0Tmr,f        ; test to see if touch-tones received...
        btfsc   STATUS,Z        ; is it zero?
        goto    Rx0Done         ; yes. don't need to accellerate execution.
        movlw   d'2'            ; no
        movwf   dt0Tmr          ; accelerate eval of DTMF command
        goto    Rx0Done         ; continue...
Rx0NC
        clrf    rx0Dbc          ; clear debounce counter.
Rx0Done

        ;; check alarm input status
        btfss   group4,6        ; is the alarm enabled?
        goto    AlmOff          ; alarm is not turned on.
        btfsc   PORTB,ALARMIN   ; is alarm input low?
        goto    NoAlm           ; no
        btfsc   mscFlag,ALARMED ; was the alarm mode already set?
        goto    AlmDone         ; yes.  no need to do more.
        bsf     mscFlag,ALARMED ; set alarmed flag
        movlw   d'1'            ; play alarm message soon.
        movwf   alrmTmr         ; set alarm timer 10 seconds hence.
        goto    NoDeb

NoAlm
        btfsc   group4,7        ; latch mode selected?
        goto    AlmDone         ; yes.
        bcf     mscFlag,ALARMED ; reset alarmed flag
        clrf    alrmTmr         ; clear alarm announcement timer
        goto    AlmDone
        
AlmOff                          ; alarm is not enabled.
        bcf     mscFlag,ALARMED ; so make sure the indicator is off.
        clrf    alrmTmr         ; and timer is zero

AlmDone          
NoDeb
        btfss   tFlags,TENMS    ; ten MS flag set?
        goto    CkDTDone        ; no.

        btfss   PORTA,DTMF_DV   ; is a DTMF digit being decoded?
        goto    CkDT0L          ; no
        btfsc   flags,LAST_DV   ; was it there last time?
        goto    CkDTDone        ; yes, do nothing.
        bsf     flags,LAST_DV   ; set last DV indicator.
        bcf     mscFlag,CTCSS0  ; clear LAST CTCSS flag.
        btfss   PORTC,RX0PL     ; is the PL signal present?
        bsf     mscFlag,CTCSS0  ; set LAST CTCSS flag.

RdDT0
        btfss   group1,3        ; is muting enabled?
        goto    RdDT0m          ; nope.
        bsf     PORTA,RX0AUD    ; mute receiver 0
        movlw   MUTEDLY         ; get mute timer delay
        movwf   muteTmr         ; preset mute timer
RdDT0m
        movlw   DTMFDLY         ; get DTMF activity timer preset.
        movwf   dt0Tmr          ; set dtmf command timer
        
        movf    dt0Ptr,w        ; get index
        movwf   FSR             ; put it in FSR
        bcf     STATUS,C        ; clear carry (just in case)
        rrf     FSR,f           ; hey! divide by 2.
        movlw   LOW dt0buf0     ; get address of buffer
        addwf   FSR,f           ; add to index.
        
        movlw   b'00001111'     ; mask bits.
        andwf   PORTA,w         ; get masked bits of tone into W.
        PAGE3                   ; select code page 3.
        call    MapDTMF         ; remap tone into keystroke value..
        PAGE0                   ; select code page 0.
        iorlw   h'0'            ; OR with zero to set status bits.
        bcf     mscFlag,DT0ZERO ; clear last zero received.
        btfsc   STATUS,Z        ; was a zero the last received digit?
        bsf     mscFlag,DT0ZERO ; yes...
        
        btfsc   dt0Ptr,0        ; is this an odd address?
        goto    DT0Odd          ; yes;
        clrf    INDF            ; zero both nibbles.
        movwf   INDF            ; save tone in indirect register.
        swapf   INDF,f          ; move the tone to the high nibble
        goto    DT0Done         ; done here
DT0Odd
        iorwf   INDF,F          ; save tone in low nibble
DT0Done 
        incf    dt0Ptr,f        ; increment index
        movlw   h'1f'           ; mask
        andwf   dt0Ptr,f        ; don't let index grow past 1f (31)

        goto    CkDTDone        ; done with DTMF checking.

CkDT0L                          ; check for end of LITZ...
        btfss   flags,LAST_DV   ; was it low last time?
        goto    CkDTDone        ; yes.  Done.
        bcf     flags,LAST_DV   ; clear last DV indicator.
        btfss   mscFlag,DT0ZERO ; was zero the last received digit?
        goto    CkDTDone        ; no.
        movf    dt0Tmr,w        ; get dtmf command timer
        btfsc   STATUS,Z        ; is it already zero?
        goto    CkDT0LZ         ; yes.
        sublw   LITZTIM         ; subtract from litz time.
        btfss   STATUS,C        ; is result positive?
        goto    CkDTDone        ; nope.

CkDT0LZ                         ; check for LITZ digits.
        bsf     mscFlag,LITZDT0 ; set LITZ on main receiver flag.
        clrf    dt0Ptr          ; clear this, throw away received LITZ tone.
        clrf    dt0Tmr          ; clear this, don't process tones normally.

CkDTDone                        ; done with DTMF scanning.

;;;     ISD State machine.

        ;; check for "interrupt" from ISD here.
        btfsc   PORTB,ISDINT    ; is ISD interrupt low?
        goto    IIDone          ; no interrupt has occurred
        ;; the interrupt bit is low; have interrupt
        bcf     txFlag,TALKING  ; clear TALKING flag, no matter what

        btfss   group1,6        ; in simplex mode?
        goto    CkI2            ; no
        btfsc   isdFlag,ISDRECF ; was it recording?
        bsf     isdFlag,ISDRECE ; yes, set message overflow flag
        btfsc   isdFlag,ISDRUNF ; was it in playback mode?
        bsf     isdFlag,ISDZAPS ; yes, erase simplex message

CkI2
        bcf     isdFlag,ISDRUNF ; not running any more
        bcf     isdFlag,ISDRECF ; not recording any more
        btfsc   flags,IDNOW     ; was that an ID that was playing?
        bcf     flags,needID    ; don't need to ID again
        bcf     flags,IDNOW     ; if this was an ID, clear it
        PAGE3                   ; select code page 3.
        movlw   ISDCINT         ; ISD clear interrupt command.
        call    ISDCmd2         ; clear interrupt.
        PAGE0                   ; select code page 0.
        bcf     ismpcf,ISMWINT  ; turn off wait for interrupt flag
        bcf     ismpcf,ISMERAS  ; turn off erase cannot be interrupted flag

CkI3
        btfss   isdFlag,ISDZAPS ; zap simplex message?
        goto    IIDone          ; nope.
        bcf     isdFlag,ISDZAPS ; reset zap simplex message flag
        
        ;; erase simplex message after playback
        btfss   group1,6        ; in simplex mode?
        goto    IIDone          ; no
        movlw   VSIMPLX         ; get simplex message
        iorlw   ICMDDEL         ; make into erase command
        call    QISDCmd         ; enqueue the delay command.
        
IIDone  
        ;; check the state if the ISD Timer
        movf    isdDly,f        ; check for isdDly
        btfsc   STATUS,Z        ; is it zero?
        goto    NIsdTmr         ; isdDly is zero
        decfsz  isdDly,f        ; decrement isdDly
        goto    NIsdTmr         ; still not zero.
        bcf     ismpcf,ISMWAIT  ; turn off timer flag
        
NIsdTmr
        ;; now process the ISD state machine.
        movf    ismpcf,f        ; check state machine process control flags
        btfss   STATUS,Z        ; skip if ismpcf is zero
        goto    IQDone          ; not ready for another command
        movf    isdcbt,w        ; get tail pointer.
        subwf   isdcbh,w        ; subtract from head pointer.
        btfsc   STATUS,Z        ; result should be non-zero if buffer no
        goto    IQDone          ; buffer is empty.
        ;; there is a command in the queue, dequeue it
        incf    isdcbt,w        ; get tail pointer + 1.
        andlw   h'07'           ; mask so result stays in 0-7 range.
        movwf   isdcbt          ; save it...
        addlw   LOW isdcb00     ; add to buffer base address.
        movwf   FSR             ; set FSR as pointer.
        bcf     STATUS,IRP      ; select 00-FF range for FSR/INDF
        movf    INDF,w          ; get char.
        clrf    INDF            ; mark as invalid.  aids debugging. 
        bsf     STATUS,IRP      ; select 100-1FF range for FSR/INDF
        ;;  now have dequeued isd command in w
        movwf   temp5           ; save it
        btfsc   temp5,7         ; is command?
        goto    ICP7            ; hi bit is set! erase or record
        btfsc   temp5,6         ; is it playback?
        goto    ICPplay         ; it is playback.
        btfsc   temp5,5         ; is it a delay command?
        goto    ICPdelay
        
        ;; has to be a command
ICPcmd
        movlw   b'00001111'     ; command number mask
        andwf   temp5,f         ; mask 0-7

        movlw   high ICPtbl     ; set high byte of address
        movwf   PCLATH          ; select page
        movf    temp5,w         ; get command number
        addwf   PCL,f           ; add w to PCL:  computed GOTO
ICPtbl  ;; computed goto
        goto    ICPcmd0         ; invalid command
        goto    ICPcmd1         ; stop
        goto    ICPcmd2         ; reset
        goto    ICPcmd3         ; clear interrupt
        goto    ICPcmd4         ; read status
        goto    ICPcmd5         ; resd devid
        goto    ICPcmd6         ; global erase
        goto    ICPcmd7         ; write APC2
        goto    ICPcmd8         ; PU
        goto    ICPcmd0         ; 9 invalid command
        goto    ICPcmd0         ; A invalid command
        goto    ICPcmd0         ; B invalid command
        goto    ICPcmd0         ; C invalid command
        goto    ICPcmd0         ; D invalid command
        goto    ICPcmd0         ; E invalid command
        goto    ICPcmd0         ; F invalid command

ICPcmd0                         ; invalid command.
        goto    IQDone  

ICPcmd1                         ; stop
        clrf    isdS1           ; clear isd payload byte 1
        clrf    isdS2           ; clear isd payload byte 2
        movlw   ISDSTS          ;
        PAGE3                   ; select code page 3.
        call    ISDCmd3         ; send the STATUS  command
        PAGE0                   ; select code page 0.
        movf    sr1lo,w         ; get status 1 byte
        andlw   b'00110000'     ; mask out all except REC and PLAY flags
        btfsc   STATUS,Z        ; is it zero?
        goto    ICP2B           ; it is zero, not gonna send STOP.
        bsf     ismpcf,ISMWINT  ; need to wait for ISD int after this cmd.
        movlw   ISDSTOP         ; get the STOP command
        goto    ICP2B           ; send 2 byte command

ICPcmd2                         ; reset
        movlw   ISDRST          ; get the RESET command
        goto    ICP2B           ; send 2 byte command

ICPcmd3                         ; clear interrupt
        movlw   ISDCINT         ; ISD clear interrupt command.
        goto    IQDone          

ICPcmd4                         ; read status
        clrf    isdS1           ; clear isd payload byte 1
        clrf    isdS2           ; clear isd payload byte 2
        movlw   ISDSTS          ;
        PAGE3                   ; select code page 3.
        call    ISDCmd3         ; send the STATUS  command
        PAGE0                   ; select code page 0.
        goto    IQDone          
        
ICPcmd5                         ; read devid
        clrf    isdS1           ; clear isd payload byte 1
        clrf    isdS2           ; clear isd payload byte 2
        movlw   ISDDID          ; read devid commadn
        PAGE3                   ; select code page 3.
        call    ISDCmd3         ; send the DEVID command
        PAGE0                   ; select code page 0.
        movf    sr1lo,w         ; get 3rd response byte
        movwf   isdDvId         ; save ISD device ID.
        goto    IQDone          

ICPcmd6                         ; G_erase
        bsf     ismpcf,ISMWINT  ; need to wait for interrupt after this cmd.
        bcf     ismpcf,ISMERAS  ; erase cannot be interrupted.
        movlw   ISDGER          ; ISD global erase command
        goto    ICP2B           ; send 2 byte command

ICPcmd7                         ; write apc2
        movlw   APC07           ; 1st byte of APC register
        movwf   isdS1           ; save it
        movlw   APC811          ; 2nd byte of APC register
        movwf   isdS2           ; save it
        movlw   ISDWAPC         ; ISD WR_APC2 command
        PAGE3                   ; select code page 3
        call    ISDCmd3         ; send 3 byte command to ISD
        PAGE0                   ; select code page 0
        goto    IQDone  
        
ICPcmd8                         ; PU
        movlw   ISDPU           ; ISD PU command
        goto    ICP2B           ; send 2 byte command
        
ICP2B                           ; send 2 byte command from here
        PAGE3                   ; select code page 3.
        call    ISDCmd2         ; send the command
        PAGE0                   ; select code page 0.
        goto    IQDone          
        
ICPdelay
        movf    temp5,w         ; get command back
        andlw   b'00011111'     ; mask to delay
        ;; this uses 7 instructions to make isdDly = 10 * w
        movwf   isdDly          ; save it  (=A)
        movwf   temp5           ; save it  (=A)
        rlf     temp5,f         ; temp5 = temp5 x 2
        rlf     temp5,f         ; temp5 = temp5 x 2
        rlf     temp5,w         ; w = temp5 * 2
        addwf   isdDly,w        ; w = w + isdDly
        addwf   isdDly,f        ; idsDly = w + isdDly
        bsf     ismpcf,ISMWAIT  ; set ISMWAIT condition, wait for timer
        goto    IQDone
        
ICPplay
        movlw   ISDPLAY         ; ISD SET_PLAY command
        movwf   isdCmd          ; save command byte
        
        bsf     txFlag,TALKING  ; set TALKING flag.
                
        movf    temp5,w         ; get command byte back
        andlw   b'00111111'     ; mask to only reasonable message numbers
        PAGE3                   ; select code page 3.
        call    MsgNum          ; set up ISD start/stop address
        call    ISDCmd7         ; send 7 byte command to ISD
        call    PTTon           ; turn on tx if not on already.
        PAGE0                   ; select code page 0

        bsf     isdFlag,ISDRUNF ; set ISD running flag
        goto    ICPWINT
        
ICP7
        btfss   temp5,6
        goto    ICPerase
        
ICPrec
        movlw   ISDREC
        movwf   isdCmd          ; save command byte

        movf    temp5,w         ; get command byte back
        andlw   b'00111111'     ; mask to only reasonable message numbers
        PAGE3                   ; select code page 3
        call    MsgNum          ; set up ISD start/stop address
        call    ISDCmd7         ; send 7 byte command to ISD
        PAGE0                   ; select code page 0
        
        bsf     isdFlag,ISDRECF ; set recording flag
        bcf     isdFlag,ISDRECE ; clear overflow flag
        goto    ICPWINT

ICPerase
        movlw   ISDERAS         ; ISD SET_ERASE command
        movwf   isdCmd          ; save command byte

        movf    temp5,w         ; get command byte back
        andlw   b'00111111'     ; mask to only reasonable message numbers
        PAGE3                   ; select code page 3
        call    MsgNum          ; set up ISD start/stop address
        call    ISDCmd7         ; send 7 byte command to ISD
        PAGE0                   ; select code page 0
        
        bsf     ismpcf,ISMERAS  ; erase cannot be interrupted.
        btfsc   group1,6        ; in simplex mode?
        bsf     txFlag,TALKING  ; set TALKING flag.
        
ICPWINT                         ; set wait for interrupt and continue
        bsf     ismpcf,ISMWINT  ; wait for interrupt
        
        goto    IQDone

IQDone  

        goto    MainLp          ; crosses 256 byte boundary (to 0400)
        org 0400
        
; *************************************
; * main loop for repeater controller *
; *************************************

MainLp
        movlw   high MlTbl      ; set high byte of address
        movwf   PCLATH          ; select page
        movf    rx0Stat,w       ; get main receiver state
        addwf   PCL,f           ; add w to PCL:  computed GOTO
MlTbl
        goto    Main0           ; quiet
        goto    Main1           ; repeat
        goto    Main2           ; timeout
        ;; new state for 1.04 
        goto    Main3           ; RXSREC record with rptr disabled.
        ;; new state for 1.12
        goto    Main4           ; receiver active while repeater is off
        
Main0                           ; receiver quiet state
        btfss   rxFlag,RX0OPEN  ; is squelch open?
        goto    ChkTmrs         ; nope, don't turn receiver on
        ;; receiver is unsquelched; put it on the air
        ;; receiver inactive --> active transition
        ;; v 1.04 changes to allow record when repeater disabled...
        btfsc   group0,0        ; is repeater enabled?
        goto    Main0on         ; yes.
        
        ;; repeater is not enabled.
        btfsc   isdFlag,ISDRECR ; is record mode flag set?
        goto    Main0R
        btfss   group3,5        ; ID beacon mode?
        goto    ChkTmrs         ; nope.
        btfss   group3,6        ; NO CW ID mode?
        goto    ChkTmrs         ; nope.
        ;; now in BEACON mode and NO CW ID mode.
        movlw   RXSOFON         ; get new state #
        movwf   rx0Stat         ; set new receiver state

        ;; stomp playing voice messages here.
        btfss   isdFlag,ISDRUNF ; is ISD Running?
        goto    ChkTmrs         ; no
        ;; ISD is running.
        btfss   flags,IDNOW     ; is an ID playing now?
        goto    ChkTmrs         ; no.
        movlw   ICMDST          ; get STOP command
        call    QISDCmd         ; enqueue the STOP command.
        bcf     txFlag,TALKING  ; clear TALKING flag
        bsf     flags,DEF_ID    ; set deferred ID flag.
        bcf     flags,IDNOW     ; clear IDing flag.
        goto    ChkTmrs         ; rptr is disabled, no record.
        
Main0R
        ;; repeater is disabled, but record is set.
        ;; set state to record...
        movlw   RXSREC          ; get new state #.
        movwf   rx0Stat         ; set new receiver state record with rptr off.
        bcf     PORTA,RX0AUD    ; unmute receiver
        
        btfss   isdFlag,ISDRUNF ; is ISD Running?
        goto    M0ORec          ; no
        ;; ISD is running.
        clrf    isdDly          ; clear this so it can't fire, just in case.
        bcf     isdFlag,ISDRUNF ; clear ISD running flag.
        bcf     txFlag,TALKING  ; clear TALKING flag
M0ORec
        ;; now set up to start recording...
        bcf     isdFlag,ISDRECR ; clear record mode flag.
        ;; stop the ISD to make sure it is in a known state.
        movlw   ICMDST          ; get STOP command
        call    QISDCmd         ; enqueue the STOP command.
        ;; send the record command
        movf    isdRMsg,w       ; get message number
        iorlw   ICMDREC         ; make into record command
        call    QISDCmd         ; enqueue the command
        goto    ChkTmrs         ; done here.  continue on.
                
Main0on
        btfss   group0,5        ; is DTMF access mode enabled?
        goto    Main00          ; no.
        movf    dtATmr,f        ; check DTMF access mode timer.
        btfsc   STATUS,Z        ; is it zero?
        goto    ChkTmrs         ; yes.  Don't turn receiver on.
        ;; timer is not zero, reset to initial value.
        movlw   EETDTA          ; get EEPROM address of DTMF access timer.
        movwf   eeAddr          ; set EEPROM address low byte.
        PAGE3                   ; select code page 3.
        call    ReadEEw         ; read EEPROM.
        PAGE0                   ; select code page 0.
        movwf   dtATmr          ; set DTMF access mode timer.
Main00                          ; receiver inactive --> active transition
        movlw   RXSON           ; get new state #
        movwf   rx0Stat         ; set new receiver state

        btfss   group3,0        ; euro ID mode?
        goto    Main00e         ; not in euro mode.
        movf    txFlag,w        ; get txFlag.
        andlw   b'00000100'     ; mask for HANG 
        btfsc   STATUS,Z        ; is result zero?
        bsf     flags,initID    ; yes, set init ID mode
        
Main00e                         ;
        bsf     flags,needID    ; make sure ID still plays if tail never drops
        ;; 1.05 change here, fixes extra ID in euro ID mode
        bcf     txFlag,TXHANG   ; clear hang flag
        clrf    hangTmr         ; clear hang timer
        ;; end of 1.05 change
        btfss   group1,6        ; dont turn on TX if in simplex mode.
        bsf     txFlag,RX0OPEN  ; set main receiver on bit
        movlw   CTNONE          ; no courtesy tone.
        movwf   cTone           ; kill off any pending courtesy tone.
Main00a 
        movf    muteTmr,f       ; check mute timer
        btfsc   STATUS,Z        ; if it's non-zero, skip unmute
        bcf     PORTA,RX0AUD    ; unmute receiver
        ;; stomp playing voice messages here.
        btfss   isdFlag,ISDRUNF ; is ISD Running?
        goto    ChkRec          ; no
        ;; ISD is running.
        btfss   flags,IDNOW     ; is an ID playing now?
        goto    Stomp           ; nope.
        btfss   group2,3        ; is stomp allowed?
        goto    MainUM          ; nope.  bypass record check, too.
Stomp
        clrf    isdDly          ; clear this so it can't fire, just in case.
        bcf     txFlag,TALKING  ; clear TALKING flag
        ;; stop the ISD
        movlw   ICMDST          ; get STOP command
        call    QISDCmd         ; enqueue the STOP command.

        btfss   group1,6        ; in simplex repeat mode?
        goto    StompNS         ; nope.
        ;; erase simplex message after playback
        movlw   VSIMPLX         ; get simplex message
        iorlw   ICMDDEL         ; make into erase command
        call    QISDCmd         ; enqueue the erase command.

StompNS 
        btfss   flags,IDNOW     ; is an ID playing now?
        ;; hmmmm.  should this be allowed to set record mode now?
        goto    ChkRec          ; no.

        btfss   group3,6        ; is NO CW ID mode selected?
        goto    Stomp1          ; no, it is not.
        bsf     flags,DEF_ID    ; set deferred ID flag.
        bcf     flags,IDNOW     ; clear IDing flag.
        goto    ChkRec          ; continue...
        
Stomp1
        movlw   EECWID          ; address of CW ID message in EEPROM.
        movwf   eeAddr          ; save CT base address
        PAGE3                   ; select code page 1.
        call    PlayCWe         ; kick off the CW playback.
        PAGE0                   ; select code page 0.
        bcf     flags,IDNOW     ; clear IDing flag.
        
ChkRec
        btfsc   isdFlag,ISDRECR ; is record mode flag set?
        goto    NormRec         ; record normal message.
        btfsc   group1,6        ; in simplex mode?
        goto    SimRec          ; yes.
        goto    MainUM          ; no continue...

NormRec                         ; normal, 22.3 second message.
        bcf     isdFlag,ISDRECR ; clear record mode flag.
        movf    isdRMsg,w       ; get record message slot
        iorlw   ICMDREC         ; make into record command
        call    QISDCmd         ; enqueue the command
        goto    MainUM          ; continue
        
SimRec
        movlw   VSIMPLX         ; get simplex message
        iorlw   ICMDREC         ; make into record command
        call    QISDCmd         ; enqueue the command
        goto    MainUM          ; done here.
        
MainUM
Main01
        btfss   group1,0        ; is time out timer enabled?
        goto    ChkTmrs         ; nope...
        movlw   EETTMS          ; EEPROM address of timeout timer short preset.
        btfsc   group1,1        ; is short timeout selected
        movlw   EETTML          ; EEPROM address of timeout timer long preset.
        movwf   eeAddr          ; set EEPROM address low byte.
        PAGE3                   ; select code page 3.
        call    ReadEEw         ; read EEPROM.
        PAGE0                   ; select code page 0.
        movwf   rx0TOut         ; set timeout counter
        goto    ChkTmrs         ; done here...

Main1                           ; receiver active state
        btfss   group0,0        ; is repeater enabled?
        goto    Main1Off        ; no.  turn receiver off
        btfss   rxFlag,RX0OPEN  ; is squelch open?
        goto    Main1Off        ; no, on->off transition
        btfss   tFlags,ONESEC   ; one second tick?
        goto    ChkTmrs         ; nope, continue
        movf    rx0TOut,f       ; squelch still open, check timeout timer
        btfsc   STATUS,Z        ; skip if not zero
        goto    ChkTmrs         ; timeout timer is zero, don't decrement
        decfsz  rx0TOut,f       ; decrement the timeout timer
        goto    ChkTmrs         ; have not timed out (yet), continue
        ;; have just timed out!
        movlw   RXSTMO          ; get new state, timed out
        movwf   rx0Stat         ; set new receiver state
        bcf     txFlag,RX0OPEN  ; clear main receiver on bit
        bsf     PORTA,RX0AUD    ; mute
        btfss   group1,6        ; in simplex mode?
        goto    Main1X          ; yes.
        btfss   isdFlag,ISDRECF ; is the ISD recording
        goto    ChkTmrs         ; no, it has already stopped
        movlw   ICMDST          ; get STOP command
        call    QISDCmd         ; enqueue the STOP command.
        goto    ChkTmrs         ; done here
Main1X  
        clrf    rx0TOut         ; clear main receiver timeout timer
        btfsc   group2,4        ; is voice timeout message enabled?
        goto    Main1TO         ; yes...
        PAGE3                   ; select code page 3.
        movlw   CW_TO           ; get CW timeout message.
        call    PlayCW          ; play CW message.
        PAGE0                   ; select code page 1.
        goto    ChkTmrs         ; done here...
Main1TO 
        movlw   VTIMOUT         ; time out message
        call    NewPlay
        goto    ChkTmrs         ; done here...

Main1Off                        ; receiver was active, became inactive
        call    Rcv0Off         ; turn off receiver
Main10
        btfsc   group1,6        ; in simplex mode?
        goto    Main10m         ; yes.

        btfsc   isdFlag,ISDTEST ; test mode?
        goto    Main10m         ; yes

        btfss   isdFlag,ISDRECF ; is the ISD recording
        goto    Main10a         ; nope.
        ;; the ISD is recording, send the stop command
        movlw   ICMDST          ; get STOP command
        call    QISDCmd         ; enqueue the STOP command.
        goto    RecEnd1         ; not in simplex mode.

Main10m                         ; receiver dropped, in simplex mode.
        btfss   isdFlag,ISDRECF ; is the ISD recording
        goto    Main10X         ; nope.
        ;; the ISD is recording, send the stop command
        movlw   ICMDST          ; get STOP command
        call    QISDCmd         ; enqueue the STOP command.

Main10X
        movlw   VSIMPLX         ; normal simplex message.
        IFDEF NHRC3_1
        btfsc   isdFlag,ISDTEST ; test message?
        movlw   VTEST           ; get the test message address
        ENDIF
        call    NewPlay         ; play it
        bcf     isdFlag,ISDTEST ; clear this bit regardless of set or not
        goto    Main10s         ; done here.

RecEnd1
        ;;  play CW OK message to indicate the record is complete
        movlw   CW_OK           ; get CW OK
        btfsc   isdFlag,ISDRECE ; overflow error?
        movlw   CW_ERR          ; yes!
        bcf     isdFlag,ISDRECE ; clear overflow message bit
        PAGE3                   ; select code page 3.
        call    PlayCW          ; start playback
        PAGE0                   ; select ROM page 0.
        
Main10a
        ;;  set the courtesy tone
        clrf    cTone           ; start with zero
        btfss   PORTB,CTSEL1    ; is CTSEL1 high?
        bsf     cTone,0         ; no. set cTone 1s bit.
        btfsc   PORTB,CTSEL2    ; is CTSEL2 high?
        goto    Main10h         ; yes.
        btfss   group4,6        ; is alarm mode set?
        bsf     cTone,1         ; no.  set cTone 2s bit.

Main10h
        call    SetHang         ; start/restart the hang timer
        call    ChkID           ; test if need an ID now
Main10s                         ; Simplex mode; no hang, no courtesy tone.
        goto    ChkTmrs         ; done here...

Main2                           ; receiver timedout state
        btfss   group0,0        ; is repeater enabled?
        goto    Main2Off        ; no.  turn receiver off
        btfsc   rxFlag,RX0OPEN  ; is squelch still open?
        goto    ChkTmrs         ; yes, still timed out
Main2Off                        ; end of timeout condition.
        movlw   RXSOFF          ; timeout condition ended, get new state (off)
        movwf   rx0Stat         ; set new receiver state
        btfsc   group1,6        ; simplex mode?
        goto    Main2Sx         ; yes
        btfsc   group2,4        ; is voice timeout message enabled?
        goto    Main2TO         ; yes...
        PAGE3                   ; select code page 3.
        movlw   CW_TO           ; get CW timeout message.
        call    PlayCW          ; play CW message.
        PAGE0                   ; select code page 1.
        goto    ChkTmrs         ; done here...
Main2Sx
        movlw   VSIMPLX         ; get simplex message
        goto    Main2Py         ; play it
Main2TO 
        movlw   VTIMOUT         ; time out message
Main2Py 
        call    NewPlay         ; play message
        goto    ChkTmrs         ; seems redundant, but it ain't

Main3                           ; record with rptr disabled state.
        btfss   rxFlag,RX0OPEN  ; is squelch open?
        goto    Main3Off        ; no, on->off transition
        goto    ChkTmrs         ; 

Main3Off                        ; receiver was active, became inactive
        bsf     PORTA,RX0AUD    ; mute it...
        movlw   RXSOFF          ; get new state (off)
        movwf   rx0Stat         ; set new receiver state

        btfss   isdFlag,ISDRECF ; is the ISD recording?
        goto    Main3OK         ; nope. must have timed out.
        ;; the ISD is recording, send the STOP command
        movlw   ICMDST          ; get STOP command
        call    QISDCmd         ; enqueue the STOP command.
        
Main3OK
        ;; done recording -- Play the OK message.
        PAGE3                   ; select ROM page 3.
        movlw   CW_OK           ; get CW OK
        call    PlayCW          ; start playback
        PAGE0                   ; select ROM page 0.
        goto    ChkTmrs         ; seems redundant, but it ain't

Main4
        ;; receiver active with repeater disabled,
        ;; ID BEACON MODE enabled.
        ;; NO CW ID MODE enabled.
        ;; 1.12

        btfsc   rxFlag,RX0OPEN  ; is squelch open?
        goto    ChkTmrs         ; yes, still open.
        ;; COR has gone away.
        movlw   RXSOFF          ; COR on to off transition, get new state (off)
        movwf   rx0Stat         ; set new receiver state
        call    ChkID           ; test if need an ID now
        goto    ChkTmrs         ; done here.
        
ChkTmrs                         ; check timers here.
        goto    Ck10mS          ; skip one ms timer.
        ;; start with one-millisecond timers
        btfss   tFlags,ONEMS    ; is one-millisecond bit set?
        goto    Ck10mS          ; nope.
        ;; one-millisecond tick active.
        
Ck10mS                          ; check 10 millisecond timers
        btfss   tFlags,TENMS    ; is ten-millisecond bit set?
        goto    Ck100mS         ; nope.
        ;; ten millisecond tick active.
        movf    pulsTmr,f       ; check for pulsed output
        btfsc   STATUS,Z        ; is it zero?
        goto    PulsEnd         ; yep.
        decfsz  pulsTmr,f       ; decrement and check for zero.
        goto    PulsEnd         ; not zero yet.
        
        movf    group4,w        ; get digout pulse control.
        andlw   b'00000011'     ; mask leaves 2 digital output control bits.
        xorlw   h'ff'           ; invert.
        andwf   group5,f        ; update the port.
        PAGE2                   ; select page 2
        call    SetDig          ; set the digital outputs themselves
        PAGE0                   ; select code page 0.
PulsEnd                         ; done with IO output pulse logic

Ck100mS                         ; check 100 millisecond tick.
        btfss   tFlags,HUNDMS   ; is 100 millisecond bit set?
        goto    Ck1S            ; nope.
        ;; 100 millisecond tick active.
        ;; check hang timer.
        movf    hangTmr,f       ; check hang timer
        btfsc   STATUS,Z        ; is it zero?
        goto    NoHang          ; yes, not hang active, continue

        ;; 1.03 change here.
        ;; don't decrement hang timer if ID is running.
        movf    txFlag,w        ; get txFlag.
        andlw   b'10100000'     ; mask CWPLAY TALKING
        btfss   STATUS,Z        ; is result zero?
        goto    NoHang          ; no.  One of the sources is active.
        ;; end of 1.03 change

        movf    hangTmr,w       ; get hang timer
        subwf   hangDly,w       ; w = hangDly - hangTmr(w) (amount hang used)
        sublw   d'05'           ; subtract .5 seconds
        btfss   STATUS,Z        ; skip if result is 0
        goto    HangNob         ; not 0...don't beep.
        ;; check to see if there is something already playing
        movf    txFlag,w        ; get txFlag
        andlw   b'10110000'     ; and txFlag with (CW or ISD or DTMF)
        btfsc   STATUS,Z        ; is the result zero?
        goto    HangCT          ; yes, ok to play CT.
        bsf     flags,DEF_CT    ; set defer CT flag.
        goto    HangNob         ; don't beep now.
        
        ;;  bag the beep, CW, ISD or DTMF is playing.

        ;; select courtesy tone here.
HangCT
        incf    cTone,w         ; check cTone for FF
        btfsc   STATUS,Z        ; is result 0?
        goto    HangNob         ; yes, cTone was FF.
        btfss   group0,6        ; is courtesy tone enabled?
        goto    HangNob         ; courtesy tone disabled.
        movlw   CTUNLOK         ; get unlocked mode courtesy tone.
        btfsc   dtRFlag,DT0UNLK ; is this port (main receiver) unlocked?
        movwf   cTone           ; yep. set unlocked courtesy tone.

        PAGE3                   ; select code page 3.
        call    PlayCT          ; play courtesy tone #w
        PAGE0                   ; select code page 0.

HangNob                         ; hanging without a beep
        decfsz  hangTmr,f       ; decrement and check if now zero
        goto    NoHang          ; not zero
        ;; end of hang time. hang timer timed out.
        bcf     txFlag,TXHANG   ; turn off hang time flag
        ;; euro mode check
        btfss   group3,0        ; in European mode?
        goto    USMode          ; nope.
        ;; euro mode ID playing
        ;; 1.06 euro ID mode test...
        btfss   group3,1        ; Euro Mode Tail Drop Normal Speech ID set?
        call    DoIDCW          ; no.  Play CW ID.
        btfsc   group3,1        ; Euro Mode Tail Drop Normal Speech ID set?
        call    DoIDNor         ; yep.  Play speech ID.
        ;; end of 1.06 change
        goto    NoHang          ; end of euro mode change

USMode
        movf    txFlag,f        ; check tXflag for zero.
        btfss   STATUS,Z        ; is it zero?
        goto    NoHang          ; no.  txFlag is not zero

        ;; check tail message
        movf    tailCtr,f       ; check.
        btfsc   STATUS,Z        ; skip if tailCtr not zero.
        goto    NoHang          ; tailCtr is zero.
        decfsz  tailCtr,f       ; decrement tailCtr, skip if now zero.
        goto    NoHang          ; not zero
        ;; tail message time.
        call    DoTail          ; play tail message.
        
NoHang                          ; done with hang timer...
        ;; process DTMF muting timer...
        movf    muteTmr,f       ; test mute timer
        btfsc   STATUS,Z        ; Z is set if not DTMF muting
        goto    NoMutTm         ; muteTmr is zero.
        decfsz  muteTmr,f       ; decrement muteTmr
        goto    NoMutTm         ; have not reached the end of the mute time
        btfsc   txFlag,RX0OPEN  ; is receiver 0 unsquelched
        bcf     PORTA,RX0AUD    ; unmute it...

NoMutTm                         ; done with muting timer...
Ck1S                            ; check 1-second flag bit.
        btfss   tFlags,ONESEC   ; is one-second flag bit set?
        goto    Ck10S           ; nope.
        ;; 1-second tick active.
        movf    unlkTmr,f       ; check unlkTmr
        btfsc   STATUS,Z        ; is it zero?
        goto    NoULTmr         ; yes, don't worry about it.
        decfsz  unlkTmr,f       ; no, decrement it.
        goto    NoULTmr         ; still not zero.
        ;; unlkTmr counted down to zero, lock controller.
        movlw   b'00011111'     ; mask:  clear unlocked bits.
        andwf   dtRFlag,f       ; and with dtRFlag: clear unlocked bits.

NoULTmr                         ; unlocked timer is zero.
        
Ck10S                           ; check 10-second tick flag bit.
        btfss   tFlags,TENSEC   ; is ten-second flag bit set?
        goto    NoTimr          ; nope.  no more timers to test.
        movf    idTmr,f
        btfsc   STATUS,Z        ; is idTmr 0
        goto    NoIDTmr         ; yes...
        decfsz  idTmr,f         ; decrement ID timer
        goto    NoIDTmr         ; not zero yet...
        call    DoID            ; id timer decremented to zero, play the ID
NoIDTmr                         ; process more 10 second timers here...
        movf    fanTmr,f        ; check fan timer
        btfsc   STATUS,Z        ; is it zero?
        goto    NoFanTm         ; yes.
        btfss   group2,5        ; fan mode configured?
        goto    NoFanTm         ; no
        decfsz  fanTmr,f        ; decrement fan timer
        goto    NoFanTm         ; not zero yet
        bcf     PORTB,FANCTL    ; turn off fan
NoFanTm
        ;; 
        movf    dtATmr,f        ; check DTMF access timer.
        btfsc   STATUS,Z        ; is it zero?
        goto    NoDTATm         ; yes
        decfsz  dtATmr,f        ; decrement DTMF access timer
        goto    NoDTATm         ; not zero yet.
        ;;  
        
NoDTATm
		IFDEF NHRC3_1
        movf    alrmTmr,f       ; check alarm announce timer
        btfsc   STATUS,Z        ; is it zero?
        goto    NoAlTmr         ; yes.
        decfsz  alrmTmr,f       ; decrement the alarm announce timer.
        goto    NoAlTmr         ; still not zero
        movlw   VALARM          ; get alarm announce message.
        call    NewPlay         ; play the alarm message.

        ;; now, reset alarm announce timer
        movlw   EEALARM         ; get EEPROM address of alarm timer.
        movwf   eeAddr          ; set EEPROM address low byte.
        PAGE3                   ; select code page 3.
        call    ReadEEw         ; read EEPROM.
        PAGE0                   ; select code page 0.
        movwf   alrmTmr         ; preset tail message counter.
		ENDIF
NoAlTmr 
        
NoTimr                          ; no more timers to test.
        

ChkTx                           ; check if transmitter should be on
        movf    txFlag,f        ; check txFlag
        btfsc   STATUS,Z        ; skip if not zero
        goto    ChkTx0          ; it's zero, turn off transmitter
        btfsc   flags,TXONFLG   ; skip if not already on
        goto    ChkTxE          ; done here
        PAGE3                   ; select code page 1.
        call    PTTon           ; turn on transmitter (will set TXONFLG)
        PAGE0                   ; select code page 0.
        goto    ChkTxE          ; now done here.
        
ChkTx0
        btfss   flags,TXONFLG   ; skip if tx is on
        goto    ChkTxE          ; was already off
        PAGE3                   ; select code page 1.
        call    PTToff          ; turn off PTT
        PAGE0                   ; select code page 0.
ChkTxE                          ; end of ChkTx

; ***************
; ** CW SENDER ** 
; ***************
CWSendr
        btfss   txFlag,CWPLAY   ; sending CW?
        goto    NoCW            ; nope

        btfss   tFlags,ONEMS    ; is this a one-ms tick?
        goto    NoCW            ; nope.

        decfsz  cwTbTmr,f       ; decrement CW timebase counter
        goto    NoCW            ; not zero yet.

        movf    cwSpeed,w       ; get CW timebase preset.
        movwf   cwTbTmr         ; preset CW timebase.

        decfsz  cwTmr,f         ; decrement CW element timer
        goto    NoCW            ; not zero

        btfss   tFlags,CWBEEP   ; was "key" down? 
        goto    CWKeyUp         ; nope
                                ; key was down
        bcf     tFlags,CWBEEP   ; 
        ; turn off beep here.
        clrw                    ; clear W.
        PAGE3                   ; select code page 3.
        call    SetTone         ; set the beep tone up.
        PAGE0                   ; select code page 0.
        decf    cwByte,w        ; test CW byte to see if 1
        btfsc   STATUS,Z        ; was it 1 (Z set if cwByte == 1)
        goto    CWNext          ; it was 1...
        movlw   CWIESP          ; get cw inter-element space
        movwf   cwTmr           ; preset cw timer
        goto    NoCW            ; done with this pass...

CWNext                          ; get next character of message
        PAGE3                   ; select code page 1.
        call    GtBeep          ; get the next cw character
        PAGE0                   ; select code page 0.
        movwf   cwByte          ; store character bitmap
        btfsc   STATUS,Z        ; is this a space (zero)
        goto    CWWord          ; yes, it is 00
        incf    cwByte,w        ; check to see if it is FF
        btfsc   STATUS,Z        ; if this bitmap was FF then Z will be set
        goto    CWDone          ; yes, it is FF
        movlw   CWILSP          ; no, not 00 or FF, inter letter space
        movwf   cwTmr           ; preset cw timer
        goto    NoCW            ; done with this pass...

CWWord                          ; word space
        movlw   CWIWSP          ; get word space
        movwf   cwTmr           ; preset cw timer
        goto    NoCW            ; done with this pass...

CWKeyUp                         ; key was up, key again...
        incf    cwByte,w        ; is cwByte == ff?
        btfsc   STATUS,Z        ; Z is set if cwByte == ff
        goto    CWDone          ; got EOM

        movf    cwByte,f        ; check for zero/word space
        btfss   STATUS,Z        ; is it zero
        goto    CWTest          ; no...
        goto    CWNext          ; is 00, word space...

CWTest
        movlw   CWDIT           ; get dit length
        btfsc   cwByte,0        ; check low bit
        movlw   CWDAH           ; get DAH length
        movwf   cwTmr           ; preset cw timer
        bsf     tFlags,CWBEEP   ; turn key->down
        movf    cwTone,w        ; get CW tone
        ;; turn on beep here.
        PAGE3                   ; select code page 3.
        call    SetTone         ; set the beep tone up.
        PAGE0                   ; select code page 0.
        rrf     cwByte,f        ; rotate cw bitmap
        bcf     cwByte,7        ; clear the MSB
        goto    NoCW            ; done with this pass...

CWDone                          ; done sending CW
        bcf     txFlag,CWPLAY   ; turn off CW flag
        btfss   flags,IDNOW     ; was this an ID message?
        goto    CWDone1         ; no
        bcf     flags,needID    ; don't need to ID now.
        bcf     flags,IDNOW     ; not sending ID any more, either.
        bcf     flags,DEF_ID    ; clear deferred ID flag
        
CWDone1
        clrf    beepCtl         ; clear beep control flags

NoCW
CasEnd
CkTone
        btfss   tFlags,HUNDMS   ; check the DTMF timers every 100 msec.
        goto    TonDone         ; not 100 MS tick.
CkDt0   
        movf    dt0Tmr,f        ; check for zero...
        btfsc   STATUS,Z        ; is it zero
        goto    TonDone         ; yes
        decfsz  dt0Tmr,f        ; decrement timer
        goto    TonDone         ; not zero yet
        bsf     dtRFlag,DT0RDY  ; ready to evaluate command.
TonDone
        ;; manage beep timer 
        btfss   tFlags,TENMS    ; is this a 10 ms tick?
        goto    NoTime          ; nope.
        movf    beepTmr,f       ; check beep timer
        btfsc   STATUS,Z        ; is it zero?
        goto    NBeep           ; yes.
        ;goto    NoTime         ; yes.
BeepTic                         ; a valid beep tick.
        decfsz  beepTmr,f       ; decrement beepTmr
        goto    NoTime          ; not zero yet.
        PAGE3                   ; select code page 3.
        call    GetBeep         ; get the next beep tone...
        PAGE0                   ; select code page 0.
        goto    NoTime          ; done here.
NBeep                           ; verify that beeping is really over. HACK.
        movf    cwTmr,f         ; check cwTmr.
        btfss   STATUS,Z        ; is it zero?
        goto    NoTime          ; no.
        movf    beepCtl,f       ; check this.
        btfsc   STATUS,Z        ; is it zero?
        goto    NoTime          ; yes.
        PAGE3                   ; select code page 3.
        call    GetBeep         ; get the next beep tone...
        PAGE0                   ; select code page 0.

NoTime
        movf    tFlags,f        ; evaluate tFlags
        btfss   STATUS,Z        ; skip if ZERO
        goto    LoopEnd
        ;; no timing flags were set...
        ;; likely some excess, available CPU cycles here.
        ;; evaluate DTMF buffers...
PfxDT0
        ;; evaluate DTMF 0 buffer for command
        btfsc   dtRFlag,DTSEVAL ; is a command being interpreted now?
        goto    DTEval          ; yes, don't look at the DTMF buffers right now
        btfss   dtRFlag,DT0RDY  ; is a command ready to evaluate?
        goto    XPfxDT          ; no command waiting.
        ;; copy command from dtmf rx buf to command interpreter input buffer.
        movlw   low dt0buf0     ; get address of this dtmf receiver's buffer
        movwf   FSR             ; store.
        movf    dt0Ptr,w        ; get command size...
        movwf   cmdSize         ; save it.
        call    CpyDTMF         ; copy the command...
        movf    dt0Ptr,w        ; get command size back, CpyDTMF clobbers.
        movwf   cmdSize         ; save it.
        clrf    dt0Ptr          ; make ready to receive again.
        clrf    dtEFlag         ; start evaluating from first prefix.
        bsf     dtEFlag,DT0CMD  ; command from DTMF-0.
        bsf     dtRFlag,DTSEVAL ; set evaluate DTMF bit.
        btfsc   dtRFlag,DT0UNLK ; port 0 unlocked?
        bsf     dtRFlag,DTUL    ; this port is unlocked.
        bcf     dtRFlag,DT0RDY  ; reset DTMF ready bit.
        goto    DTEval          ; go and evaluate the command right now.

XPfxDT
        goto    LoopEnd
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
